Violabitch5/Nathophone_elec/joyned_xmos_xe216-main/README.md

This is a hardware reference design for a fully compliant Milan endpoint. It converts from a AVB/Milan network to I2S or TDM and vice versa.
Please feel free to copy and modify for your individual needs. This hardware reference design is published under the Creative Commons License. For software licensing visit www.joyned.at
