Violabitch5/Nathophone_elec/USBtoI2S_board/T-I4W1069446A-1units-BOM_nathophone_USBtoI2S_compatkicad9.kicad_pcb(2026-07-01).xls

PCBWay Bom Quotation, Product No.:T-I4W1069446A
Item # | *Designator | *Qty | Manufacturer | *Mfg Part # | Description / Value | Vendor Part # | *Package/Footprint | Mounting Type | *Unit Price(1 unit) | *Total | *Delivery Time | *PCBWay Note | Customer Reply | PCBWay Update
1 | C1, C10, C11, C12, C13, C18, C19, C2, C20, C21, C22, C23, C24, C25, C26, C27, C28, C29, C3, C30, C31, C32, C33, C35, C36, C41, C5, C8, C9 | 29 |  | GRMJN65C1H104JE01D | 100n『 』Unpolarized capacitor, small symbol『 』C0G/NP0『 』50V | 490-GRMJN65C1H104JE01DCT-ND | CAPC1810X65N | smt | $0.433 | $12.557 | 7-10 Workdays
2 | C14 | 1 |  | C0603C220J5GACTU | 22p『 』Unpolarized capacitor, small symbol『 』C0G/NP0『 』50V | 399-C0603C220J5GACTUCT-ND | C_0603_1608Metric_Pad1.08x0.95mm_HandSolder | smt | $0.662 | $0.662
3 | C15, C16 | 2 |  | CL32B226MOJNNNE | 22u『 』Unpolarized capacitor, small symbol『 』X7R『 』16V | 1276-3395-1-ND | C_1210_3225Metric_Pad1.33x2.70mm_HandSolder | smt | $2.033 | $4.066
4 | C17, C42, C43 | 3 |  | C3225X7R1N106K250AC | 10u『 』Unpolarized capacitor, small symbol『 』X7R『 』75V『 』SMD_2terminal_chip_molded | 445-C3225X7R1N106K250ACCT-ND | C_1210_3225Metric_Pad1.33x2.70mm_HandSolder | smt | $3.728 | $11.184
5 | C34 | 1 |  | C1608X7R2A105K080AC | 1u『 』Unpolarized capacitor, small symbol『 』X7R『 』100V | 445-C1608X7R2A105K080ACCT-ND | C_0603_1608Metric | smt | $2.426 | $2.426
6 | C37, C38, C39, C4 | 4 |  | GRM2195C1H103JA01D | 10n『 』Unpolarized capacitor, small symbol『 』C0G/NP0『 』50V | 490-1642-1-ND | C_0805_2012Metric_Pad1.18x1.45mm_HandSolder | smt | $0.479 | $1.916
7 | C40 | 1 |  | C2012X7R1C225K125AB | 2.2u『 』Unpolarized capacitor, small symbol『 』X7R『 』16V | 445-1420-1-ND | C_0805_2012Metric_Pad1.18x1.45mm_HandSolder | smt | $1.544 | $1.544
8 | C6, C7 | 2 |  | C0603C180C5GACTU | 18p『 』Unpolarized capacitor, small symbol『 』C0G/NP0『 』50V | 399-C0603C180C5GACTUCT-ND | C_0603_1608Metric | smt | $4.821 | $9.642 | 7-10 Workdays
9 | CR1 | 1 | onsemi(安森美) | NUP4114UCLW1T2G | NUP4114UCLW1T2G | NUP4114UCLW1T2GOSCT-ND | SOT-363_SC-70-6 | smt | $1.871 | $1.871 | 7-10 Workdays
10 | D1 | 1 |  | DF2B6M4BSL,L3F | 5.6V『 』Bidirectional transient-voltage-suppression diode, small symbol | 264-DF2B6M4BSL,L3FCT-ND | SOD-962_SL2_TOS | smt | $1.187 | $1.187 | 7-10 Workdays
11 | D2 | 1 |  | XZMDKVG55W-8 | XZMDKVG55W-8『 』Dual LED, cathodes on pins 2 and 4 | 1497-1183-1-ND | LED_XZMDKVG55W-8 | smt | $1.187 | $1.187
12 | FB1 | 1 |  | HZ0805E601R-10 | 600R @ 100MHz『 』Ferrite bead, small symbol『 』0.5A | 240-2399-1-ND | C_0805_2012Metric_Pad1.18x1.45mm_HandSolder | smt | $1.437 | $1.437
13 | J1 | 1 | Same Sky | UJ20-C-H-G-SMT-5-P16-TR | UJ20-C-H-G-SMT-5-P16-TR『 』3.41mm『 』AMINA | 2223-UJ20-C-H-G-SMT-5-P16-TRCT-ND | SAMESKY_UJ20-C-H-G-SMT-5-P16-TR | smt | $1.780 | $1.780 | 7-10 Workdays
14 | J2 | 1 |  | FTSH-110-01-F-DV-K | FTSH-110-01-F-DV-K『 』Generic connector, double row, 02x10, odd/even pin numbering scheme (row 1 odd numbers, row 2 even numbers), script generated (kicad-library-utils/schlib/autogen/connector/) | SAM8802-ND | CON20_2X10_DUK_FTSH_SAI-M | smt | $3.876 | $3.876 | 7-10 Workdays
15 | J3 | 1 |  | 0525593072 | Conn_01x30『 』Generic connector, single row, 01x30, script generated (kicad-library-utils/schlib/autogen/connector/) | 900-0525593072TR-ND | CON_525593072_MOL | smt | $4.642 | $4.642 | 7-10 Workdays
16 | J4 | 1 |  | FTSH-105-01-F-DV-P-TR | FTSH-105-01-F-DV-P-TR『 』Generic connector, double row, 02x05, odd/even pin numbering scheme (row 1 odd numbers, row 2 even numbers), script generated (kicad-library-utils/schlib/autogen/connector/) | SAM13161CT-ND | PinHeader_2x05_P1.27mm_Vertical_SMD | smt | $1.771 | $1.771
17 | L1 | 1 |  | B82432T1222K000 | 2.2uH『 』Inductor with ferrite core, small symbol『 』1A | 495-1757-1-ND | IND_EPCOS_B82432T_EPC | smt | $1.240 | $1.240
18 | L2 | 1 |  | B82432T1332K000 | 3.3uH『 』Inductor with ferrite core, small symbol『 』0.9A | 495-1760-1-ND | IND_EPCOS_B82432T_EPC | smt | $1.595 | $1.595 | 7-10 Workdays
19 | Q1 | 1 | ANBON SEMICONDUCTOR (INT'L) LIMITED | MMBT3904 | MMBT3904『 』0.2A Ic, 40V Vce, Small Signal NPN Transistor, SOT-23 | 4530-MMBT3904CT-ND | SOT-23 | smt | $0.314 | $0.314 | 7-10 Workdays
20 | R1, R2 | 2 |  | RNCF0805DTE5K10 | 5.1k『 』Resistor, small symbol『 』0.5% | 738-RNCF0805DTE5K10CT-ND | R_0805_2012Metric_Pad1.20x1.40mm_HandSolder | smt | $0.578 | $1.156
21 | R10 | 1 |  | RC0603DR-071ML | 1M『 』Resistor, small symbol『 』0.5% | 13-RC0603DR-071MLCT-ND | R_0603_1608Metric | smt | $0.441 | $0.441
22 | R11, R9 | 2 |  | RNCF0805DTE4K70 | 4k7『 』Resistor, small symbol『 』0.5% | 738-RNCF0805DTE4K70CT-ND | R_0805_2012Metric_Pad1.20x1.40mm_HandSolder | smt | $0.578 | $1.156
23 | R12, R13, R14, R15, R16, R17 | 6 |  | RC0805FR-0733RL | 33R『 』Resistor, small symbol『 』1% | 311-33.0CRCT-ND | R_0805_2012Metric_Pad1.20x1.40mm_HandSolder | smt | $0.064 | $0.384
24 | R18, R20, R22, R23, R4, R5 | 6 |  | RNCF0805DTE100K | 100k『 』Resistor, small symbol『 』0.5% | 738-RNCF0805DTE100KCT-ND | R_0805_2012Metric_Pad1.20x1.40mm_HandSolder | smt | $0.228 | $1.368
25 | R19, R21 | 2 |  | RNCF0805DTE200K | 200k『 』Resistor, small symbol『 』0.5% | 738-RNCF0805DTE200KCT-ND | R_0805_2012Metric_Pad1.20x1.40mm_HandSolder | smt | $0.578 | $1.156
26 | R24, R25, R26, R3, R7 | 5 |  | RNCF0805DTE10K0 | 10k『 』Resistor, small symbol『 』0.5% | RNCF0805DTE10K0CT-ND | R_0805_2012Metric_Pad1.20x1.40mm_HandSolder | smt | $0.263 | $1.315
27 | R27 | 1 |  | CRCW0805750RFKEA | 750R『 』Resistor, small symbol『 』1% | 541-750CCT-ND | R_0805_2012Metric_Pad1.20x1.40mm_HandSolder | smt | $0.970 | $0.970
28 | R28 | 1 |  | CRCW0805680RFKEA | 680R『 』Resistor, small symbol『 』1% | 541-680CCT-ND | R_0805_2012Metric_Pad1.20x1.40mm_HandSolder | smt | $0.970 | $0.970
29 | R6 | 1 |  | RNCF0805DTE47K0 | 47k『 』Resistor, small symbol『 』0.5% | 738-RNCF0805DTE47K0CT-ND | R_0805_2012Metric_Pad1.20x1.40mm_HandSolder | smt | $1.103 | $1.103
30 | R8 | 1 |  | RT0603DRD07680RL | 680R『 』Resistor, small symbol『 』0.5% | 311-680DCT-ND | R_0603_1608Metric | smt | $1.103 | $1.103
31 | SW1 | 1 |  | PEC09-2320F-S0015 | PEC09-2320F-S0015『 』Rotary encoder, dual channel, incremental quadrate outputs, with switch | PEC09-2320F-S0015-ND | RotaryEncoder_Bourns_Horizontal_PEC09-2xxxF-Sxxxx | tht | $6.190 | $6.190 | 7-10 Workdays
32 | TP1, TP13, TP14, TP15, TP16, TP17, TP18, TP19, TP2, TP20, TP3, TP5, TP6, TP8 | 14 |  |  | TestPoint_Small『 』test point |  | TestPoint_Pad_D1.5mm | tht |  |  |  | [DNP
33 | U1 | 1 |  | IS25LP032D-JKLE-TR | IS25LP032D-JKLE『 』32-Mbit, 2.3 to 3.6V, SPI Flash Memory, SOIC-8 | 706-IS25LP032D-JKLE-TRCT-ND | WSON-8-1EP_6x5mm_P1.27mm_EP3.4x4mm | smt | $2.986 | $2.986 | 7-10 Workdays
34 | U2 | 1 | XMOS | XU316-1024-TQ128-C24 | XU316-1024-TQ128-C24『 』1.2mm『 』ASHISH『 』XU316-1024-TQ128-C24 | 880-XU316-1024-TQ128-C24-ND | QFP40P1600X1600X120-129N | smt | $21.240 | $21.240 | 7-10 Workdays
35 | U3 | 1 |  | TPS62410DRCR | TPS62410DRCR | 296-25488-1-ND | TPS62410DRCR | smt | $2.335 | $2.335
36 | U4 | 1 |  | MAX809STRG | MAX809STRG | MAX809STRGOSCT-ND | SOT-23 | smt | $0.647 | $0.647
37 | U5 | 1 |  | 74LVC2G07GW,125 | 74LVC2G07『 』Dual Buffer, Open Drain, Low-Voltage CMOS | 1727-4121-1-ND | SOT-363_SC-70-6 | smt | $1.000 | $1.000
38 | U6 | 1 | Diodes Inc. | AP7361C-FGE-7 | AP7361C-FGE-7『 』0.63 mm | AP7361C-FGE-7DICT-ND | SON65P300X300X63-9N | smt | $2.302 | $2.302
39 | Y1 | 1 |  | FA-238 24.0000MB-C3 | FA-238 24MHz『 』Four pin crystal, GND on pins 2 and 4, small symbol | SER3689CT-ND | Crystal_SMD_3225-4Pin_3.2x2.5mm | smt | $3.281 | $3.281 | 7-10 Workdays
 |  |  |  |  |  |  |  |  | Component Cost | $116.00
 |  |  |  |  |  |  |  |  | Assembly Cost | $29.00
 |  |  |  |  |  |  |  |  | PCB Cost | $55.93
 |  |  |  |  |  |  |  |  | V0 Member 0% off | $0.00
 |  |  |  |  |  |  |  |  | All Total 1 Units | $200.93
