Violabitch5/Nathophone_elec/joyned_xmos_xe216-main/xmos_avb_brd_V4.step

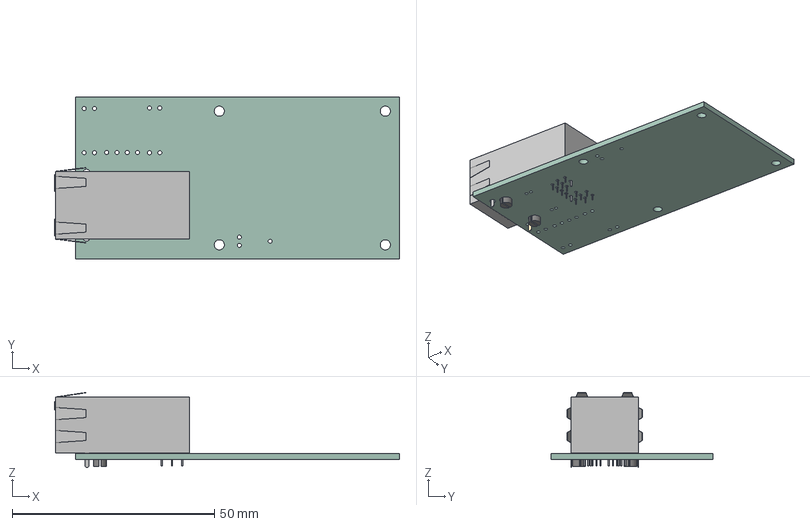
[picture p1: CAD file, 2025-10-16]
joyned_xmos_xe216-main/xmos_avb_brd_V4.step
85.2 x 40.0 x 18.5 mm
RJ45_Pulse_JK0654219NL_Horizontal
xmos_avb_brd_V4_PCB
