Violabitch5/Nathophone_elec/pcb/symbols_footprints/TE_1-1571986-1-a-3d.stp

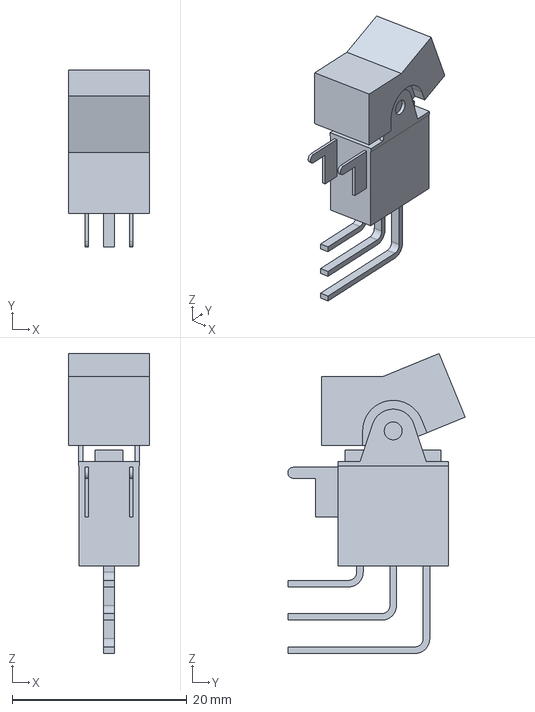
[picture p2: CAD file, 2025-10-16]
pcb/symbols_footprints/TE_1-1571986-1-a-3d.stp
9.27 x 20.3 x 34.4 mm
