Violabitch5/Nathophone_elec/USBtoI2S_board/nathophone_USBtoI2S/USBtoI22_Module_v1.step

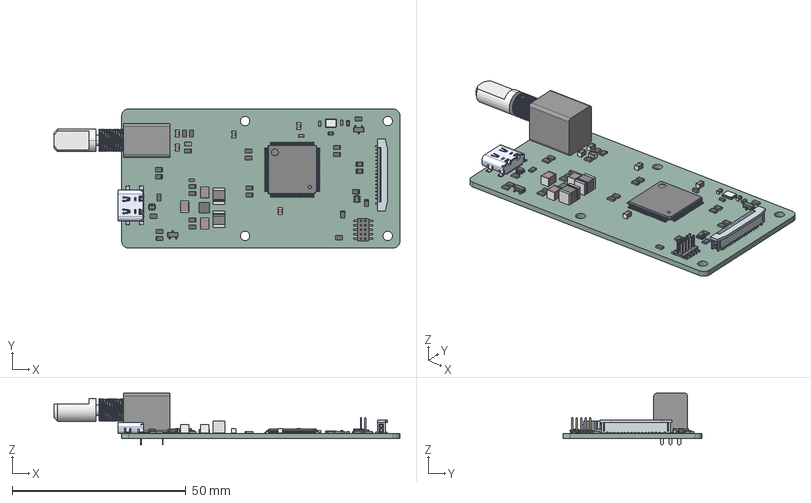
[picture p3: CAD file, 2026-10-13]
USBtoI2S_board/nathophone_USBtoI2S/USBtoI22_Module_v1.step
99.4 x 40.0 x 14.9 mm
C_0805_2012Metric x 6
R_0805_2012Metric x 26
C_0603_1608Metric x 4
UJ20-C-H-G-SMT-5-P16-TR
SOT-23 x 2
PinHeader_2x05_P1.27mm_Vertical_SMD
C_1210_3225Metric x 3
SOT-363_SC-70-6 x 2
IND_EPCOS_B82432T_EPC x 2
Crystal_SMD_3225-4Pin_3.2x2.5mm
PEC09-2320F-S0015
BODY-SON
R_0603_1608Metric x 2
XU316-1024-TQ128-C24
nathophone_USBtoI2S_PCB
