Violabitch5/Nathophone_elec/USBtoI2S_board/parts/SOT89-5_DIO.step

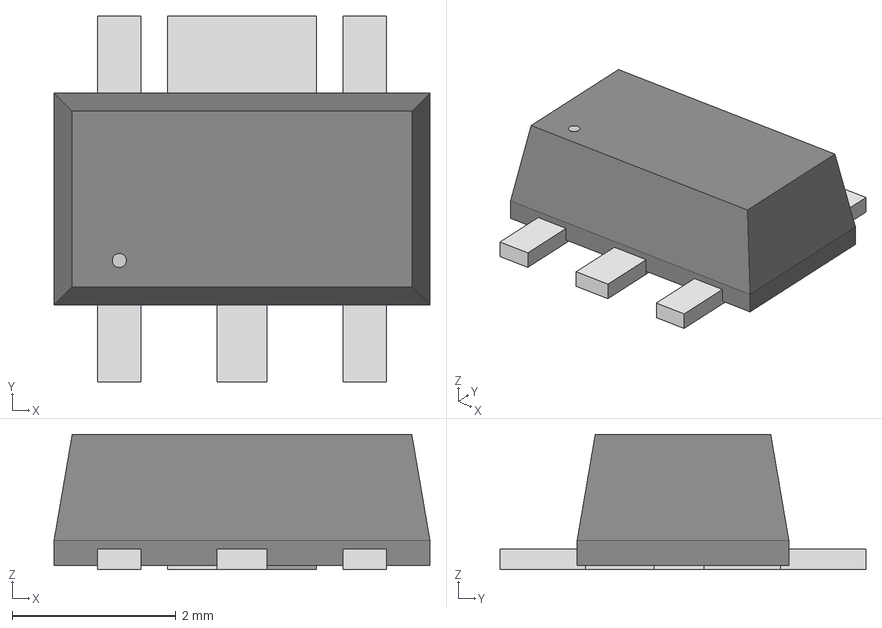
[picture p4: CAD file, 2026-10-13]
USBtoI2S_board/parts/SOT89-5_DIO.step
4.60 x 4.47 x 1.65 mm
