Violabitch5/Nathophone_elec/pcb/symbols_footprints/SRU1048-150Y.STEP

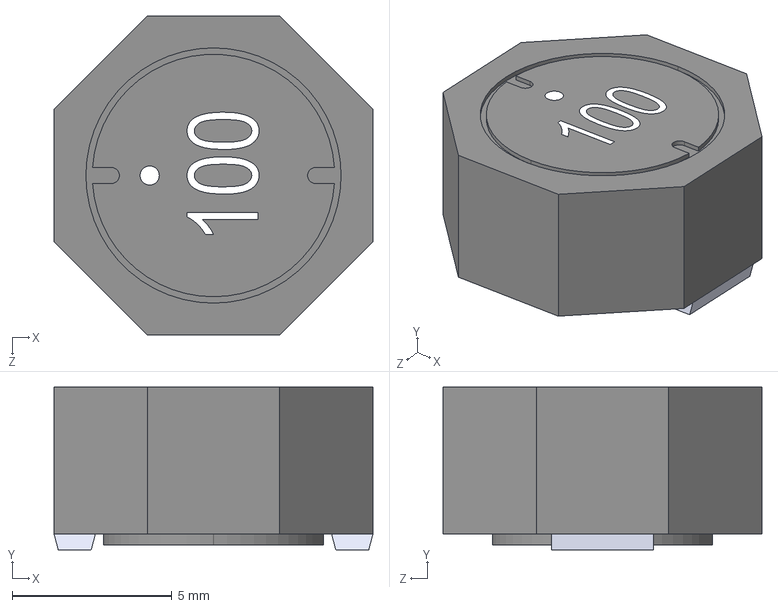
[picture p5: CAD file, 2025-10-16]
pcb/symbols_footprints/SRU1048-150Y.STEP
10.0 x 5.10 x 10.0 mm
