Violabitch5/Nathophone_elec/USBtoI2S_board/parts/ftsh-110-01-f-dv-k.stp

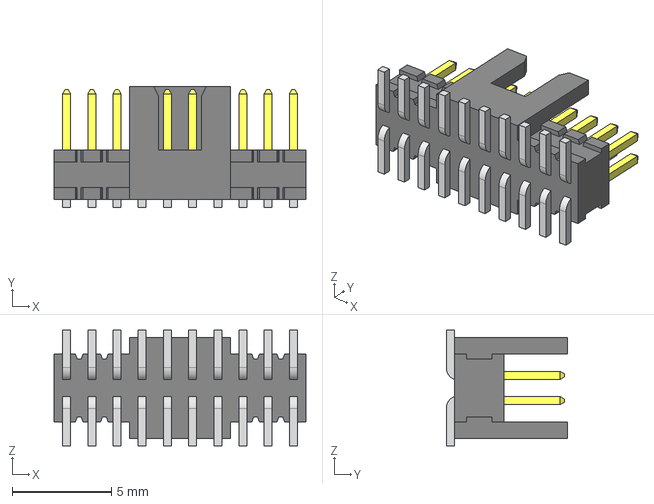
[picture p6: CAD file, 2026-10-13]
USBtoI2S_board/parts/ftsh-110-01-f-dv-k.stp
12.7 x 6.12 x 5.84 mm
