Violabitch5/Nathophone_elec/pcb/symbols_footprints/WE-HCI_1050_744325+%28rev1%29.stp

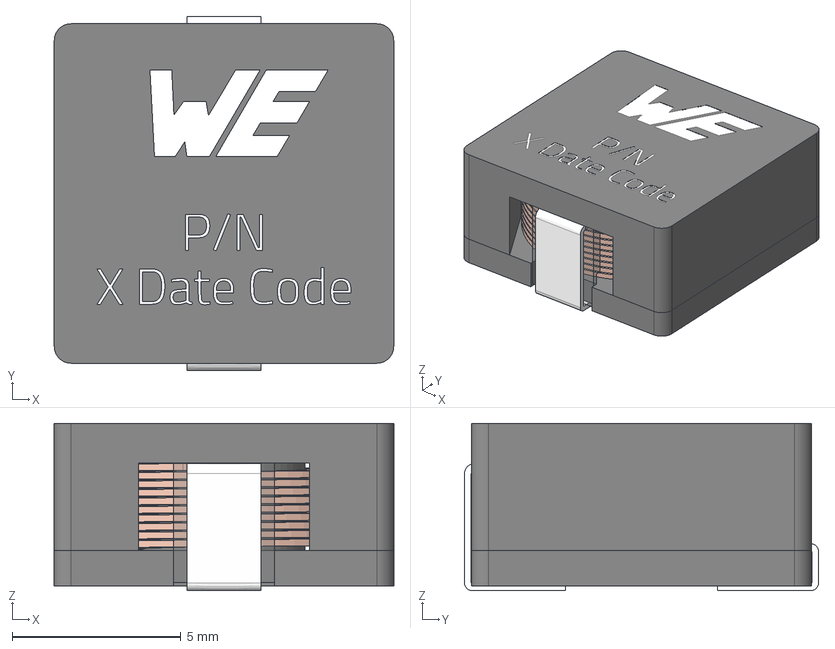
[picture p7: CAD file, 2025-10-16]
pcb/symbols_footprints/WE-HCI_1050_744325+%28rev1%29.stp
10.1 x 10.5 x 4.96 mm
Gehäuse
Spule
Boden
Klebemasse x 2
