Violabitch5/Nathophone_elec/USBtoI2S_board/parts/XZxxxx55W-8.step

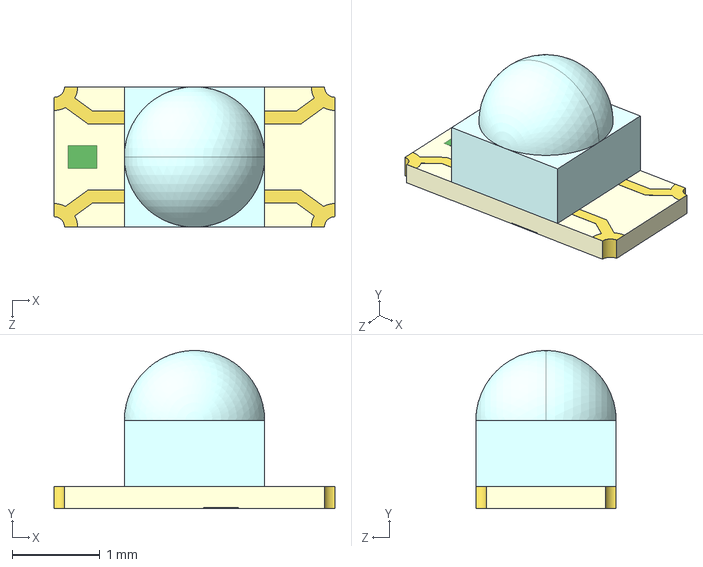
[picture p8: CAD file, 2026-05-14]
USBtoI2S_board/parts/XZxxxx55W-8.step
3.20 x 1.80 x 1.60 mm
