Violabitch5/Nathophone_elec/pcb/symbols_footprints/WE-LQS-4025.stp

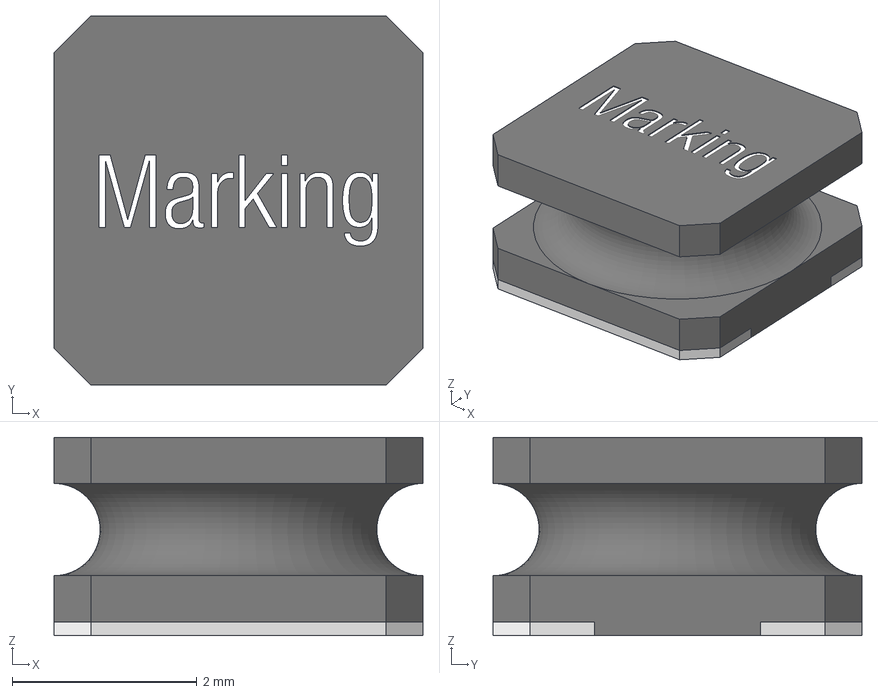
[picture p9: CAD file, 2025-10-16]
pcb/symbols_footprints/WE-LQS-4025.stp
4.00 x 4.00 x 2.15 mm
Core
Contact x 2
Glue
