Violabitch5/Nathophone_elec/pcb/symbols_footprints/DS04-254-2-01BK-SMT.STEP

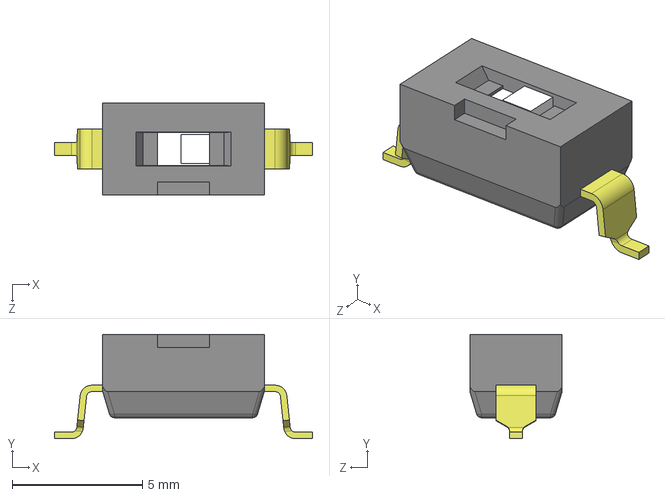
[picture p10: CAD file, 2025-10-16]
pcb/symbols_footprints/DS04-254-2-01BK-SMT.STEP
9.90 x 4.00 x 3.54 mm
