Violabitch5/Nathophone_elec/pcb/symbols_footprints/PTS645SM43SMTR92 LFS.STEP

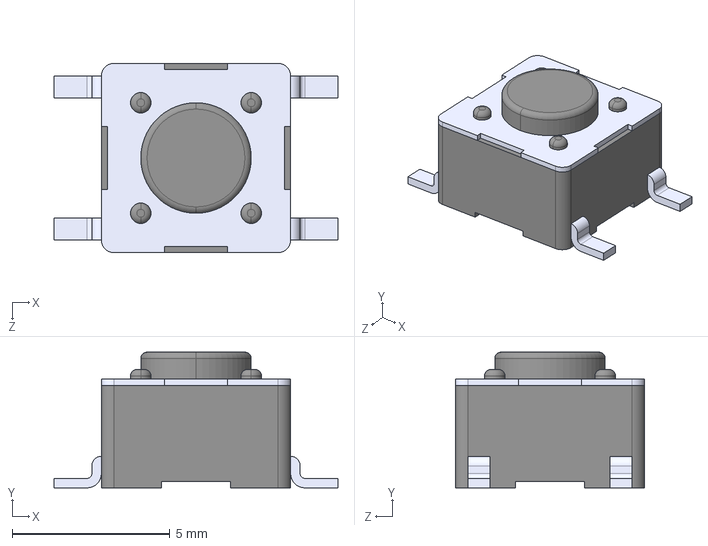
[picture p11: CAD file, 2025-10-16]
pcb/symbols_footprints/PTS645SM43SMTR92 LFS.STEP
9.00 x 4.30 x 6.00 mm
