Violabitch5/Nathophone_elec/USBtoI2S_board/parts/PEC09-2320F-S0015.stp

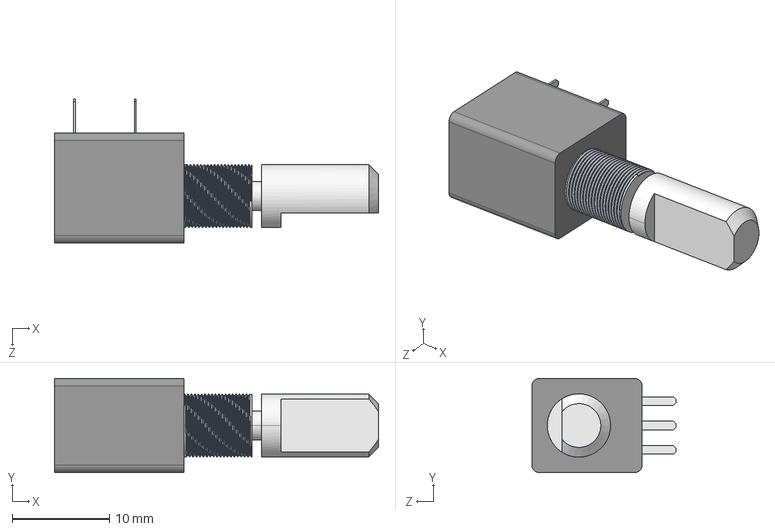
[picture p12: CAD file, 2026-05-14]
USBtoI2S_board/parts/PEC09-2320F-S0015.stp
33.3 x 9.70 x 14.9 mm
