Violabitch5/Nathophone_elec/pcb/symbols_footprints/VQFN32_RSM0032B.stp

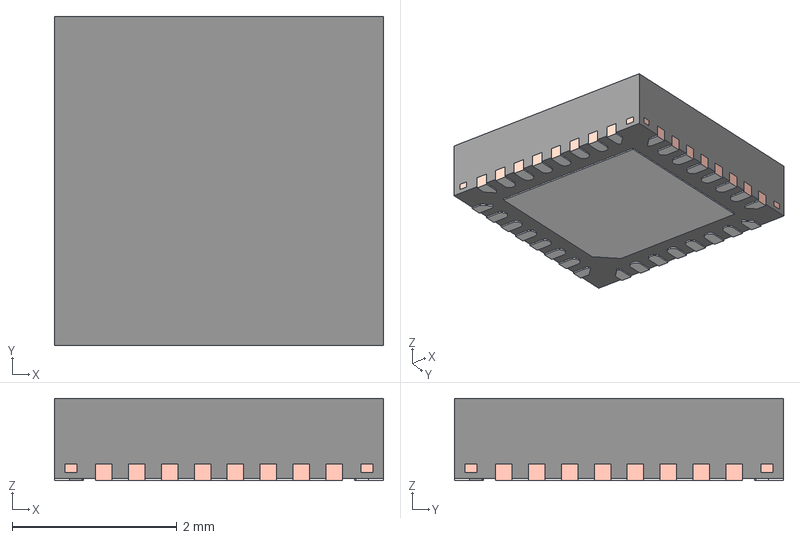
[picture p13: CAD file, 2025-10-12]
pcb/symbols_footprints/VQFN32_RSM0032B.stp
4.00 x 4.00 x 1.00 mm
BODY-QFN
FRAME-RSM0032B
PIN1-ID
