Violabitch5/Nathophone_elec/USBtoI2S_board/parts/IND_EPCOS_B82432T_EPC.step

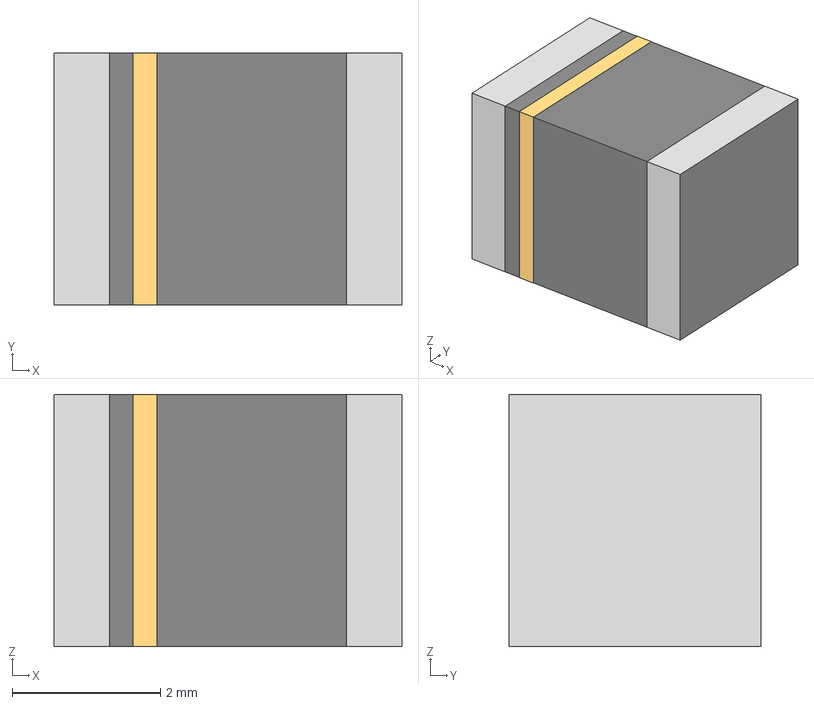
[picture p14: CAD file, 2026-05-14]
USBtoI2S_board/parts/IND_EPCOS_B82432T_EPC.step
4.70 x 3.41 x 3.41 mm
