Violabitch5/Nathophone_elec/USBtoI2S_board/parts/CON20_2X10_DUK_FTSH_SAI.step

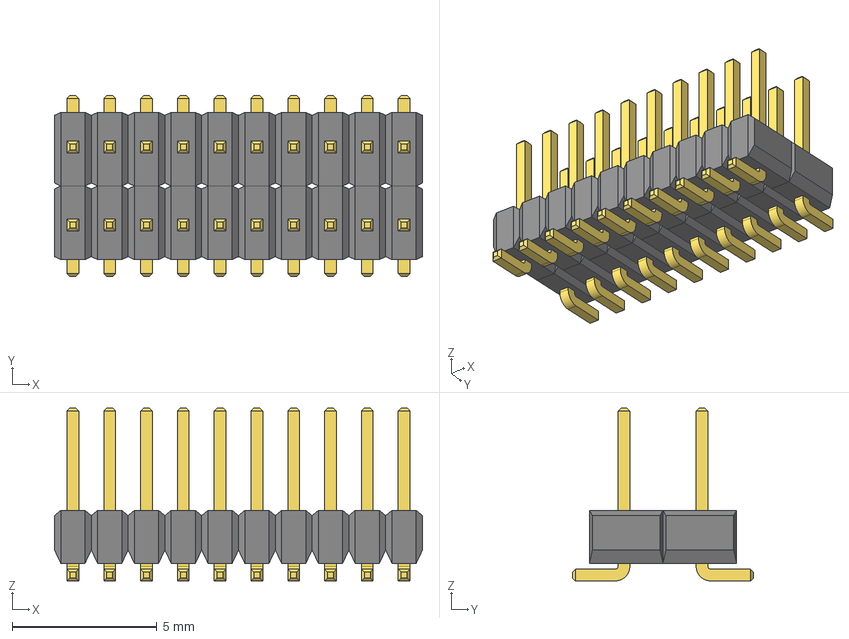
[picture p15: CAD file, 2026-05-07]
USBtoI2S_board/parts/CON20_2X10_DUK_FTSH_SAI.step
12.7 x 6.25 x 5.97 mm
