Violabitch5/Nathophone_elec/pcb/symbols_footprints/TLA2024IRUGR.step

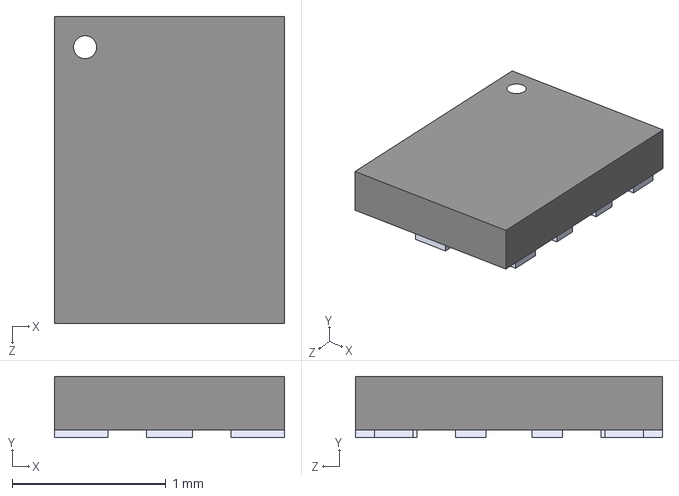
[picture p16: CAD file, 2025-10-12]
pcb/symbols_footprints/TLA2024IRUGR.step
1.50 x 0.4 x 2.00 mm
