Violabitch5/Nathophone_elec/USBtoI2S_board/parts/UJ20-C-H-G-SMT-5-P16-TR.step

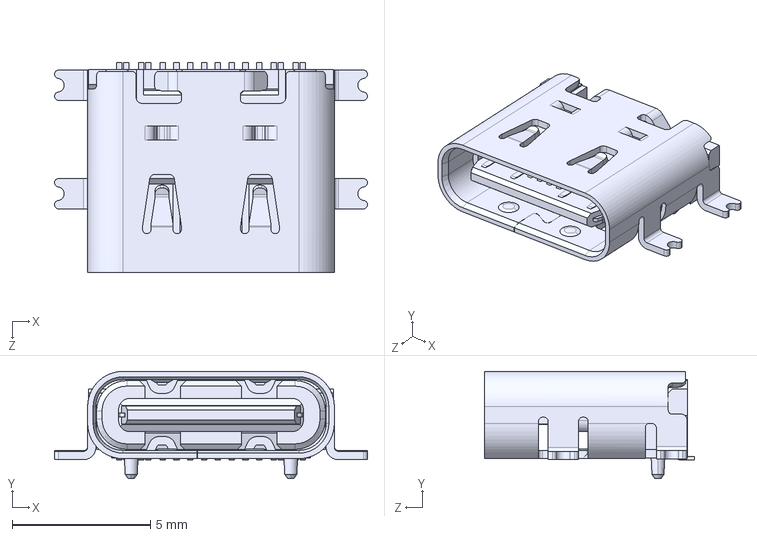
[picture p17: CAD file, 2026-05-07]
USBtoI2S_board/parts/UJ20-C-H-G-SMT-5-P16-TR.step
11.3 x 3.89 x 7.60 mm
