Violabitch5/Nathophone_elec/pcb/symbols_footprints/PJ-063AH.step

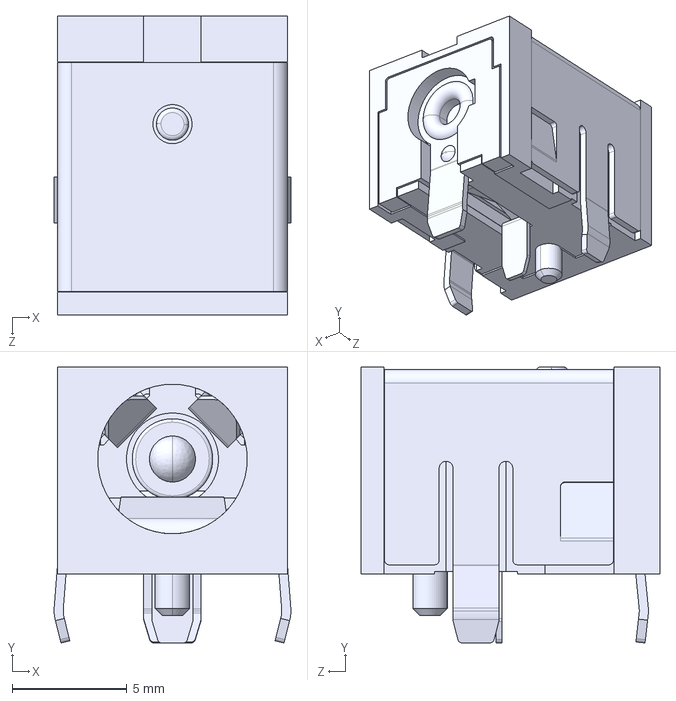
[picture p18: CAD file, 2025-10-12]
pcb/symbols_footprints/PJ-063AH.step
10.3 x 12.0 x 13.0 mm
