Violabitch5/Nathophone_elec/USBtoI2S_board/parts/GRMJN65C1H104JE01D.step

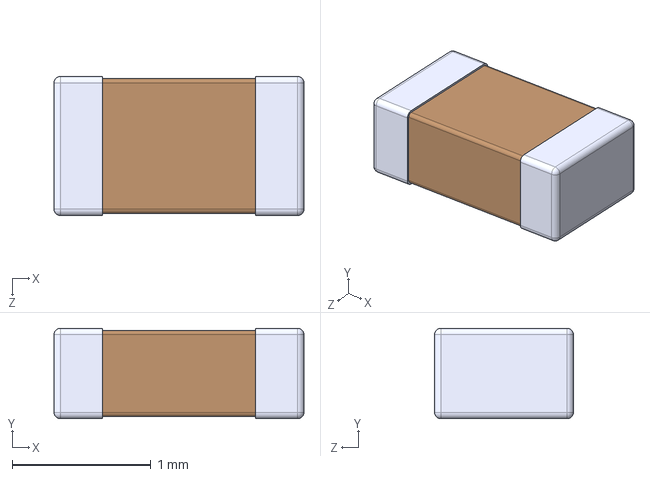
[picture p19: CAD file, 2026-05-07]
USBtoI2S_board/parts/GRMJN65C1H104JE01D.step
1.80 x 0.65 x 1 mm
