Violabitch5/Nathophone_elec/pcb/symbols_footprints/WE-LQS-8065.stp

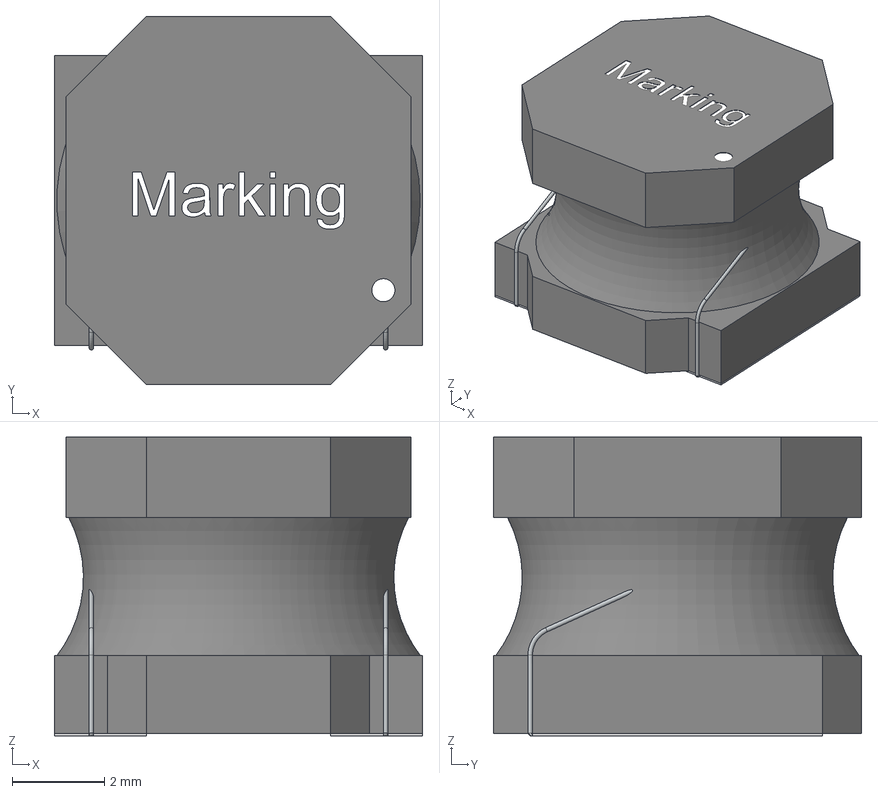
[picture p20: CAD file, 2025-10-12]
pcb/symbols_footprints/WE-LQS-8065.stp
8.00 x 8.00 x 6.50 mm
Housing
Glue
Contact x 2
Wire x 2
