Violabitch5/Nathophone_elec/(list of files, cad)

Other CAD files:
USBtoI2S_board/parts/525593072.stp
USBtoI2S_board/parts/TPS62410DRCR.stp
USBtoI2S_board/parts/TPS65261RHBR.stp
pcb/symbols_footprints/1862042.stp
