Violabitch5/Nathophone_elec/measurements/supplies5p3V_3p3V_startup_PG.png

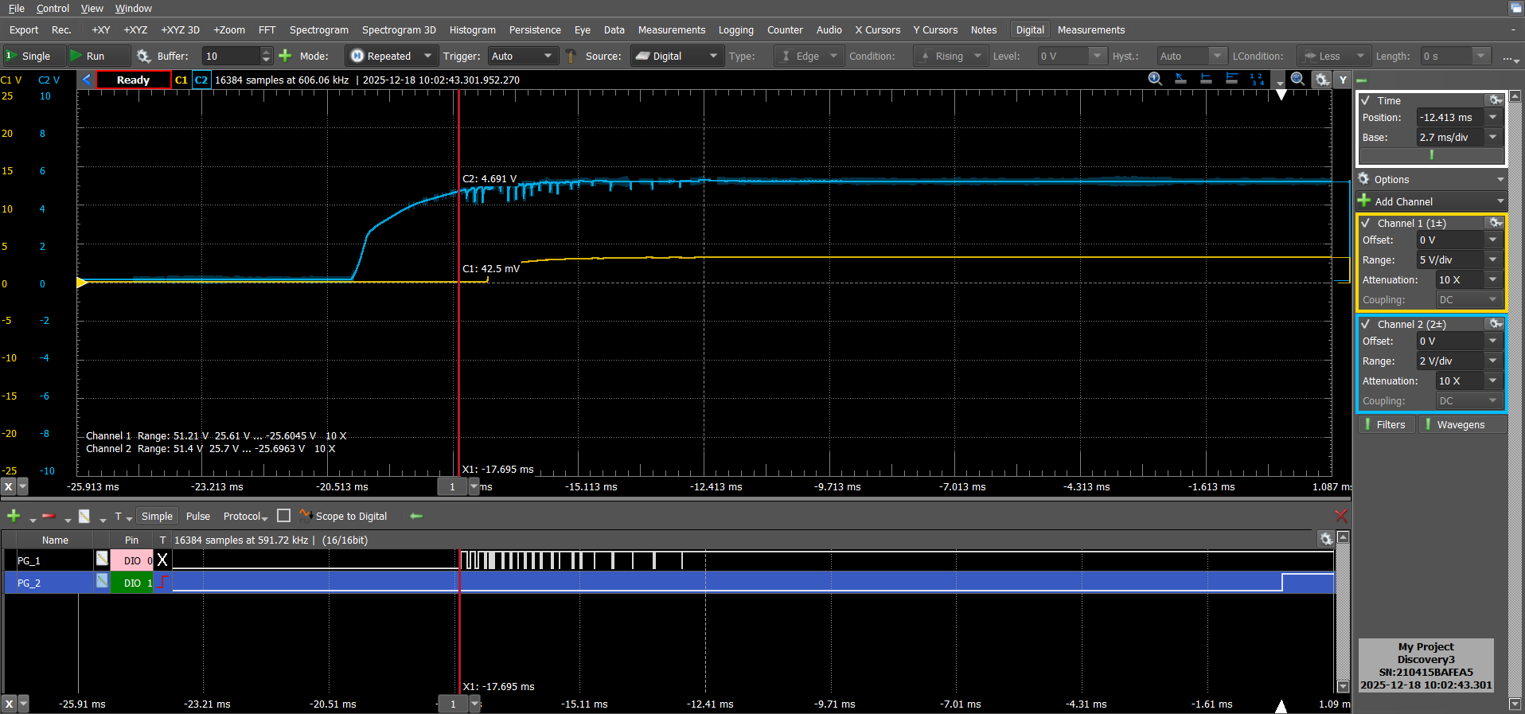
measurements/supplies5p3V_3p3V_startup_PG.png
