Violabitch5/Nathophone_elec/measurements/supplies24V_5p3V_startup_PG_Labornetzteil.png

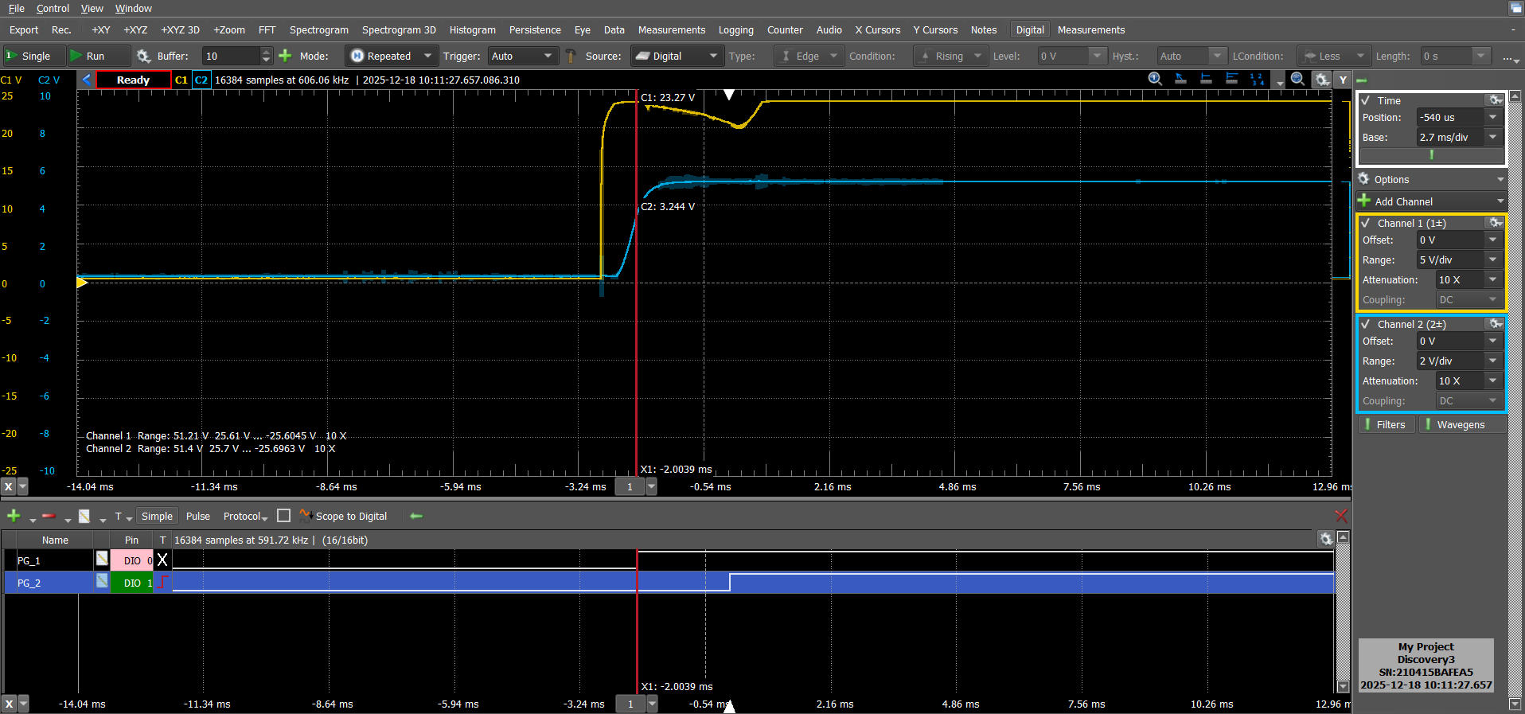
measurements/supplies24V_5p3V_startup_PG_Labornetzteil.png
