Violabitch5/Nathophone_elec/measurements/supplies_startup_PG.png

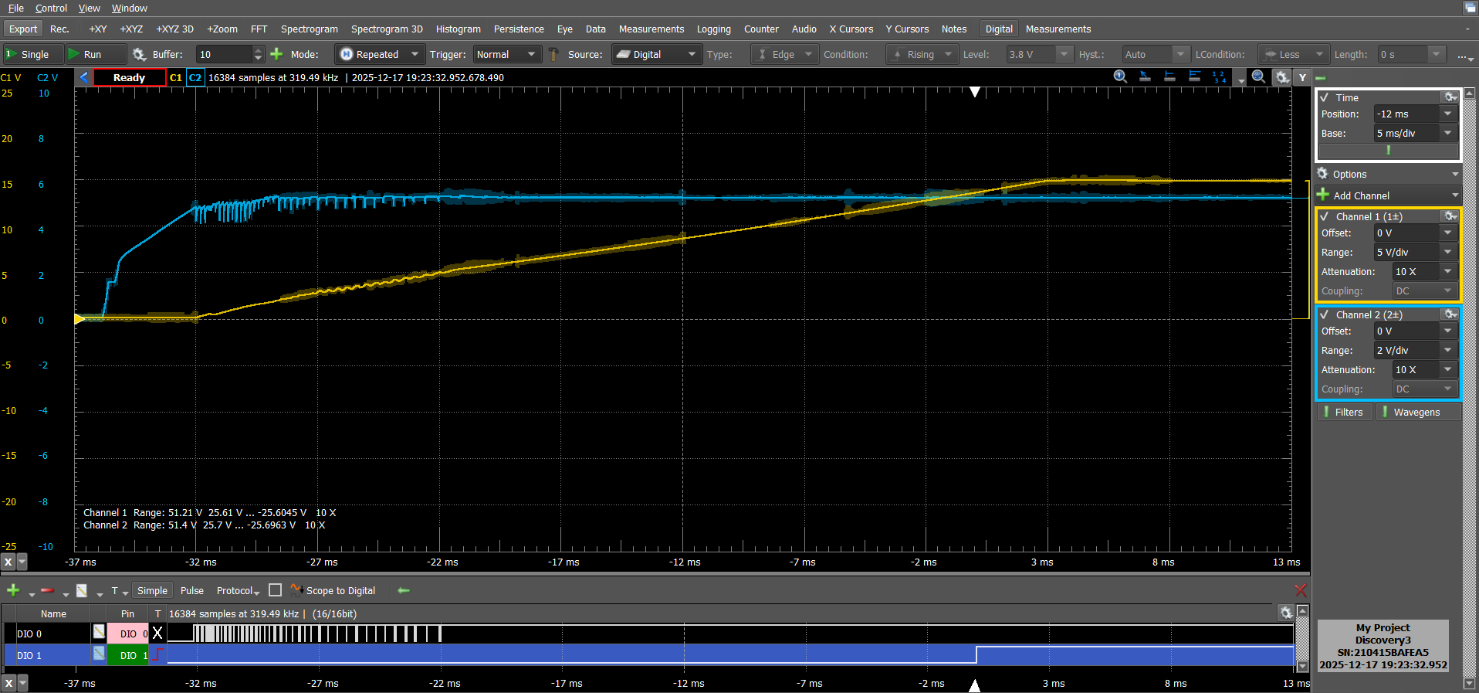
measurements/supplies_startup_PG.png
