Violabitch5/Nathophone_elec/pcb/Nathophone_driver_board_SCHEMATIC.pdf

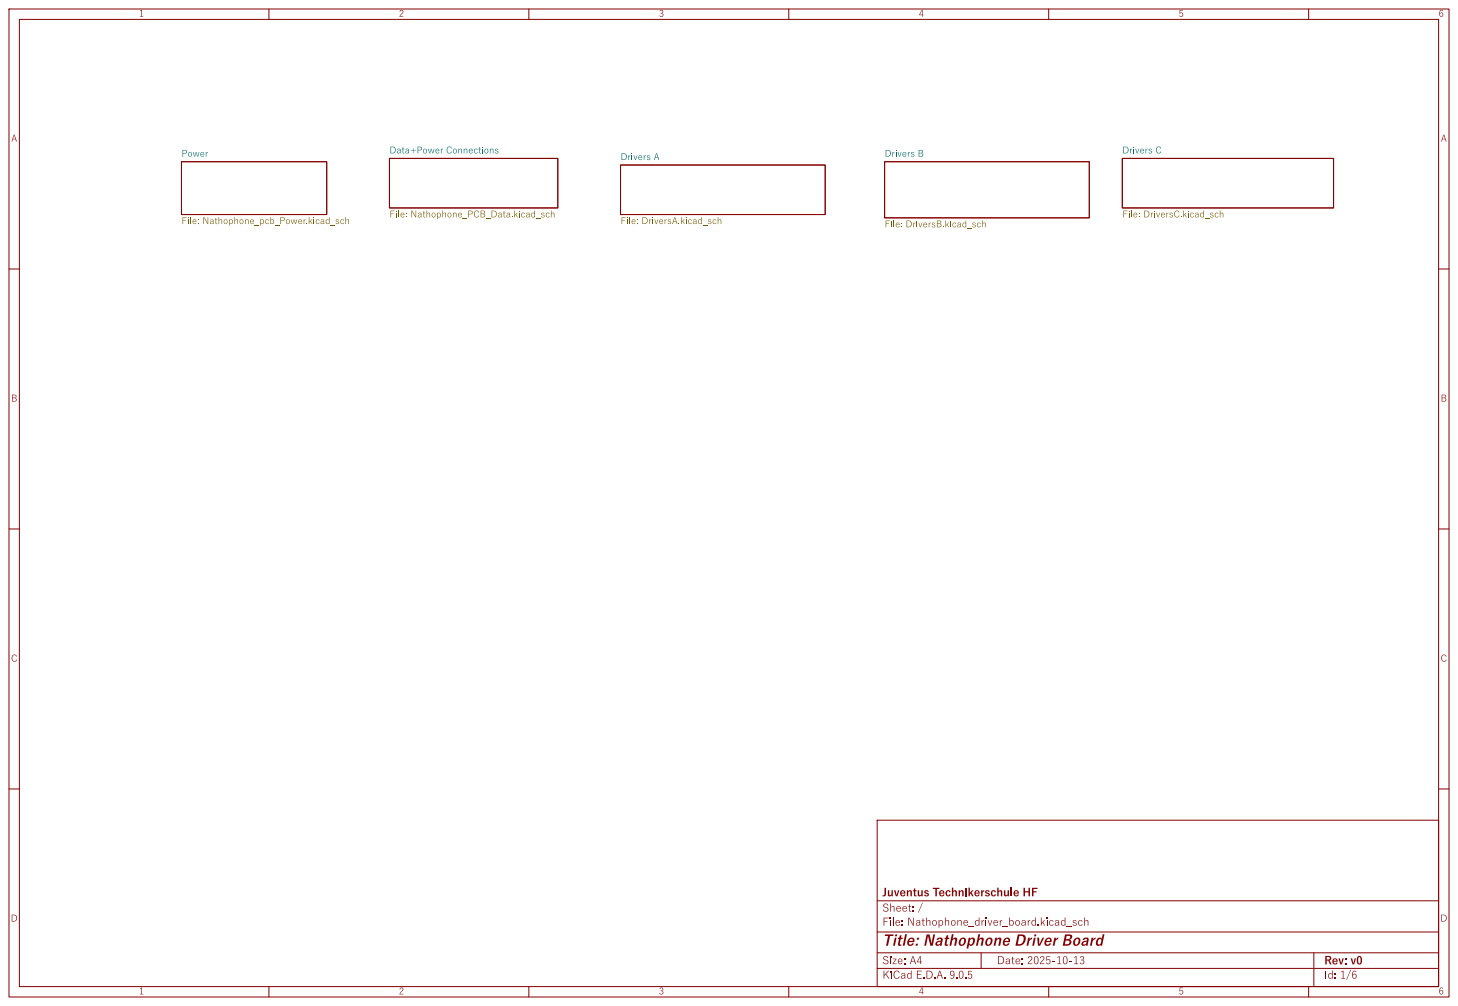
[picture p24: page 1]

File: Nathophone_driver_board.kicad_sch Sheet: / Juventus Technikerschule HF

Id: 1/6 Title: Nathophone Driver Board

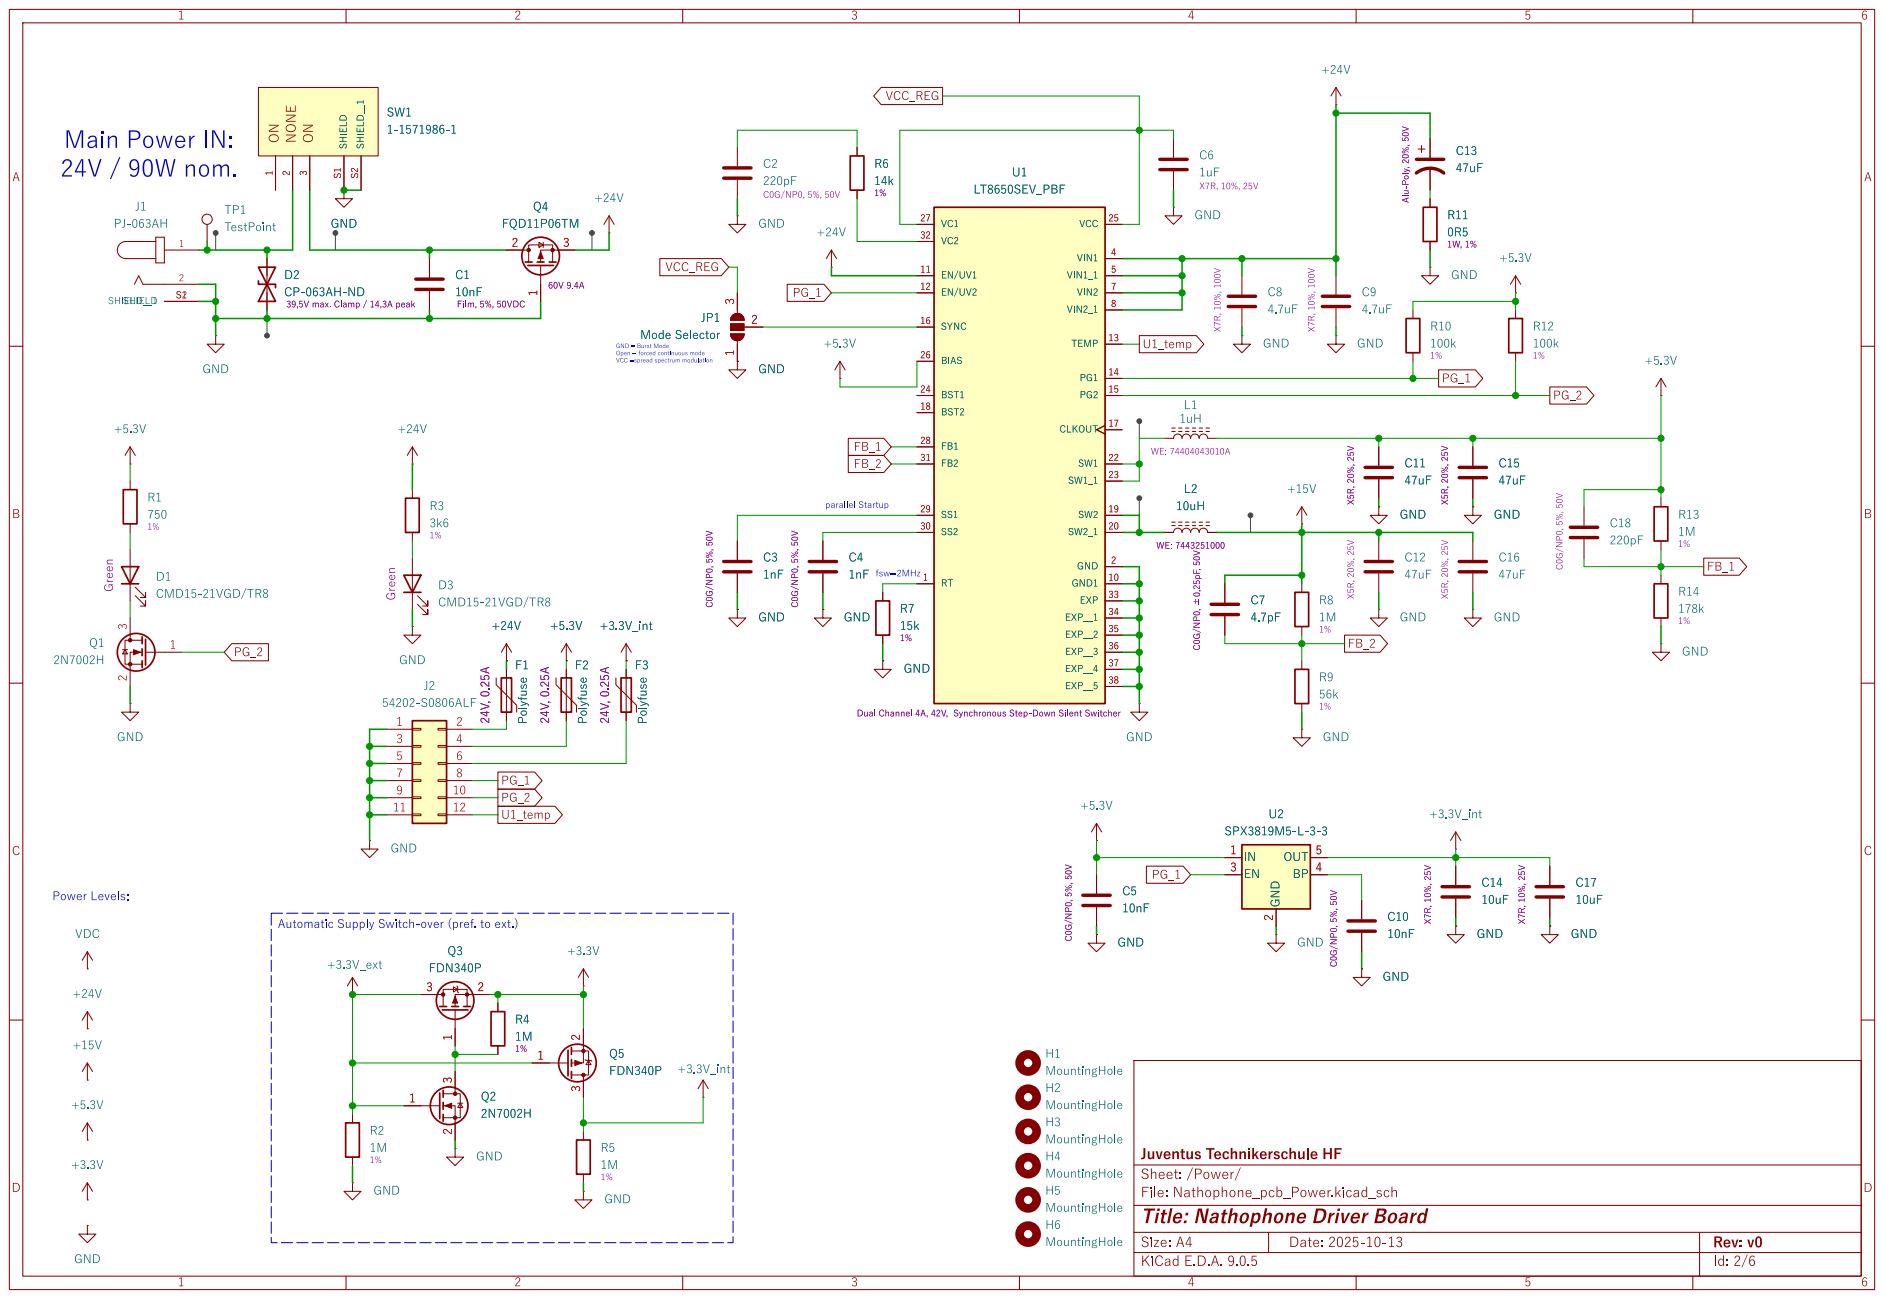
[picture p25: page 2]

fsw=2MHz parallel Startup Main Power IN:
24V / 90W nom.

39,5V max. Clamp / 14,3A peak D1 CMD15-21VGD/TR8 Green

Dual Channel 4A, 42V, Synchronous Step-Down Silent Switcher GND

Dual Channel 4A, 42V, Synchronous Step-Down Silent Switcher

H1 MountingHole H2 MountingHole H3 MountingHole H6 MountingHole H5 MountingHole H4 MountingHole

Id: 2/6 Title: Nathophone Driver Board

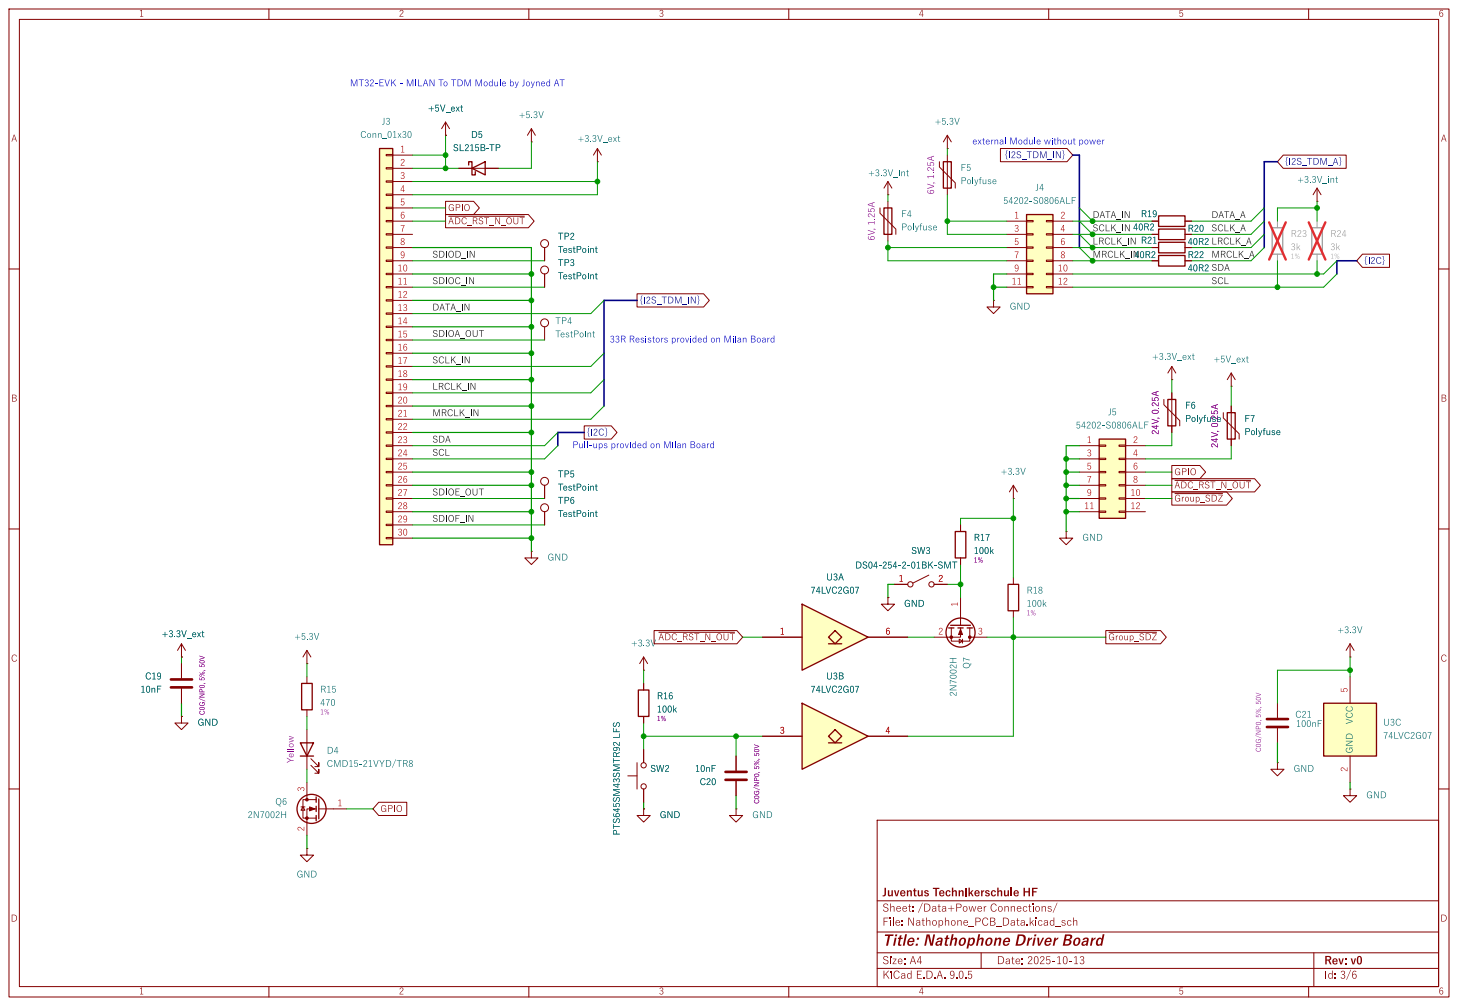
[picture p26: page 3]

external Module without power MT32-EVK - MILAN To TDM Module by Joyned AT

33R Resistors provided on Milan Board +5V_ext D5 SL215B-TP

File: Nathophone_PCB_Data.kicad_sch Sheet: /Data+Power Connections/ Juventus Technikerschule HF

Id: 3/6 Title: Nathophone Driver Board

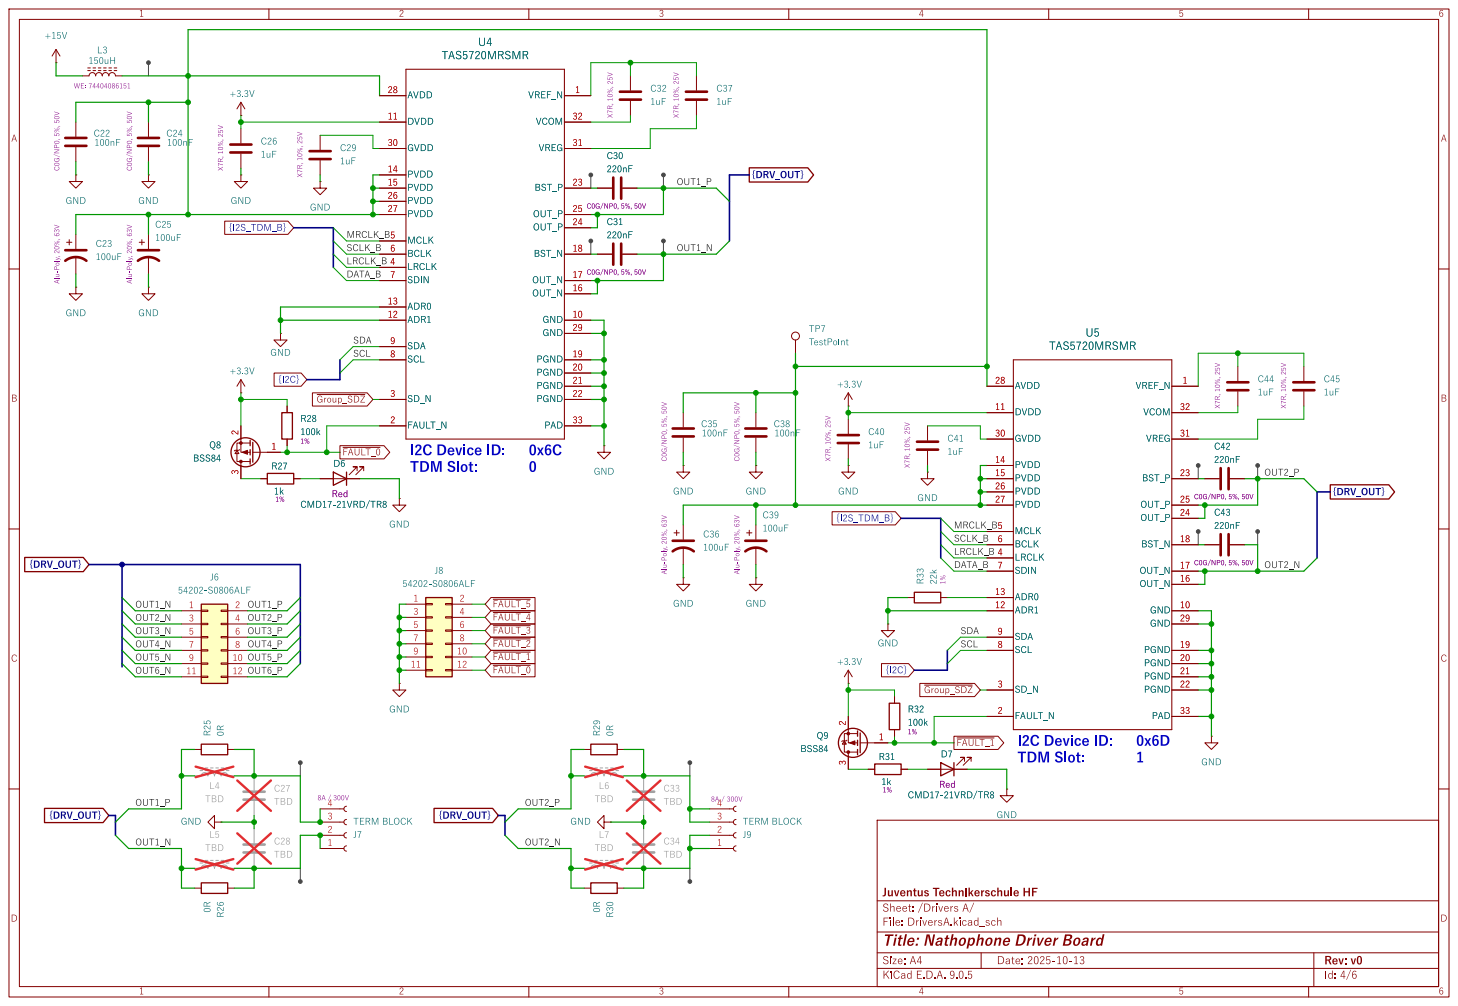
[picture p27: page 4]

AVDD 28 DVDD 11 GVDD 30 PVDD 14 PVDD 15 PVDD 26 PVDD 27 MCLK 5 BCLK 6

File: DriversA.kicad_sch Sheet: /Drivers A/ Juventus Technikerschule HF

Id: 4/6 Title: Nathophone Driver Board

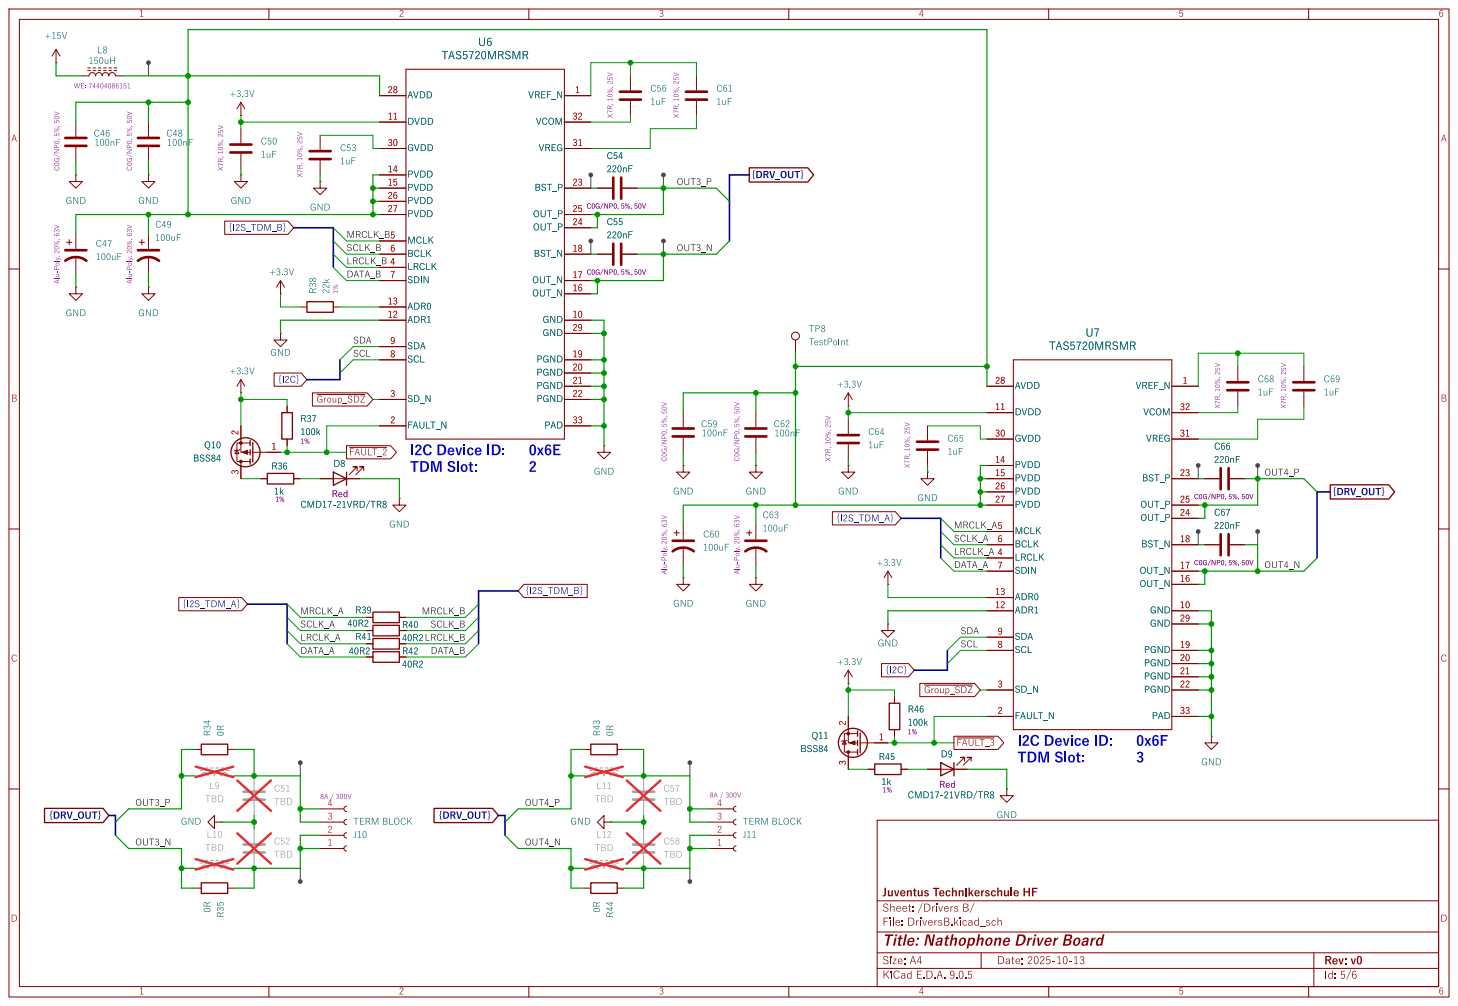
[picture p28: page 5]
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

Id: 5/6 Title: Nathophone Driver Board

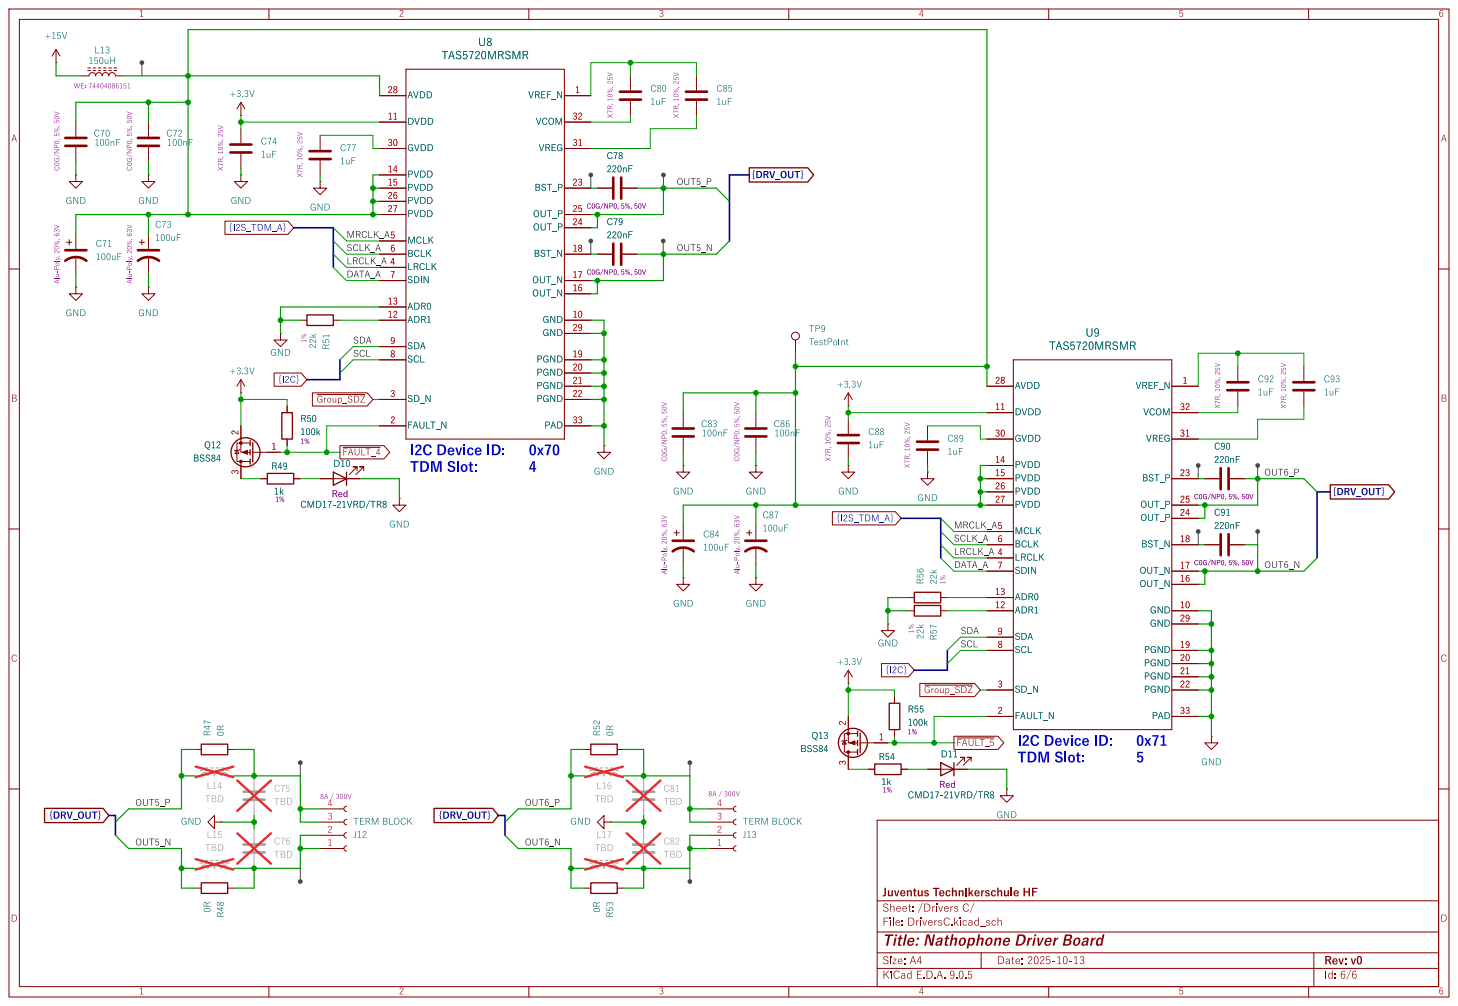
[picture p29: page 6]
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

Id: 6/6 Title: Nathophone Driver Board
