Violabitch5/Nathophone_elec/simulations/test.pdf

## 0uH Induktivität Kapazität-Sweep von 0uF bis 400uF

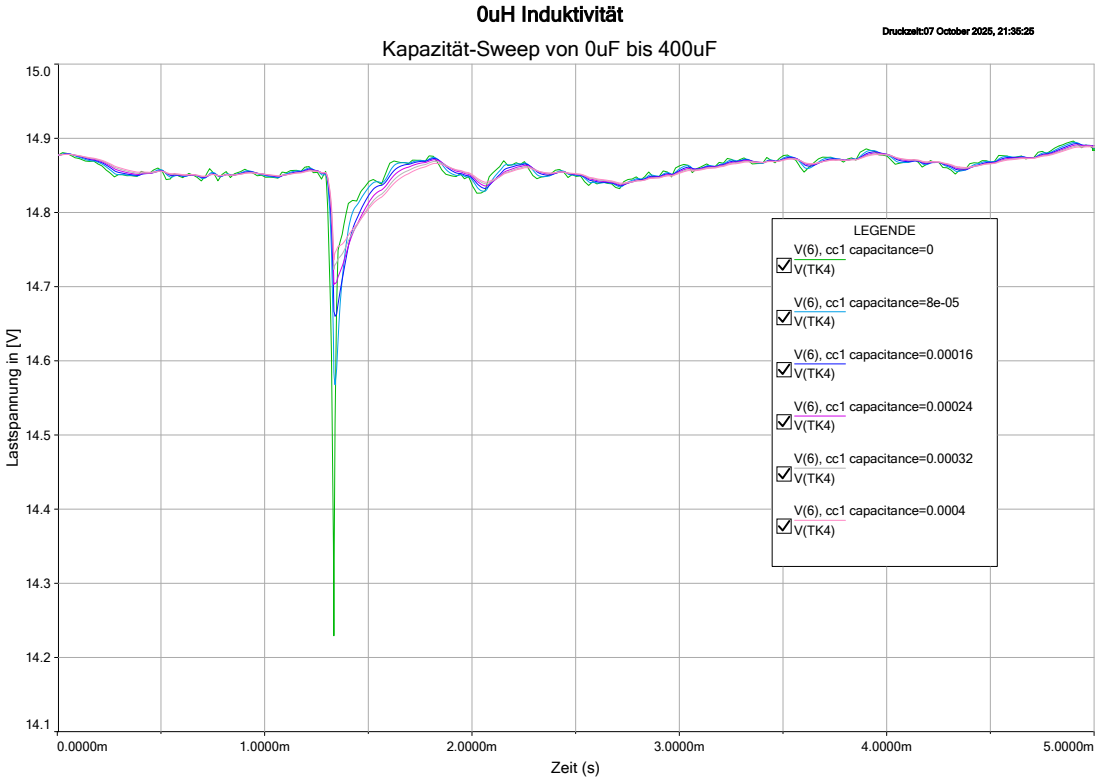
[picture p30: page 1]
Druckzeit:07 October 2025, 21:35:25; Zeit (s)

LEGENDE V(6), cc1 capacitance=0 V(TK4)

V(6), cc1 capacitance=8e-05 V(TK4) V(6), cc1 capacitance=0.00016

0.0000m | 1.0000m | 2.0000m | 3.0000m | 4.0000m V(6), cc1 capacitance=0.00032 V(TK4) V(6), cc1 capacitance=0.0004 | 5.0000m Lastspannung in [V]

V(TK4) V(6), cc1 capacitance=0.00024 V(TK4)
