Violabitch5/Nathophone_elec/USBtoI2S_board/XK-AUDIO-316-MC-AB-Design-Files/XK-AUDIO-316-MC-AB-SCHEMATIC-1V1-A.PDF

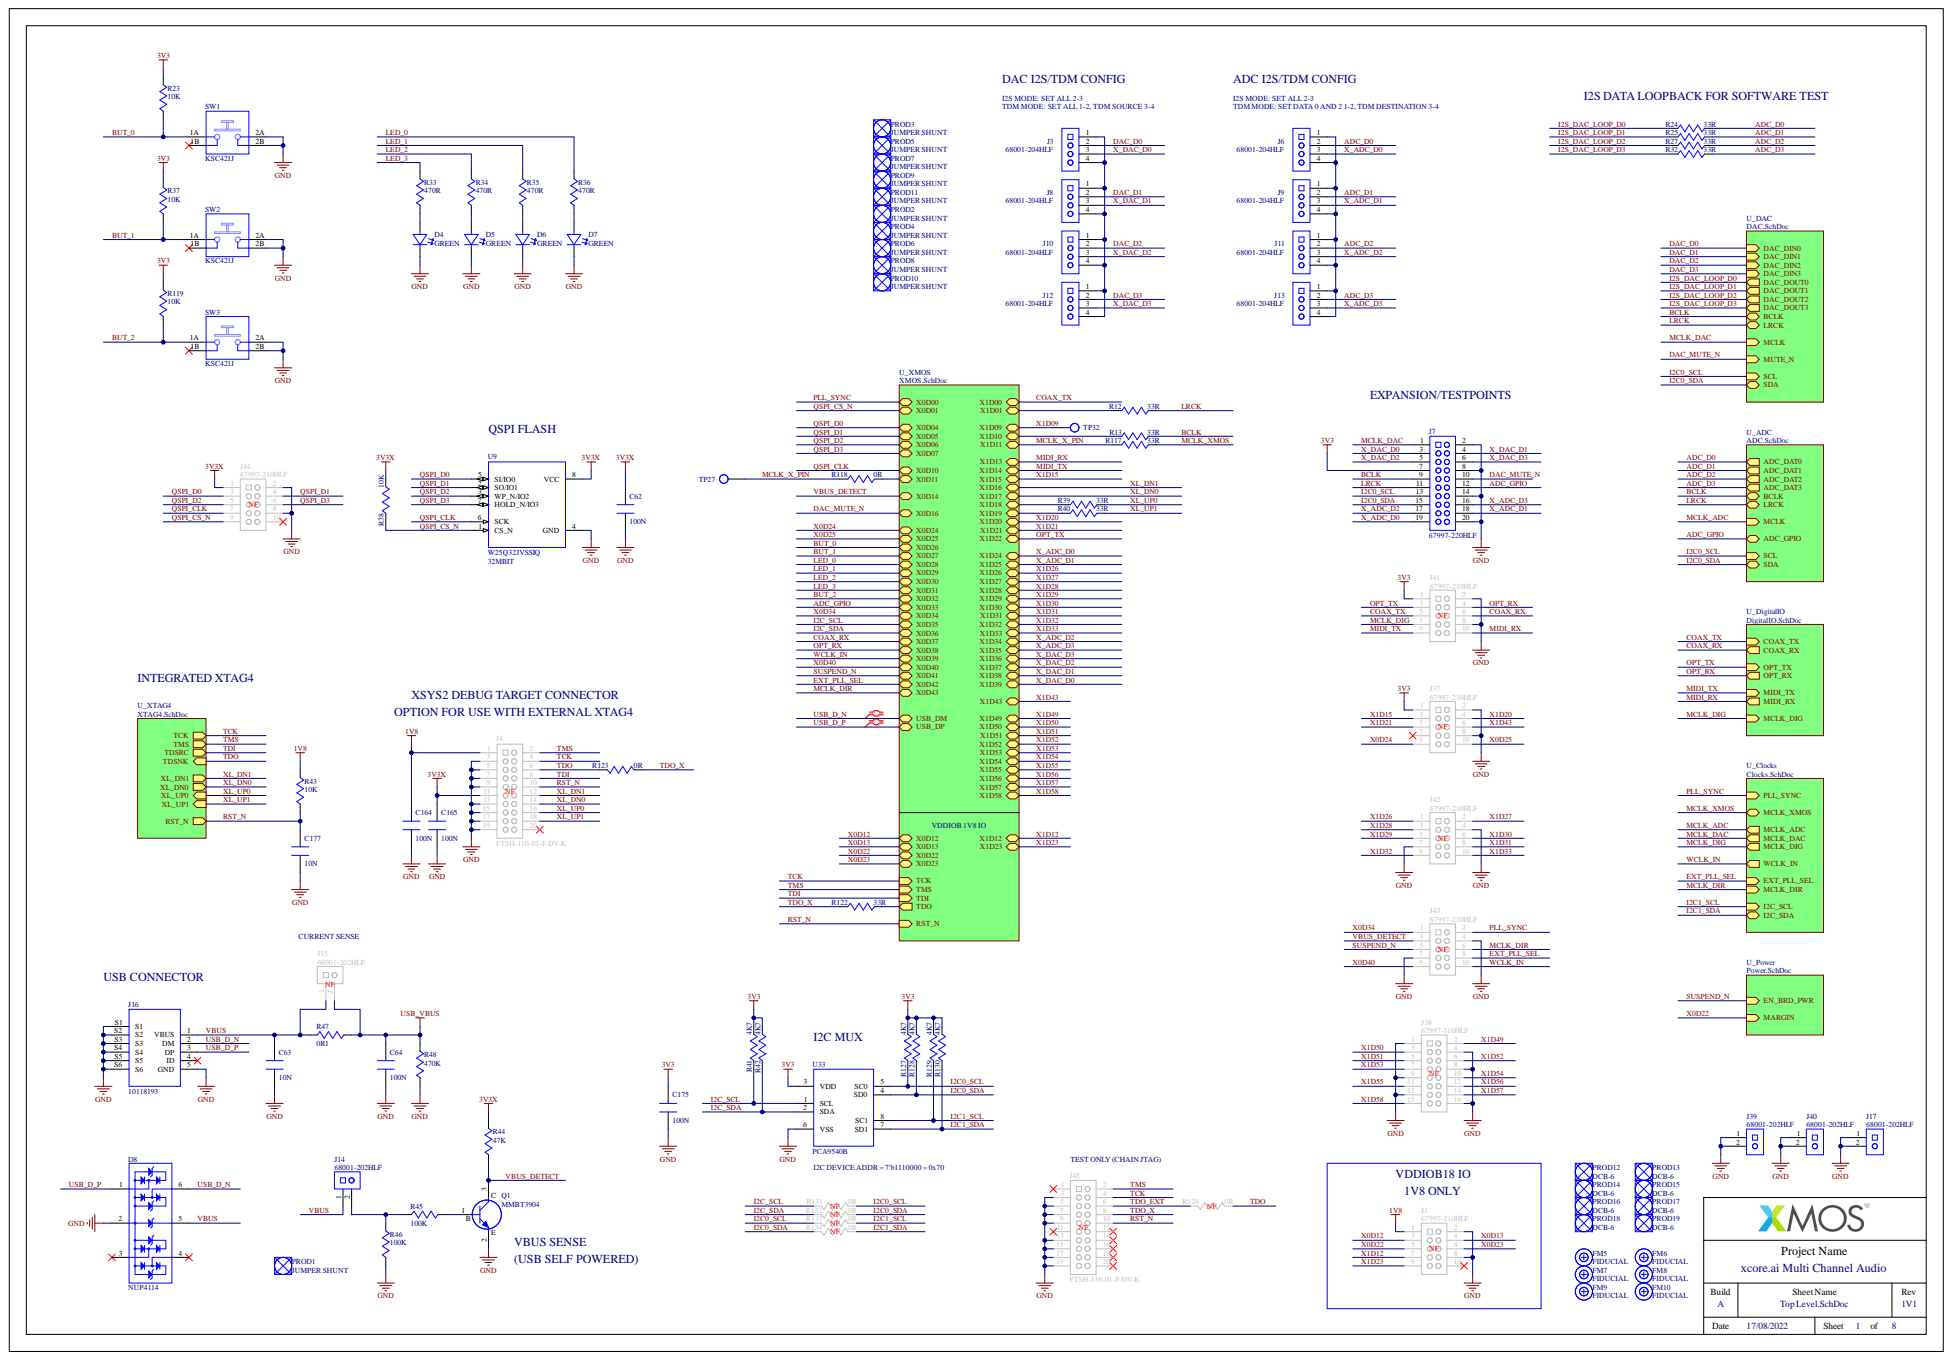
[picture p31: page 1]

I2S MODE: SET ALL 2-3
TDM MODE: SET ALL 1-2, TDM SOURCE 3-4

TDM MODE: SET DATA 0 AND 2 1-2, TDM DESTINATION 3-4

I2S DATA LOOPBACK FOR SOFTWARE TEST

X_DAC_D2 | 5 7 | 6 | X_DAC_D3

XSYS2 DEBUG TARGET CONNECTOR
OPTION FOR USE WITH EXTERNAL XTAG4

TEST ONLY (CHAIN JTAG)

xcore.ai Multi Channel Audio

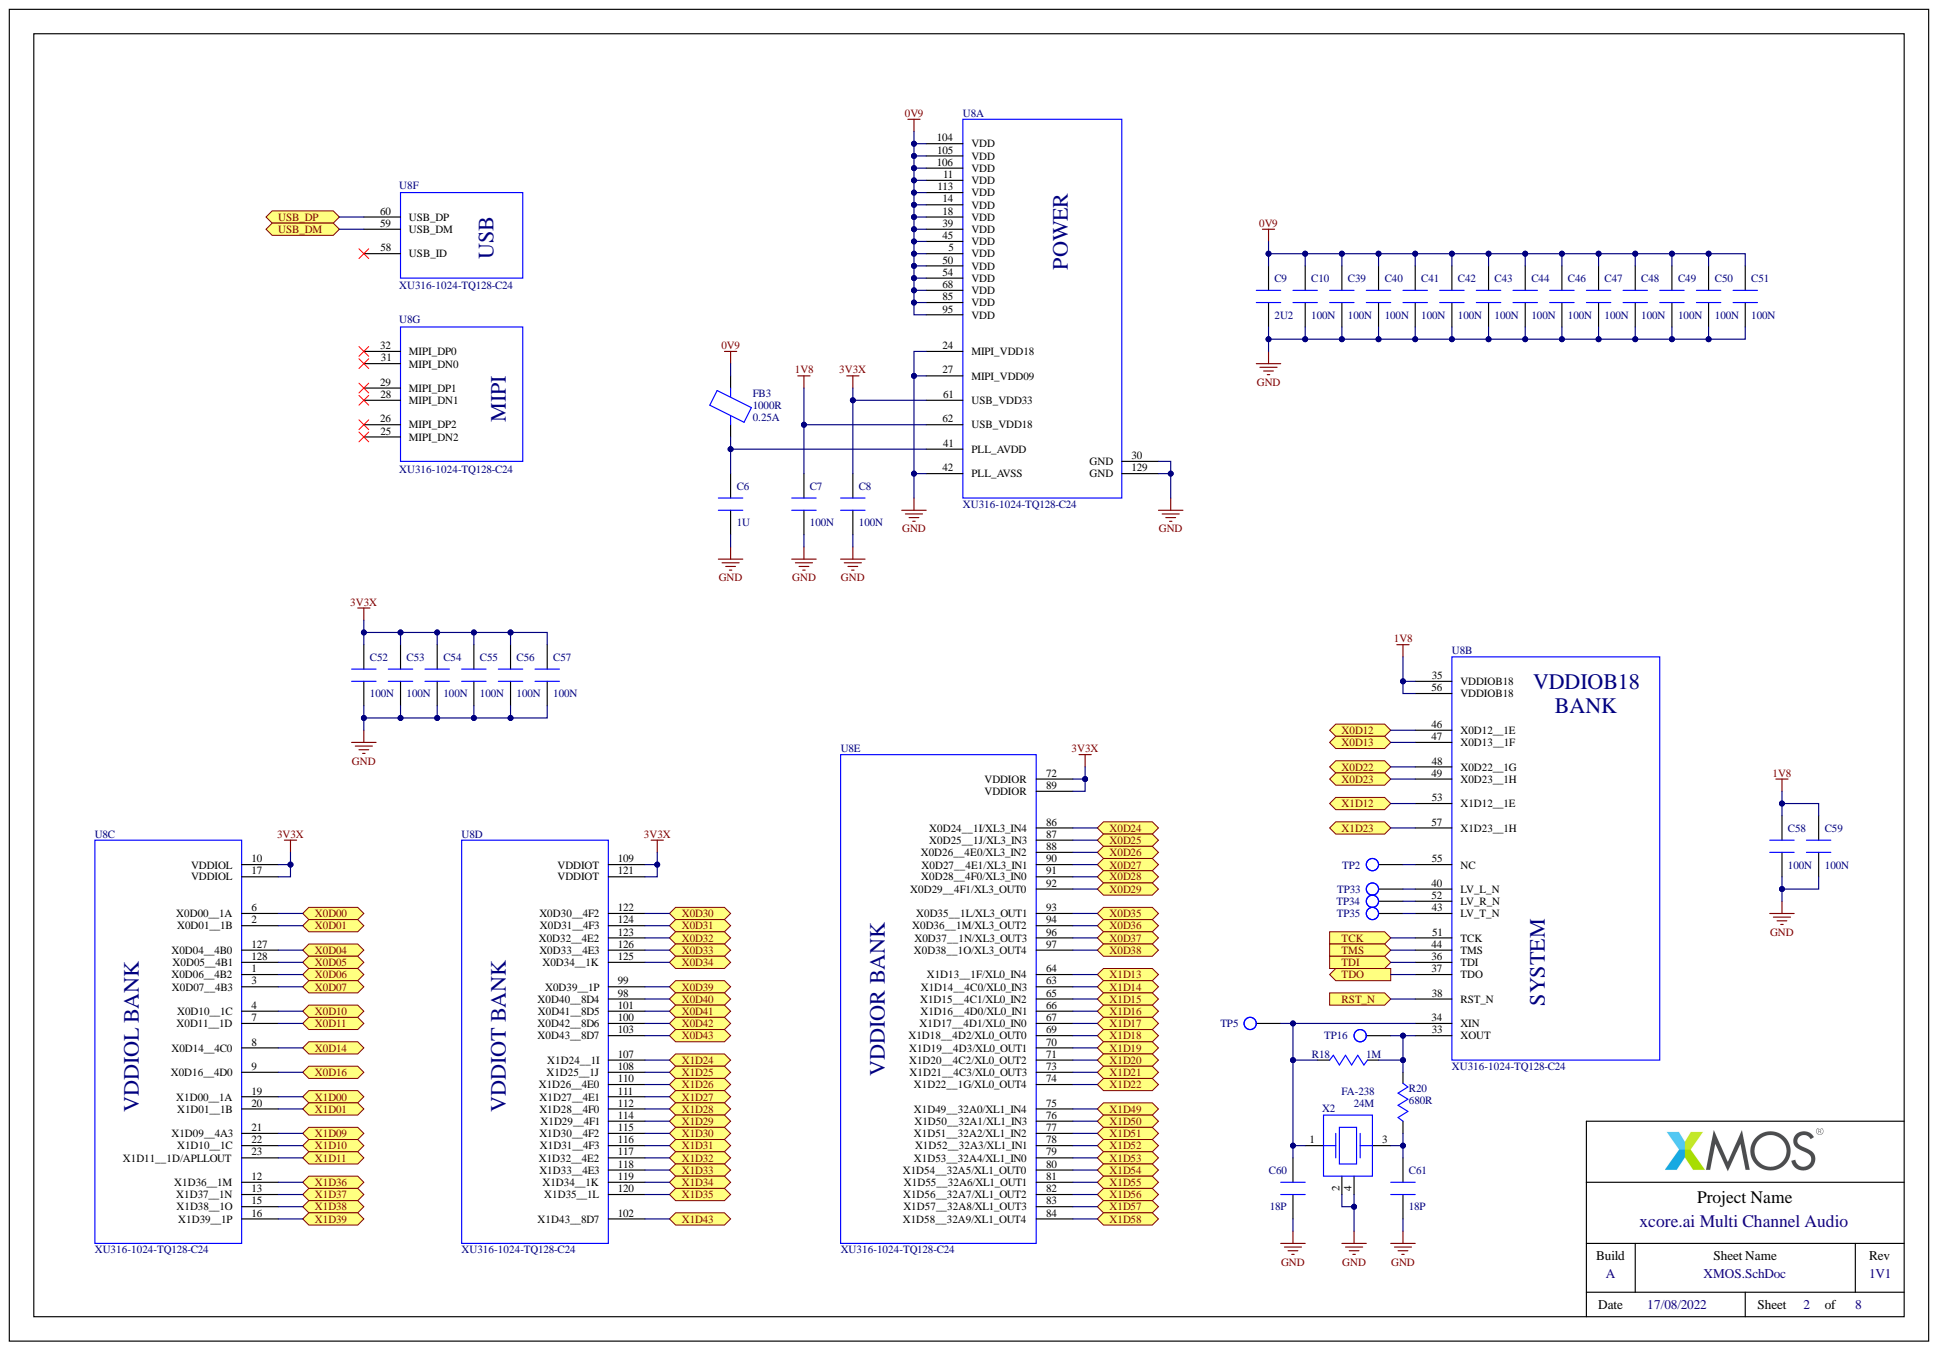
[picture p32: page 2]

xcore.ai Multi Channel Audio

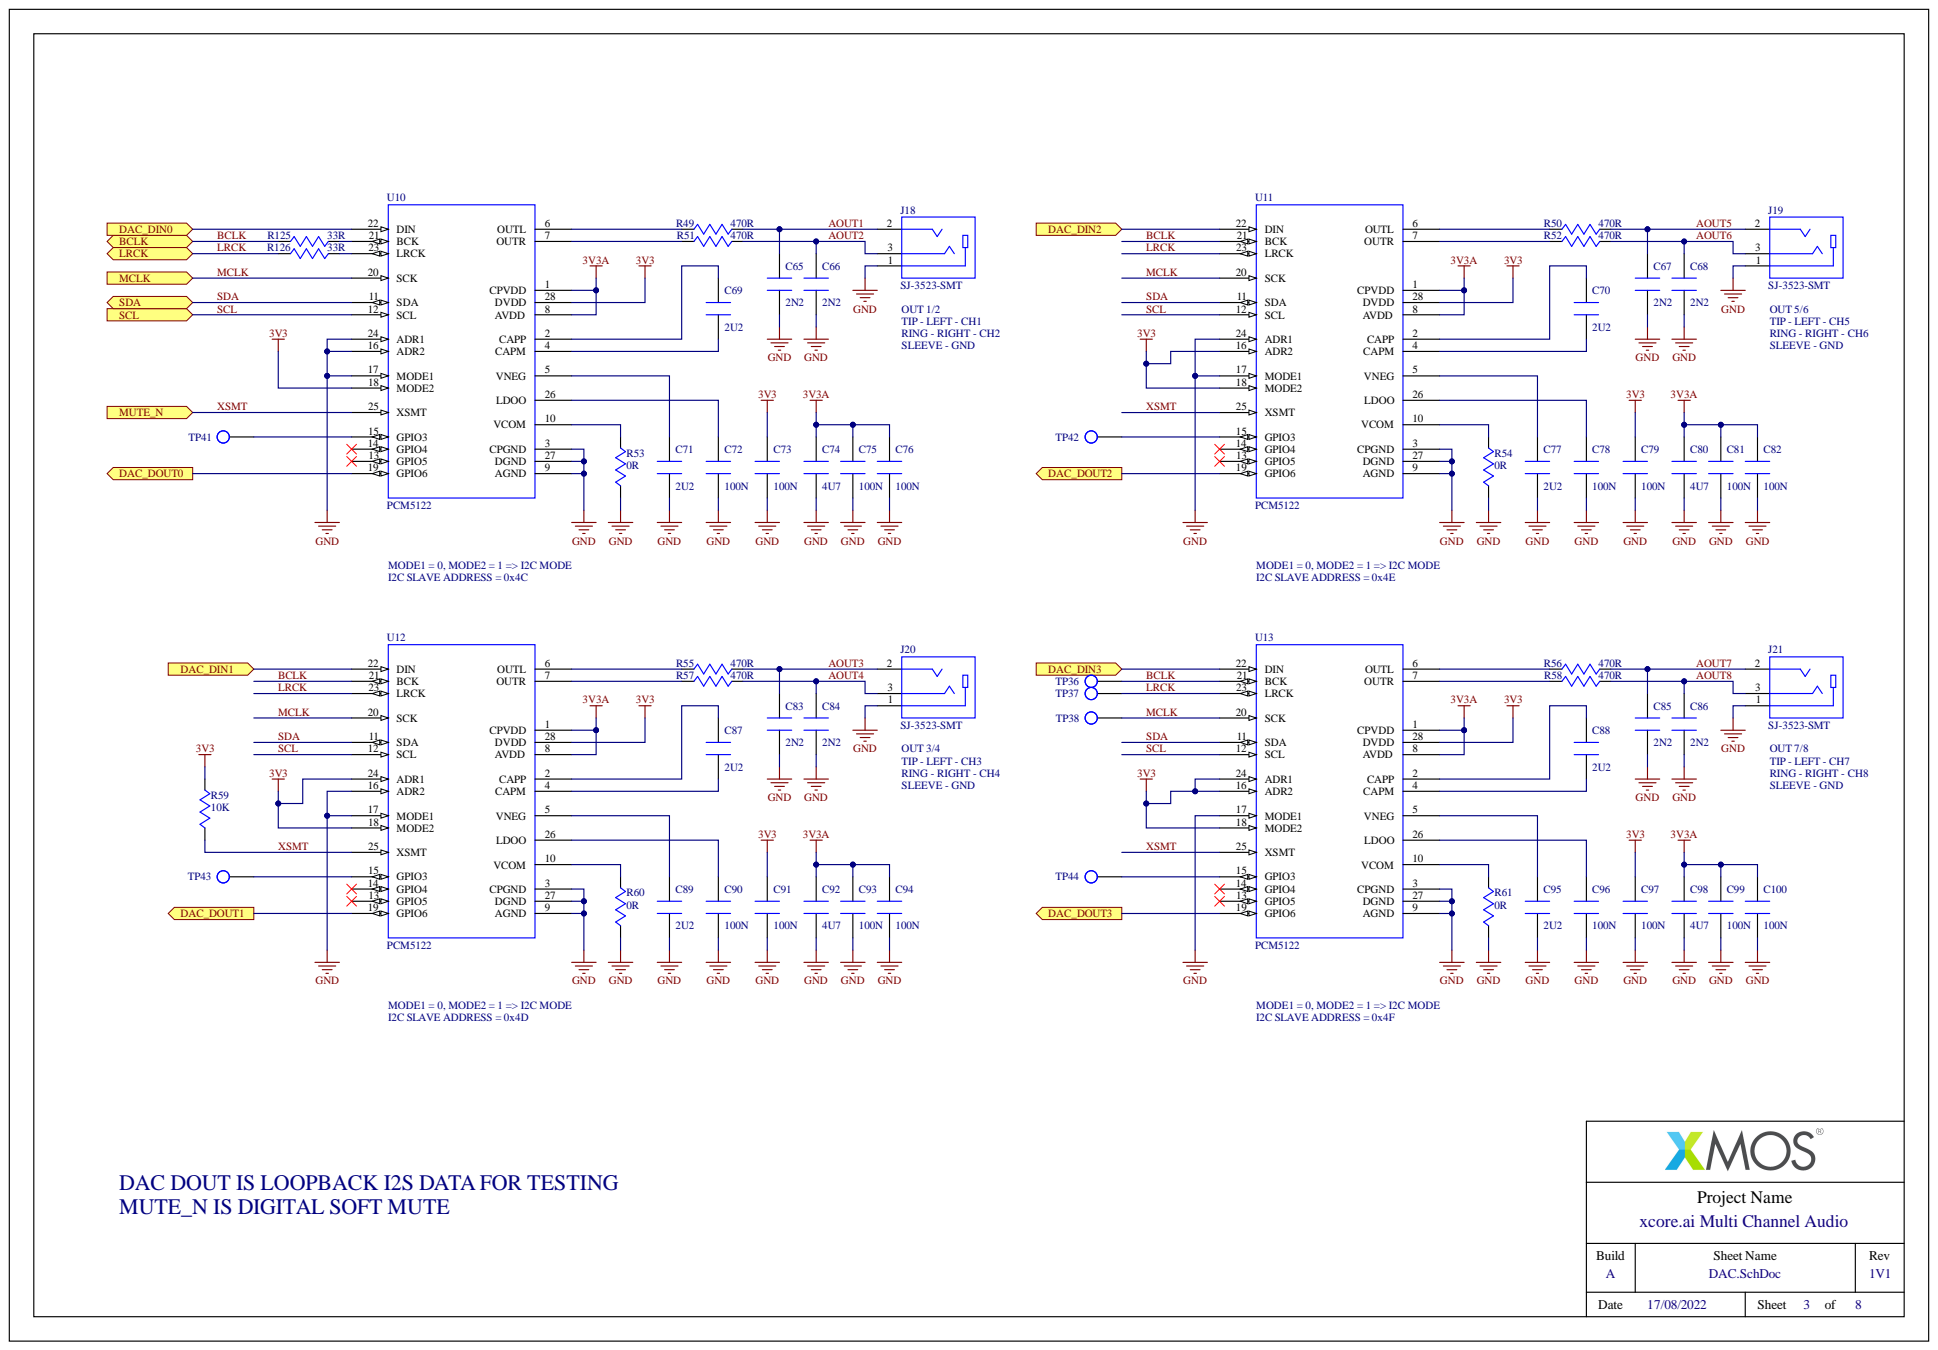
[picture p33: page 3]

MUTE_N IS DIGITAL SOFT MUTE 3V3

DAC DOUT IS LOOPBACK I2S DATA FOR TESTING

xcore.ai Multi Channel Audio

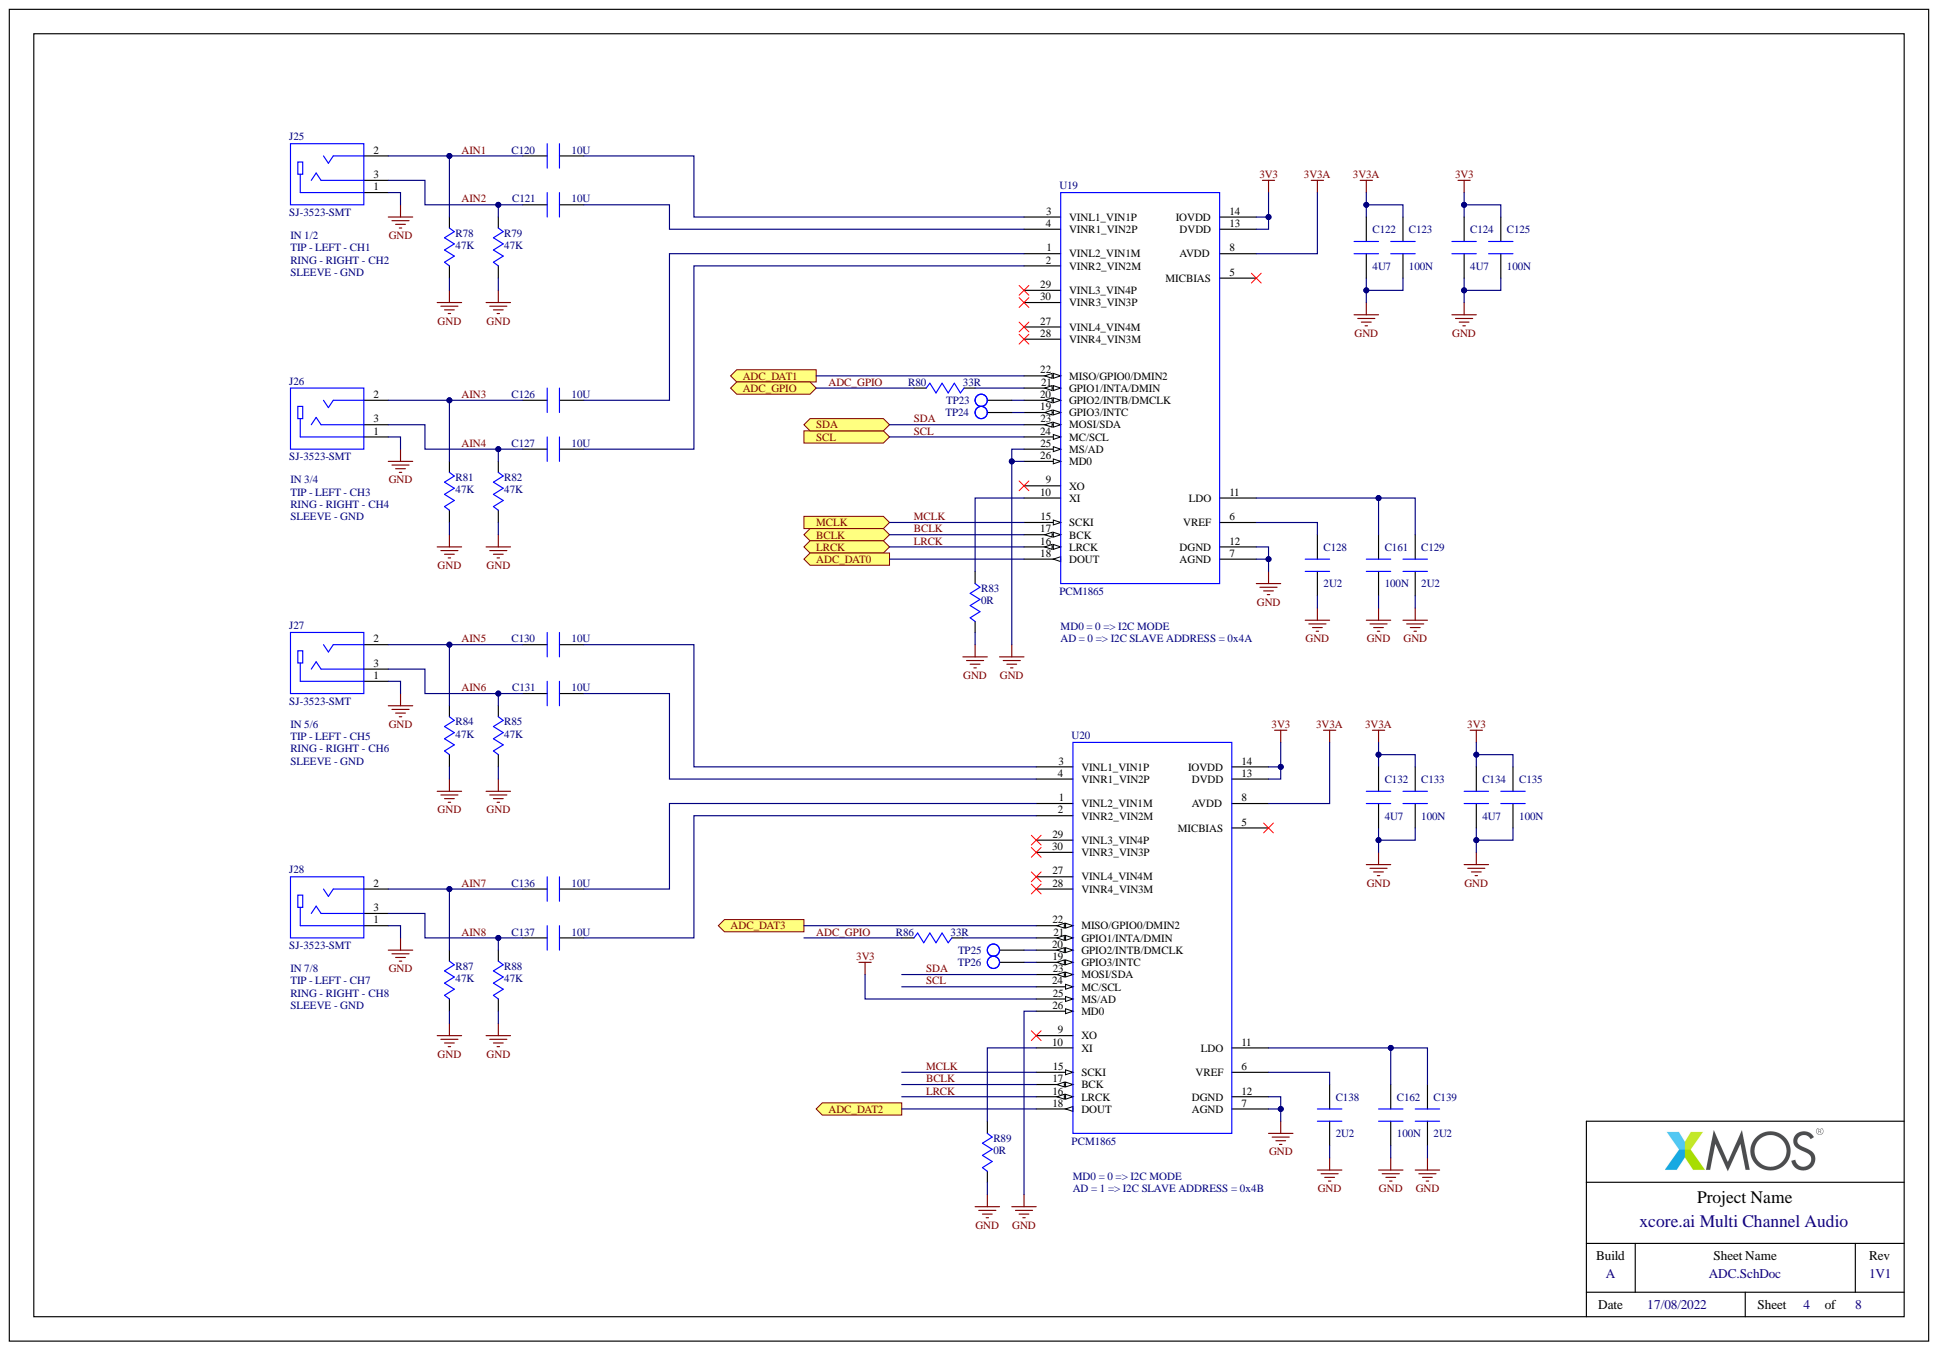
[picture p34: page 4]

TP23 TP24 SDA SDA SCL SCL

SCKI 15 LRCK 16 BCK 17 DOUT 18

VINR2_VIN2M 2

VINL3_VIN4P 29

xcore.ai Multi Channel Audio

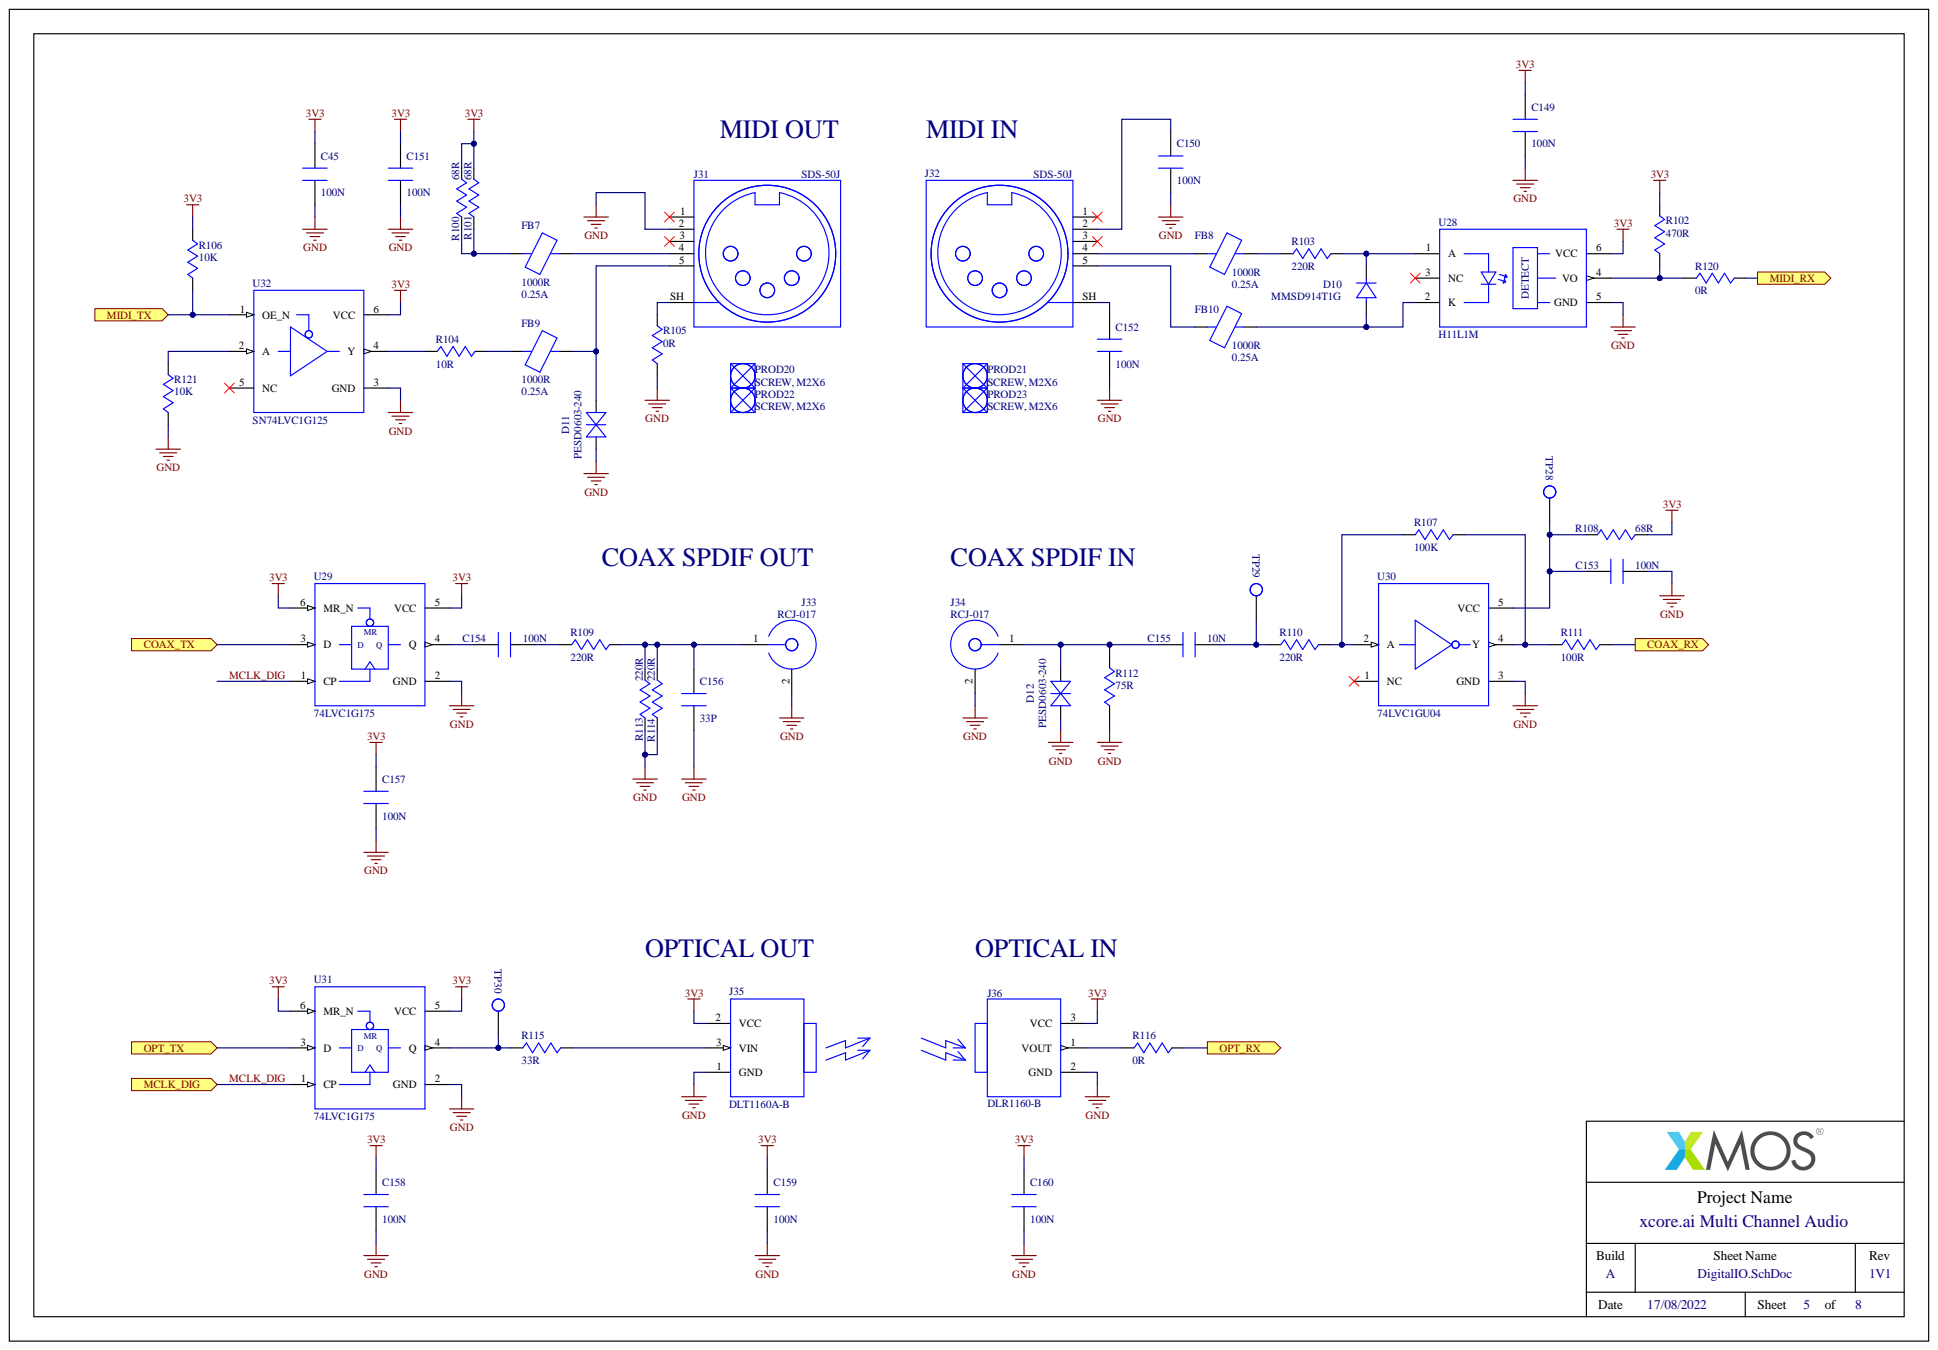
[picture p35: page 5]

xcore.ai Multi Channel Audio

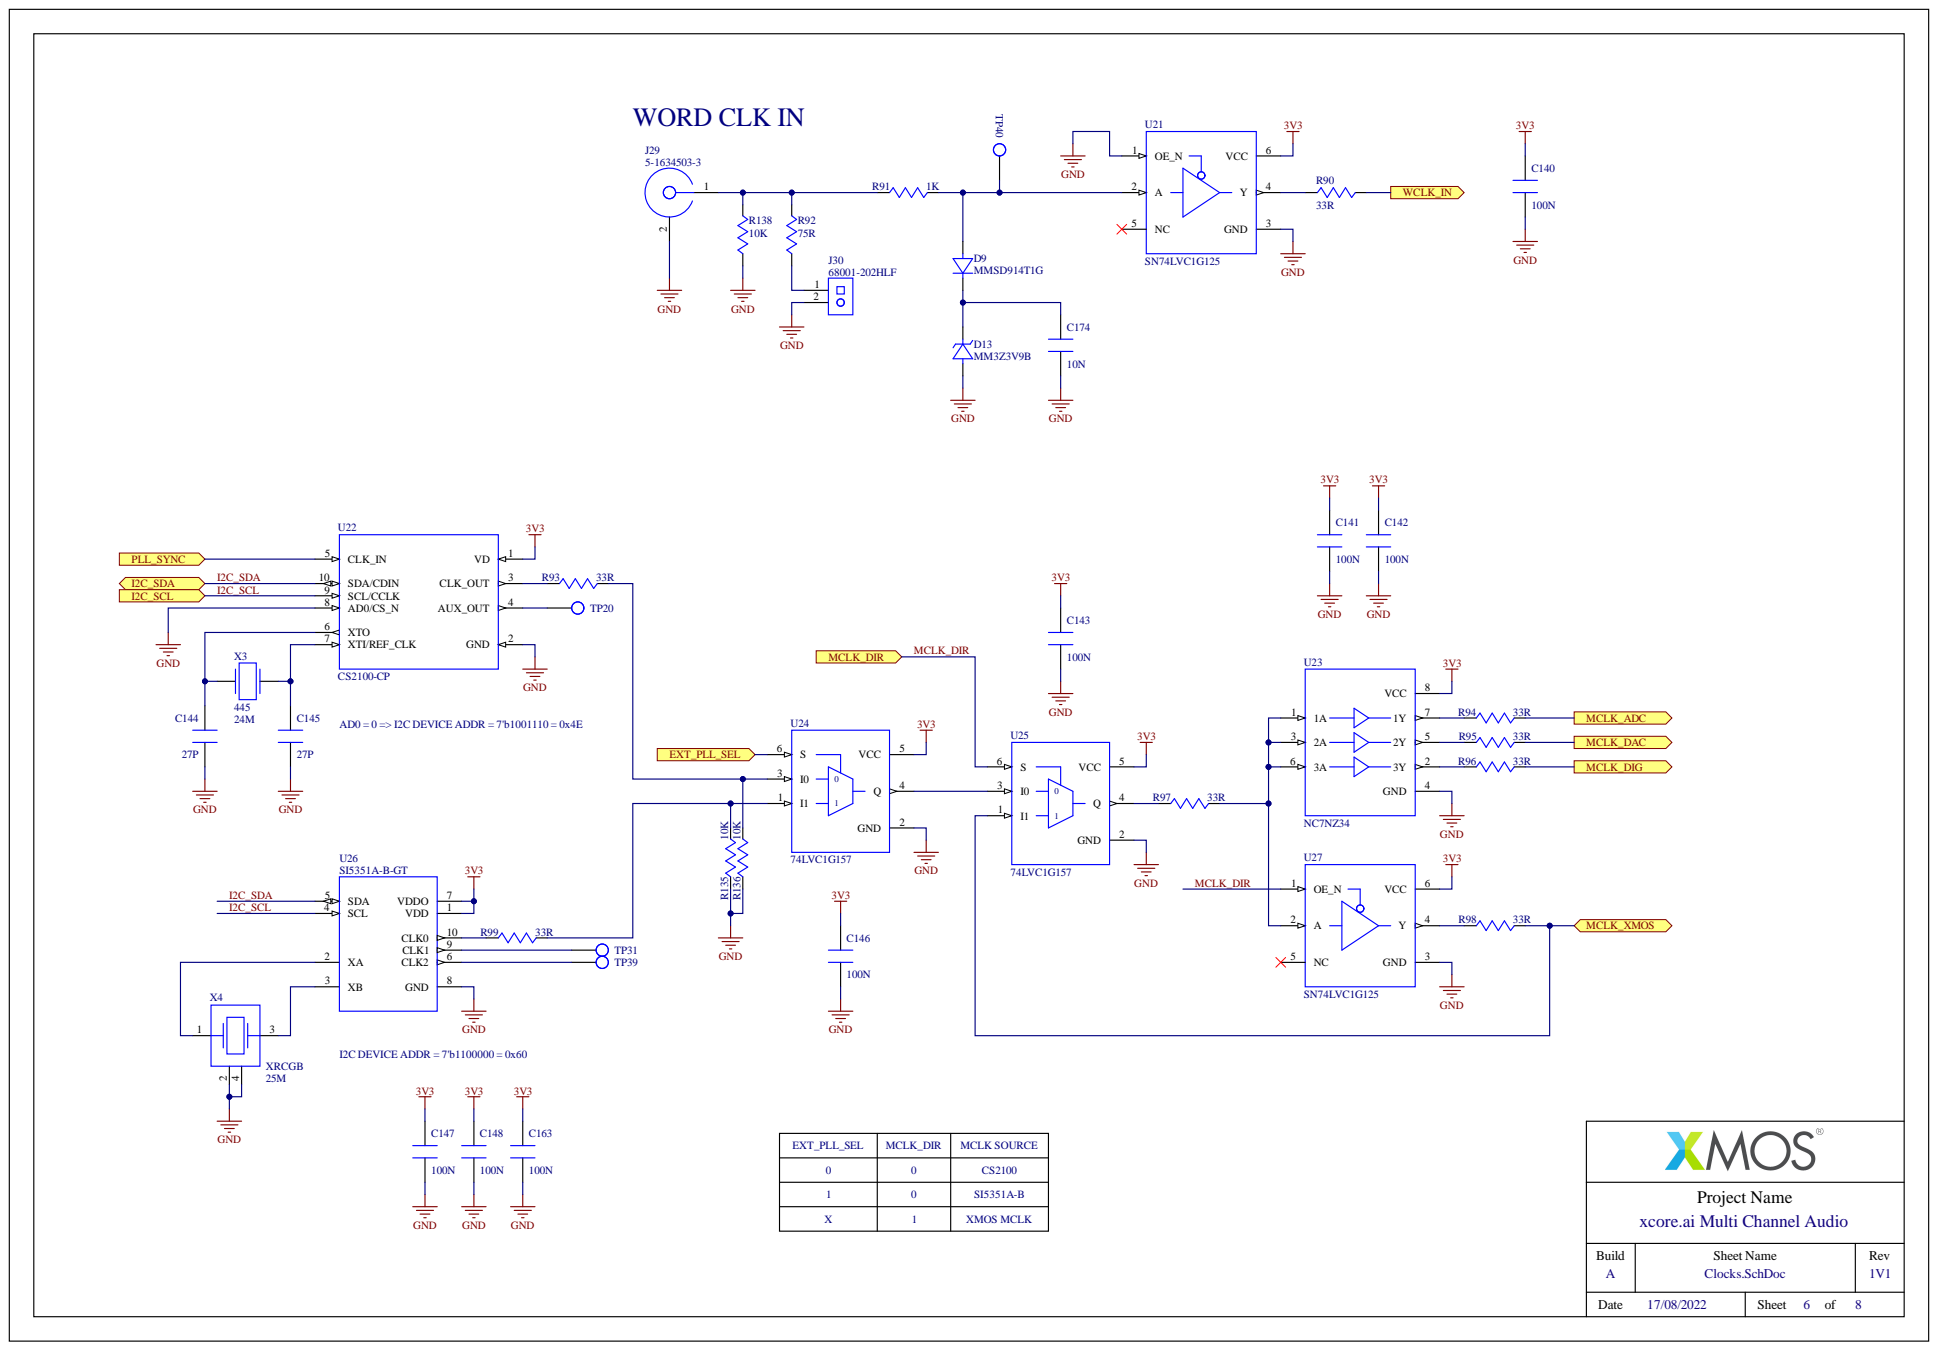
[picture p36: page 6]

MCLK_DIR | NC7NZ34 U27

EXT_PLL_SEL | MCLK_DIR | MCLK SOURCE

X | 1 | XMOS MCLK

xcore.ai Multi Channel Audio

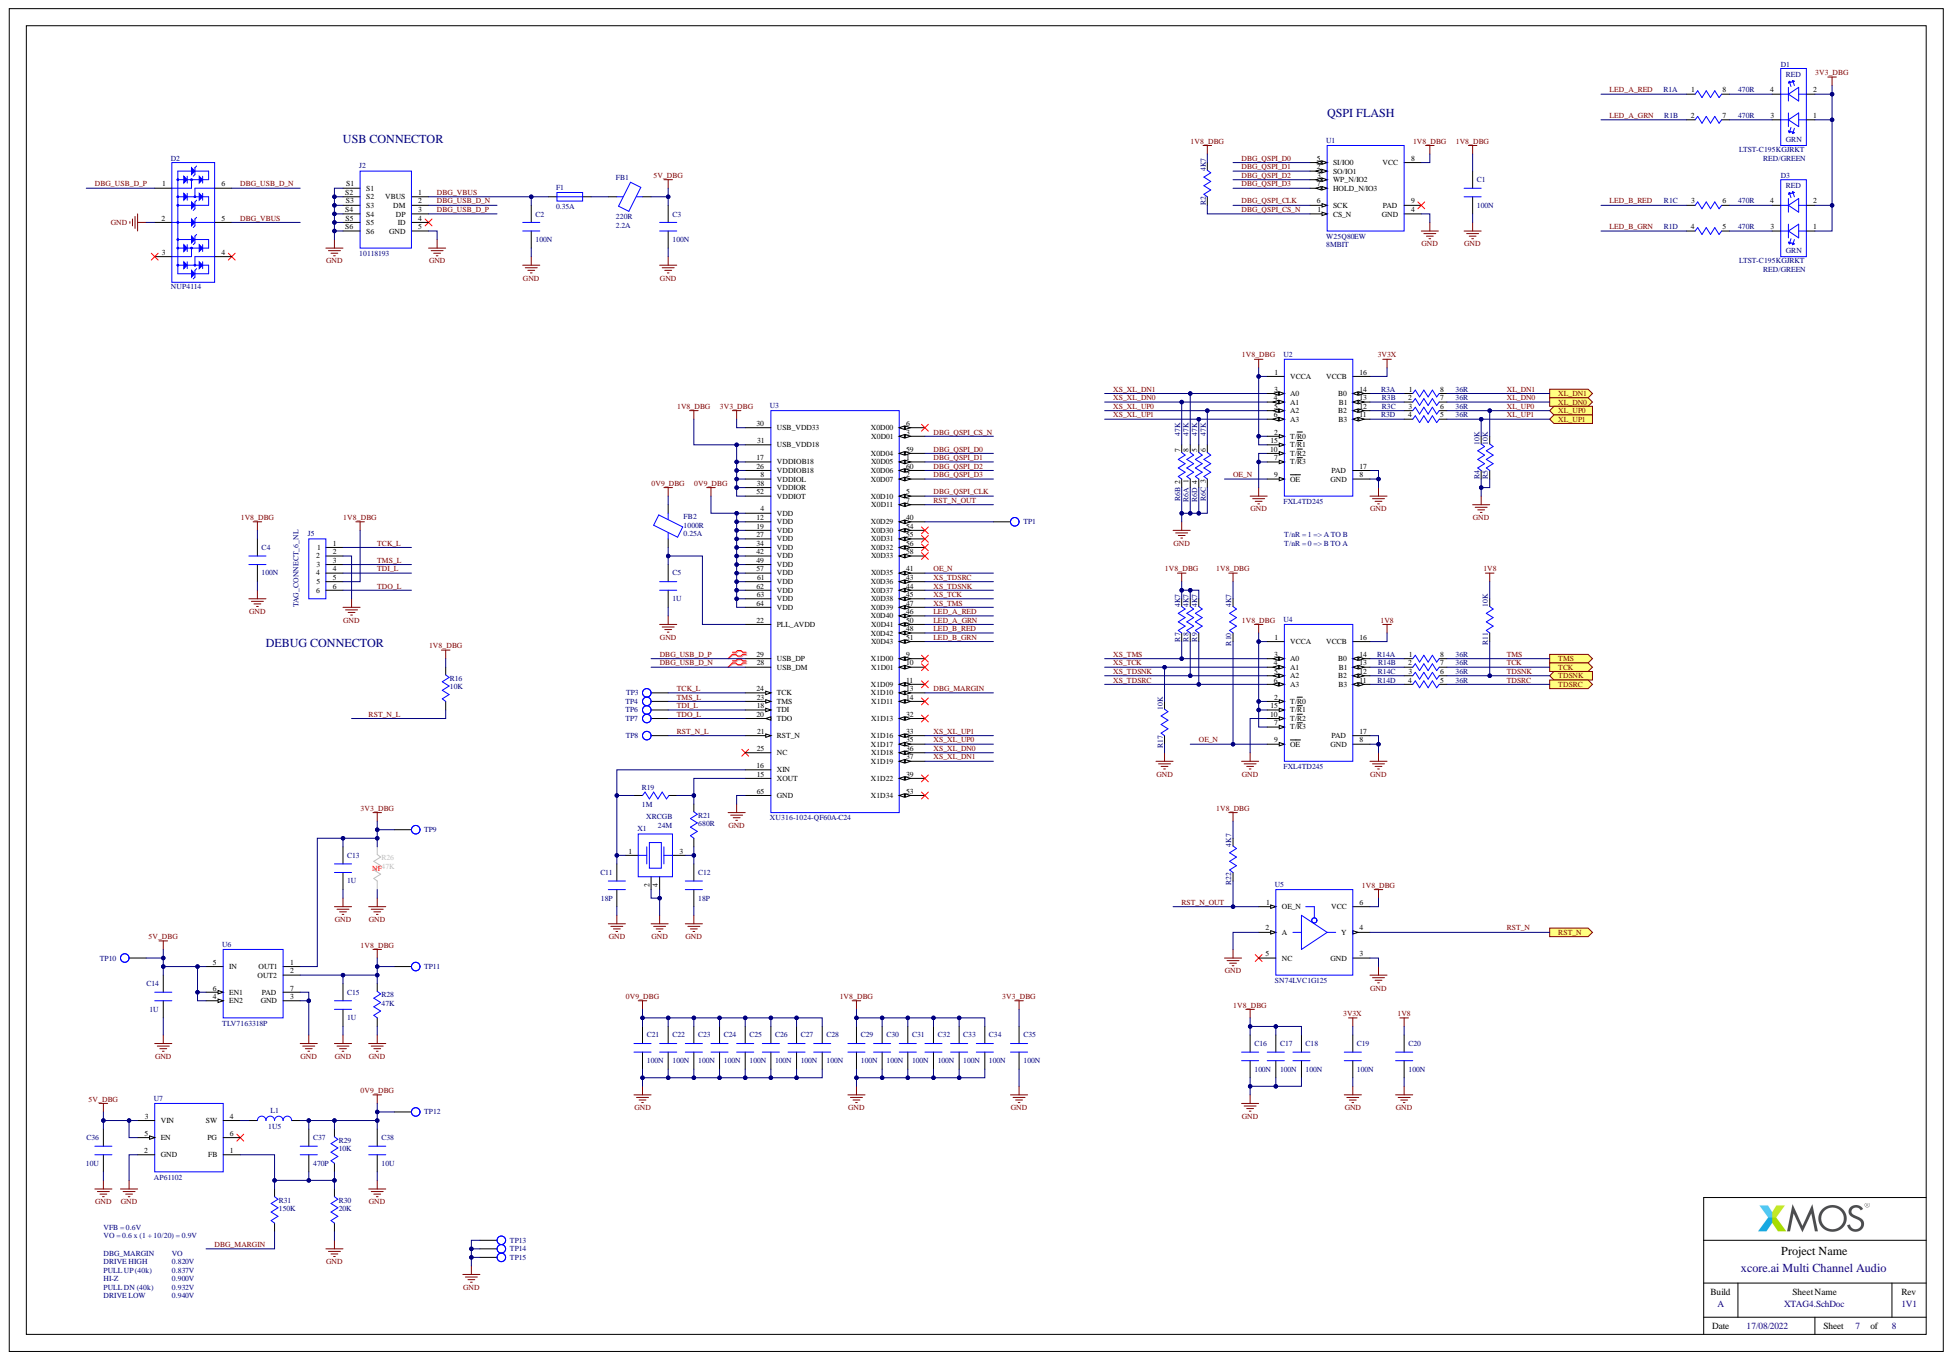
[picture p37: page 7]

XOUT 15

GND 65

xcore.ai Multi Channel Audio

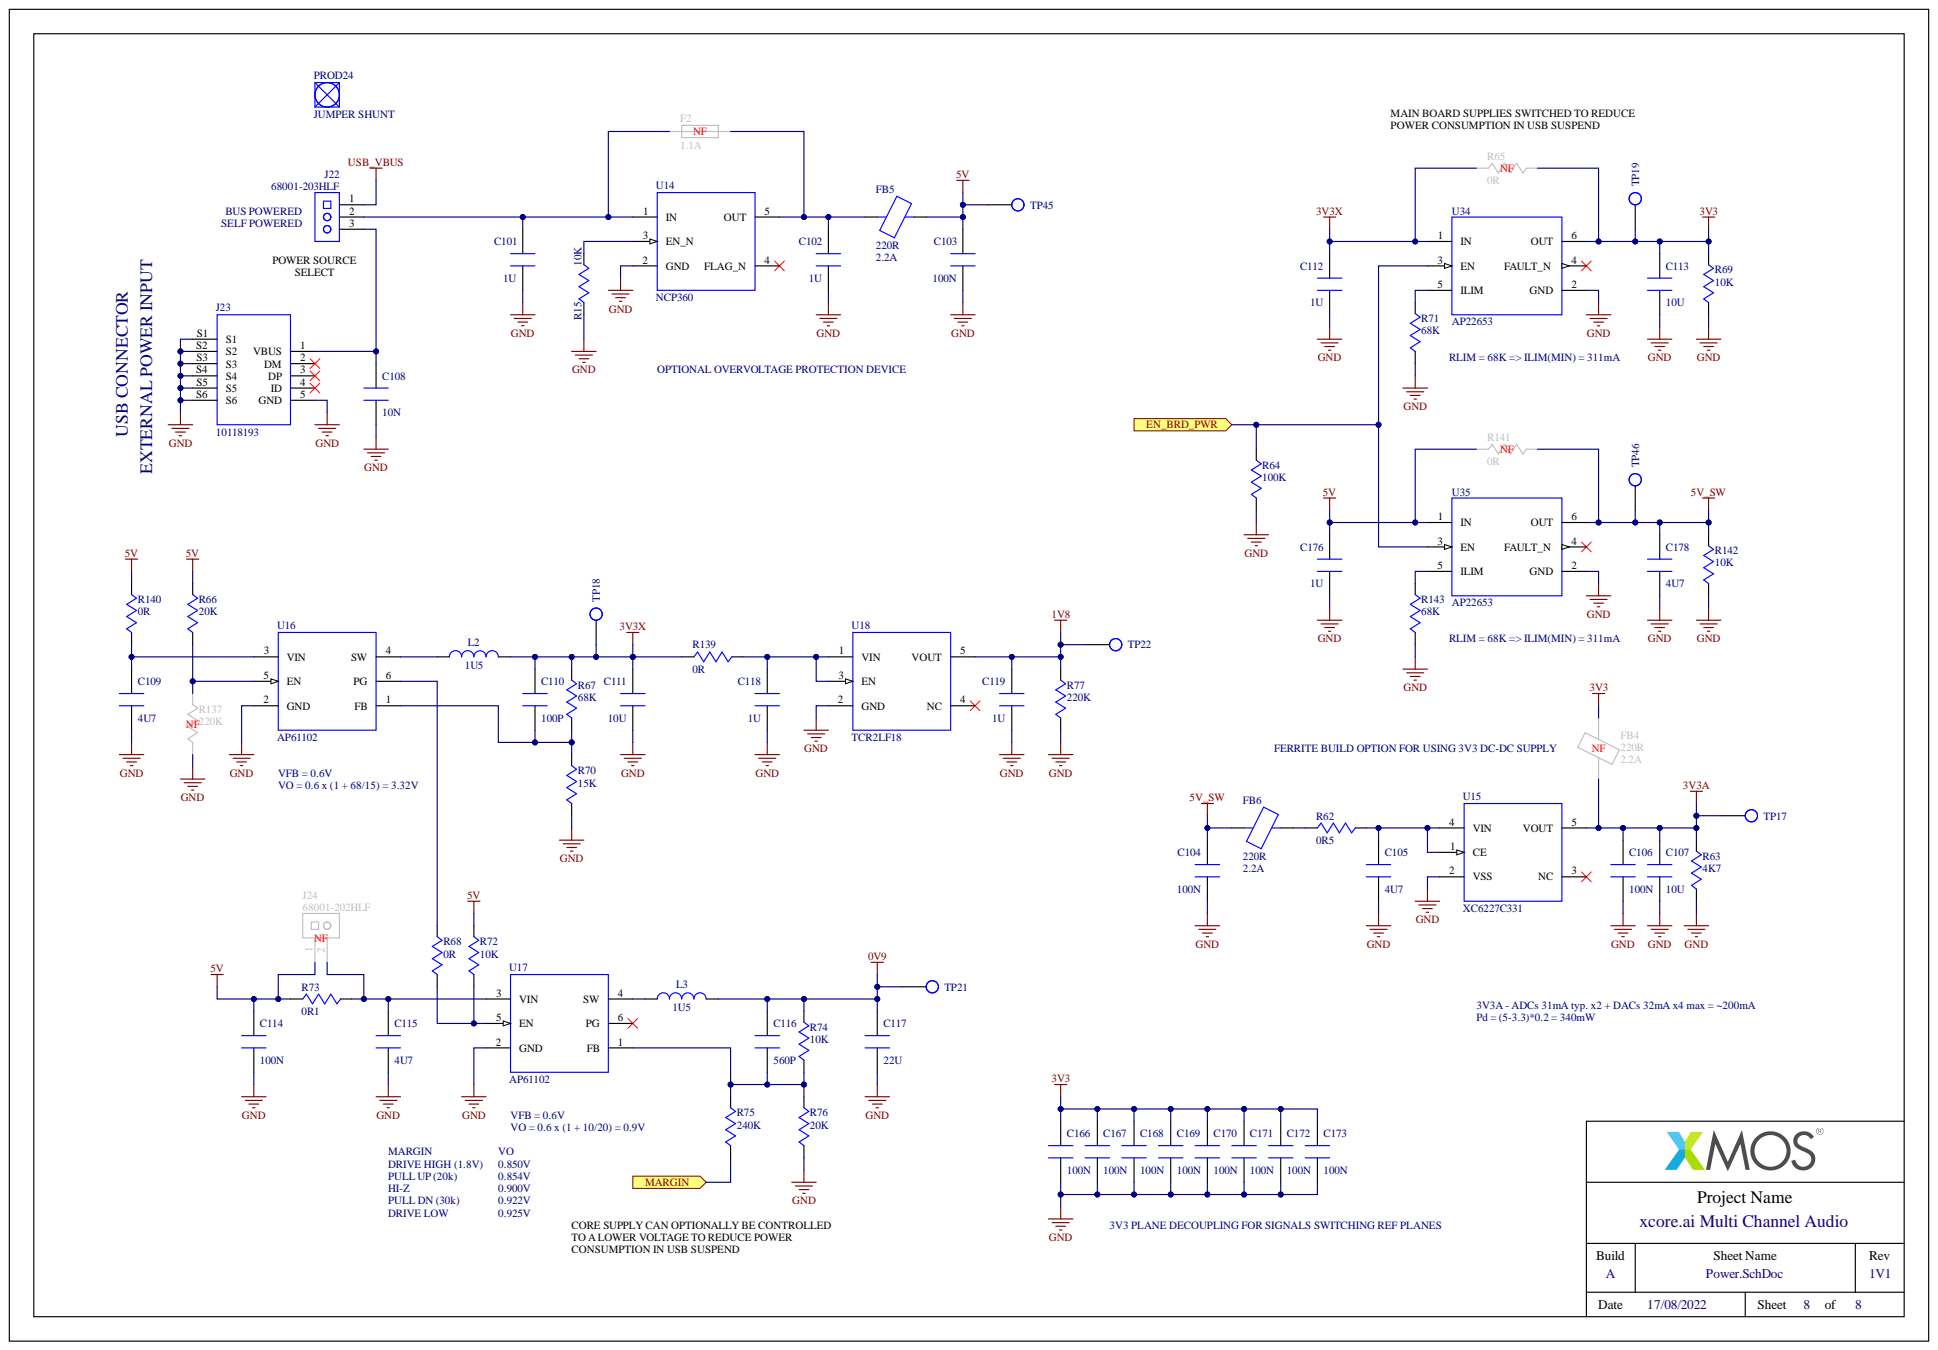
[picture p38: page 8]

MAIN BOARD SUPPLIES SWITCHED TO REDUCE
POWER CONSUMPTION IN USB SUSPEND

R15 10K GND OPTIONAL OVERVOLTAGE PROTECTION DEVICE

FERRITE BUILD OPTION FOR USING 3V3 DC-DC SUPPLY

3V3A - ADCs 31mA typ. x2 + DACs 32mA x4 max = ~200mA

CORE SUPPLY CAN OPTIONALLY BE CONTROLLED
TO A LOWER VOLTAGE TO REDUCE POWER
CONSUMPTION IN USB SUSPEND

3V3 PLANE DECOUPLING FOR SIGNALS SWITCHING REF PLANES

xcore.ai Multi Channel Audio
