Violabitch5/Nathophone_elec/USBtoI2S_board/nathophone_USBtoI2S/plots/nathophone_USBtoI2S__Assembly.pdf

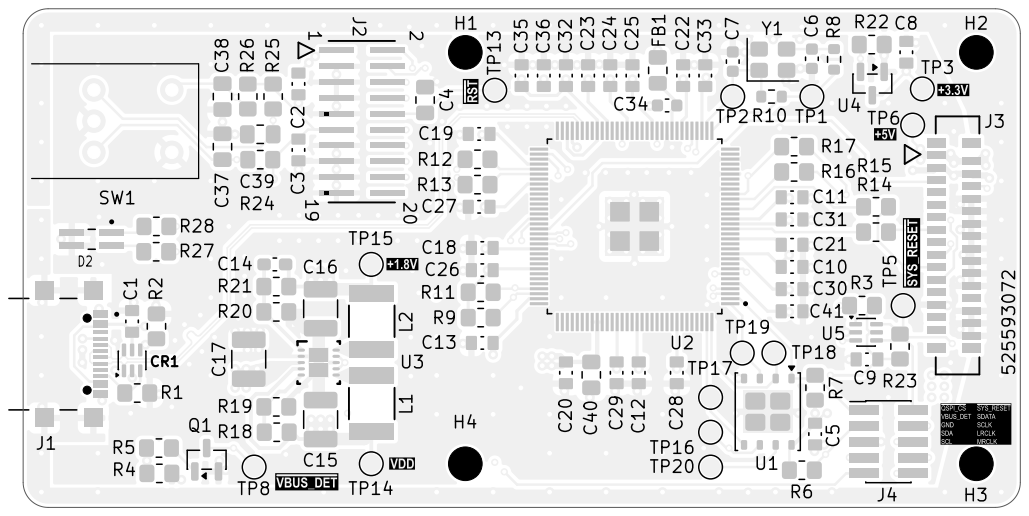
[picture p39: page 1]

Board2Pdf: Black And White TOP - Page 1/4

Sheet: Black And White TOP
File: nathophone_USBtoI2S.kicad_pcb
Title:
KiCad E.D.A. 10.0.1

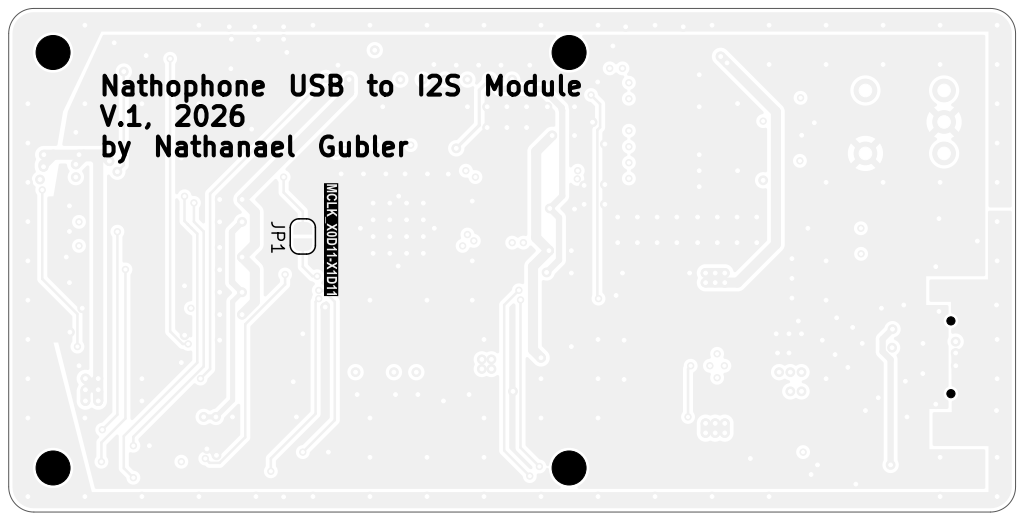
[picture p40: page 2]
by Nathanael Gubler JP1 1; D Date:

Nathophone USB to I2S Module

Board2Pdf: Black And White BOT - Page 2/4

Sheet: Black And White BOT
File: nathophone_USBtoI2S.kicad_pcb
Title:

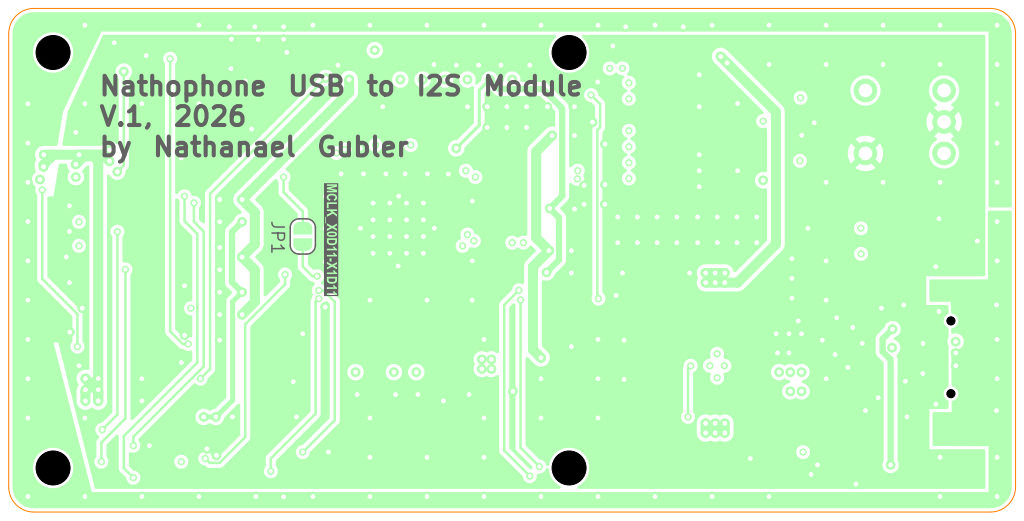
[picture p41: page 3]
by Nathanael Gubler JP1 1; D Date:

Nathophone USB to I2S Module

Board2Pdf: Colored BOT - Page 3/4

Sheet: Colored BOT
File: nathophone_USBtoI2S.kicad_pcb
Title:

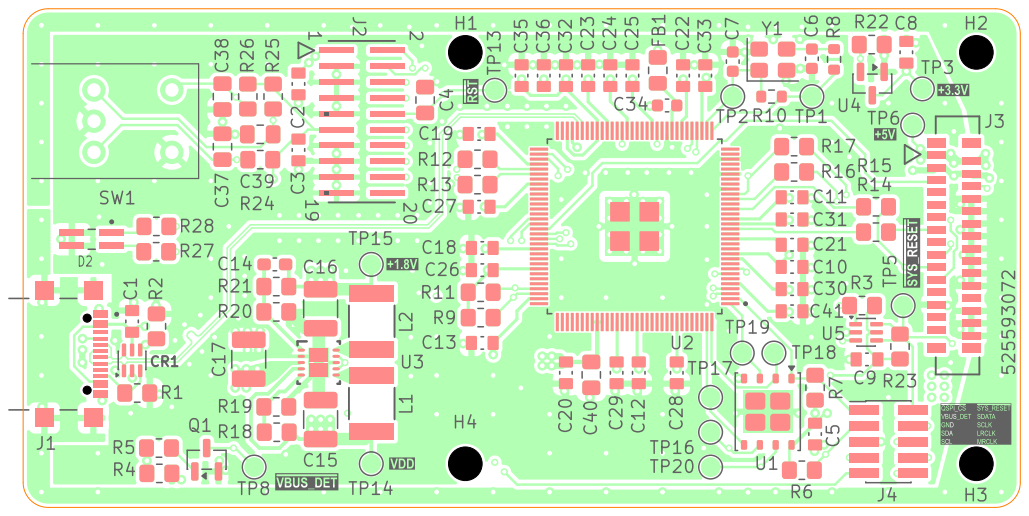
[picture p42: page 4]
