Violabitch5/Nathophone_elec/pcb/Nathophone_driver_board.pdf

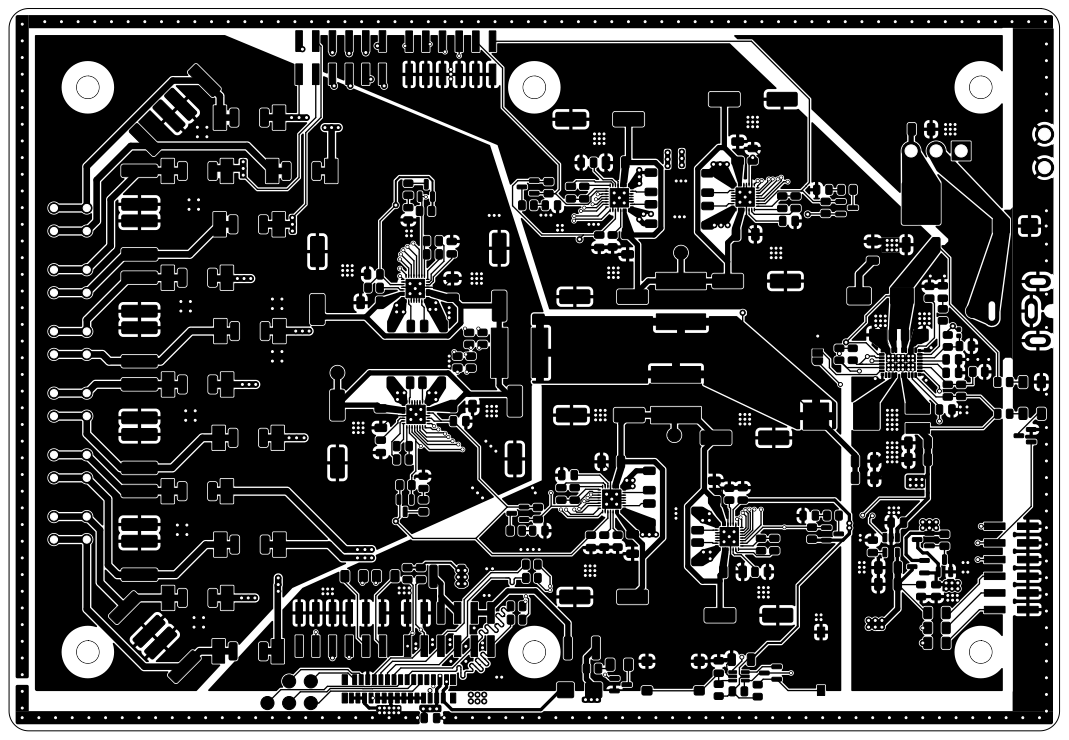
[picture p43: page 1]

Id: 1/7 Title: Nathophone Driver Board

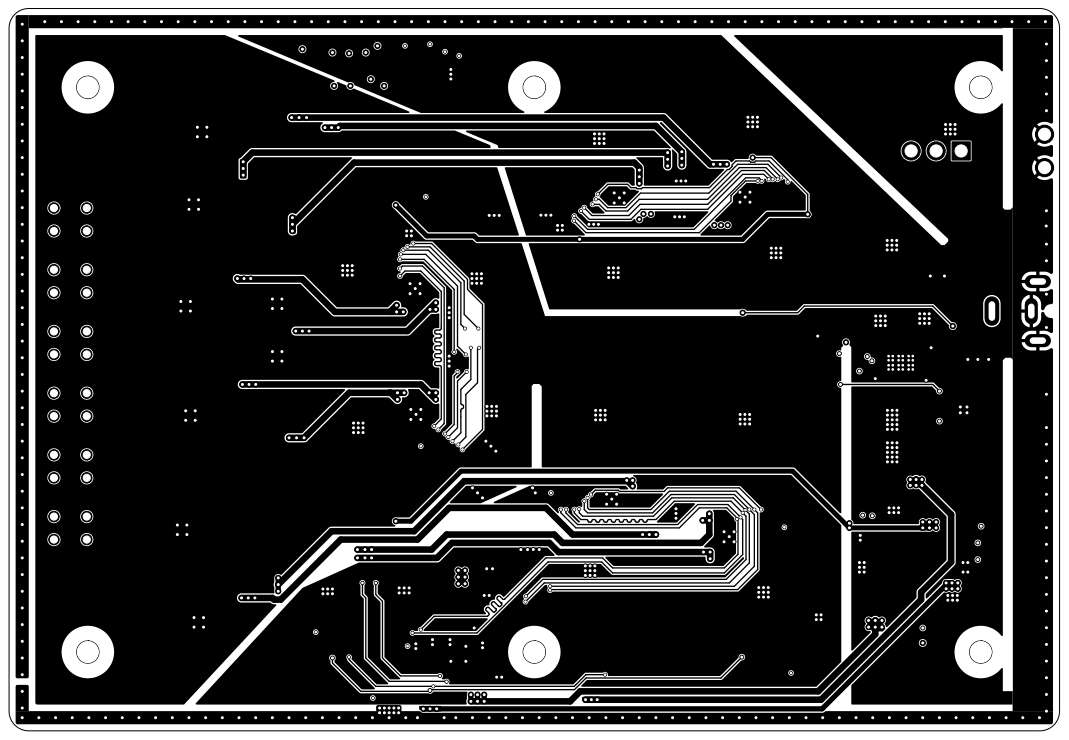
[picture p44: page 2]

Id: 2/7 Title: Nathophone Driver Board

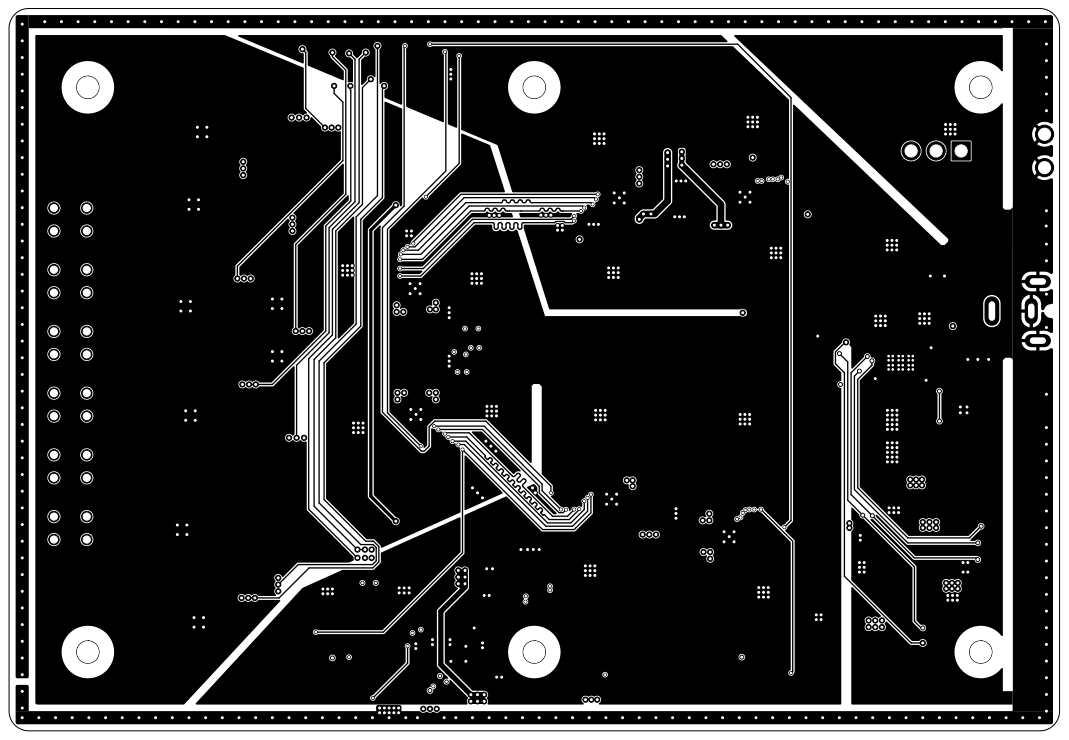
[picture p45: page 3]

Id: 3/7 Title: Nathophone Driver Board

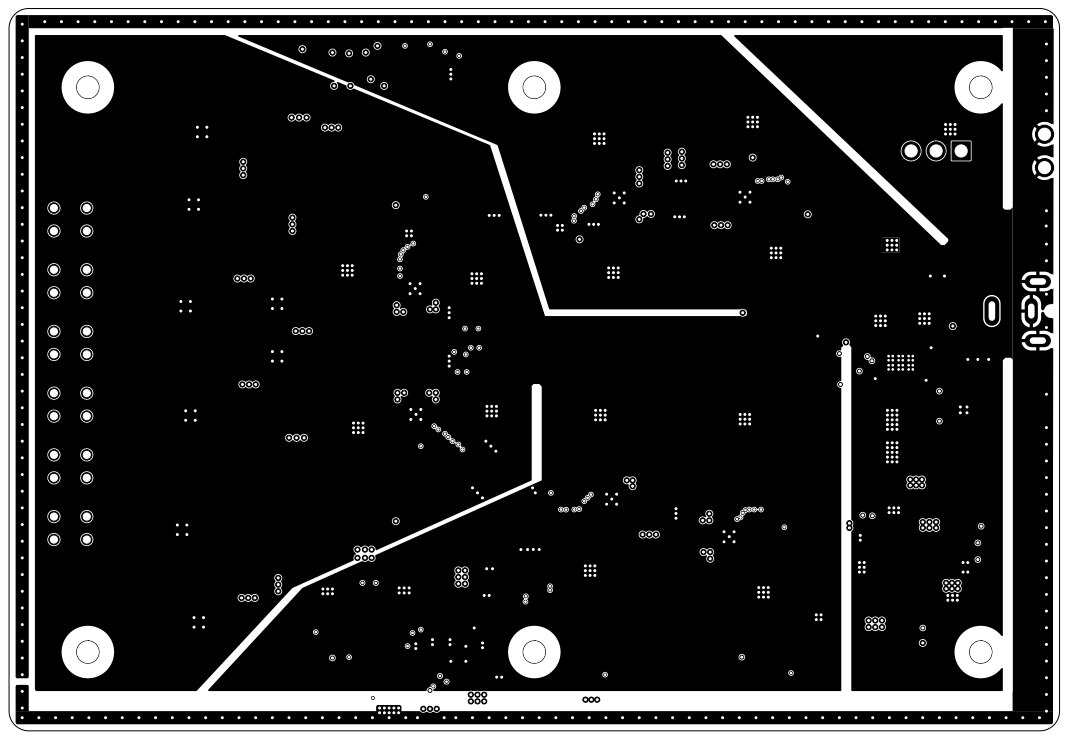
[picture p46: page 4]

Id: 4/7 Title: Nathophone Driver Board

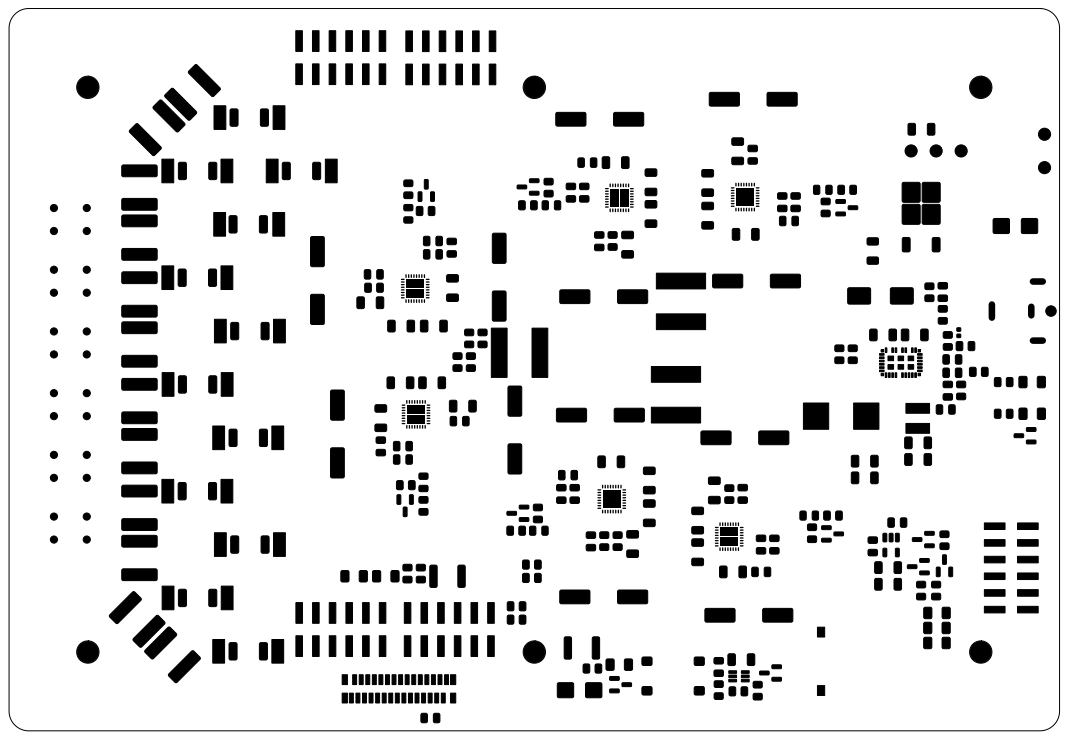
[picture p47: page 5]

Id: 5/7 Title: Nathophone Driver Board

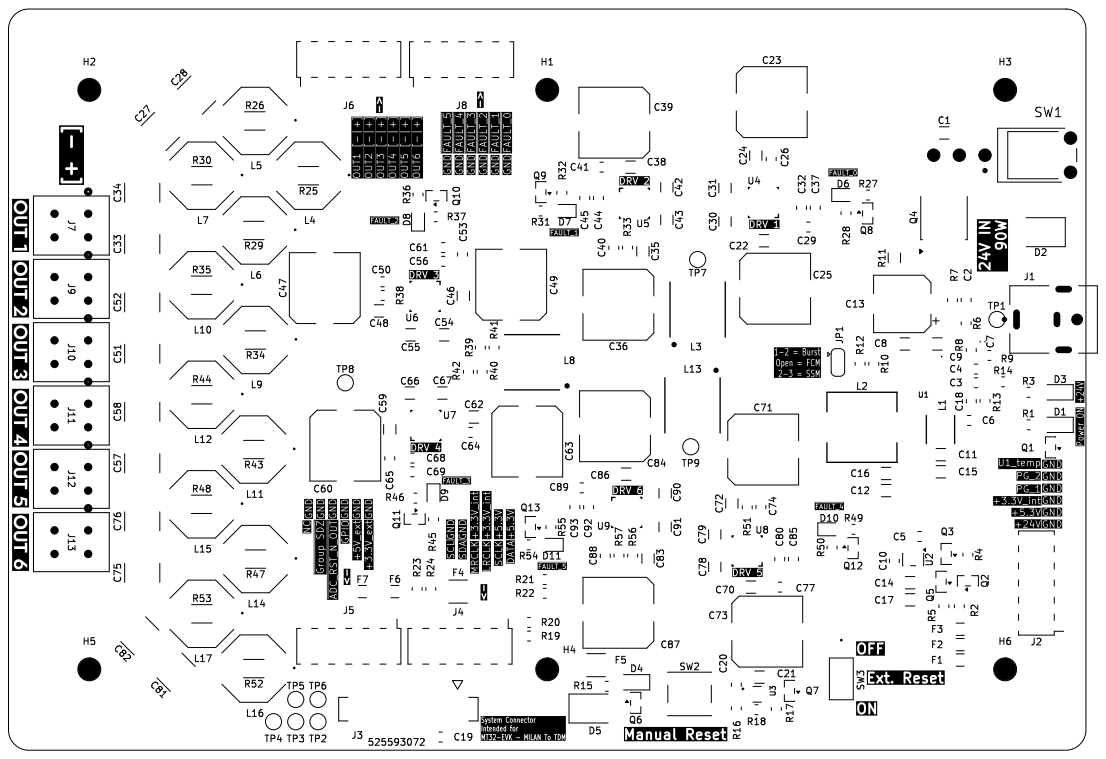
[picture p48: page 6]

Id: 6/7 Title: Nathophone Driver Board

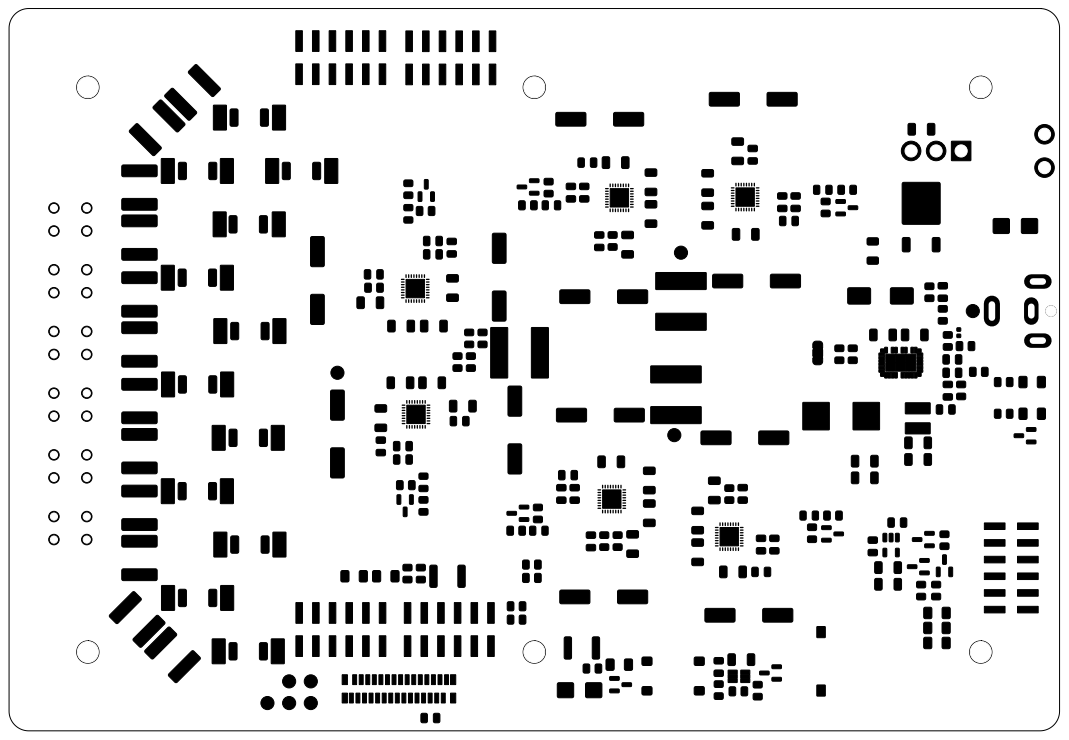
[picture p49: page 7]

Id: 7/7 Title: Nathophone Driver Board
