Violabitch5/Nathophone_elec/simulations/2LoadsParallel_CapSweep0Fto400uF_IndSweep0Hto400uH.pdf

## Lastspannung bei 0F Kapazität

## Sweep 0 - 400uH

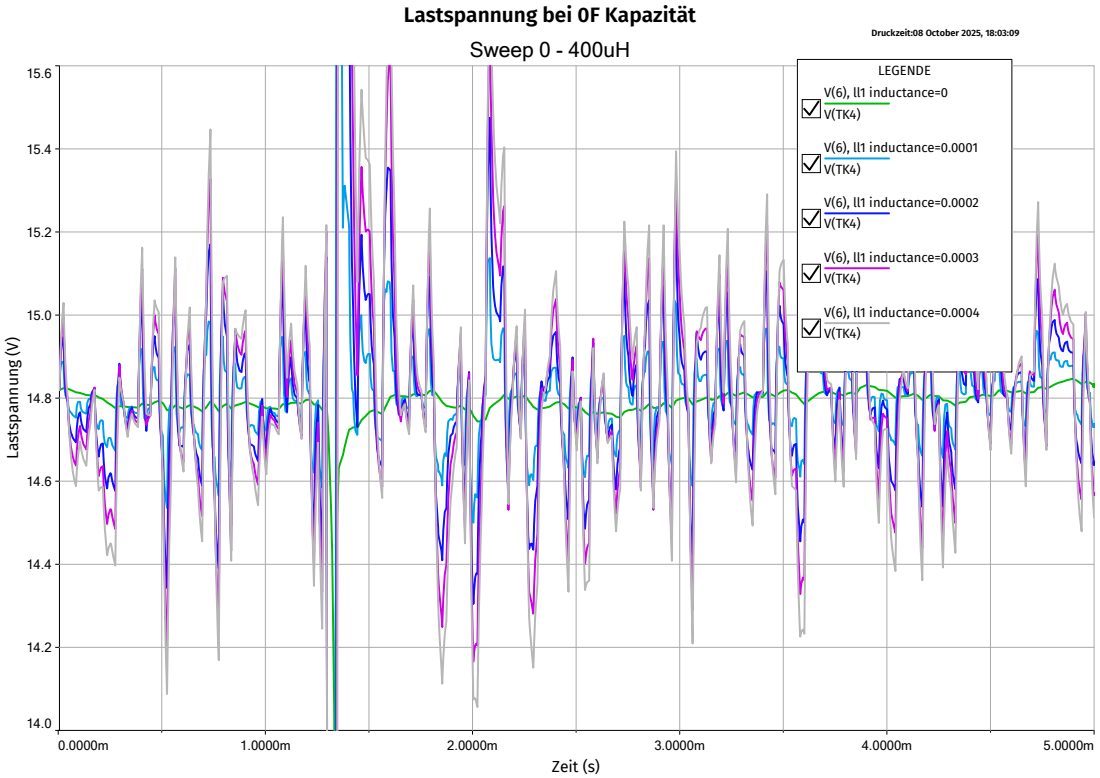
[picture p50: page 1]
Druckzeit:08 October 2025, 18:03:09; Zeit (s); 5.0000m Lastspannung ⁽V⁾

LEGENDE V(6), ll1 inductance=0 V(TK4) V(6), ll1 inductance=0.0001

V(TK4) V(6), ll1 inductance=0.0002 V(TK4)

V(6), ll1 inductance=0.0003 V(TK4) V(6), ll1 inductance=0.0004

## Lastspannung bei 100uF Kapazität

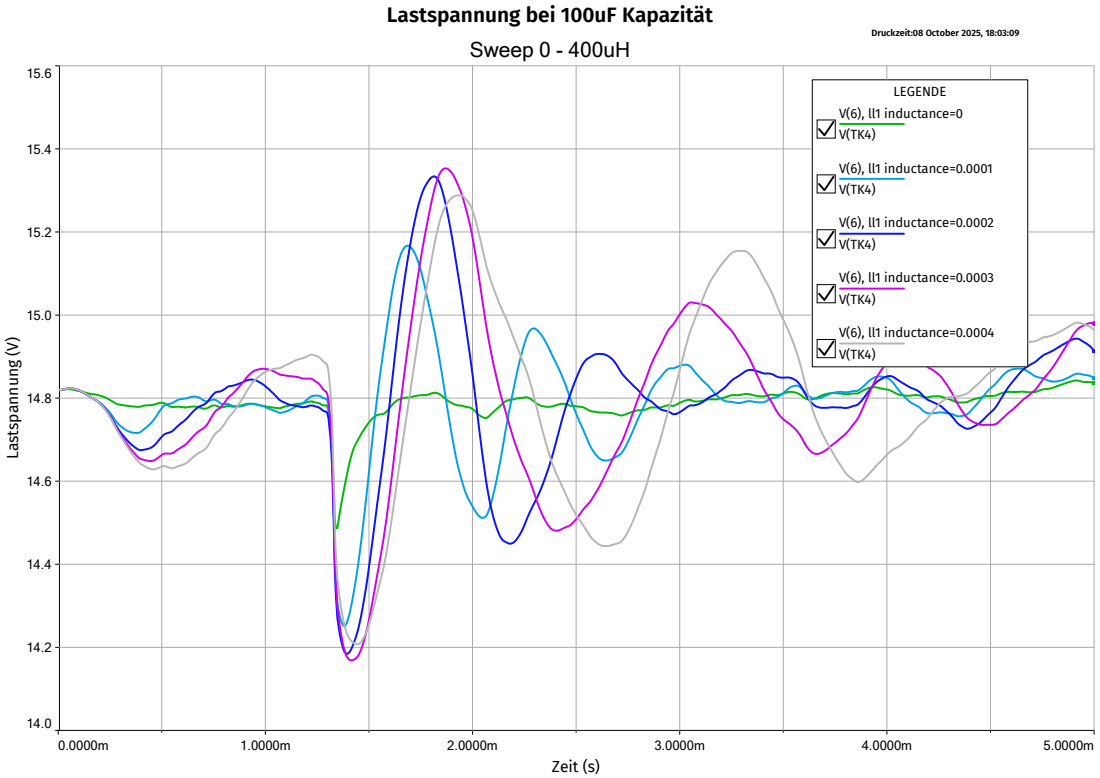
[picture p51: page 2]
5.0000m Lastspannung ⁽V⁾

V(6), ll1 inductance=0 V(TK4) | LEGENDE

V(6), ll1 inductance=0.0001 V(TK4) V(6), ll1 inductance=0.0002

V(TK4) V(6), ll1 inductance=0.0003 V(TK4)

V(6), ll1 inductance=0.0004 V(TK4)

## Lastspannung bei 200uF Kapazität

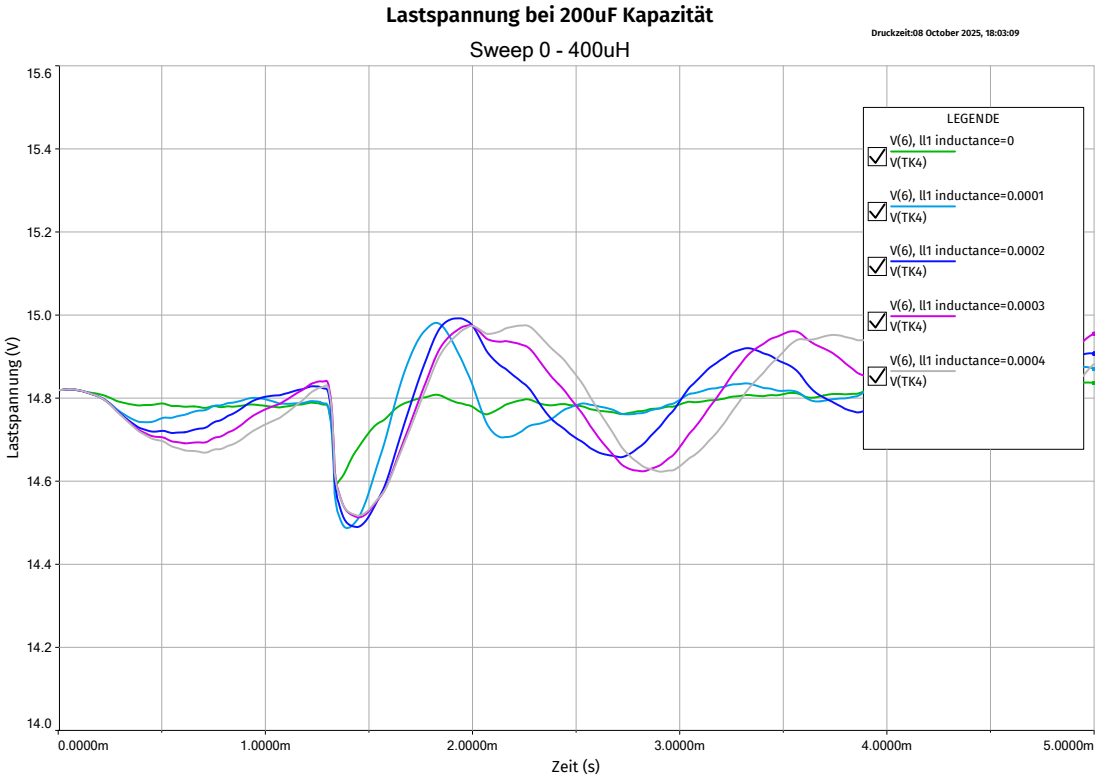
[picture p52: page 3]
5.0000m Lastspannung ⁽V⁾

LEGENDE V(6), ll1 inductance=0

V(TK4) V(6), ll1 inductance=0.0001 V(TK4)

V(6), ll1 inductance=0.0002 V(TK4) V(6), ll1 inductance=0.0003

V(TK4) V(6), ll1 inductance=0.0004 V(TK4)

## Lastspannung bei 300uF Kapazität

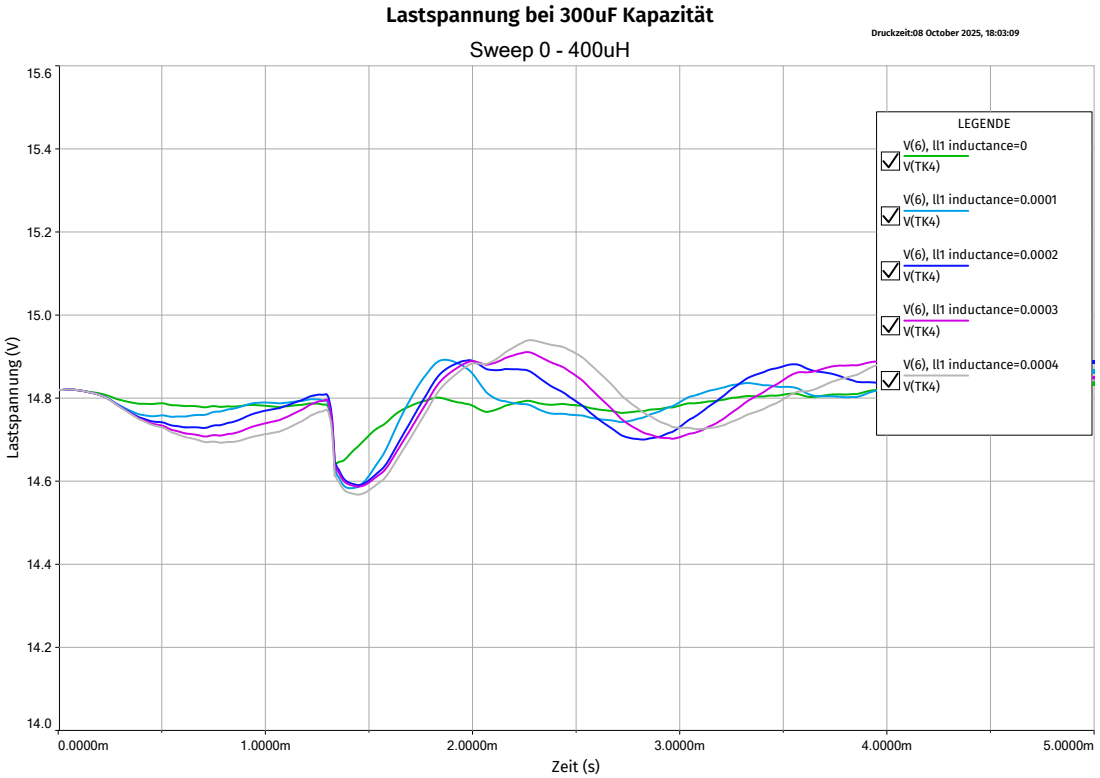
[picture p53: page 4]
5.0000m Lastspannung ⁽V⁾

LEGENDE V(6), ll1 inductance=0

V(TK4) V(6), ll1 inductance=0.0001 V(TK4)

V(6), ll1 inductance=0.0002 V(TK4) V(6), ll1 inductance=0.0003

V(TK4) V(6), ll1 inductance=0.0004 V(TK4)

## Speisestrom bei 0F Kapazität

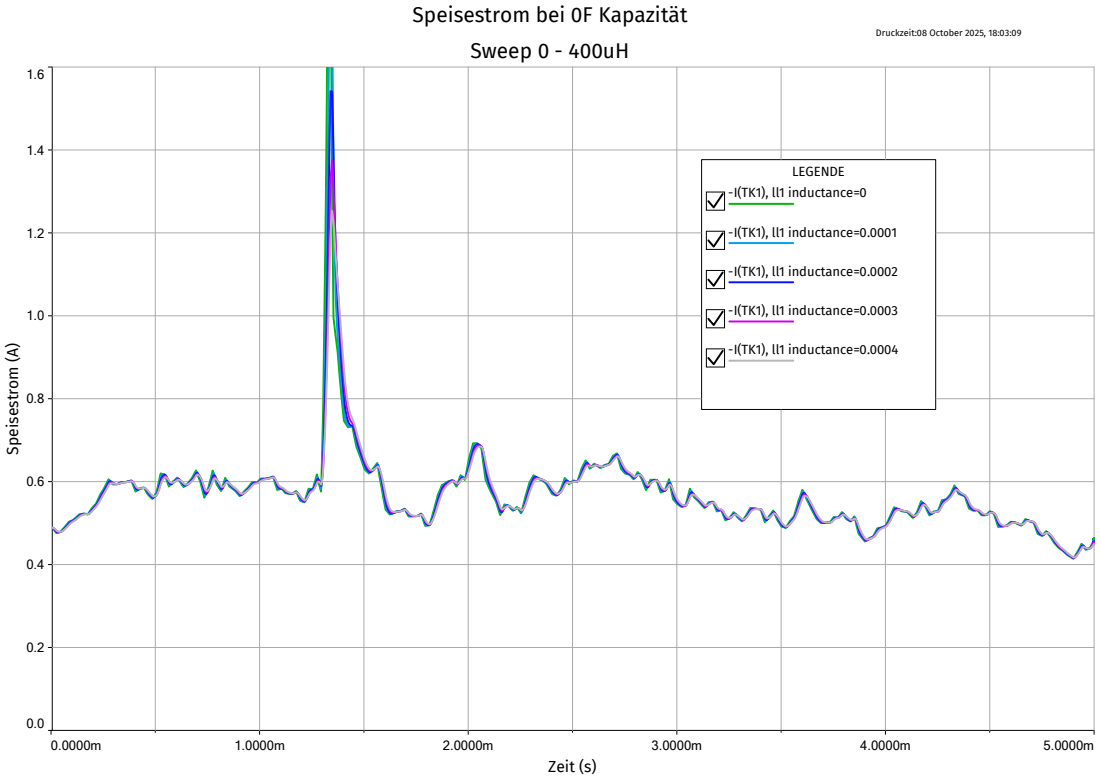
[picture p54: page 5]
5.0000m Speisestrom ⁽A⁾

-I(TK1), ll1 inductance=0 -I(TK1), ll1 inductance=0.0001 | LEGENDE

-I(TK1), ll1 inductance=0.0002 -I(TK1), ll1 inductance=0.0003

-I(TK1), ll1 inductance=0.0004

## Speisestrom bei 100uF Kapazität

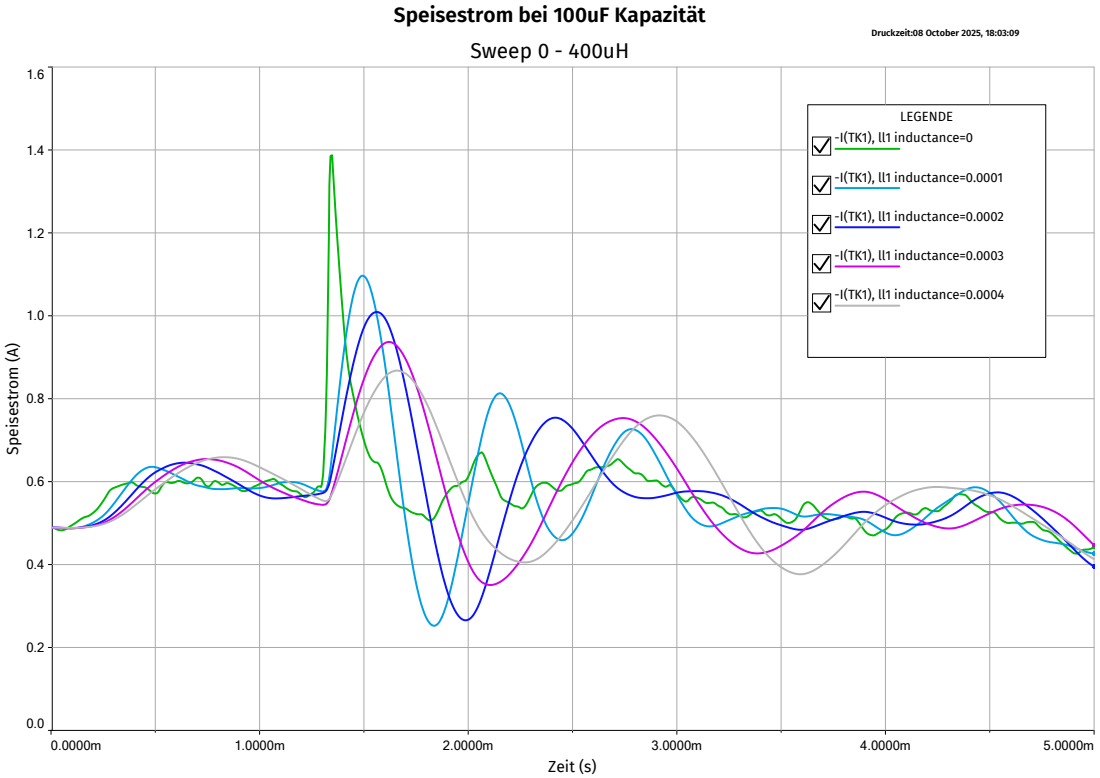
[picture p55: page 6]
5.0000m Speisestrom ⁽A⁾

-I(TK1), ll1 inductance=0 | LEGENDE

-I(TK1), ll1 inductance=0.0001 -I(TK1), ll1 inductance=0.0002

-I(TK1), ll1 inductance=0.0003 -I(TK1), ll1 inductance=0.0004

## Speisestrom bei 200uF Kapazität

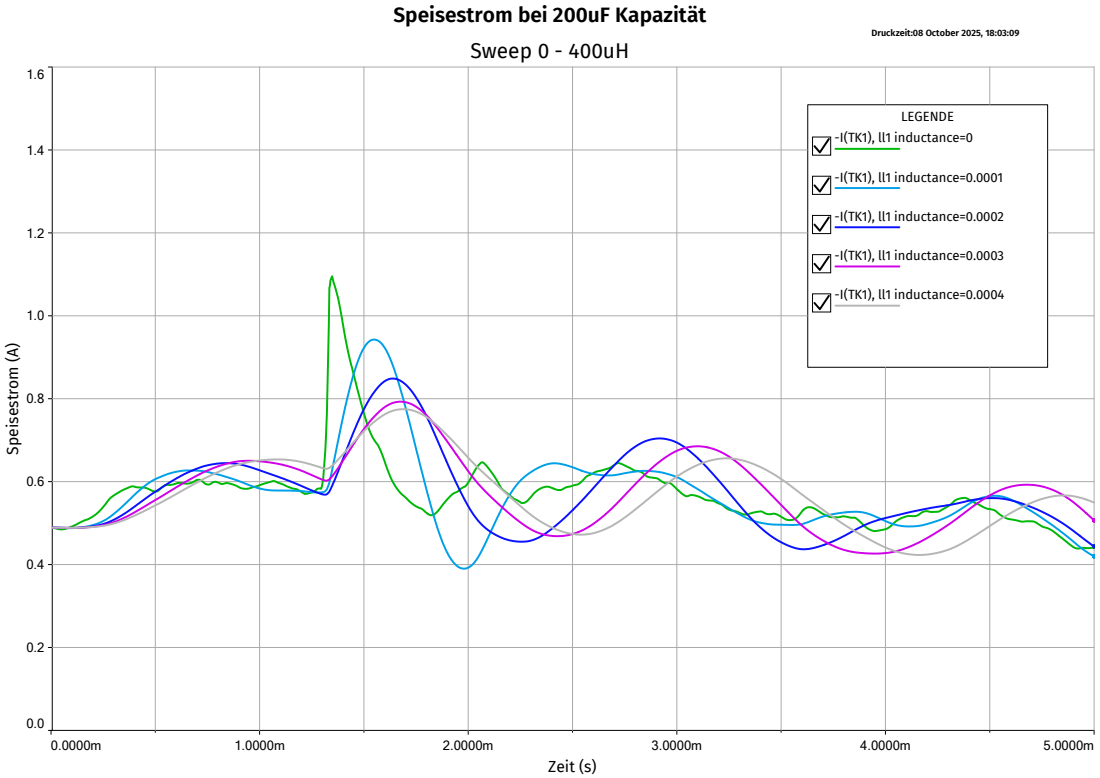
[picture p56: page 7]
5.0000m Speisestrom ⁽A⁾

-I(TK1), ll1 inductance=0 | LEGENDE

-I(TK1), ll1 inductance=0.0001 -I(TK1), ll1 inductance=0.0002

-I(TK1), ll1 inductance=0.0003 -I(TK1), ll1 inductance=0.0004

## Speisestrom bei 300uF Kapazität

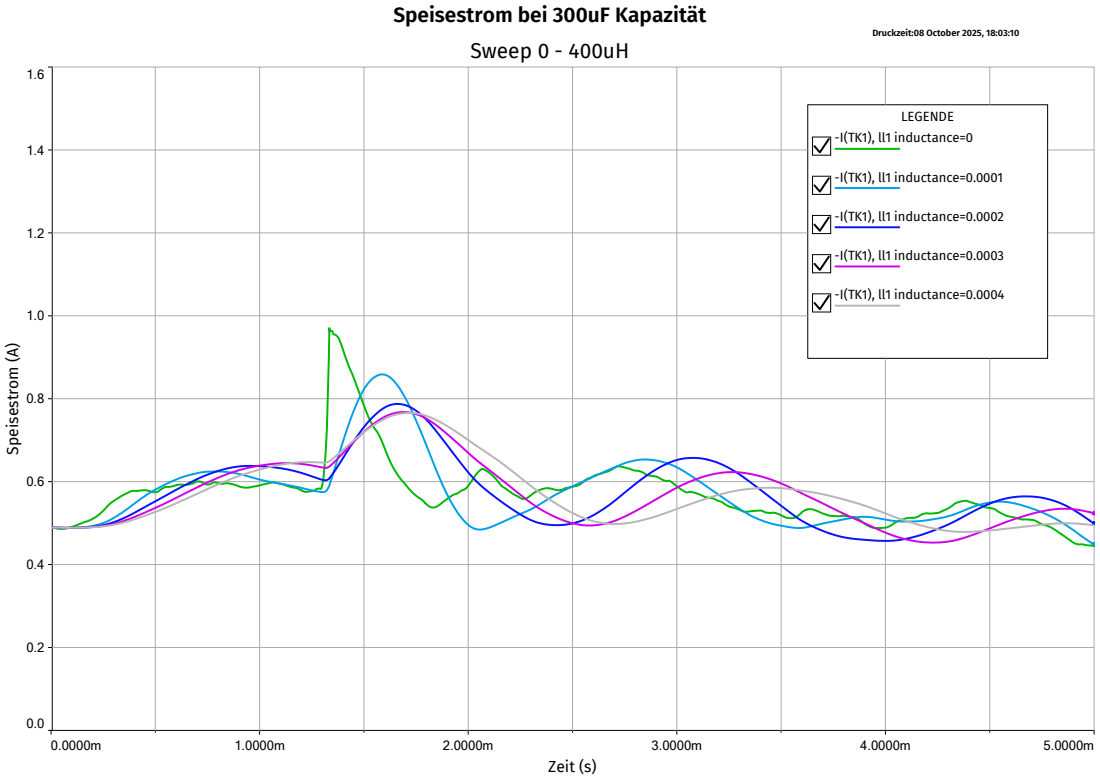
[picture p57: page 8]
Druckzeit:08 October 2025, 18:03:10; 5.0000m Speisestrom ⁽A⁾

-I(TK1), ll1 inductance=0 | LEGENDE

-I(TK1), ll1 inductance=0.0001 -I(TK1), ll1 inductance=0.0002

-I(TK1), ll1 inductance=0.0003 -I(TK1), ll1 inductance=0.0004

## Speisestrom bei 400uF Kapazität

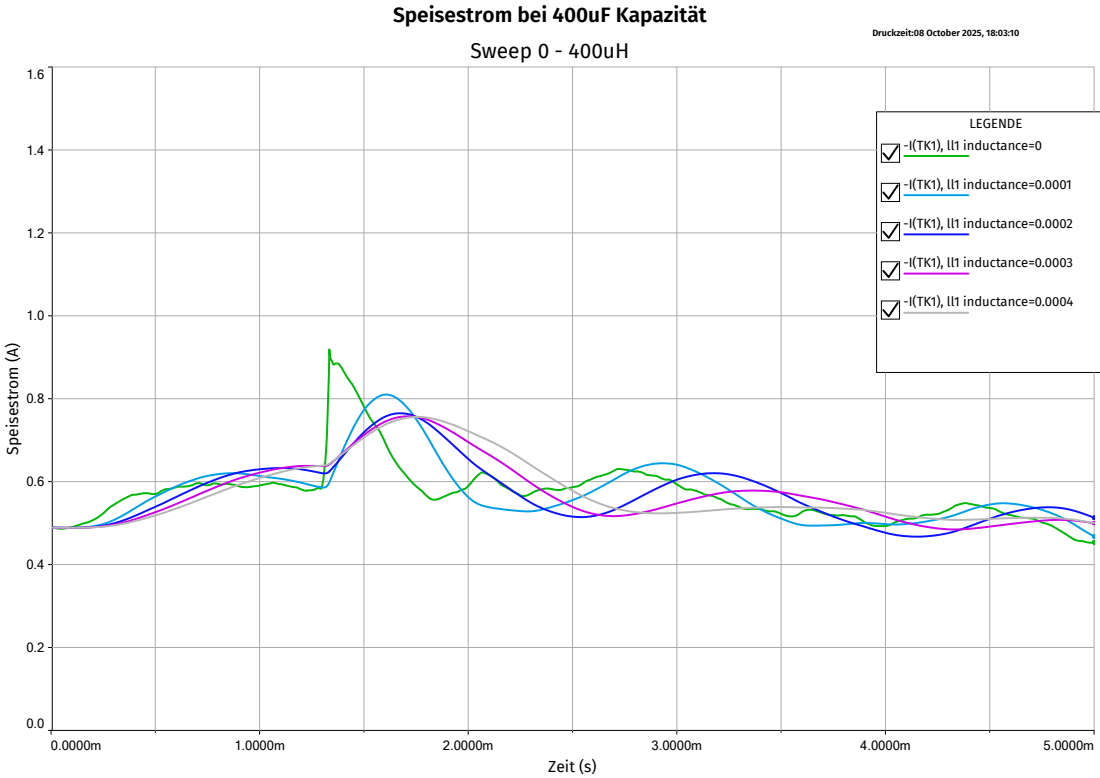
[picture p58: page 9]
Druckzeit:08 October 2025, 18:03:10; 5.0000m Speisestrom ⁽A⁾

LEGENDE -I(TK1), ll1 inductance=0

-I(TK1), ll1 inductance=0.0001 -I(TK1), ll1 inductance=0.0002

-I(TK1), ll1 inductance=0.0003 -I(TK1), ll1 inductance=0.0004

## Lastspannung bei 400uF

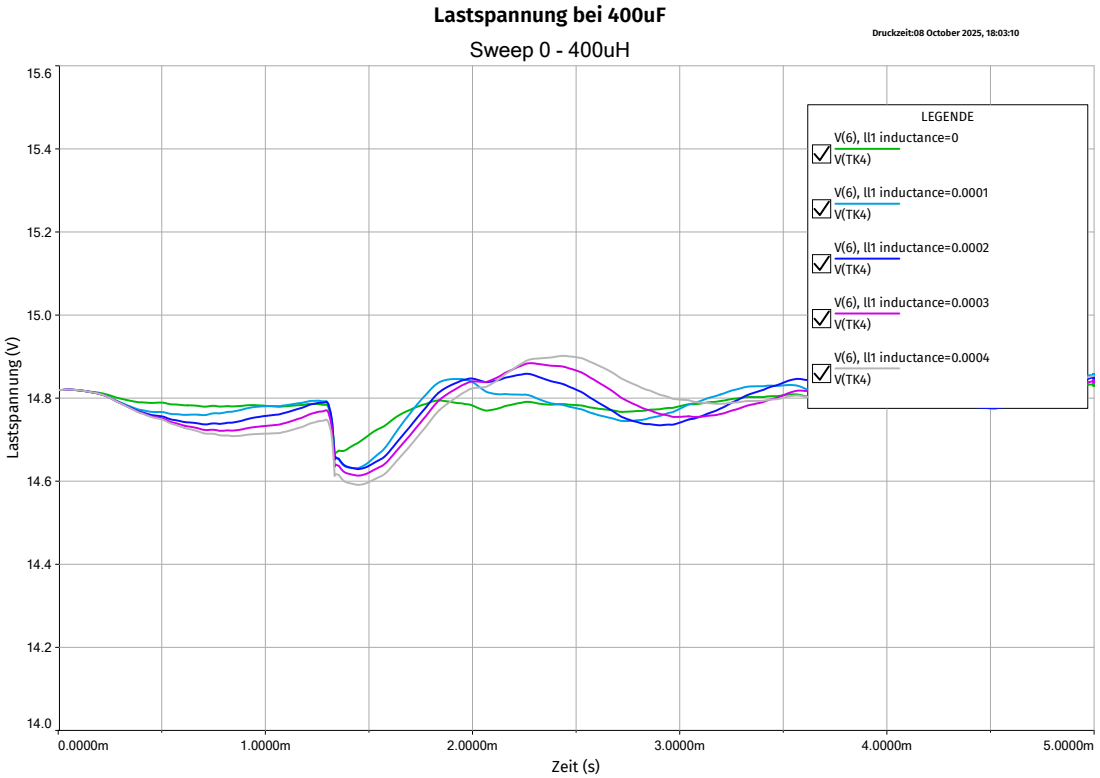
[picture p59: page 10]
Druckzeit:08 October 2025, 18:03:10; 5.0000m Lastspannung ⁽V⁾

V(6), ll1 inductance=0 | LEGENDE

V(TK4) V(6), ll1 inductance=0.0001 V(TK4)

V(6), ll1 inductance=0.0002 V(TK4) V(6), ll1 inductance=0.0003

V(TK4) V(6), ll1 inductance=0.0004 V(TK4)
