Violabitch5/Nathophone_elec/USBtoI2S_board/nathophone_USBtoI2S/nathophone_USBtoI2S.pdf

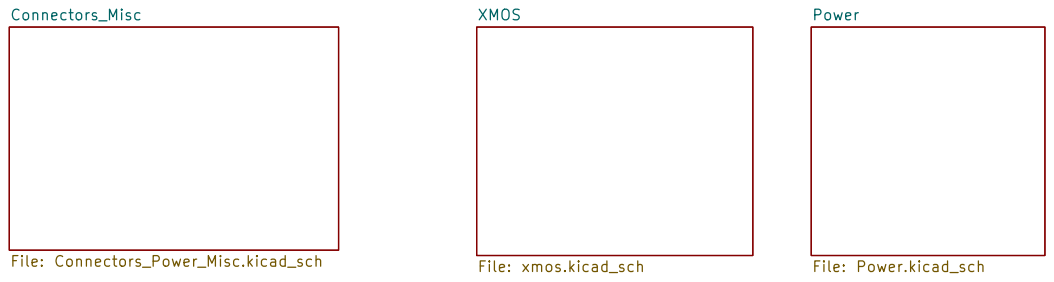
[picture p60: page 1]

Size: A4 | Rev:
KiCad E.D.A. 10.0.3 | Id: 1/4

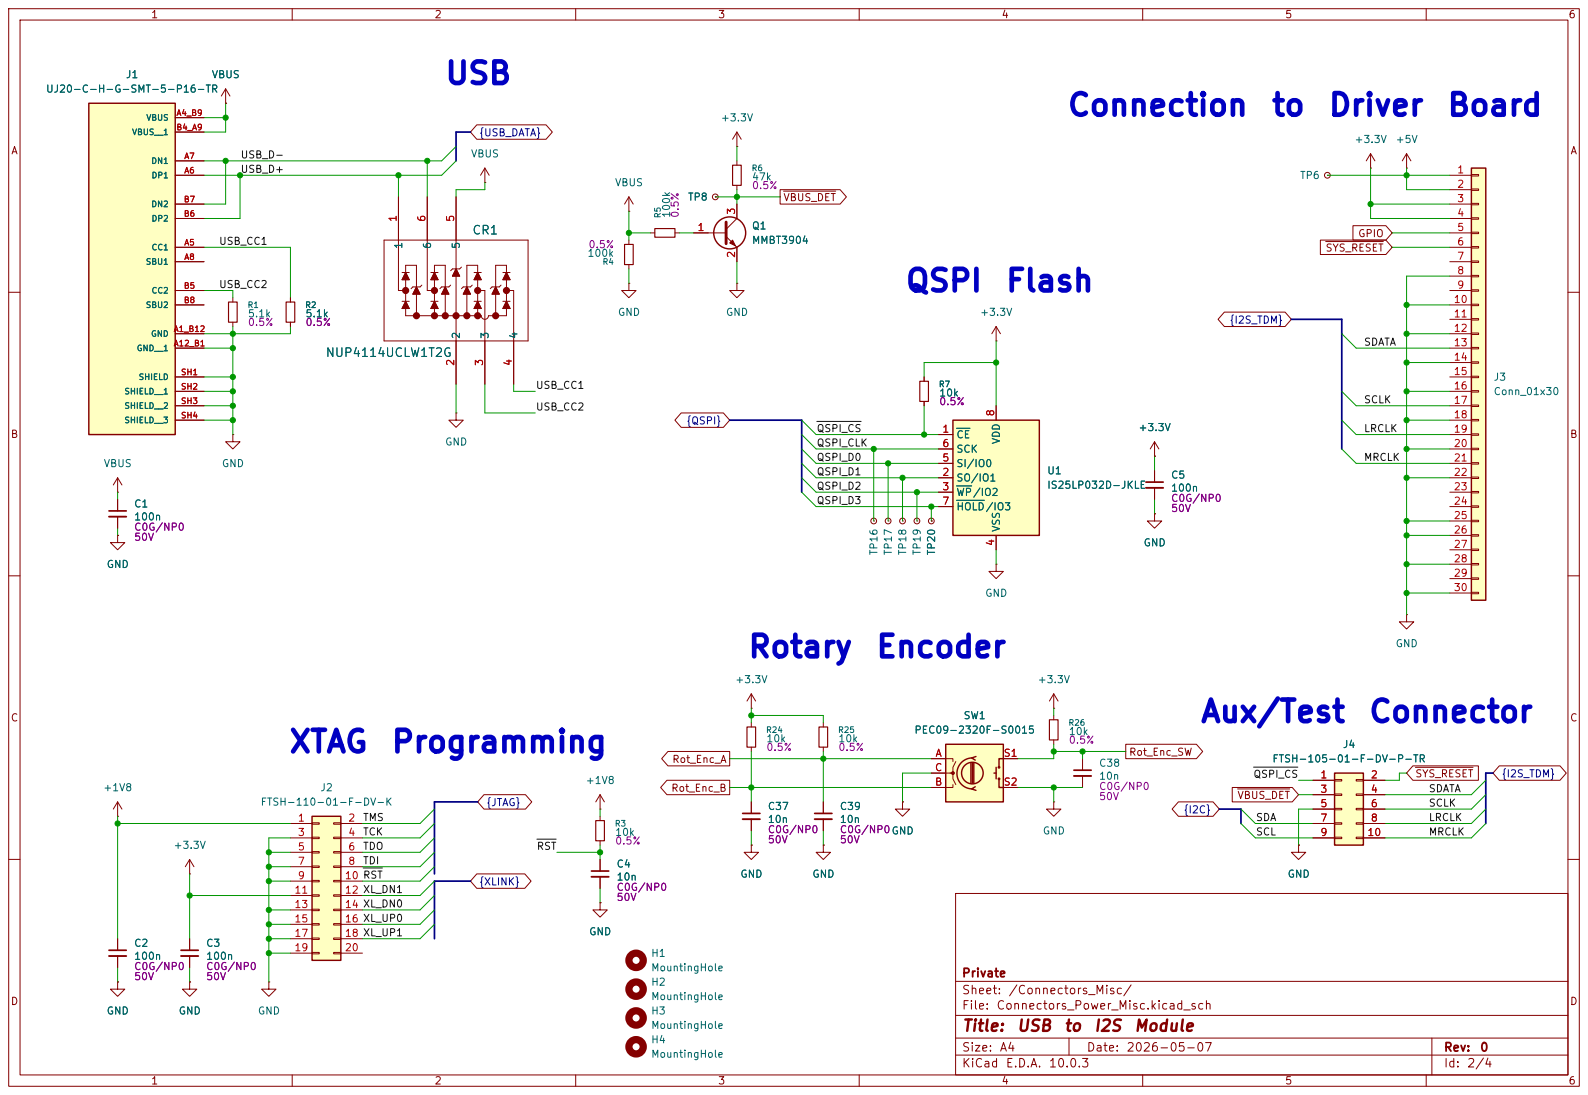
[picture p61: page 2]

Connection to Driver Board

LRCLK MRCLK Rotary Encoder

3 | 4 TCK
5 | 6 TDI TDO

15 | 16 XL_UP0
17 | 18

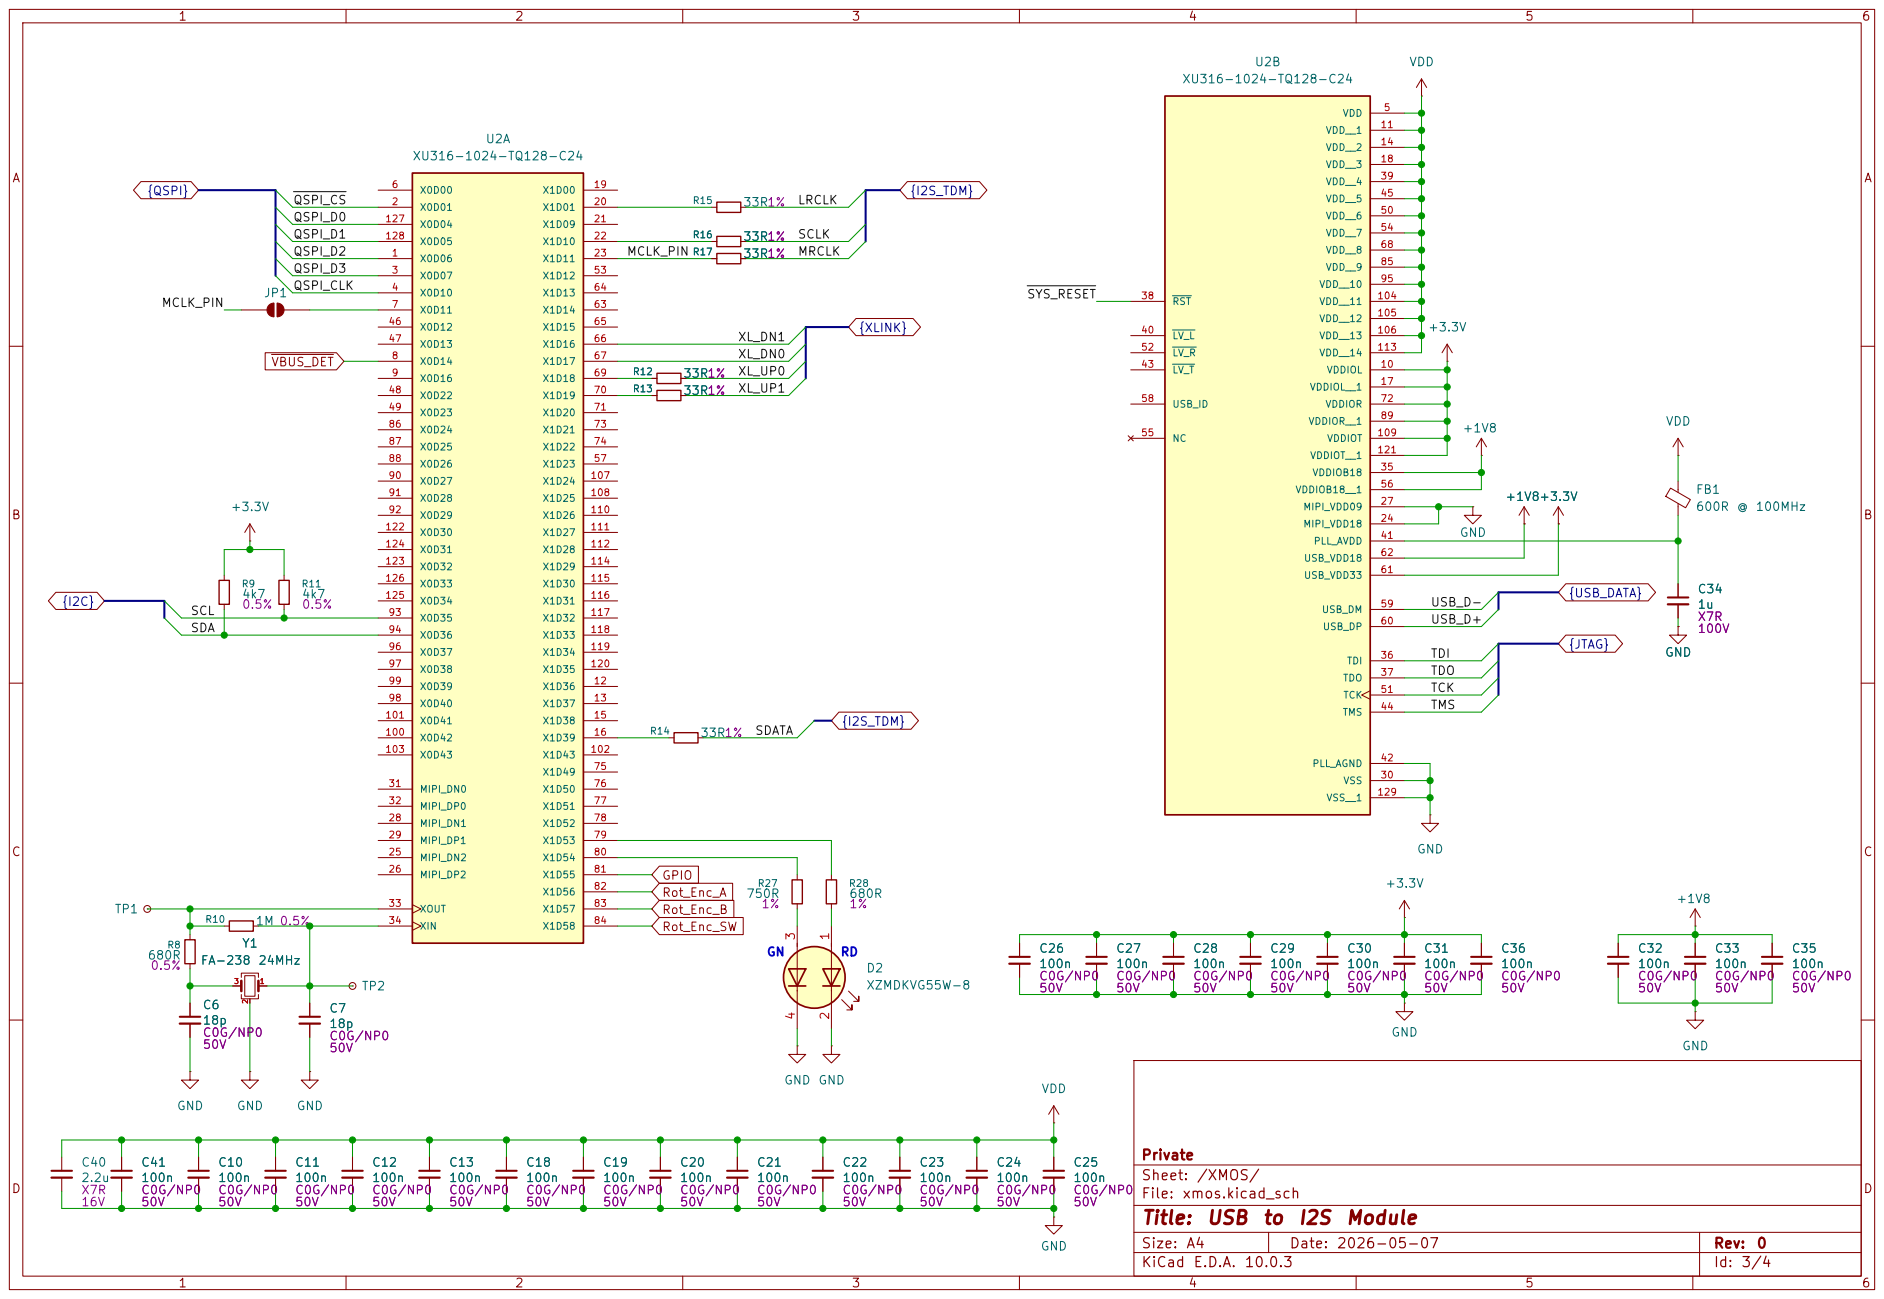
[picture p62: page 3]

File: xmos.kicad_sch
Title: USB to I2S Module

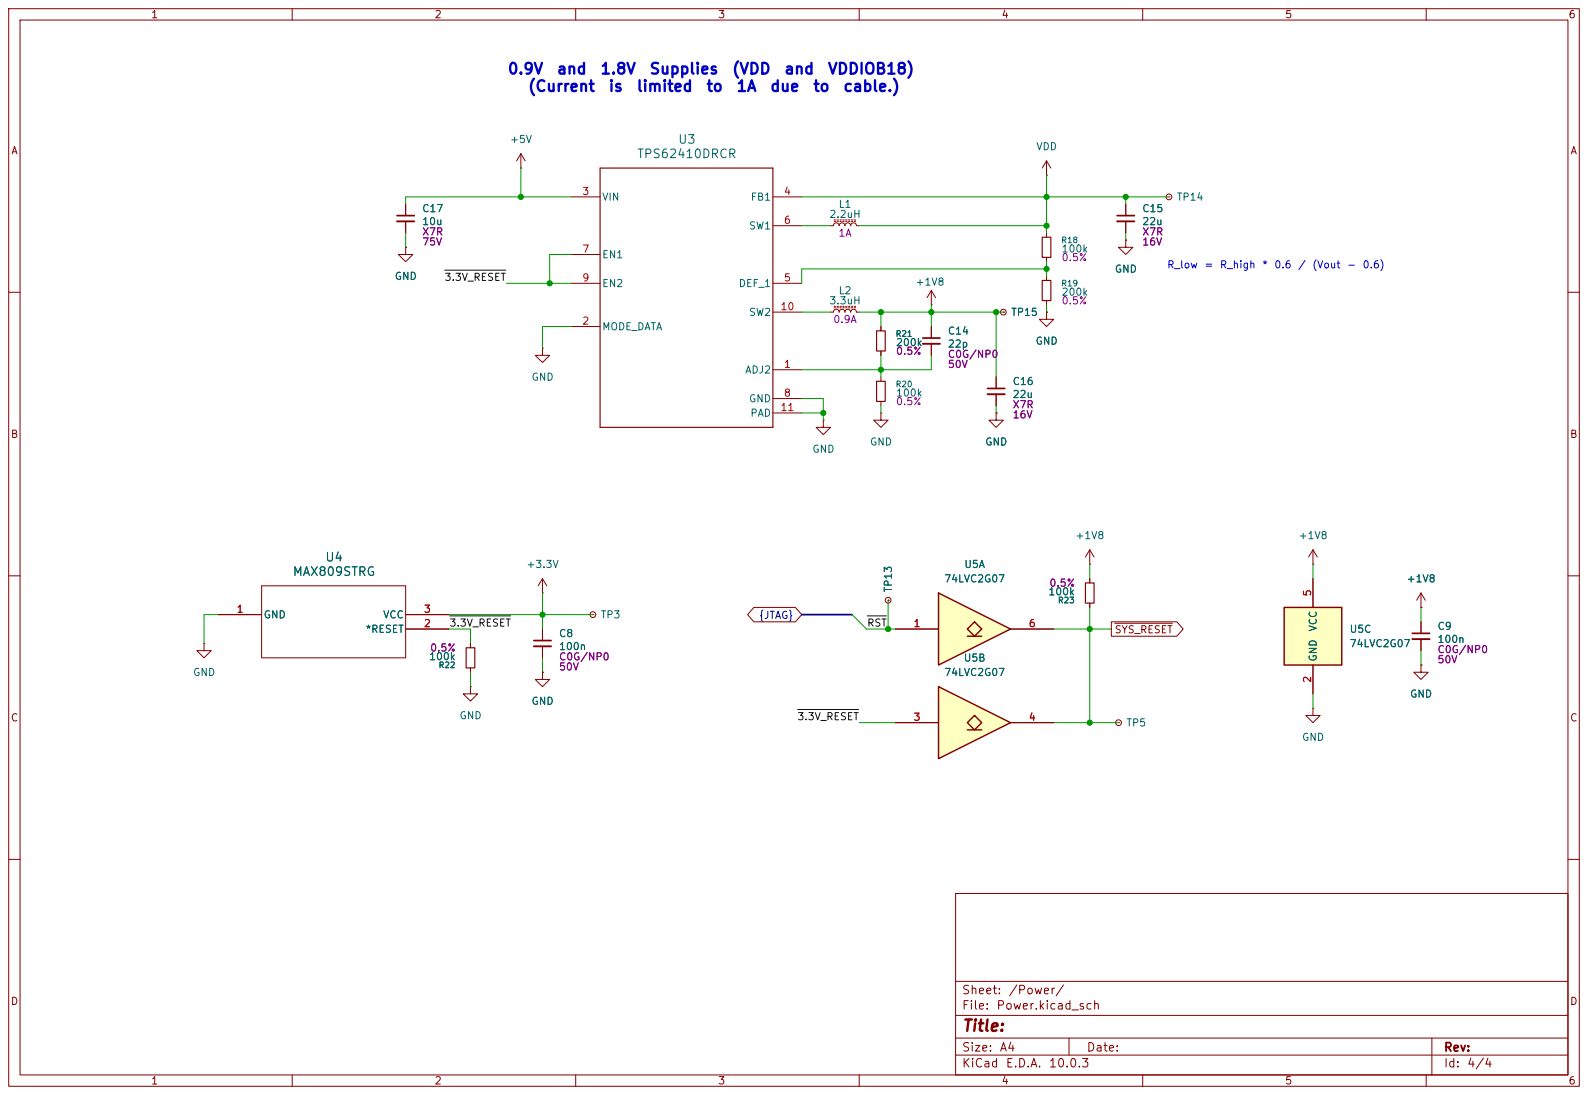
[picture p63: page 4]

(Current is limited to 1A due to cable.)
