Violabitch5/Nathophone_elec/simulations/TDM_simulationwithoutTermination.pdf

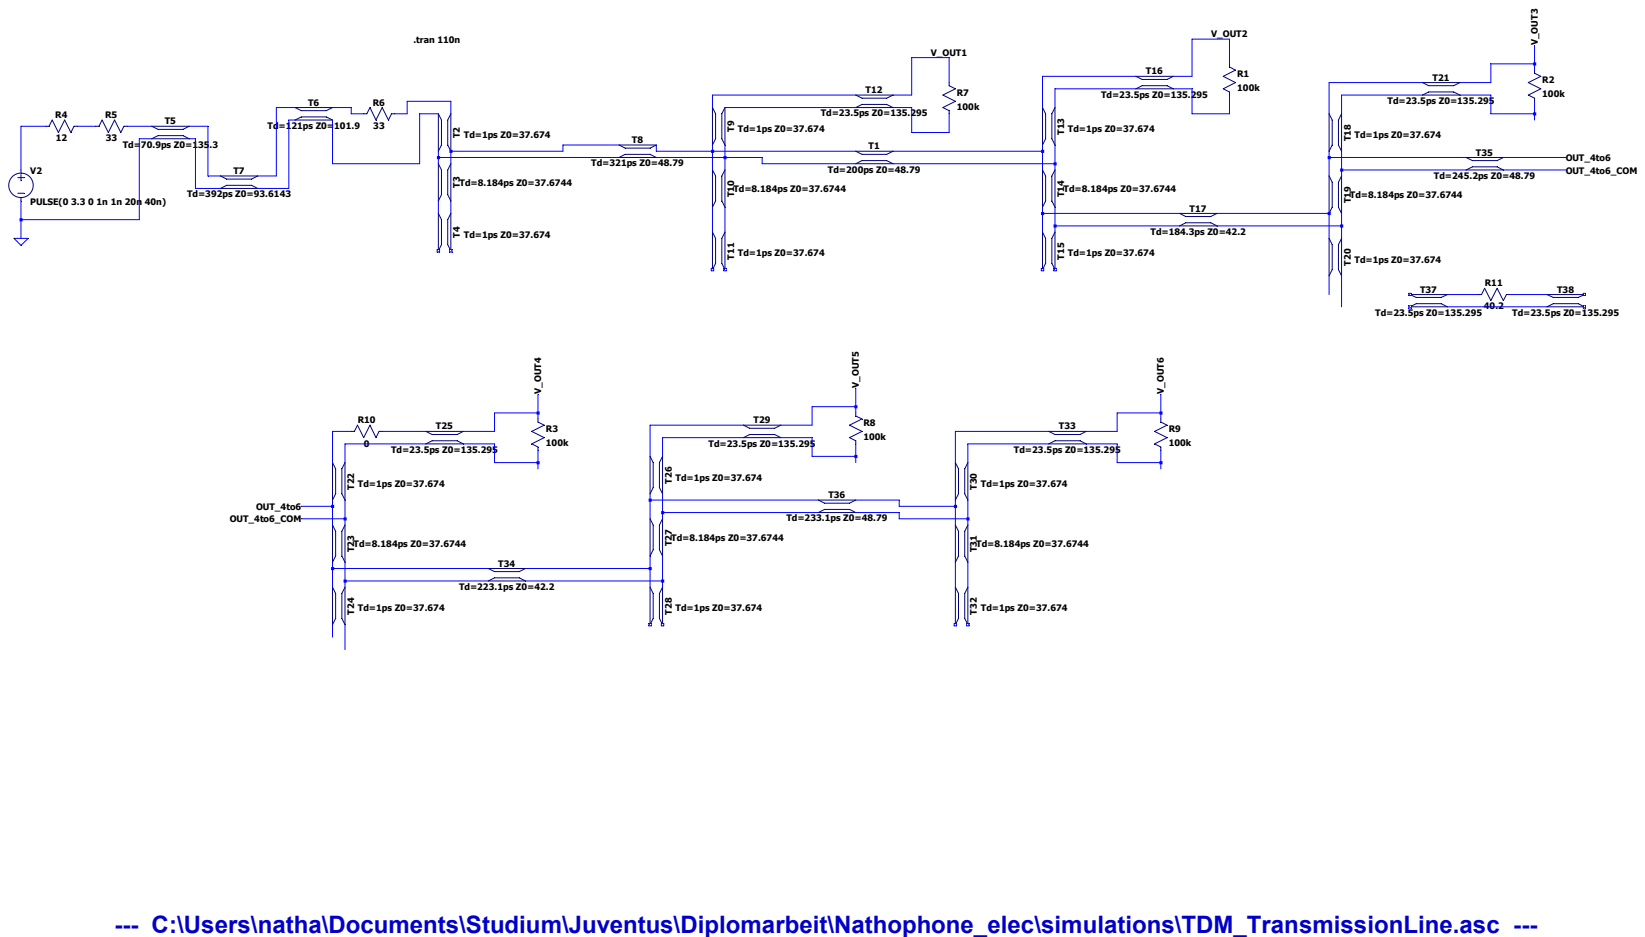
[picture p64: page 1]

--- C:\Users\natha\Documents\Studium\Juventus\Diplomarbeit\Nathophone_elec\simulations\TDM_TransmissionLine.asc ---
