Violabitch5/Nathophone_elec/simulations/TDM_simulationwithTermination.pdf

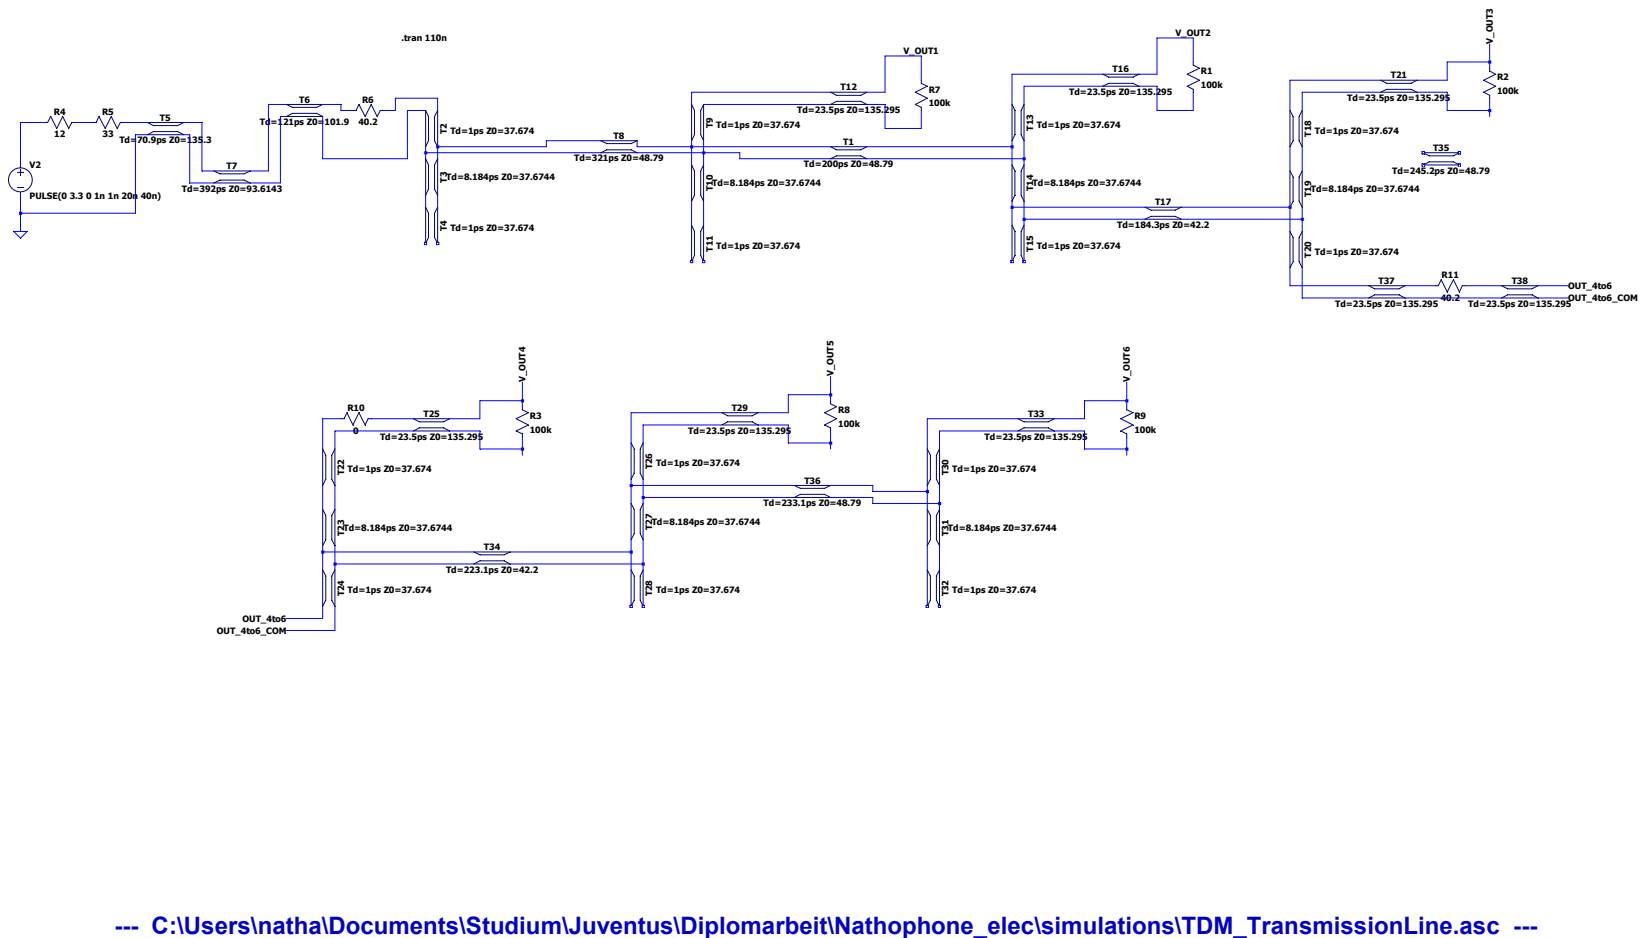
[picture p65: page 1]

--- C:\Users\natha\Documents\Studium\Juventus\Diplomarbeit\Nathophone_elec\simulations\TDM_TransmissionLine.asc ---
