Violabitch5/Nathophone_elec/simulations/TDM_withoutTermination.pdf

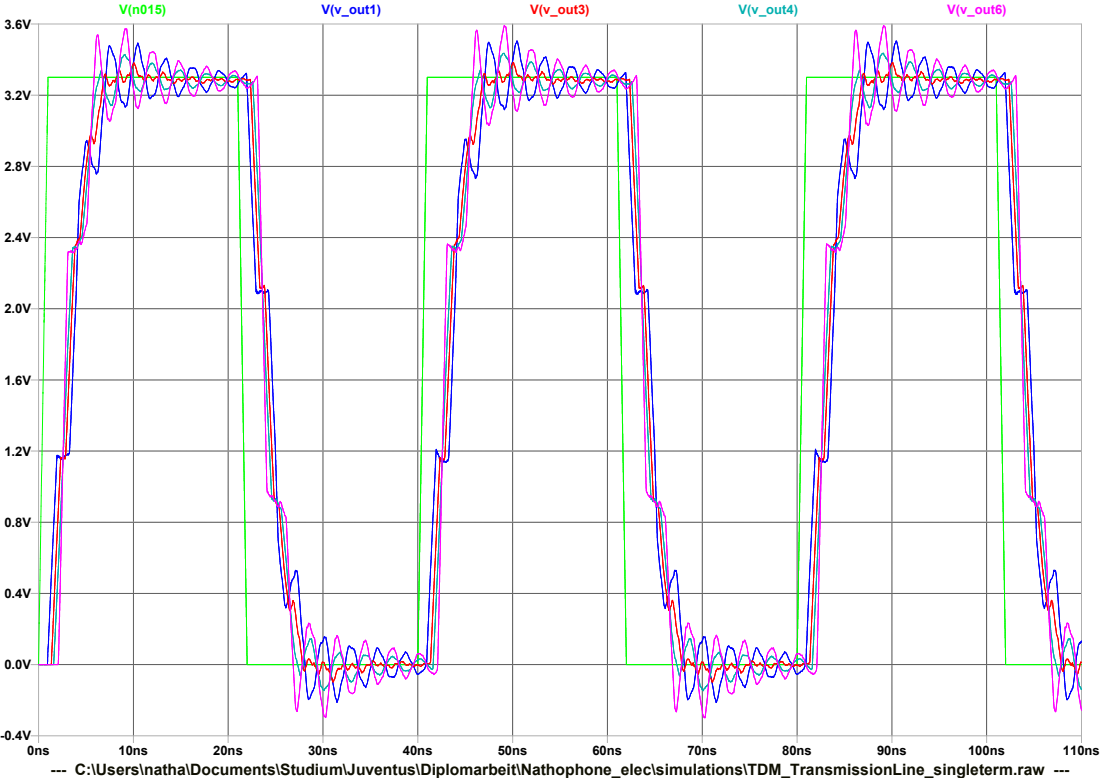
[picture p66: page 1]
V(v_out1); V(v_out3); V(v_out4); V(v_out6)

--- C:\Users\natha\Documents\Studium\Juventus\Diplomarbeit\Nathophone_elec\simulations\TDM_TransmissionLine_singleterm.raw ---
