Violabitch5/Nathophone_elec/simulations/startup_Schaltregler_noSnubber_L2_10uH.pdf

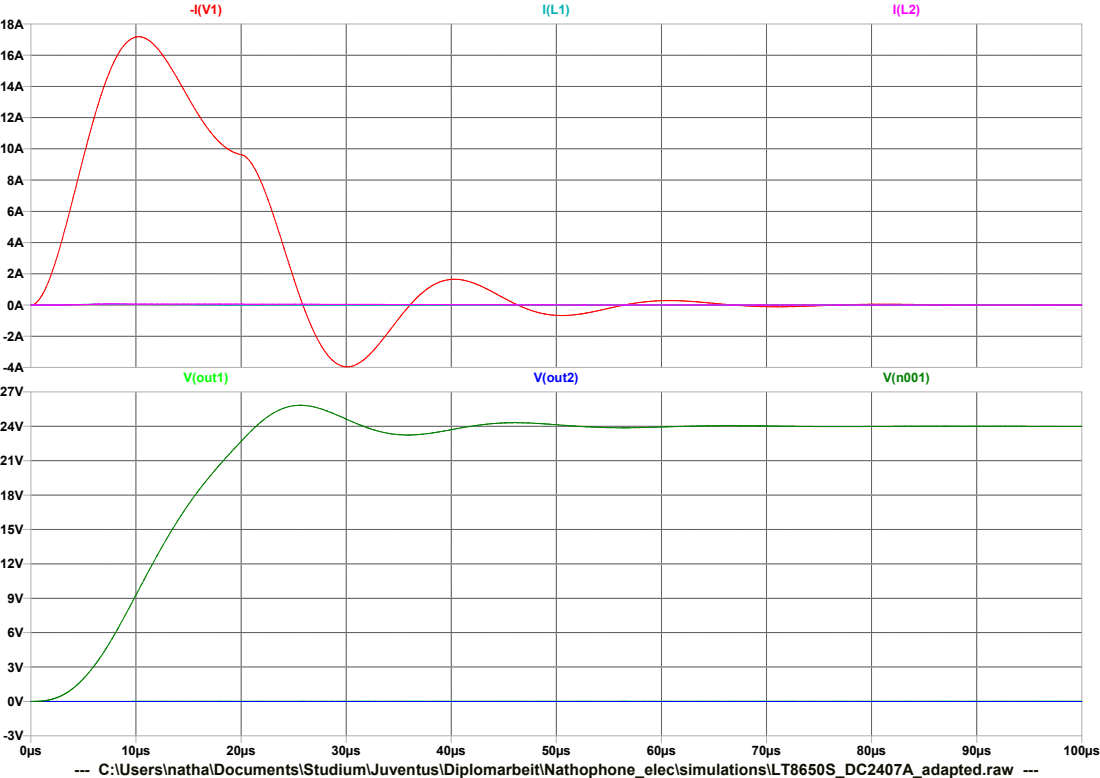
[picture p67: page 1]
V(out1); V(out2)

--- C:\Users\natha\Documents\Studium\Juventus\Diplomarbeit\Nathophone_elec\simulations\LT8650S_DC2407A_adapted.raw ---
