Violabitch5/Nathophone_elec/simulations/TDMClockTransient_withoutTermination.pdf

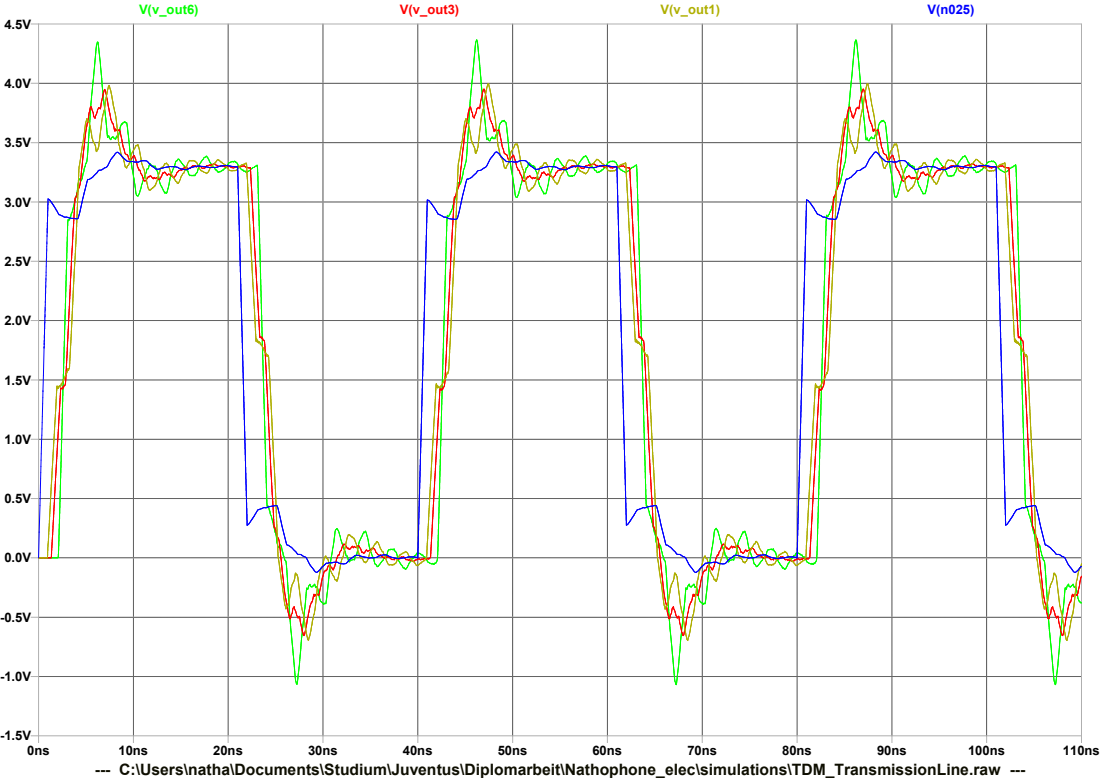
[picture p69: page 1]
V(v_out6); V(v_out3); V(v_out1)

--- C:\Users\natha\Documents\Studium\Juventus\Diplomarbeit\Nathophone_elec\simulations\TDM_TransmissionLine.raw ---
