Violabitch5/Nathophone_elec/simulations/Schaltregler_15V_5V_2.2A_1A_24Vin.pdf

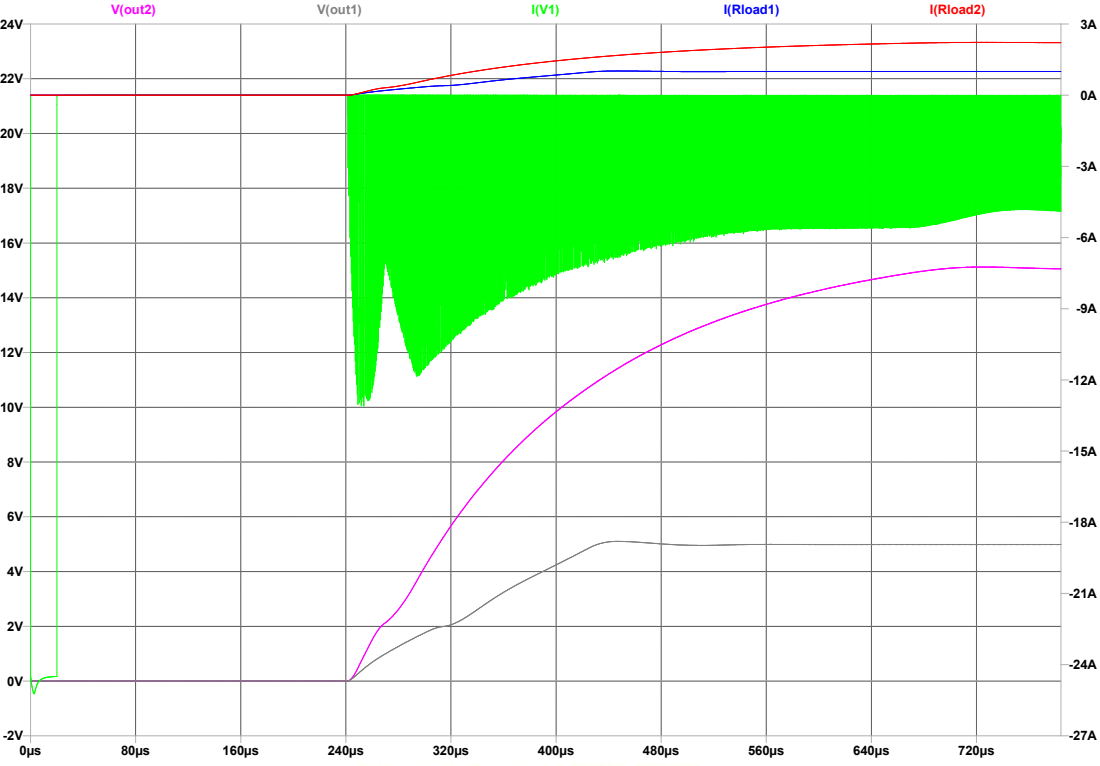
[picture p70: page 1]
V(out2); V(out1); I(Rload1); I(Rload2)

--- C:\Users\natha\Downloads\LT8650S_DC2407A.raw ---
