Violabitch5/Nathophone_elec/simulations/LT8650S_DC2407A_adapted.asc

C1: cap; 4.7µ; V=50 Rser=50m
C2: cap; 4.7µ; V=50 Rser=50m
C3: cap; 220p
C4: cap; 47µ; V=10 Irms=11.7 Rser=0.003 Lser=0
C5: cap; 47µ; V=10 Irms=11.7 Rser=0.003
C6: cap; 4.7p
C7: cap; 220p
C8: cap; 47µ; V=10 Irms=11.7 Rser=10m
C9: cap; 47µ; V=10 Irms=11.7 Rser=10m
C10: cap; 400µ; V=10 Irms=11.7 Rser=20m
C11: cap; 1n
C12: cap; 1n
C13: cap; 1µ
C14: cap; 400µ; V=10 Irms=11.7 Rser=20m
C15: cap; 400µ; V=10 Irms=11.7 Rser=20m
C16: cap; 47µ; V=50 Rser=50m
L1: ind; 1µ; Rser=10m; Ipk=4.9 Rser=0.014 Cpar=0
L2: ind; 10µ; Rser=10m; Ipk=9.5 Rser=0.0162 Cpar=0
L3: ind; 150µ; Rser=10m; Ipk=6.5 Rser=0.355 Cpar=0
L4: ind; 1µ; Rser=10m; Ipk=9.5 Rser=0.05 Cpar=0
L5: ind; 150µ; Rser=10m; Ipk=6.5 Rser=0.355 Cpar=0
L6: ind; 150µ; Rser=10m; Ipk=6.5 Rser=0.355 Cpar=0
R1: res; 1Meg
R2: res; 178K
R3: res; 1Meg
R4: res; 56k
R5: res; 15k
R6: res; 14k
R7: res; 14k
R8: res; 0.5
Rload1: res; 5
Rload2: res; 20.4
Rload3: res; 20.4
Rload4: res; 20.4
U1: LT8650S
V1: voltage; 24; Rser=0.1
Named nets: 0, OUT2, IN, OUT1, PG_1
fsw=2MHz
LT8650S - Dual Channel 42V, 4A Synchronous Step-Down Silent Switcher 2 with 6.2µA Quiescent Current
 2MHz Step-Down Converter
Input: 5.4V to 42V
Note:
  If the simulation model is not found please update with the "Sync Release" command from the "Tools" menu.
  It remains the customer's responsibility to verify proper and reliable operation in the actual application.
  Component substitution and printed circuit board layout may significantly affect circuit performance or reliability.
  Contact your local sales representative for assistance. This circuit is distributed to customers only for use with LTC parts.
  Copyright © 2017 Linear Technology Inc. All rights reserved.
.tran 0 5.4m 0.6m steady startup
5V/1A
15V/2.2A
