Violabitch5/Nathophone_elec/simulations/TDM_TransmissionLine_doubleterm.asc

R1: res; 100k
R2: res; 100k
R3: res; 100k
R4: res; 12
R5: res; 33
R6: res; 40.2
R7: res; 100k
R8: res; 100k
R9: res; 100k
R10: res; 0
R11: res; 40.2
T1: tline; Td=200ps Z0=48.79
T2: tline; Td=1ps Z0=37.674
T3: tline; Td=8.184ps Z0=37.6744
T4: tline; Td=1ps Z0=37.674
T5: tline; Td=70.9ps Z0=135.3
T6: tline; Td=121ps Z0=101.9
T7: tline; Td=392ps Z0=93.6143
T8: tline; Td=321ps Z0=48.79
T9: tline; Td=1ps Z0=37.674
T10: tline; Td=8.184ps Z0=37.6744
T11: tline; Td=1ps Z0=37.674
T12: tline; Td=23.5ps Z0=135.295
T13: tline; Td=1ps Z0=37.674
T14: tline; Td=8.184ps Z0=37.6744
T15: tline; Td=1ps Z0=37.674
T16: tline; Td=23.5ps Z0=135.295
T17: tline; Td=184.3ps Z0=42.2
T18: tline; Td=1ps Z0=37.674
T19: tline; Td=8.184ps Z0=37.6744
T20: tline; Td=1ps Z0=37.674
T21: tline; Td=23.5ps Z0=135.295
T22: tline; Td=1ps Z0=37.674
T23: tline; Td=8.184ps Z0=37.6744
T24: tline; Td=1ps Z0=37.674
T25: tline; Td=23.5ps Z0=135.295
T26: tline; Td=1ps Z0=37.674
T27: tline; Td=8.184ps Z0=37.6744
T28: tline; Td=1ps Z0=37.674
T29: tline; Td=23.5ps Z0=135.295
T30: tline; Td=1ps Z0=37.674
T31: tline; Td=8.184ps Z0=37.6744
T32: tline; Td=1ps Z0=37.674
T33: tline; Td=23.5ps Z0=135.295
T34: tline; Td=223.1ps Z0=42.2
T35: tline; Td=245.2ps Z0=48.79
T36: tline; Td=233.1ps Z0=48.79
T37: tline; Td=23.5ps Z0=135.295
T38: tline; Td=23.5ps Z0=135.295
V2: voltage; PULSE(0 3.3 0 1n 1n 20n 40n)
Named nets: 0, V_OUT1, V_OUT2, V_OUT3, V_OUT4, V_OUT5, V_OUT6, OUT_4to6, OUT_4to6_COM
.tran 110n
