Violabitch5/Nathophone_elec/simulations/LT8650S_DC2407A.asc

C1: cap; 10µ; V=50
C2: cap; 10µ; V=50
C4: cap; 47µ; V=10 Irms=11.7 Rser=0.003 Lser=0
C5: cap; 47µ; V=10 Irms=11.7 Rser=0.003
C6: cap; 4.7p
C7: cap; 4.7p
C8: cap; 47µ; V=10 Irms=11.7 Rser=10m
C9: cap; 47µ; V=10 Irms=11.7 Rser=10m
C11: cap; 1n
C12: cap; 1n
C13: cap; 1µ
L1: ind; 1µ; Rser=10m; Ipk=6.5 Rser=0.0042 Cpar=0
L2: ind; 1µ; Rser=10m; Ipk=6.5 Rser=0.0042 Cpar=0
R1: res; 1Meg
R2: res; 191K
R3: res; 1Meg
R4: res; 316K
R5: res; 15K
Rload1: res; 1.25
Rload2: res; 0.825
U1: LT8650S
V1: voltage; 12
Named nets: 0, OUT2, IN, OUT1
fsw=2MHz
LT8650S - Dual Channel 42V, 4A Synchronous Step-Down Silent Switcher 2 with 6.2µA Quiescent Current
 2MHz Step-Down Converter
Input: 5.4V to 42V     Output: 5V @ 4A & 3.3V @ 4A
Note:
  If the simulation model is not found please update with the "Sync Release" command from the "Tools" menu.
  It remains the customer's responsibility to verify proper and reliable operation in the actual application.
  Component substitution and printed circuit board layout may significantly affect circuit performance or reliability.
  Contact your local sales representative for assistance. This circuit is distributed to customers only for use with LTC parts.
  Copyright © 2017 Linear Technology Inc. All rights reserved.
.tran 0.6m startup
5V/4A
3.3V/4A
