Violabitch5/Nathophone_elec/(list of files, drawings)

Other design files:
simulations/SupplyCap_15V.ms14
USBtoI2S_board/XK-AUDIO-316-MC-AB-Design-Files/Schematic/ADC.SchDoc
USBtoI2S_board/XK-AUDIO-316-MC-AB-Design-Files/Schematic/Clocks.SchDoc
USBtoI2S_board/XK-AUDIO-316-MC-AB-Design-Files/Schematic/DAC.SchDoc
USBtoI2S_board/XK-AUDIO-316-MC-AB-Design-Files/Schematic/DigitalIO.SchDoc
USBtoI2S_board/XK-AUDIO-316-MC-AB-Design-Files/Schematic/Power.SchDoc
USBtoI2S_board/XK-AUDIO-316-MC-AB-Design-Files/Schematic/Top Level.SchDoc
USBtoI2S_board/XK-AUDIO-316-MC-AB-Design-Files/Schematic/XMOS.SchDoc
USBtoI2S_board/XK-AUDIO-316-MC-AB-Design-Files/Schematic/XTAG4.SchDoc
USBtoI2S_board/XK-AUDIO-316-MC-AB-Design-Files/XMS0004.PrjPcb
