Violabitch5/Nathophone_elec/USBtoI2S_board/nathophone_USBtoI2S/nathophone_USBtoI2S_compatkicad9.kicad_pcb

## KiCad design USBtoI2S_board/nathophone_USBtoI2S/nathophone_USBtoI2S_compatkicad9.kicad_pcb (2026-10-13)

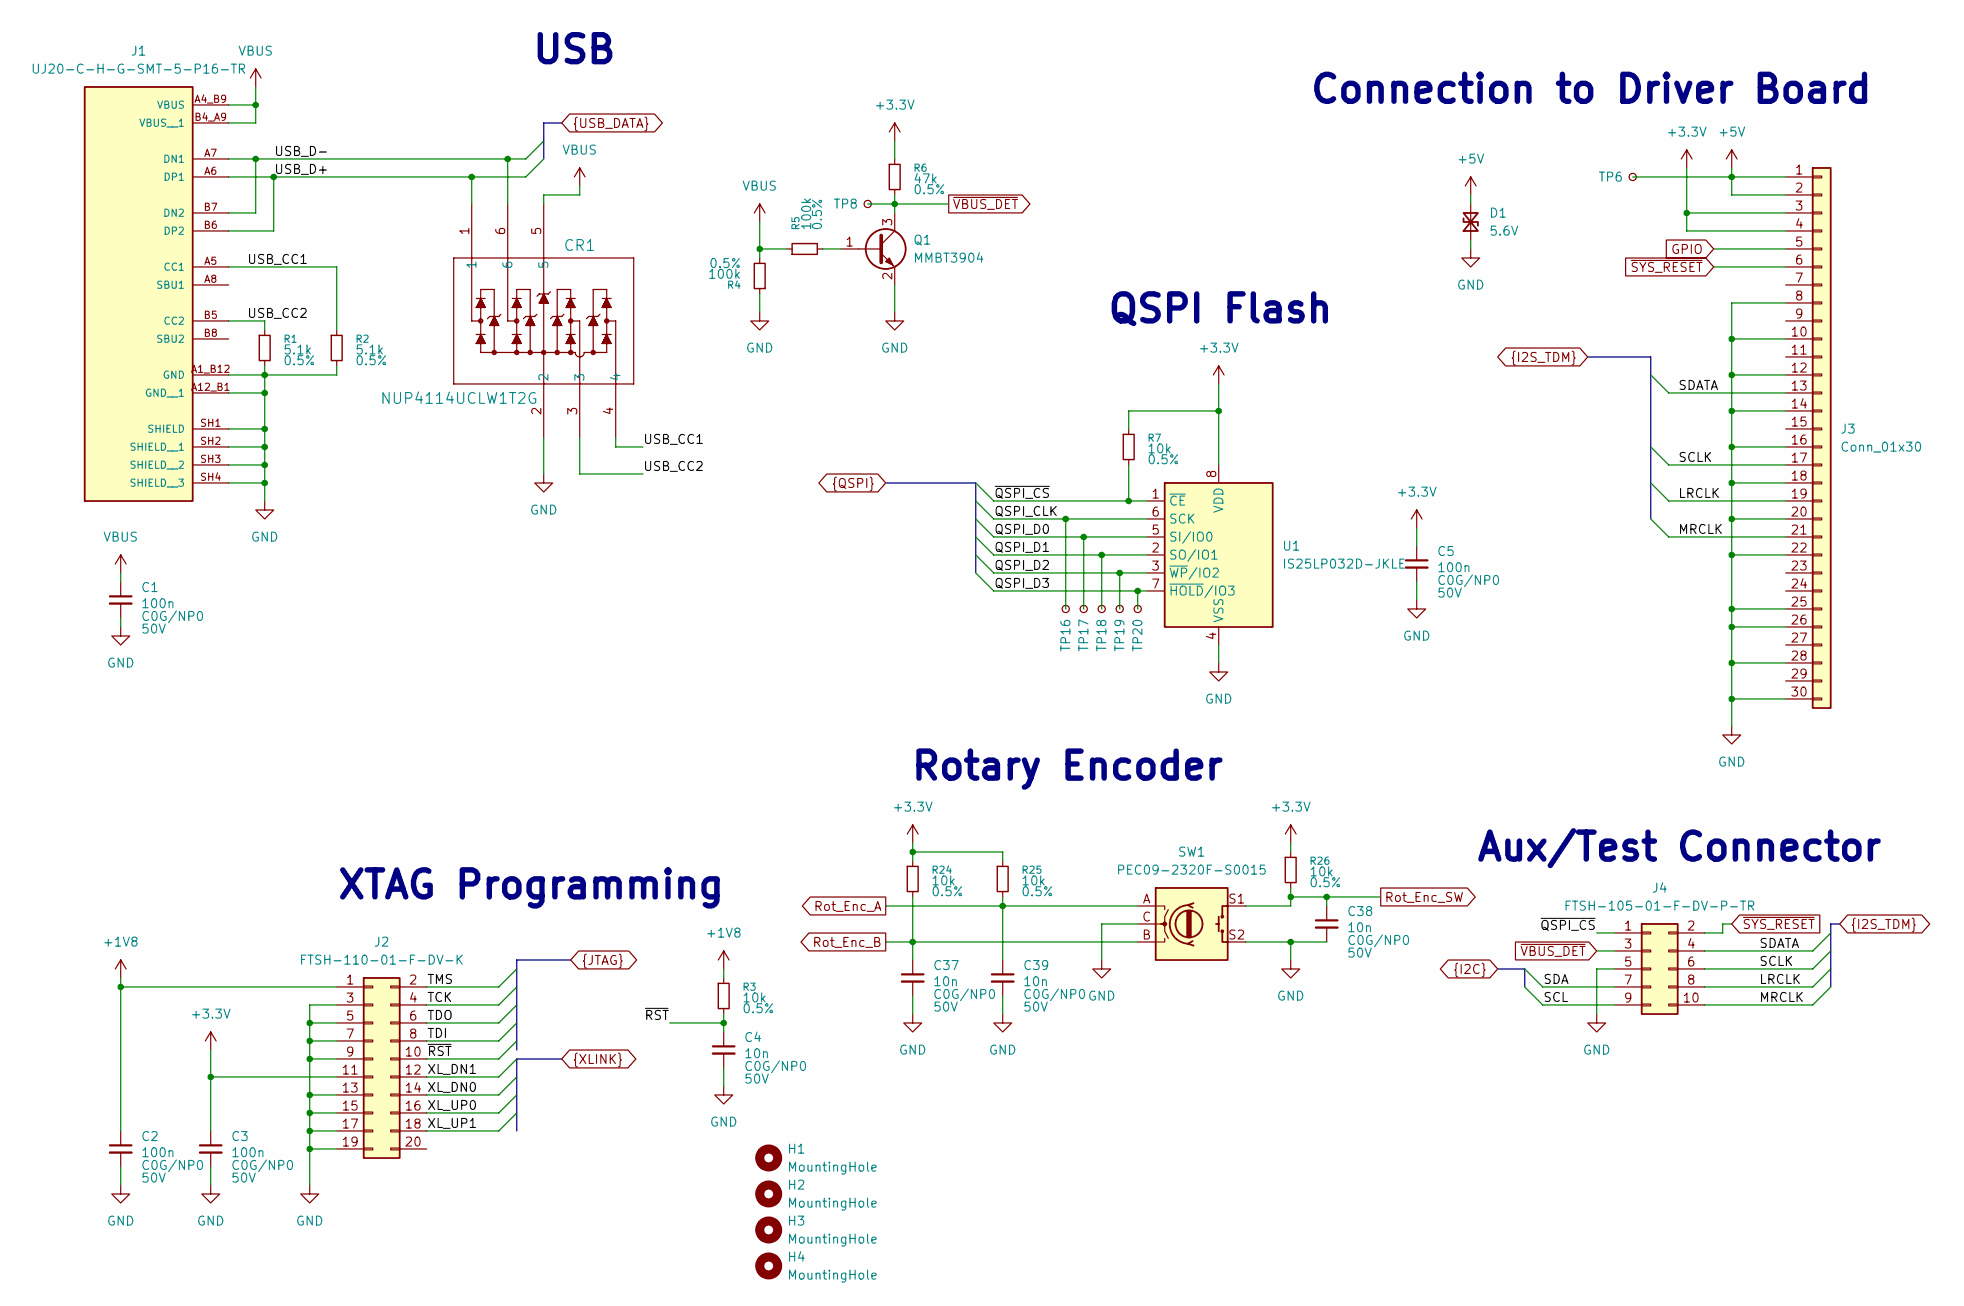
[picture p71: schematic Connectors_Power_Misc_compatkicad9.kicad_sch, USB to I2S Module]

Parts:
C1, C2, C3, C5: 100n; CAPC1810X65N; Voltage Rating 50V; MPN GRMJN65C1H104JE01D; DigiKey Part Number 490-GRMJN65C1H104JE01DCT-ND
C4, C37, C38, C39: 10n; C_0805_2012Metric_Pad1.18x1.45mm_HandSolder; Voltage Rating 50V; MPN GRM2195C1H103JA01D; DigiKey Part Number 490-1642-1-ND
CR1: NUP4114UCLW1T2G; SOT-363_SC-70-6; MPN NUP4114UCLW1T2G; DigiKey Part Number NUP4114UCLW1T2GOSCT-ND
D1: 5.6V; SOD-962_SL2_TOS; MPN DF2B6M4BSL,L3F; DigiKey Part Number 264-DF2B6M4BSL,L3FCT-ND
H1, H2, H3, H4: MountingHole; MountingHole_2.7mm_M2.5_DIN965
J1: UJ20-C-H-G-SMT-5-P16-TR; SAMESKY_UJ20-C-H-G-SMT-5-P16-TR; PARTREV 1.01; DigiKey Part Number 2223-UJ20-C-H-G-SMT-5-P16-TRCT-ND
J2: FTSH-110-01-F-DV-K; CON20_2X10_DUK_FTSH_SAI-M; MPN FTSH-110-01-F-DV-K; DigiKey Part Number SAM8802-ND
J3: Conn_01x30; CON_525593072_MOL; MPN 0525593072; DigiKey Part Number 900-0525593072TR-ND
J4: FTSH-105-01-F-DV-P-TR; PinHeader_2x05_P1.27mm_Vertical_SMD; MPN FTSH-105-01-F-DV-P-TR; DigiKey Part Number SAM13161CT-ND
Q1: MMBT3904; SOT-23; MPN MMBT3904; DigiKey Part Number 4530-MMBT3904CT-ND
R1, R2: 5.1k; R_0805_2012Metric_Pad1.20x1.40mm_HandSolder; MPN RNCF0805DTE5K10; DigiKey Part Number 738-RNCF0805DTE5K10CT-ND
R3, R7, R24, R25, R26: 10k; R_0805_2012Metric_Pad1.20x1.40mm_HandSolder; MPN RNCF0805DTE10K0; DigiKey Part Number RNCF0805DTE10K0CT-ND
R4, R5: 100k; R_0805_2012Metric_Pad1.20x1.40mm_HandSolder; MPN RNCF0805DTE100K; DigiKey Part Number 738-RNCF0805DTE100KCT-ND
R6: 47k; R_0805_2012Metric_Pad1.20x1.40mm_HandSolder; MPN RNCF0805DTE47K0; DigiKey Part Number 738-RNCF0805DTE47K0CT-ND
SW1: PEC09-2320F-S0015; RotaryEncoder_Bourns_Horizontal_PEC09-2xxxF-Sxxxx; MPN PEC09-2320F-S0015; DigiKey Part Number PEC09-2320F-S0015-ND
TP6, TP8, TP16, TP17, TP18, TP19, TP20: TestPoint_Small; TestPoint_Pad_D1.5mm
U1: IS25LP032D-JKLE; WSON-8-1EP_6x5mm_P1.27mm_EP3.4x4mm; MPN IS25LP032D-JKLE-TR; DigiKey Part Number 706-IS25LP032D-JKLE-TRCT-ND

Connections:
+1V8: C2.1, J2.1, R3.1; also elsewhere on the board
+3.3V: C3.1, C5.1, J2.11, J3.3, J3.4, R6.1, R7.1, R24.1, R25.1, R26.1, U1.8 (VDD); also elsewhere on the board
+5V: D1.2 (A2), J3.1, J3.2, TP6.1 (1_1); also elsewhere on the board
/Connectors_Misc/USB_CC1: CR1.4, J1.A5 (CC1), R2.1
/Connectors_Misc/USB_CC2: CR1.3, J1.B5 (CC2), R1.1
GND: C1.2, C2.2, C3.2, C4.2, C5.2, C37.2, C38.2, C39.2, CR1.2, D1.1 (A1), J1.A1_B12 (GND), J1.A12_B1 (GND__1), J1.SH1 (SHIELD), J1.SH2 (SHIELD__1), J1.SH3 (SHIELD__2), J1.SH4 (SHIELD__3), J2.3, J2.5, J2.7, J2.9, J2.13, J2.15, J2.17, J2.19, J3.8, J3.10, J3.12, J3.14, J3.16, J3.18, J3.20, J3.22, J3.25, J3.26, J3.28, J3.30, J4.5, Q1.2 (E), R1.2, R2.2, R4.1, SW1.C, SW1.S2, U1.4 (VSS); also elsewhere on the board
GPIO: J3.5; also elsewhere on the board
LRCLK: J3.19, J4.8; also elsewhere on the board
MRCLK: J3.21, J4.10; also elsewhere on the board
unnamed: Q1.1 (B), R5.2
QSPI_CLK: TP16.1 (1_1), U1.6 (SCK); also elsewhere on the board
QSPI_D0: TP17.1 (1_1), U1.5 (SI/IO0); also elsewhere on the board
QSPI_D1: TP18.1 (1_1), U1.2 (SO/IO1); also elsewhere on the board
QSPI_D2: TP19.1 (1_1), U1.3 (~WP/IO2); also elsewhere on the board
QSPI_D3: TP20.1 (1_1), U1.7 (~HOLD/IO3); also elsewhere on the board
Rot_Enc_A: C39.1, R25.2, SW1.A; also elsewhere on the board
Rot_Enc_B: C37.1, R24.2, SW1.B; also elsewhere on the board
Rot_Enc_SW: C38.1, R26.2, SW1.S1; also elsewhere on the board
SCL: J4.9; also elsewhere on the board
SCLK: J3.17, J4.6; also elsewhere on the board
SDA: J4.7; also elsewhere on the board
SDATA: J3.13, J4.4; also elsewhere on the board
TCK: J2.4; also elsewhere on the board
TDI: J2.8; also elsewhere on the board
TDO: J2.6; also elsewhere on the board
TMS: J2.2; also elsewhere on the board
USB_D+: CR1.1, J1.A6 (DP1), J1.B6 (DP2); also elsewhere on the board
USB_D-: CR1.6, J1.A7 (DN1), J1.B7 (DN2); also elsewhere on the board
VBUS: C1.1, CR1.5, J1.A4_B9 (VBUS), J1.B4_A9 (VBUS__1), R4.2, R5.1
XL_DN0: J2.14; also elsewhere on the board
XL_DN1: J2.12; also elsewhere on the board
XL_UP0: J2.16; also elsewhere on the board
XL_UP1: J2.18; also elsewhere on the board
~QSPI_CS: J4.1, R7.2, U1.1 (~CE); also elsewhere on the board
~RST: C4.1, J2.10, R3.2; also elsewhere on the board
~SYS_RESET: J3.6, J4.2; also elsewhere on the board
~VBUS_DET: J4.3, Q1.3 (C), R6.2, TP8.1 (1_1); also elsewhere on the board

Notes on the sheet:
Connection to Driver Board
Rotary Encoder
USB
QSPI Flash
XTAG Programming
Aux/Test Connector

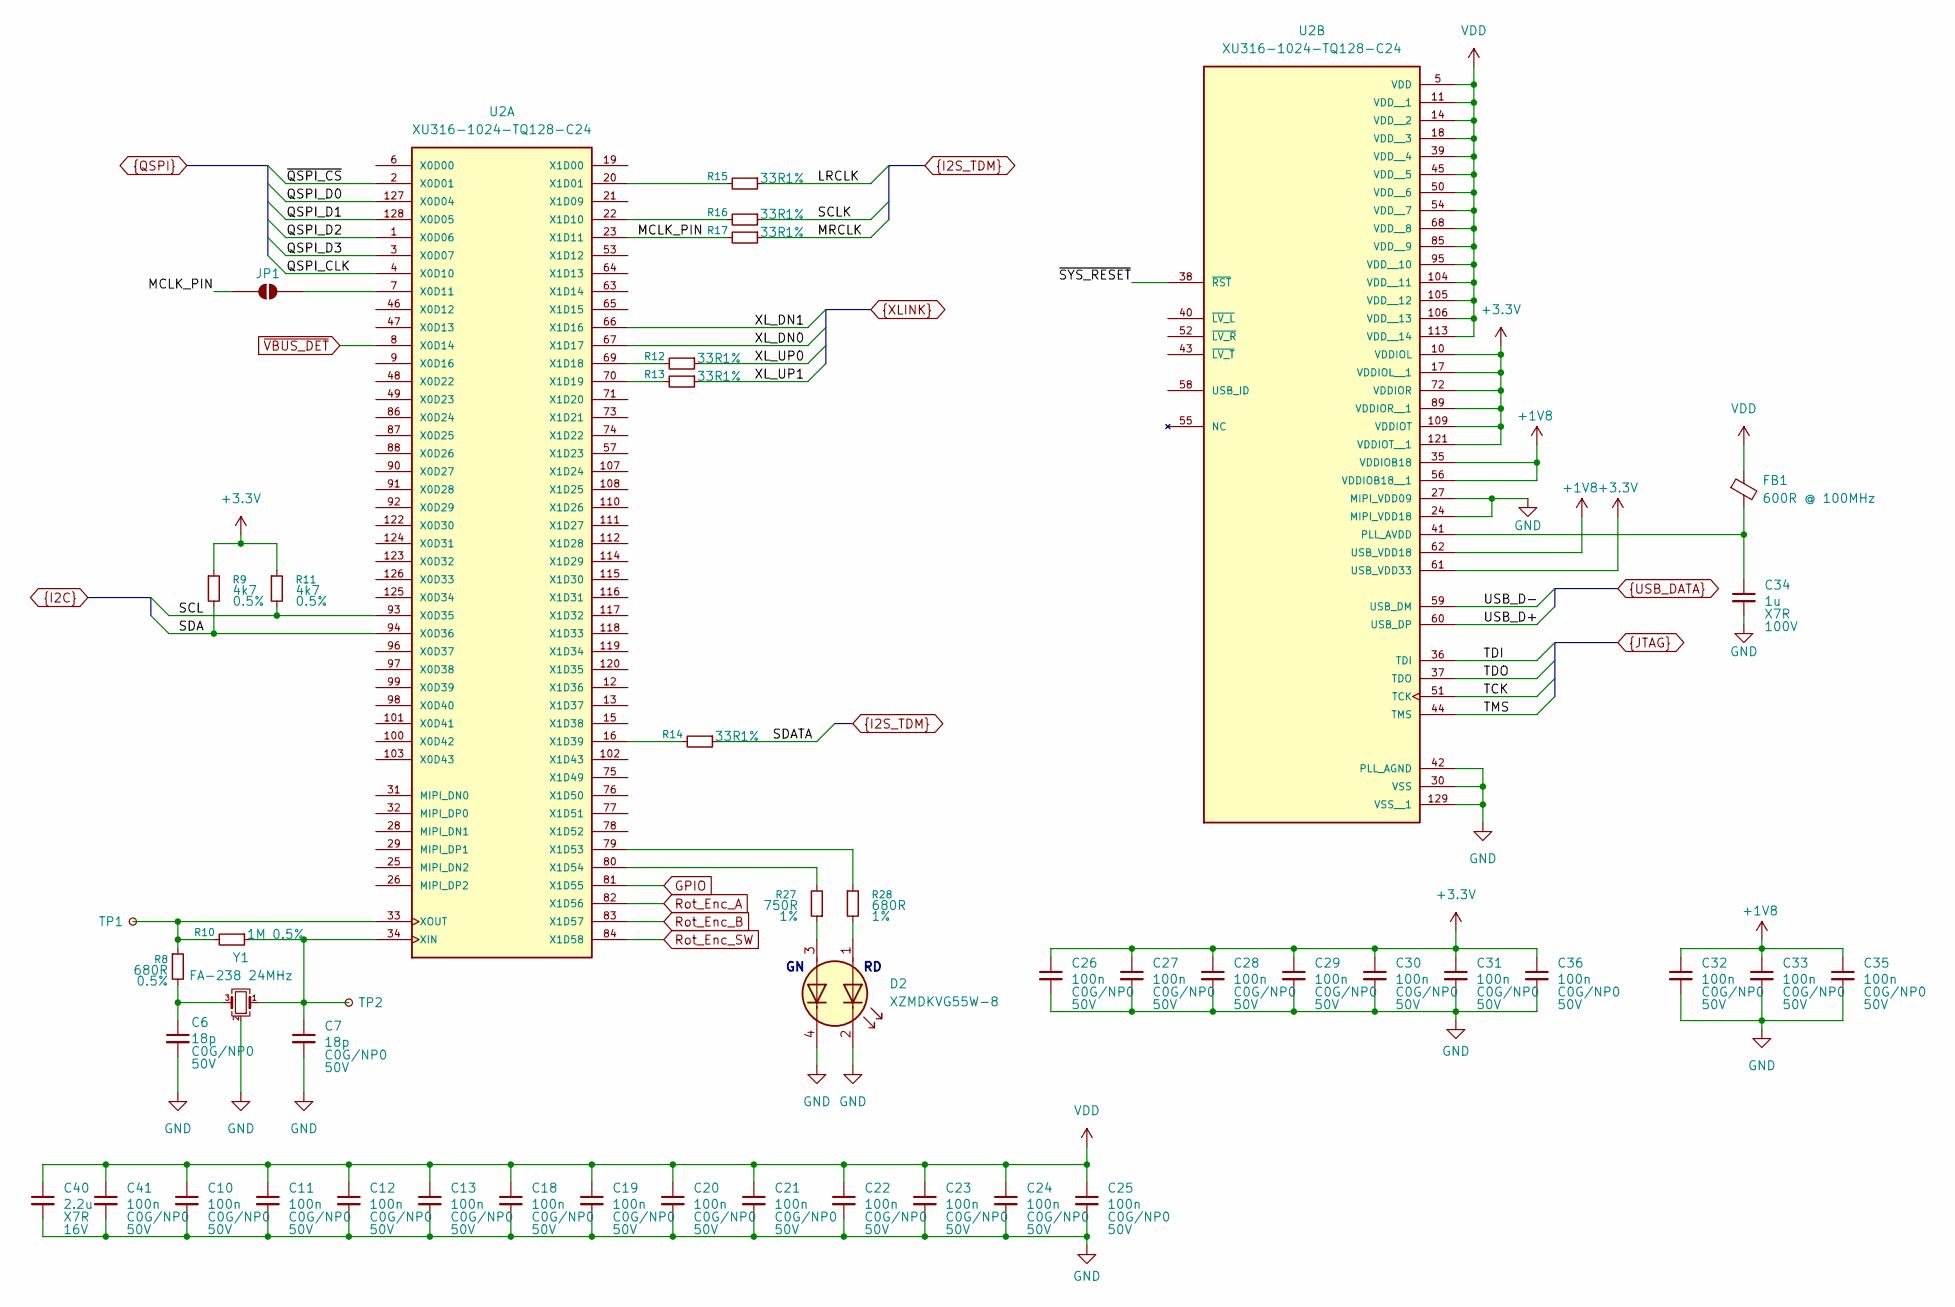
[picture p72: schematic xmos_compatkicad9.kicad_sch, USB to I2S Module]

Parts:
C6, C7: 18p; C_0603_1608Metric; Voltage Rating 50V; MPN C0603C180C5GACTU; DigiKey Part Number 399-C0603C180C5GACTUCT-ND
C10, C11, C12, C13, C18, C19, C20, C21, C22, C23, C24, C25, C26, C27, C28, C29, C30, C31, C32, C33, C35, C36, C41: 100n; CAPC1810X65N; Voltage Rating 50V; MPN GRMJN65C1H104JE01D; DigiKey Part Number 490-GRMJN65C1H104JE01DCT-ND
C34: 1u; C_0603_1608Metric; Voltage Rating 100V; MPN C1608X7R2A105K080AC; DigiKey Part Number 445-C1608X7R2A105K080ACCT-ND
C40: 2.2u; C_0805_2012Metric_Pad1.18x1.45mm_HandSolder; Voltage Rating 16V; MPN C2012X7R1C225K125AB; DigiKey Part Number 445-1420-1-ND
D2: XZMDKVG55W-8; LED_XZMDKVG55W-8; MPN XZMDKVG55W-8; DigiKey Part Number 1497-1183-1-ND
FB1: 600R @ 100MHz; C_0805_2012Metric_Pad1.18x1.45mm_HandSolder; MPN HZ0805E601R-10; DigiKey Part Number 240-2399-1-ND
JP1: SolderJumper_2_Open; SolderJumper-2_P1.3mm_Open_RoundedPad1.0x1.5mm
R8: 680R; R_0603_1608Metric; MPN RT0603DRD07680RL; DigiKey Part Number 311-680DCT-ND
R9, R11: 4k7; R_0805_2012Metric_Pad1.20x1.40mm_HandSolder; MPN RNCF0805DTE4K70; DigiKey Part Number 738-RNCF0805DTE4K70CT-ND
R10: 1M; R_0603_1608Metric; MPN RC0603DR-071ML; DigiKey Part Number 13-RC0603DR-071MLCT-ND
R12, R13, R14, R15, R16, R17: 33R; R_0805_2012Metric_Pad1.20x1.40mm_HandSolder; MPN RC0805FR-0733RL; DigiKey Part Number 311-33.0CRCT-ND
R27: 750R; R_0805_2012Metric_Pad1.20x1.40mm_HandSolder; MPN CRCW0805750RFKEA; DigiKey Part Number 541-750CCT-ND
R28: 680R; R_0805_2012Metric_Pad1.20x1.40mm_HandSolder; MPN CRCW0805680RFKEA; DigiKey Part Number 541-680CCT-ND
TP1, TP2: TestPoint_Small; TestPoint_Pad_D1.5mm
U2: XU316-1024-TQ128-C24; QFP40P1600X1600X120-129N; PARTREV 2025/1/13; DigiKey Part Number 880-XU316-1024-TQ128-C24-ND
Y1: FA-238 24MHz; Crystal_SMD_3225-4Pin_3.2x2.5mm; MPN FA-238 24.0000MB-C3; DigiKey Part Number SER3689CT-ND

Connections:
+1V8: C32.1, C33.1, C35.1, U2.35 (VDDIOB18), U2.56 (VDDIOB18__1), U2.62 (USB_VDD18); also elsewhere on the board
+3.3V: C26.1, C27.1, C28.1, C29.1, C30.1, C31.1, C36.1, R9.1, R11.1, U2.10 (VDDIOL), U2.17 (VDDIOL__1), U2.61 (USB_VDD33), U2.72 (VDDIOR), U2.89 (VDDIOR__1), U2.109 (VDDIOT), U2.121 (VDDIOT__1); also elsewhere on the board
/XMOS/MCLK_PIN: JP1.2 (B), R17.2, U2.23 (X1D11)
/XMOS/~SYS_RESET: U2.38 (~RST)
GND: C6.2, C7.2, C10.2, C11.2, C12.2, C13.2, C18.2, C19.2, C20.2, C21.2, C22.2, C23.2, C24.2, C25.2, C26.2, C27.2, C28.2, C29.2, C30.2, C31.2, C32.2, C33.2, C34.2, C35.2, C36.2, C40.2, C41.2, D2.2 (K1), D2.4 (K2), U2.24 (MIPI_VDD18), U2.27 (MIPI_VDD09), U2.30 (VSS), U2.42 (PLL_AGND), U2.129 (VSS__1), Y1.2 (G), Y1.4 (G); also elsewhere on the board
GPIO: U2.81 (X1D55); also elsewhere on the board
LRCLK: R15.1; also elsewhere on the board
MRCLK: R17.1; also elsewhere on the board
unnamed: C6.1, R8.2, Y1.3
unnamed: D2.1 (A1), R28.2
unnamed: D2.3 (A2), R27.1
unnamed: JP1.1 (A), U2.7 (X0D11)
unnamed: R15.2, U2.20 (X1D01)
unnamed: R16.2, U2.22 (X1D10)
unnamed: R12.2, U2.69 (X1D18)
unnamed: R13.2, U2.70 (X1D19)
unnamed: R14.2, U2.16 (X1D39)
unnamed: R28.1, U2.79 (X1D53)
unnamed: R27.2, U2.80 (X1D54)
unnamed: C7.1, R10.1, TP2.1 (1_1), U2.34 (XIN), Y1.1
unnamed: R8.1, R10.2, TP1.1 (1_1), U2.33 (XOUT)
unnamed: C34.1, FB1.2, U2.41 (PLL_AVDD)
QSPI_CLK: U2.4 (X0D10); also elsewhere on the board
QSPI_D0: U2.127 (X0D04); also elsewhere on the board
QSPI_D1: U2.128 (X0D05); also elsewhere on the board
QSPI_D2: U2.1 (X0D06); also elsewhere on the board
QSPI_D3: U2.3 (X0D07); also elsewhere on the board
Rot_Enc_A: U2.82 (X1D56); also elsewhere on the board
Rot_Enc_B: U2.83 (X1D57); also elsewhere on the board
Rot_Enc_SW: U2.84 (X1D58); also elsewhere on the board
SCL: R11.2, U2.93 (X0D35); also elsewhere on the board
SCLK: R16.1; also elsewhere on the board
SDA: R9.2, U2.94 (X0D36); also elsewhere on the board
SDATA: R14.1; also elsewhere on the board
TCK: U2.51 (TCK); also elsewhere on the board
TDI: U2.36 (TDI); also elsewhere on the board
TDO: U2.37 (TDO); also elsewhere on the board
TMS: U2.44 (TMS); also elsewhere on the board
USB_D+: U2.60 (USB_DP); also elsewhere on the board
USB_D-: U2.59 (USB_DM); also elsewhere on the board
VDD: C10.1, C11.1, C12.1, C13.1, C18.1, C19.1, C20.1, C21.1, C22.1, C23.1, C24.1, C25.1, C40.1, C41.1, FB1.1, U2.5 (VDD), U2.11 (VDD__1), U2.14 (VDD__2), U2.18 (VDD__3), U2.39 (VDD__4), U2.45 (VDD__5), U2.50 (VDD__6), U2.54 (VDD__7), U2.68 (VDD__8), U2.85 (VDD__9), U2.95 (VDD__10), U2.104 (VDD__11), U2.105 (VDD__12), U2.106 (VDD__13), U2.113 (VDD__14); also elsewhere on the board
XL_DN0: U2.67 (X1D17); also elsewhere on the board
XL_DN1: U2.66 (X1D16); also elsewhere on the board
XL_UP0: R12.1; also elsewhere on the board
XL_UP1: R13.1; also elsewhere on the board
~QSPI_CS: U2.2 (X0D01); also elsewhere on the board
~VBUS_DET: U2.8 (X0D14); also elsewhere on the board

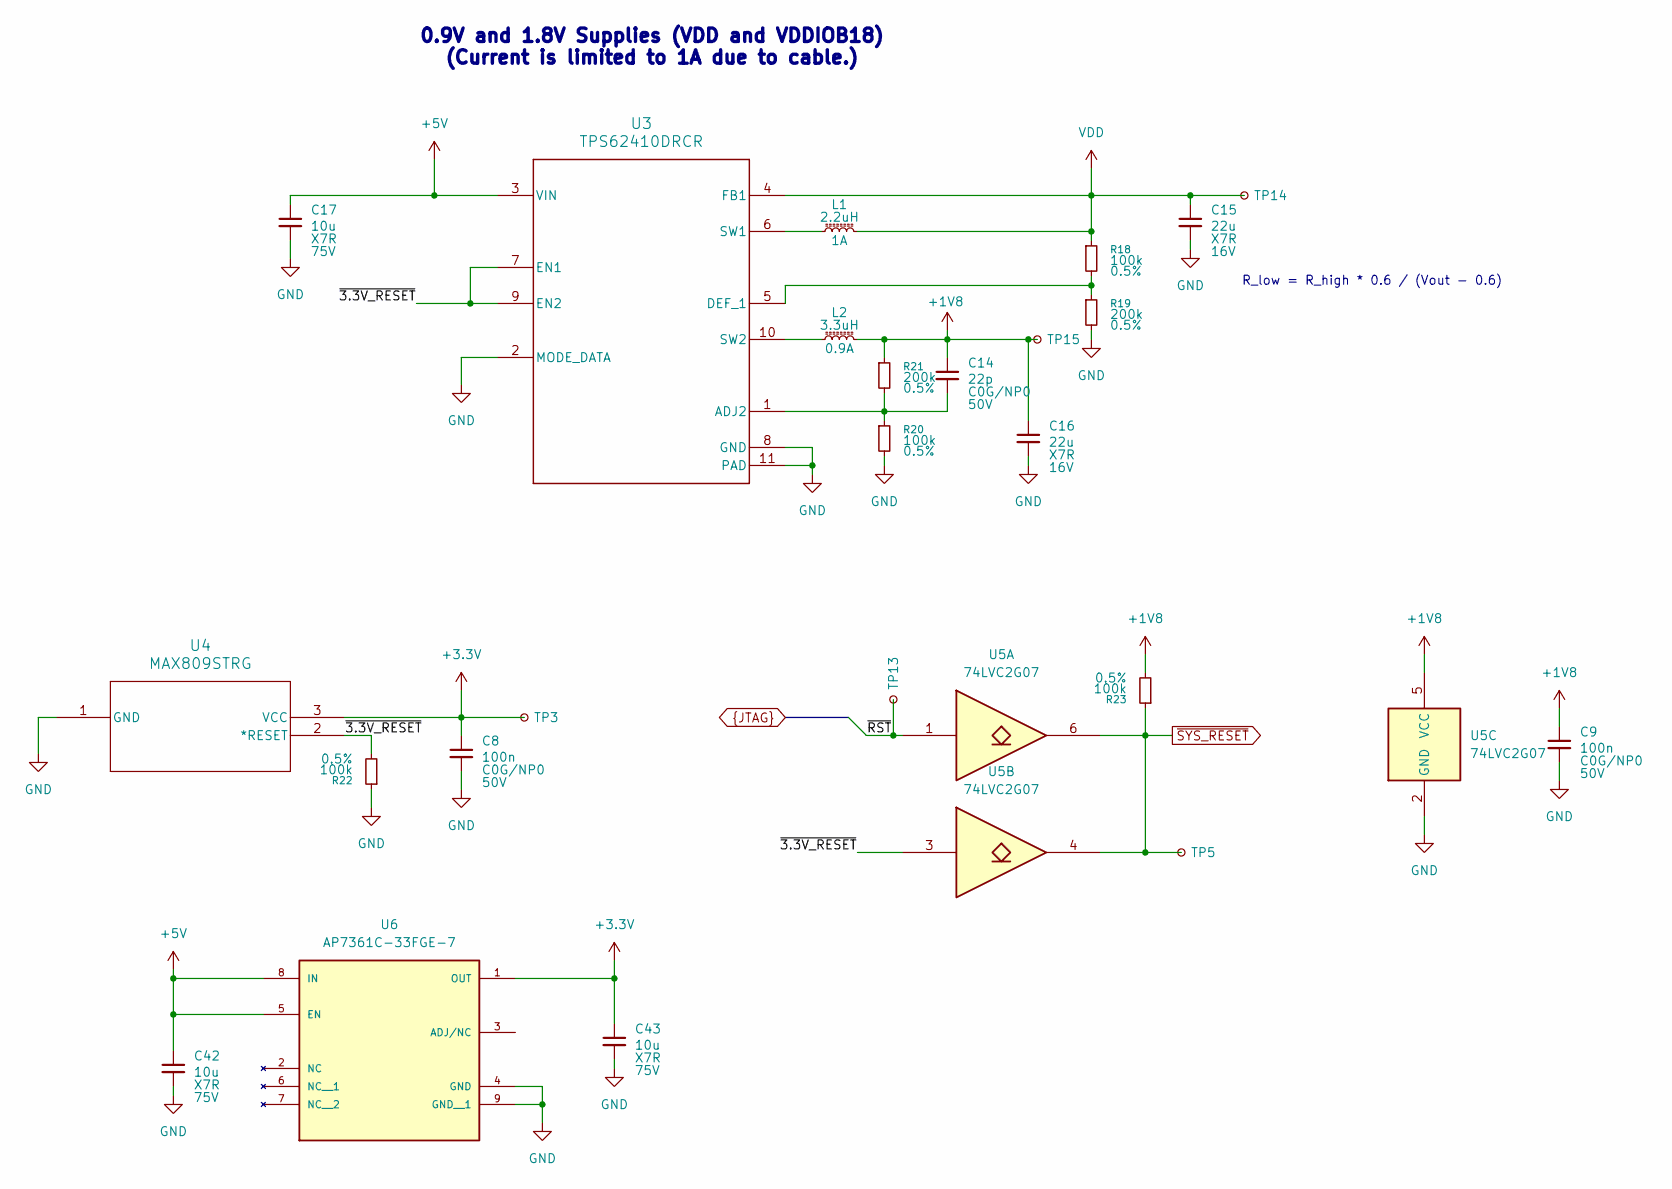
[picture p73: schematic Power_compatkicad9.kicad_sch]

Parts:
C8, C9: 100n; CAPC1810X65N; Voltage Rating 50V; MPN GRMJN65C1H104JE01D; DigiKey Part Number 490-GRMJN65C1H104JE01DCT-ND
C14: 22p; C_0603_1608Metric_Pad1.08x0.95mm_HandSolder; Voltage Rating 50V; MPN C0603C220J5GACTU; DigiKey Part Number 399-C0603C220J5GACTUCT-ND
C15, C16: 22u; C_1210_3225Metric_Pad1.33x2.70mm_HandSolder; Voltage Rating 16V; MPN CL32B226MOJNNNE; DigiKey Part Number 1276-3395-1-ND
C17, C42, C43: 10u; C_1210_3225Metric_Pad1.33x2.70mm_HandSolder; Voltage Rating 75V; MPN C3225X7R1N106K250AC; DigiKey Part Number 445-C3225X7R1N106K250ACCT-ND
L1: 2.2uH; IND_EPCOS_B82432T_EPC; MPN B82432T1222K000; DigiKey Part Number 495-1757-1-ND
L2: 3.3uH; IND_EPCOS_B82432T_EPC; MPN B82432T1332K000; DigiKey Part Number 495-1760-1-ND
R18, R20, R22, R23: 100k; R_0805_2012Metric_Pad1.20x1.40mm_HandSolder; MPN RNCF0805DTE100K; DigiKey Part Number 738-RNCF0805DTE100KCT-ND
R19, R21: 200k; R_0805_2012Metric_Pad1.20x1.40mm_HandSolder; MPN RNCF0805DTE200K; DigiKey Part Number 738-RNCF0805DTE200KCT-ND
TP3, TP5, TP13, TP14, TP15: TestPoint_Small; TestPoint_Pad_D1.5mm
U3: TPS62410DRCR; MPN TPS62410DRCR; DigiKey Part Number 296-25488-1-ND
U4: MAX809STRG; SOT-23; MPN MAX809STRG; DigiKey Part Number MAX809STRGOSCT-ND
U5: 74LVC2G07; SOT-363_SC-70-6; MPN 74LVC2G07GW,125; DigiKey Part Number 1727-4121-1-ND
U6: AP7361C-33FGE-7; SON65P300X300X63-9N; PARTREV 5 - 2; DigiKey Part Number AP7361C-33FGE-7DICT-ND

Connections:
+1V8: C9.1, C14.1, C16.1, L2.2, R21.1, R23.2, TP15.1 (1_1), U5.5 (VCC); also elsewhere on the board
+3.3V: C8.1, C43.1, TP3.1 (1_1), U4.3 (VCC), U6.1 (OUT); also elsewhere on the board
+5V: C17.1, C42.1, U3.3 (VIN), U6.5 (EN), U6.8 (IN); also elsewhere on the board
/Power/~3.3V_RESET: R22.2, U3.7 (EN1), U3.9 (EN2), U4.2 (*RESET), U5.3
GND: C8.2, C9.2, C15.2, C16.2, C17.2, C42.2, C43.2, R19.2, R20.2, R22.1, U3.2 (MODE_DATA), U3.8 (GND), U3.11 (PAD), U4.1 (GND), U5.2 (GND), U6.4 (GND), U6.9 (GND__1); also elsewhere on the board
unnamed: C14.2, R20.1, R21.2, U3.1 (ADJ2)
unnamed: R18.2, R19.1, U3.5 (DEF_1)
unnamed: L1.1, U3.6 (SW1)
unnamed: L2.1, U3.10 (SW2)
VDD: C15.1, L1.2, R18.1, TP14.1 (1_1), U3.4 (FB1); also elsewhere on the board
~RST: TP13.1 (1_1), U5.1; also elsewhere on the board
~SYS_RESET: R23.1, TP5.1 (1_1), U5.4, U5.6; also elsewhere on the board

Notes on the sheet:
R_low = R_high * 0.6 / (Vout - 0.6)
0.9V and 1.8V Supplies (VDD and VDDIOB18) (Current is limited to 1A due to cable.)

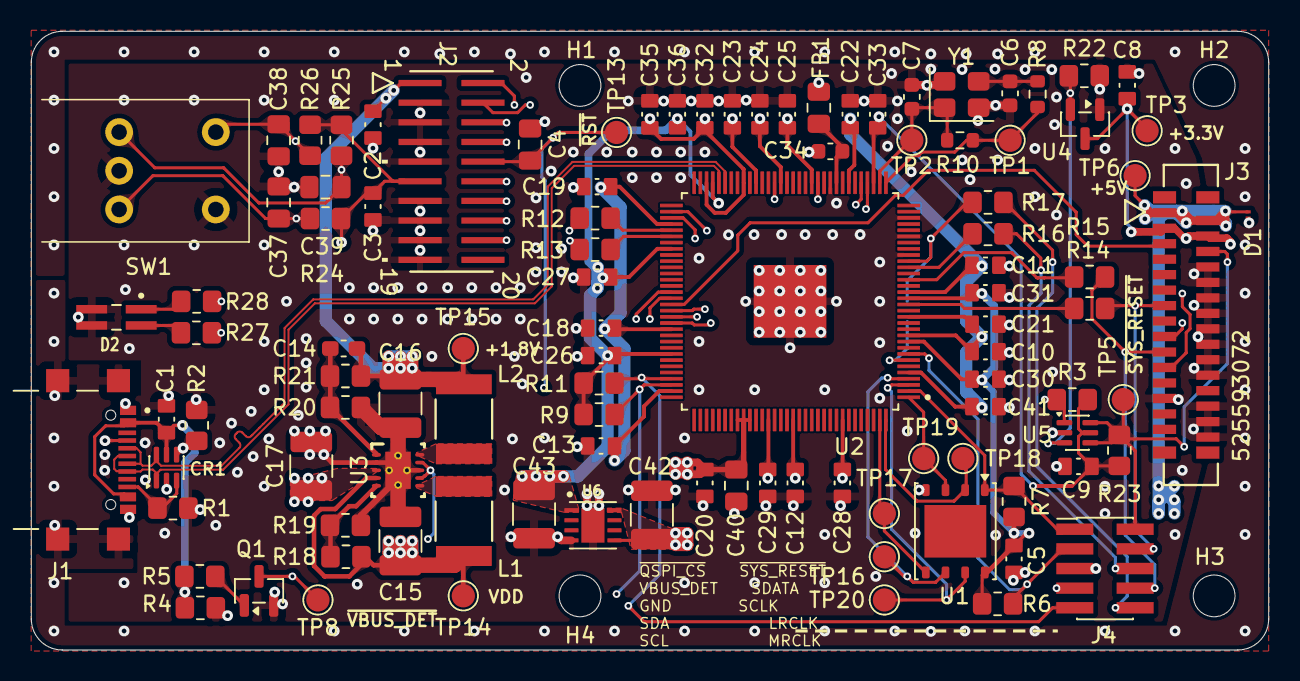
[picture p74: board nathophone_USBtoI2S_compatkicad9.kicad_pcb from above]

Board: 4 copper layers, 80.0 x 40.0 mm, 109 parts (1 on the bottom side), 58 nets.
