Violabitch5/Nathophone_elec/pcb/Nathophone_driver_board.kicad_pcb

## KiCad design pcb/Nathophone_driver_board.kicad_pcb (2025-12-14)

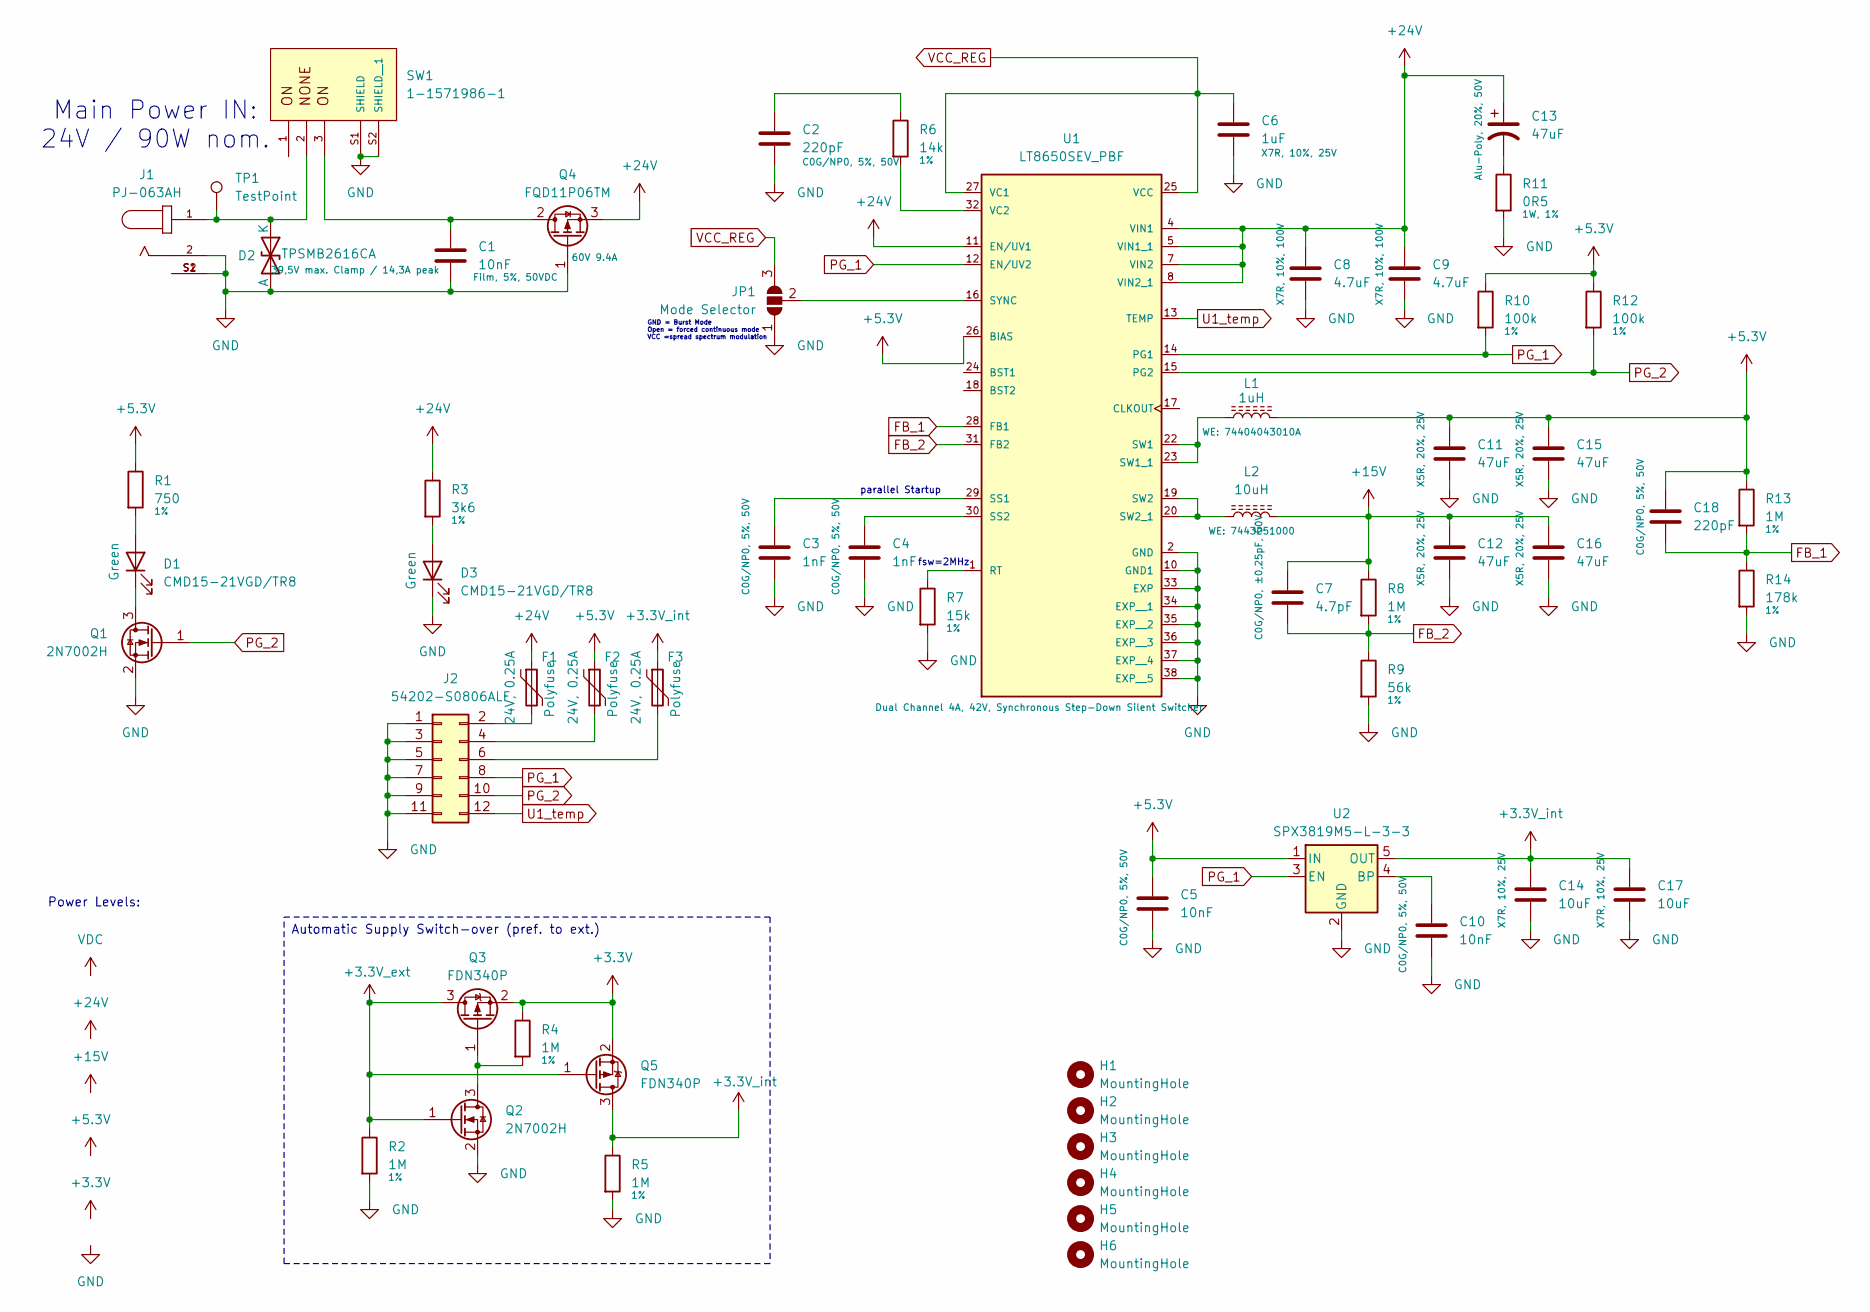
[picture p75: schematic Nathophone_pcb_Power.kicad_sch, Nathophone Driver Board]

Parts:
C1: 10nF; C_1206_3216Metric; MPN ECH-U1H103JX5; DigiKey_PartNo PCF1340TR-ND
C2, C18: 220pF; C_0805_2012Metric; MPN CL21C221JBANNNC; DigiKey_PartNo 1276-1164-2-ND
C3, C4: 1nF; C_0805_2012Metric; MPN CL21C102JBCNFNC; DigiKey_PartNo 1276-2576-2-ND
C5, C10: 10nF; C_0805_2012Metric; MPN CL21C103JBF1PNE; DigiKey_PartNo 1276-6790-2-ND
C6: 1uF; C_0805_2012Metric; MPN CL21B105KAFNNNE; DigiKey_PartNo 1276-1066-2-ND
C7: 4.7pF; C_0402_1005Metric; MPN CL05C4R7CB51PNC; DigiKey_PartNo 1276-6694-2-ND
C8, C9: 4.7uF; C_1206_3216Metric; MPN C3216X7R2A475K160AC; DigiKey_PartNo 445-C3216X7R2A475K160ACTR-ND
C11, C12, C15, C16: 47uF; C_1206_3216Metric; MPN C3216X5R1E476M160AC; DigiKey_PartNo 445-8047-2-ND
C13: 47uF; CP_Elec_8x10; MPN GXC1H470MCQ1GS; DigiKey_PartNo GXC1H470MCQ1GTR-ND
C14, C17: 10uF; C_1206_3216Metric; MPN CL31B106KAHNNNE; DigiKey_PartNo 1276-1804-2-ND
D1, D3: CMD15-21VGD/TR8; LED_1206_3216Metric; MPN CMD15-21VGD/TR8; DigiKey_PartNo L62305TR-ND
D2: TPSMB2616CA; D_SMB; MPN TPSMB2616CA; DigiKey_PartNo 18-TPSMB2616CATR-ND
F1, F2, F3: Polyfuse; Fuse_1206_3216Metric; MPN 0ZCJ0025AF2E; DigiKey_PartNo 5923-0ZCJ0025AF2ETR-ND
H1, H2, H3, H4, H5, H6: MountingHole; MountingHole_3.2mm_M3
J1: PJ-063AH; CUI_PJ-063AH; PARTREV 1.02; DigiKey_PartNo CP-063AH-ND
J2: 54202-S0806ALF; PinHeader_2x06_P2.54mm_Vertical_SMD; MPN 54202-S0806ALF; DigiKey_PartNo 609-54202-S0806ALFTR-ND
JP1: Mode Selector; SolderJumper-3_P1.3mm_Open_RoundedPad1.0x1.5mm
L1: 1uH; WE-LQS_4025; MPN 74404043010A; DigiKey_PartNo 732-10753-2-ND
L2: 10uH; WE-HCI_1050; MPN 7443251000; DigiKey_PartNo 732-4179-2-ND
Q1, Q2: 2N7002H; SOT-23; MPN 2N7002H-7; DigiKey_PartNo 2N7002H-7DITR-ND
Q3, Q5: FDN340P; SOT-23; MPN FDN340P; DigiKey_PartNo FDN340PTR-ND
Q4: FQD11P06TM; TO-252-2; MPN FQD11P06TM; DigiKey_PartNo FQD11P06TMTR-ND
R1: 750; R_0805_2012Metric; MPN CRCW0805750RFKEA; DigiKey_PartNo 541-750CTR-ND
R2, R4, R5, R8, R13: 1M; R_0805_2012Metric; MPN CRCW08051M00FKEA; DigiKey_PartNo 541-1.00MCTR-ND
R3: 3k6; R_0805_2012Metric; MPN CRCW08053K60FKEA; DigiKey_PartNo 541-3.60KCTR-ND
R6: 14k; R_0805_2012Metric; MPN CRCW080514K0FKEA; DigiKey_PartNo 541-14.0KCTR-ND
R7: 15k; R_0805_2012Metric; MPN CRCW080515K0FKEA; DigiKey_PartNo 541-15.0KCTR-ND
R9: 56k; R_0805_2012Metric; MPN CRCW080556K0FKEA; DigiKey_PartNo 541-56.0KCTR-ND
R10, R12: 100k; R_0805_2012Metric; MPN CRCW0805100KFKEA; DigiKey_PartNo 541-100KCTR-ND
R11: 0R5; R_1206_3216Metric; MPN MFHA1206R5000FC; DigiKey_PartNo 283-MFHA1206R5000FCTR-ND
R14: 178k; R_0805_2012Metric; MPN CRCW0805178KFKEA; DigiKey_PartNo 541-178KCTR-ND
SW1: 1-1571986-1; TE_1-1571986-1; PARTREV A12; DigiKey_PartNo 450-1518-ND
TP1: TestPoint; TestPoint_Pad_D2.0mm
U1: LT8650SEV_PBF; QFN50P600X400X103-32N240X440; MPN LT8650SEV#PBF; DigiKey_PartNo 505-LT8650SEV#PBF-ND
U2: SPX3819M5-L-3-3; SOT-23-5; MPN SPX3819M5-L-3-3/TR; DigiKey_PartNo 1016-1873-2-ND

Connections:
+3.3V: Q3.2 (S), Q5.2 (S), R4.1; also elsewhere on the board
+3.3V_ext: Q2.1 (G), Q3.3 (D), Q5.1 (G), R2.1; also elsewhere on the board
+3.3V_int: C14.1, C17.1, F3.1, Q5.3 (D), R5.1, U2.5 (OUT); also elsewhere on the board
+5.3V: C5.1, C11.1, C15.1, C18.1, F2.1, L1.2, R1.1, R10.1, R12.1, R13.1, U1.26 (BIAS), U2.1 (IN); also elsewhere on the board
+15V: C7.1, C12.1, C16.1, L2.2, R8.1; also elsewhere on the board
+24V: C8.1, C9.1, C13.1, F1.1, Q4.3 (S), R3.1, U1.4 (VIN1), U1.5 (VIN1_1), U1.7 (VIN2), U1.8 (VIN2_1), U1.11 (EN/UV1)
FB_1: C18.2, R13.2, R14.1, U1.28 (FB1)
FB_2: C7.2, R8.2, R9.1, U1.31 (FB2)
GND: C1.2, C2.2, C3.2, C4.2, C5.2, C6.2, C8.2, C9.2, C10.2, C11.2, C12.2, C14.2, C15.2, C16.2, C17.2, D2.2 (A), D3.1 (K), J1.2, J1.S1 (SHIELD), J1.S2 (SHIELD__1), J2.1, J2.3, J2.5, J2.7, J2.9, J2.11, JP1.1 (A), Q1.2 (S), Q2.2 (S), Q4.1 (G), R2.2, R5.2, R7.2, R9.2, R11.2, R14.2, SW1.S1 (SHIELD), SW1.S2 (SHIELD__1), U1.2 (GND), U1.10 (GND1), U1.33 (EXP), U1.34 (EXP__1), U1.35 (EXP__2), U1.36 (EXP__3), U1.37 (EXP__4), U1.38 (EXP__5), U2.2 (GND); also elsewhere on the board
unnamed: C2.1, R6.1
unnamed: C13.2, R11.1
unnamed: D1.2 (A), R1.2
unnamed: D1.1 (K), Q1.3 (D)
unnamed: D2.1 (K), J1.1, SW1.2, TP1.1
unnamed: D3.2 (A), R3.2
unnamed: F1.2, J2.2
unnamed: F2.2, J2.4
unnamed: F3.2, J2.6
unnamed: JP1.2 (C), U1.16 (SYNC)
unnamed: Q2.3 (D), Q3.1 (G), R4.2
unnamed: C1.1, Q4.2 (D), SW1.3
unnamed: R7.1, U1.1 (RT)
unnamed: C3.1, U1.29 (SS1)
unnamed: C4.1, U1.30 (SS2)
unnamed: L1.1, U1.22 (SW1), U1.23 (SW1_1)
unnamed: L2.1, U1.19 (SW2), U1.20 (SW2_1)
unnamed: R6.2, U1.32 (VC2)
unnamed: C10.1, U2.4 (BP)
PG_1: J2.8, R10.2, U1.12 (EN/UV2), U1.14 (PG1), U2.3 (EN)
PG_2: J2.10, Q1.1 (G), R12.2, U1.15 (PG2)
U1_temp: J2.12, U1.13 (TEMP)
VCC_REG: C6.1, JP1.3 (B), U1.25 (VCC), U1.27 (VC1)

Notes on the sheet:
Main Power IN: 24V / 90W nom.
GND = Burst Mode Open = forced continuous mode VCC =spread spectrum modulation
fsw=2MHz
Power Levels:
parallel Startup
Automatic Supply Switch-over (pref. to ext.)
