Violabitch5/Nathophone_elec/pcb/Nathophone_driver_board.kicad_pcb

## KiCad design pcb/Nathophone_driver_board.kicad_pcb (continued)

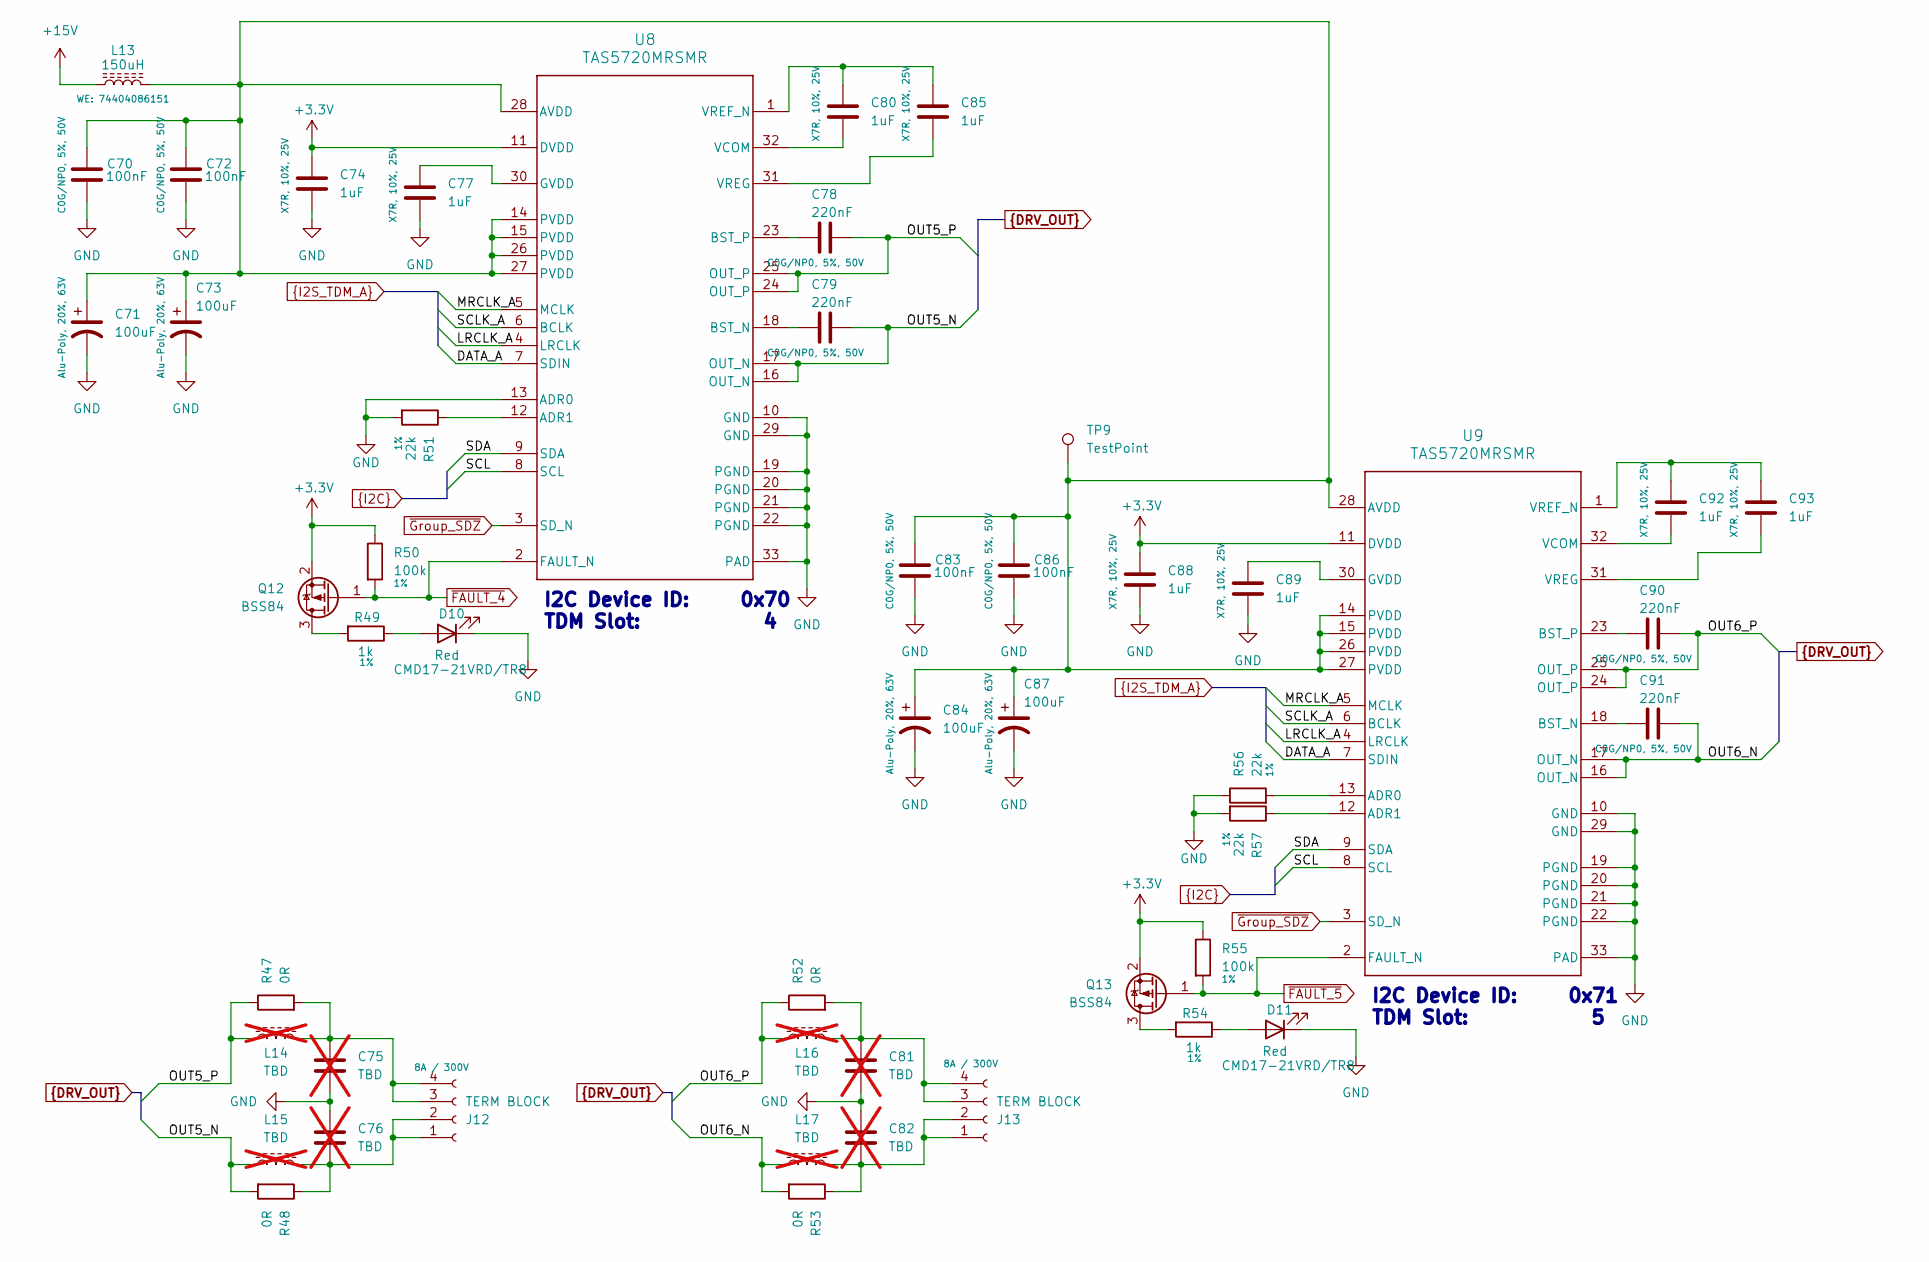
[picture p76: schematic DriversC.kicad_sch, Nathophone Driver Board]

Parts:
C70, C72, C83, C86: 100nF; C_1206_3216Metric; MPN GRM3195C1H104JA05D; DigiKey_PartNo 490-GRM3195C1H104JA05DTR-ND
C71, C73, C84, C87: 100uF; C_Elec_10x10.2; MPN A782MS107M1JLAS030; DigiKey_PartNo 399-A782MS107M1JLAS030TR-ND
C74, C77, C80, C85, C88, C89, C92, C93: 1uF; C_0805_2012Metric; MPN CL21B105KAFNNNE; DigiKey_PartNo 1276-1066-2-ND
C75, C76, C81, C82: TBD; C_2220_5750Metric; MPN SMDTC03680QB00MP00; DigiKey_PartNo 1928-1932-2-ND; not fitted
C78, C79, C90, C91: 220nF; C_1206_3216Metric; MPN GRM31C5C1H224JE02L; DigiKey_PartNo 490-GRM31C5C1H224JE02LTR-ND
D10, D11: CMD17-21VRD/TR8; LED_0805_2012Metric; MPN CMD17-21VRD/TR8; DigiKey_PartNo L62501TR-ND
J12, J13: TERM BLOCK; CONN_1862042; MPN 1862042; DigiKey_PartNo 277-12154-ND
L13: 150uH; WE-LQS_8065; MPN 74404086151; DigiKey_PartNo 732-11733-2-ND
L14, L15, L16, L17: TBD; IND_SRU1048-150Y; MPN SRU1048-150Y; DigiKey_PartNo SRU1048-150YTR-ND; not fitted
Q12, Q13: BSS84; SOT-23; MPN BSS84; DigiKey_PartNo 5399-BSS84TR-ND
R47, R48, R52, R53: 0R; R_2010_5025Metric; MPN CRCW20100000Z0EF; DigiKey_PartNo 541-0.0WTR-ND
R49, R54: 1k; R_0805_2012Metric; MPN CRCW08051K00FKEA; DigiKey_PartNo 541-1.00KCTR-ND
R50, R55: 100k; R_0805_2012Metric; MPN CRCW0805100KFKEA; DigiKey_PartNo 541-100KCTR-ND
R51, R56, R57: 22k; R_0805_2012Metric; MPN CRCW080522K0FKEB; DigiKey_PartNo 541-CRCW080522K0FKEBTR-ND
TP9: TestPoint; TestPoint_Pad_D2.0mm
U8, U9: TAS5720MRSMR; VQFN32_RSM0032B_NV; MPN TAS5720MRSMR; DigiKey_PartNo 296-TAS5720MRSMRTR-ND

Connections:
+3.3V: C74.1, C88.1, Q12.2 (S), Q13.2 (S), R50.1, R55.1, U8.11 (DVDD), U9.11 (DVDD); also elsewhere on the board
+15V: L13.1; also elsewhere on the board
DATA_A: U8.7 (SDIN), U9.7 (SDIN); also elsewhere on the board
GND: C70.2, C71.2, C72.2, C73.2, C74.2, C75.2, C76.1, C77.2, C81.2, C82.1, C83.2, C84.2, C86.2, C87.2, C88.2, C89.2, D10.1 (K), D11.1 (K), R51.2, R56.1, R57.2, U8.10 (GND), U8.13 (ADR0), U8.19 (PGND), U8.20 (PGND), U8.21 (PGND), U8.22 (PGND), U8.29 (GND), U8.33 (PAD), U9.10 (GND), U9.19 (PGND), U9.20 (PGND), U9.21 (PGND), U9.22 (PGND), U9.29 (GND), U9.33 (PAD); also elsewhere on the board
LRCLK_A: U8.4 (LRCLK), U9.4 (LRCLK); also elsewhere on the board
MRCLK_A: U8.5 (MCLK), U9.5 (MCLK); also elsewhere on the board
unnamed: D10.2 (A), R49.1
unnamed: D11.2 (A), R54.1
unnamed: C76.2, J12.1, J12.2, L15.2, R48.1
unnamed: C75.1, J12.3, J12.4, L14.2, R47.2
unnamed: C82.2, J13.1, J13.2, L17.2, R53.1
unnamed: C81.1, J13.3, J13.4, L16.2, R52.2
unnamed: Q12.3 (D), R49.2
unnamed: Q13.3 (D), R54.2
unnamed: R51.1, U8.12 (ADR1)
unnamed: C70.1, C71.1, C72.1, C73.1, C83.1, C84.1, C86.1, C87.1, L13.2, TP9.1, U8.14 (PVDD), U8.15 (PVDD), U8.26 (PVDD), U8.27 (PVDD), U8.28 (AVDD), U9.14 (PVDD), U9.15 (PVDD), U9.26 (PVDD), U9.27 (PVDD), U9.28 (AVDD)
unnamed: C79.1, U8.18 (BST_N)
unnamed: C78.1, U8.23 (BST_P)
unnamed: C77.1, U8.30 (GVDD)
unnamed: C80.2, U8.32 (VCOM)
unnamed: C80.1, C85.1, U8.1 (VREF_N)
unnamed: C85.2, U8.31 (VREG)
unnamed: R56.2, U9.13 (ADR0)
unnamed: R57.1, U9.12 (ADR1)
unnamed: C91.1, U9.18 (BST_N)
unnamed: C90.1, U9.23 (BST_P)
unnamed: C89.1, U9.30 (GVDD)
unnamed: C92.2, U9.32 (VCOM)
unnamed: C92.1, C93.1, U9.1 (VREF_N)
unnamed: C93.2, U9.31 (VREG)
OUT5_N: C79.2, L15.1, R48.2, U8.16 (OUT_N), U8.17 (OUT_N); also elsewhere on the board
OUT5_P: C78.2, L14.1, R47.1, U8.24 (OUT_P), U8.25 (OUT_P); also elsewhere on the board
OUT6_N: C91.2, L17.1, R53.2, U9.16 (OUT_N), U9.17 (OUT_N); also elsewhere on the board
OUT6_P: C90.2, L16.1, R52.1, U9.24 (OUT_P), U9.25 (OUT_P); also elsewhere on the board
SCL: U8.8 (SCL), U9.8 (SCL); also elsewhere on the board
SCLK_A: U8.6 (BCLK), U9.6 (BCLK); also elsewhere on the board
SDA: U8.9 (SDA), U9.9 (SDA); also elsewhere on the board
~FAULT_4: Q12.1 (G), R50.2, U8.2 (FAULT_N); also elsewhere on the board
~FAULT_5: Q13.1 (G), R55.2, U9.2 (FAULT_N); also elsewhere on the board
~Group_SDZ: U8.3 (SD_N), U9.3 (SD_N); also elsewhere on the board

Notes on the sheet:
I2C Device ID: 0x70 TDM Slot: 4
I2C Device ID: 0x71 TDM Slot: 5

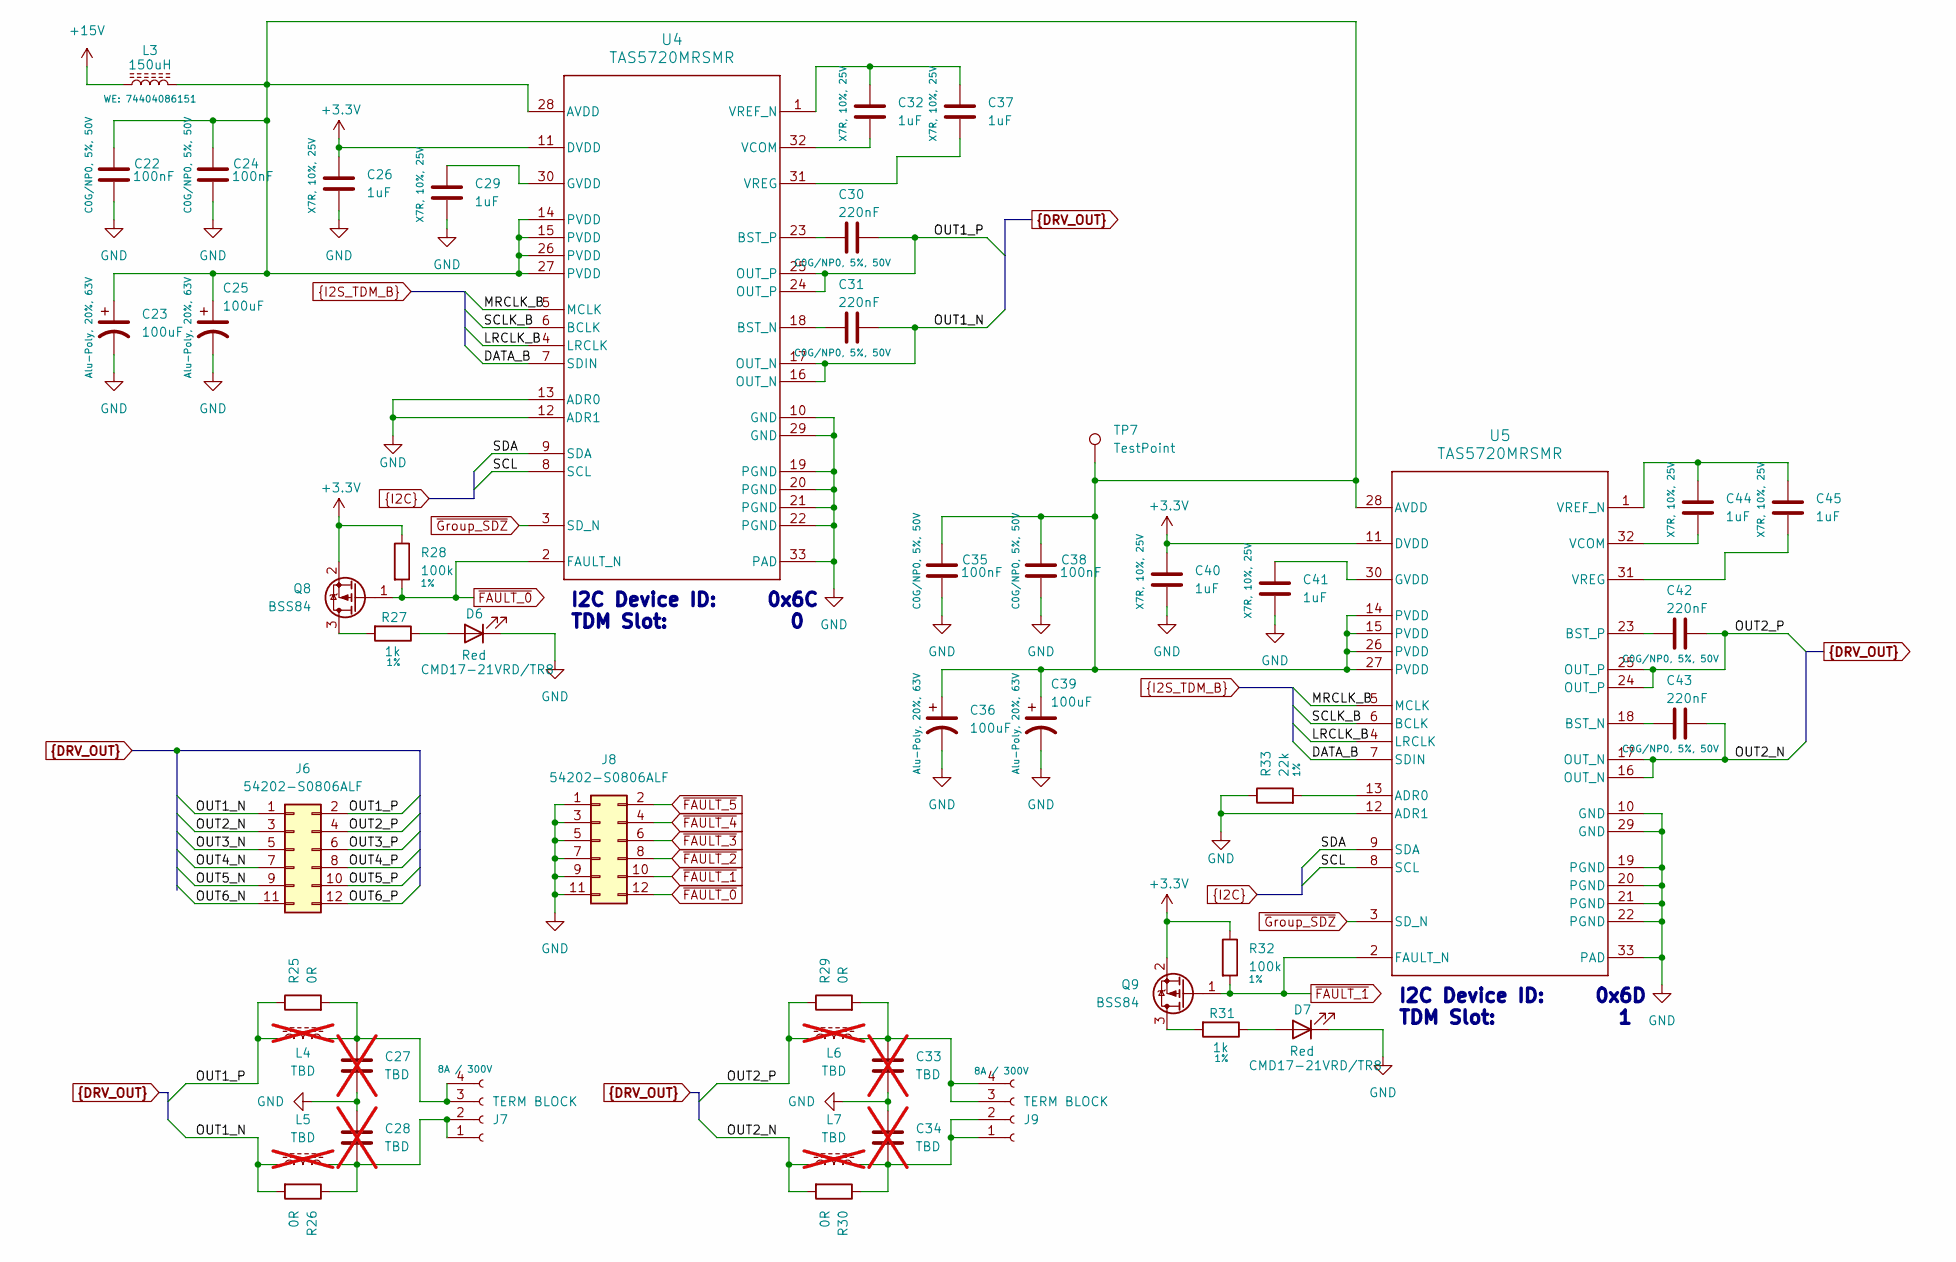
[picture p77: schematic DriversA.kicad_sch, Nathophone Driver Board]

Parts:
C22, C24, C35, C38: 100nF; C_1206_3216Metric; MPN GRM3195C1H104JA05D; DigiKey_PartNo 490-GRM3195C1H104JA05DTR-ND
C23, C25, C36, C39: 100uF; C_Elec_10x10.2; MPN A782MS107M1JLAS030; DigiKey_PartNo 399-A782MS107M1JLAS030TR-ND
C26, C29, C32, C37, C40, C41, C44, C45: 1uF; C_0805_2012Metric; MPN CL21B105KAFNNNE; DigiKey_PartNo 1276-1066-2-ND
C27, C28, C33, C34: TBD; C_2220_5750Metric; MPN SMDTC03680QB00MP00; DigiKey_PartNo 1928-1932-2-ND; not fitted
C30, C31, C42, C43: 220nF; C_1206_3216Metric; MPN GRM31C5C1H224JE02L; DigiKey_PartNo 490-GRM31C5C1H224JE02LTR-ND
D6, D7: CMD17-21VRD/TR8; LED_0805_2012Metric; MPN CMD17-21VRD/TR8; DigiKey_PartNo L62501TR-ND
J6, J8: 54202-S0806ALF; PinHeader_2x06_P2.54mm_Vertical_SMD; MPN 54202-S0806ALF; DigiKey_PartNo 609-54202-S0806ALFTR-ND
J7, J9: TERM BLOCK; CONN_1862042; MPN 1862042; DigiKey_PartNo 277-12154-ND
L3: 150uH; WE-LQS_8065; MPN 74404086151; DigiKey_PartNo 732-11733-2-ND
L4, L5, L6, L7: TBD; IND_SRU1048-150Y; MPN SRU1048-150Y; DigiKey_PartNo SRU1048-150YTR-ND; not fitted
Q8, Q9: BSS84; SOT-23; MPN BSS84; DigiKey_PartNo 5399-BSS84TR-ND
R25, R26, R29, R30: 0R; R_2010_5025Metric; MPN CRCW20100000Z0EF; DigiKey_PartNo 541-0.0WTR-ND
R27, R31: 1k; R_0805_2012Metric; MPN CRCW08051K00FKEA; DigiKey_PartNo 541-1.00KCTR-ND
R28, R32: 100k; R_0805_2012Metric; MPN CRCW0805100KFKEA; DigiKey_PartNo 541-100KCTR-ND
R33: 22k; R_0805_2012Metric; MPN CRCW080522K0FKEB; DigiKey_PartNo 541-CRCW080522K0FKEBTR-ND
TP7: TestPoint; TestPoint_Pad_D2.0mm
U4, U5: TAS5720MRSMR; VQFN32_RSM0032B_NV; MPN TAS5720MRSMR; DigiKey_PartNo 296-TAS5720MRSMRTR-ND

Connections:
+3.3V: C26.1, C40.1, Q8.2 (S), Q9.2 (S), R28.1, R32.1, U4.11 (DVDD), U5.11 (DVDD); also elsewhere on the board
+15V: L3.1; also elsewhere on the board
DATA_B: U4.7 (SDIN), U5.7 (SDIN); also elsewhere on the board
GND: C22.2, C23.2, C24.2, C25.2, C26.2, C27.2, C28.1, C29.2, C33.2, C34.1, C35.2, C36.2, C38.2, C39.2, C40.2, C41.2, D6.1 (K), D7.1 (K), J8.1, J8.3, J8.5, J8.7, J8.9, J8.11, R33.1, U4.10 (GND), U4.12 (ADR1), U4.13 (ADR0), U4.19 (PGND), U4.20 (PGND), U4.21 (PGND), U4.22 (PGND), U4.29 (GND), U4.33 (PAD), U5.10 (GND), U5.12 (ADR1), U5.19 (PGND), U5.20 (PGND), U5.21 (PGND), U5.22 (PGND), U5.29 (GND), U5.33 (PAD); also elsewhere on the board
LRCLK_B: U4.4 (LRCLK), U5.4 (LRCLK); also elsewhere on the board
MRCLK_B: U4.5 (MCLK), U5.5 (MCLK); also elsewhere on the board
unnamed: D6.2 (A), R27.1
unnamed: D7.2 (A), R31.1
unnamed: C28.2, J7.1, J7.2, L5.2, R26.1
unnamed: C27.1, J7.3, J7.4, L4.2, R25.2
unnamed: C34.2, J9.1, J9.2, L7.2, R30.1
unnamed: C33.1, J9.3, J9.4, L6.2, R29.2
unnamed: Q8.3 (D), R27.2
unnamed: Q9.3 (D), R31.2
unnamed: C22.1, C23.1, C24.1, C25.1, C35.1, C36.1, C38.1, C39.1, L3.2, TP7.1, U4.14 (PVDD), U4.15 (PVDD), U4.26 (PVDD), U4.27 (PVDD), U4.28 (AVDD), U5.14 (PVDD), U5.15 (PVDD), U5.26 (PVDD), U5.27 (PVDD), U5.28 (AVDD)
unnamed: C31.1, U4.18 (BST_N)
unnamed: C30.1, U4.23 (BST_P)
unnamed: C29.1, U4.30 (GVDD)
unnamed: C32.2, U4.32 (VCOM)
unnamed: C32.1, C37.1, U4.1 (VREF_N)
unnamed: C37.2, U4.31 (VREG)
unnamed: R33.2, U5.13 (ADR0)
unnamed: C43.1, U5.18 (BST_N)
unnamed: C42.1, U5.23 (BST_P)
unnamed: C41.1, U5.30 (GVDD)
unnamed: C44.2, U5.32 (VCOM)
unnamed: C44.1, C45.1, U5.1 (VREF_N)
unnamed: C45.2, U5.31 (VREG)
OUT1_N: C31.2, J6.1, L5.1, R26.2, U4.16 (OUT_N), U4.17 (OUT_N)
OUT1_P: C30.2, J6.2, L4.1, R25.1, U4.24 (OUT_P), U4.25 (OUT_P)
OUT2_N: C43.2, J6.3, L7.1, R30.2, U5.16 (OUT_N), U5.17 (OUT_N)
OUT2_P: C42.2, J6.4, L6.1, R29.1, U5.24 (OUT_P), U5.25 (OUT_P)
OUT3_N: J6.5; also elsewhere on the board
OUT3_P: J6.6; also elsewhere on the board
OUT4_N: J6.7; also elsewhere on the board
OUT4_P: J6.8; also elsewhere on the board
OUT5_N: J6.9; also elsewhere on the board
OUT5_P: J6.10; also elsewhere on the board
OUT6_N: J6.11; also elsewhere on the board
OUT6_P: J6.12; also elsewhere on the board
SCL: U4.8 (SCL), U5.8 (SCL); also elsewhere on the board
SCLK_B: U4.6 (BCLK), U5.6 (BCLK); also elsewhere on the board
SDA: U4.9 (SDA), U5.9 (SDA); also elsewhere on the board
~FAULT_0: J8.12, Q8.1 (G), R28.2, U4.2 (FAULT_N)
~FAULT_1: J8.10, Q9.1 (G), R32.2, U5.2 (FAULT_N)
~FAULT_2: J8.8; also elsewhere on the board
~FAULT_3: J8.6; also elsewhere on the board
~FAULT_4: J8.4; also elsewhere on the board
~FAULT_5: J8.2; also elsewhere on the board
~Group_SDZ: U4.3 (SD_N), U5.3 (SD_N); also elsewhere on the board

Notes on the sheet:
I2C Device ID: 0x6C TDM Slot: 0
I2C Device ID: 0x6D TDM Slot: 1

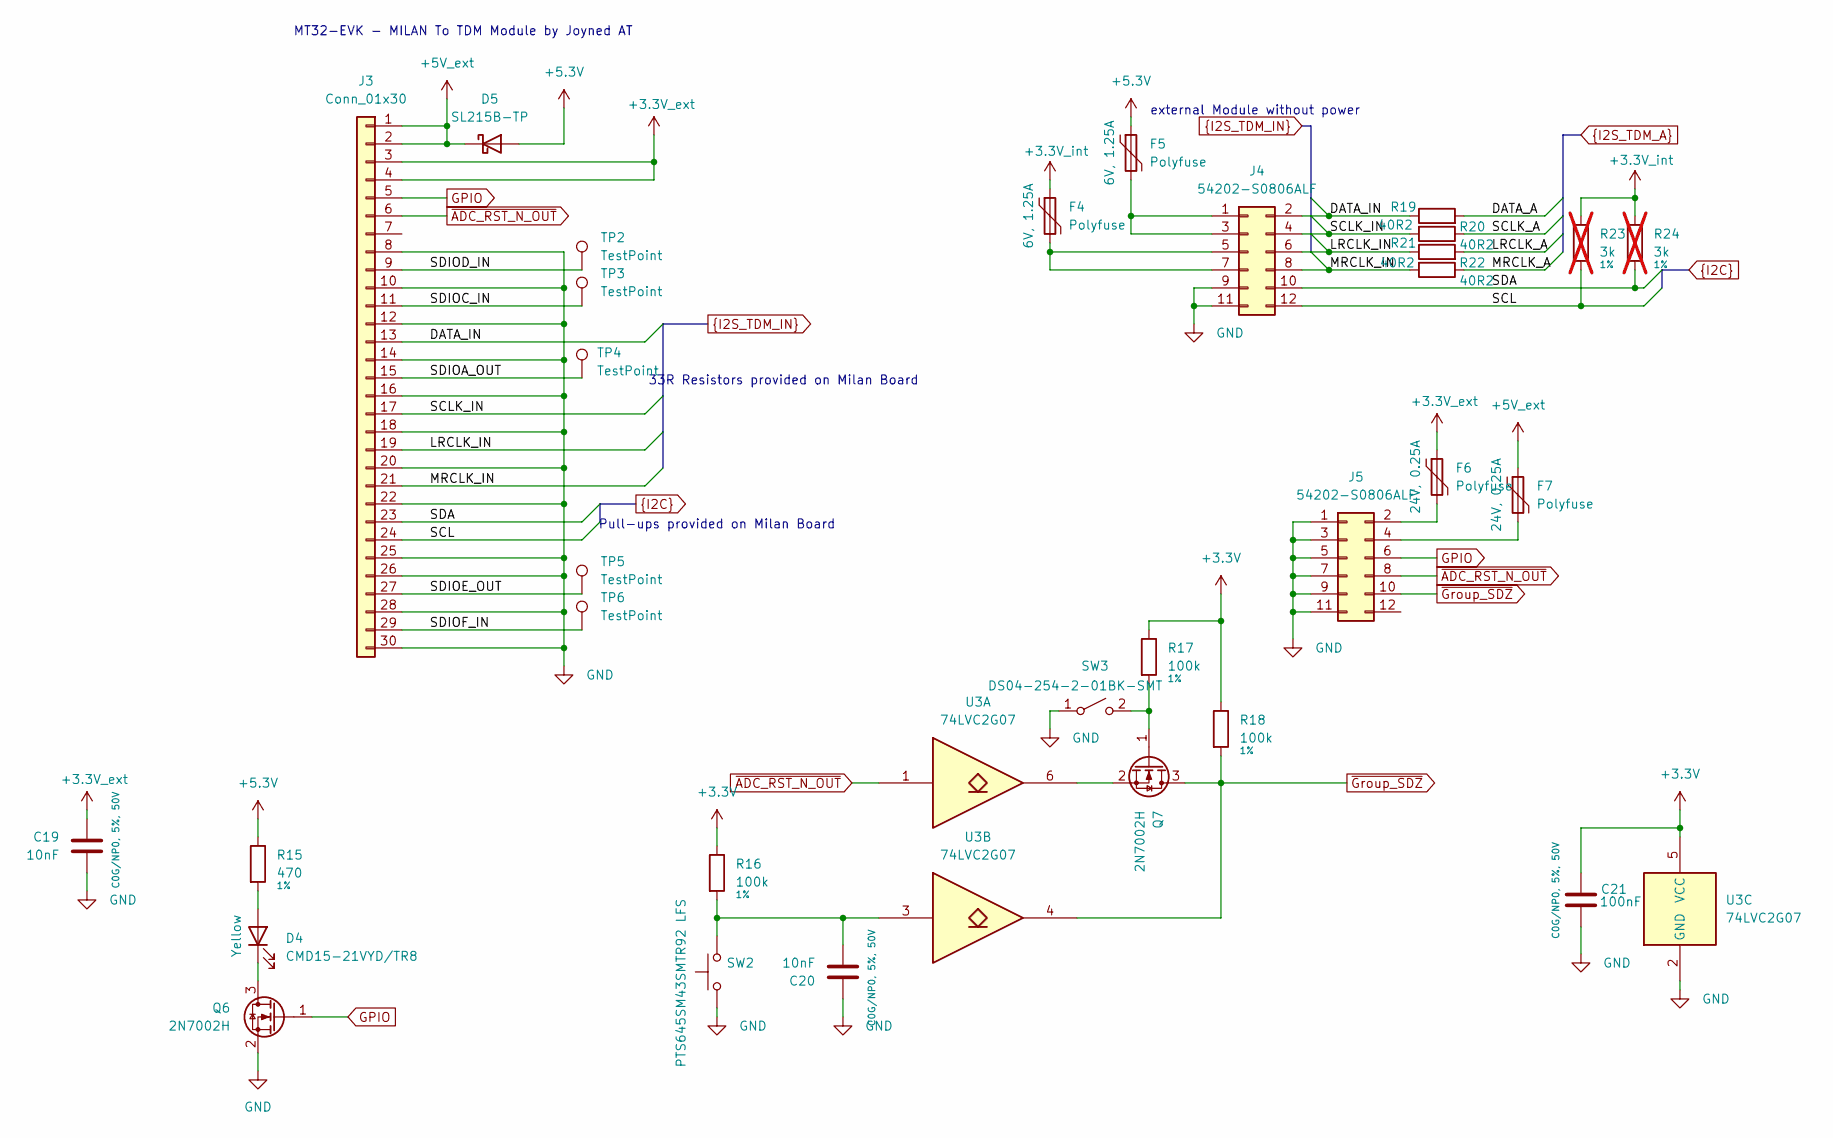
[picture p78: schematic Nathophone_PCB_Data.kicad_sch, Nathophone Driver Board]

Parts:
C19, C20: 10nF; C_0805_2012Metric; MPN CL21C103JBF1PNE; DigiKey_PartNo 1276-6790-2-ND
C21: 100nF; C_1206_3216Metric; MPN GRM3195C1H104JA05D; DigiKey_PartNo 490-GRM3195C1H104JA05DTR-ND
D4: CMD15-21VYD/TR8; LED_1206_3216Metric; MPN CMD15-21VYD/TR8; DigiKey_PartNo L62307TR-ND
D5: SL215B-TP; D_SMB; MPN SL215B-TP; DigiKey_PartNo 353-SL215B-TPTR-ND
F4, F5: Polyfuse; Fuse_1812_4532Metric; MPN MINISMDC125F-2; DigiKey_PartNo MINISMDC125F-2TR-ND
F6, F7: Polyfuse; Fuse_1206_3216Metric; MPN 0ZCJ0025AF2E; DigiKey_PartNo 5923-0ZCJ0025AF2ETR-ND
J3: Conn_01x30; CON_525593072_MOL; MPN 0525593072; DigiKey_PartNo 900-0525593072TR-ND
J4, J5: 54202-S0806ALF; PinHeader_2x06_P2.54mm_Vertical_SMD; MPN 54202-S0806ALF; DigiKey_PartNo 609-54202-S0806ALFTR-ND
Q6, Q7: 2N7002H; SOT-23; MPN 2N7002H-7; DigiKey_PartNo 2N7002H-7DITR-ND
R15: 470; R_0805_2012Metric; MPN CRCW0805470RJNEA; DigiKey_PartNo 541-470ATR-ND
R16, R17, R18: 100k; R_0805_2012Metric; MPN CRCW0805100KFKEA; DigiKey_PartNo 541-100KCTR-ND
R19, R20, R21, R22: 40R2; R_0805_2012Metric; MPN CRCW080540R2FKEA; DigiKey_PartNo 541-40.2CTR-ND
R23, R24: 3k; R_0805_2012Metric; MPN CRCW08053K00FKEA; DigiKey_PartNo 541-3.00KCTR-ND; not fitted
SW2: PTS645SM43SMTR92 LFS; SW_SPST_PTS645Sx43SMTR92; MPN PTS645SM43SMTR92 LFS; DigiKey_PartNo CKN9112TR-ND
SW3: DS04-254-2-01BK-SMT; SW_DS04-254-2-01BK-SMT; MPN DS04-254-2-01BK-SMT; DigiKey_PartNo 2223-DS04-254-2-01BK-SMT-ND
TP2, TP3, TP4, TP5, TP6: TestPoint; TestPoint_Pad_D2.0mm
U3: 74LVC2G07; SOT65P210X110-6N; MPN SN74LVC2G07DCKR; DigiKey_PartNo 296-13495-2-ND

Connections:
+3.3V: C21.1, R16.1, R17.1, R18.1, U3.5 (VCC); also elsewhere on the board
+3.3V_ext: C19.1, F6.1, J3.3, J3.4; also elsewhere on the board
+3.3V_int: F4.1, R23.1, R24.1; also elsewhere on the board
+5.3V: D5.2 (A), F5.1, R15.1; also elsewhere on the board
+5V_ext: D5.1 (K), F7.1, J3.1, J3.2
/Data+Power Connections/SDIOA_OUT: J3.15, TP4.1
/Data+Power Connections/SDIOC_IN: J3.11, TP3.1
/Data+Power Connections/SDIOD_IN: J3.9, TP2.1
/Data+Power Connections/SDIOE_OUT: J3.27, TP5.1
/Data+Power Connections/SDIOF_IN: J3.29, TP6.1
DATA_A: R19.2; also elsewhere on the board
DATA_IN: J3.13, J4.2, R19.1
GND: C19.2, C20.1, C21.2, J3.8, J3.10, J3.12, J3.14, J3.16, J3.18, J3.20, J3.22, J3.25, J3.26, J3.28, J3.30, J4.9, J4.11, J5.1, J5.3, J5.5, J5.7, J5.9, J5.11, Q6.2 (S), SW2.1, SW3.1 (A), U3.2 (GND); also elsewhere on the board
GPIO: J3.5, J5.6, Q6.1 (G)
LRCLK_A: R21.2; also elsewhere on the board
LRCLK_IN: J3.19, J4.6, R21.1
MRCLK_A: R22.1; also elsewhere on the board
MRCLK_IN: J3.21, J4.8, R22.2
unnamed: C20.2, R16.2, SW2.2, U3.3
unnamed: D4.2 (A), R15.2
unnamed: D4.1 (K), Q6.3 (D)
unnamed: F5.2, J4.1, J4.3
unnamed: F4.2, J4.5, J4.7
unnamed: F6.2, J5.2
unnamed: F7.2, J5.4
unnamed: Q7.1 (G), R17.2, SW3.2 (B)
unnamed: Q7.2 (S), U3.6
SCL: J3.24, J4.12, R23.2; also elsewhere on the board
SCLK_A: R20.1; also elsewhere on the board
SCLK_IN: J3.17, J4.4, R20.2
SDA: J3.23, J4.10, R24.2; also elsewhere on the board
~ADC_RST_N_OUT: J3.6, J5.8, U3.1
~Group_SDZ: J5.10, Q7.3 (D), R18.2, U3.4; also elsewhere on the board

Notes on the sheet:
MT32-EVK - MILAN To TDM Module by Joyned AT
external Module without power
33R Resistors provided on Milan Board
Pull-ups provided on Milan Board

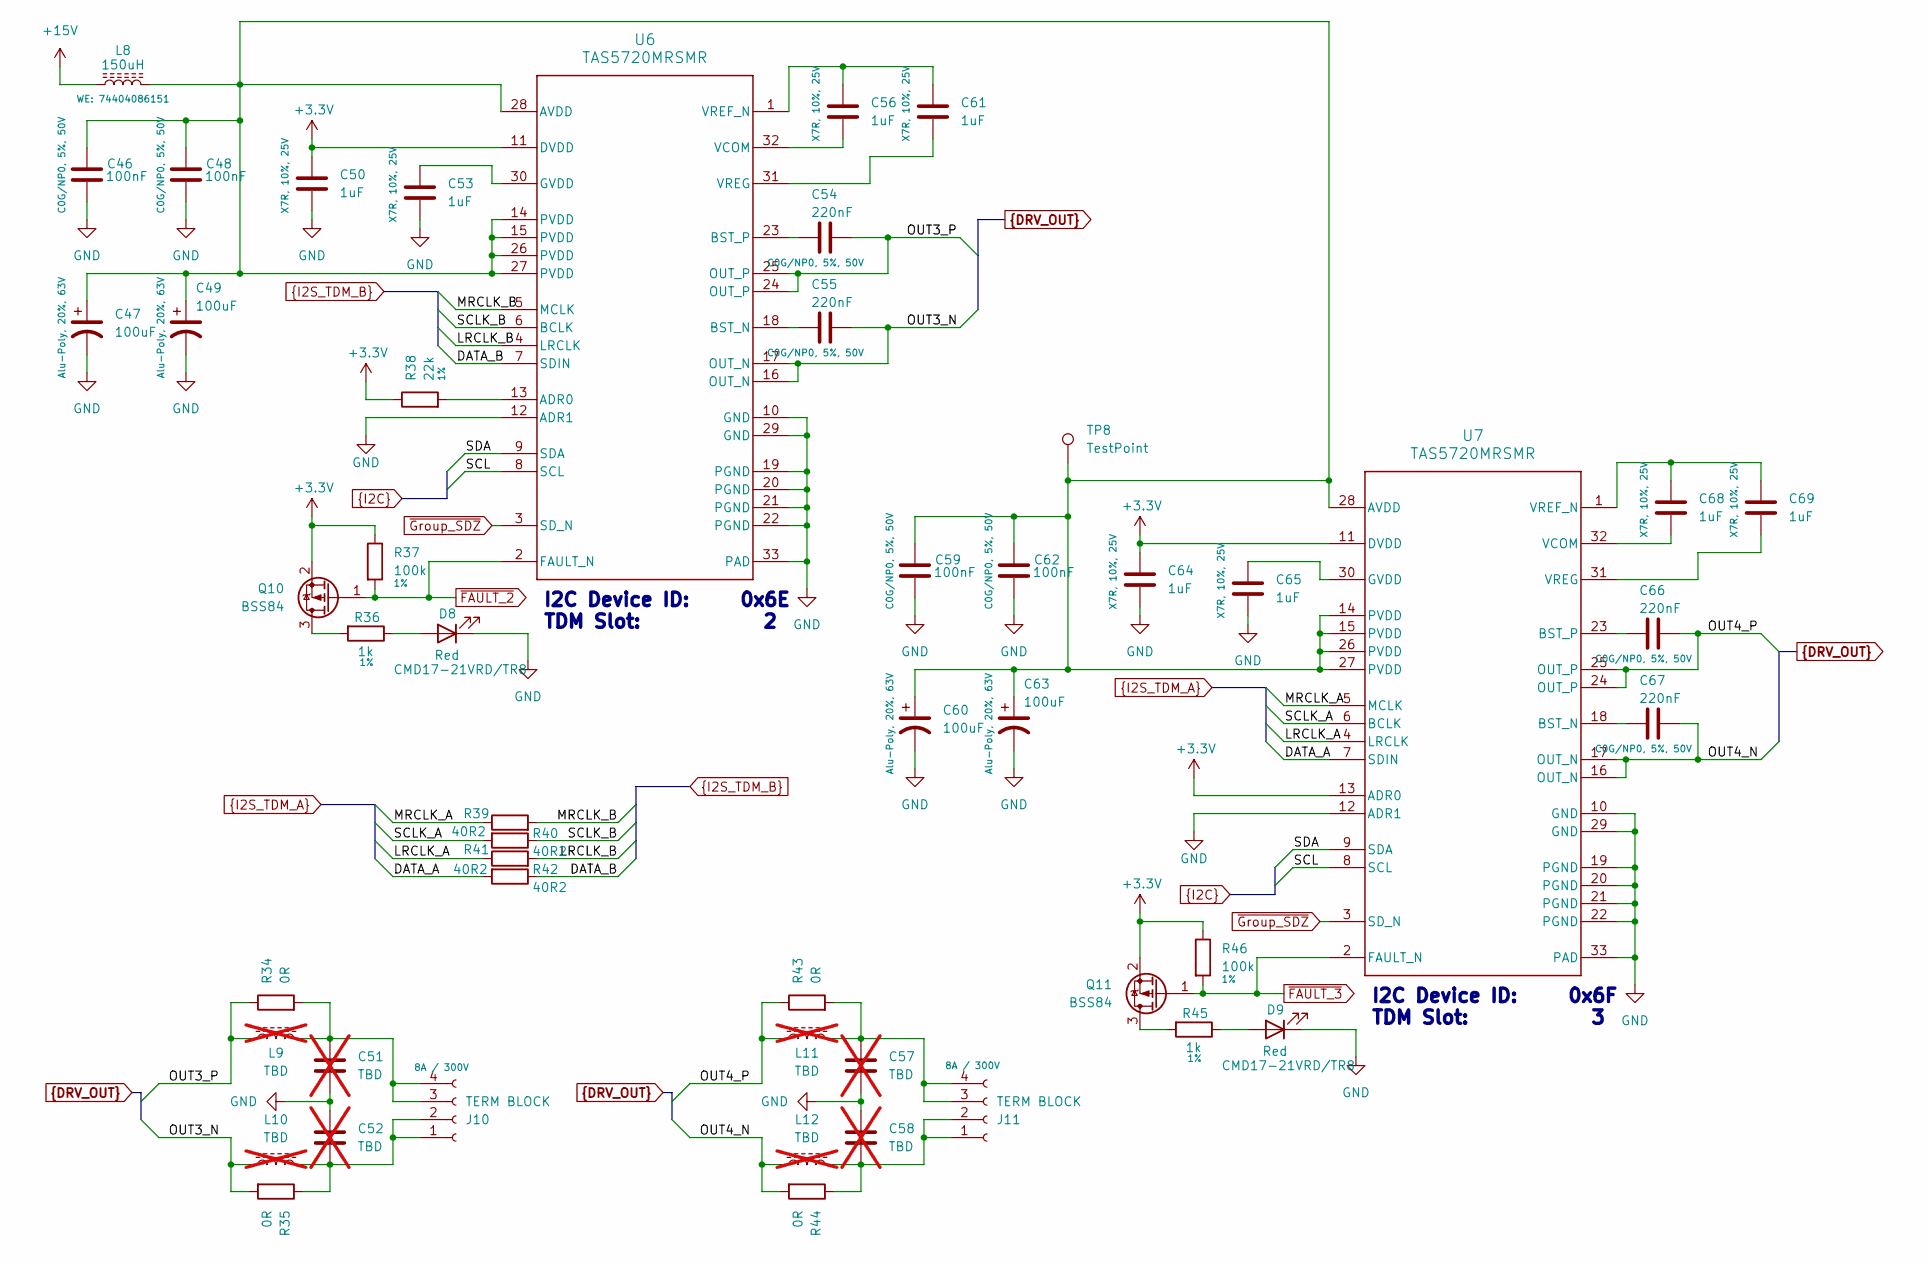
[picture p79: schematic DriversB.kicad_sch, Nathophone Driver Board]

Parts:
C46, C48, C59, C62: 100nF; C_1206_3216Metric; MPN GRM3195C1H104JA05D; DigiKey_PartNo 490-GRM3195C1H104JA05DTR-ND
C47, C49, C60, C63: 100uF; C_Elec_10x10.2; MPN A782MS107M1JLAS030; DigiKey_PartNo 399-A782MS107M1JLAS030TR-ND
C50, C53, C56, C61, C64, C65, C68, C69: 1uF; C_0805_2012Metric; MPN CL21B105KAFNNNE; DigiKey_PartNo 1276-1066-2-ND
C51, C52, C57, C58: TBD; C_2220_5750Metric; MPN SMDTC03680QB00MP00; DigiKey_PartNo 1928-1932-2-ND; not fitted
C54, C55, C66, C67: 220nF; C_1206_3216Metric; MPN GRM31C5C1H224JE02L; DigiKey_PartNo 490-GRM31C5C1H224JE02LTR-ND
D8, D9: CMD17-21VRD/TR8; LED_0805_2012Metric; MPN CMD17-21VRD/TR8; DigiKey_PartNo L62501TR-ND
J10, J11: TERM BLOCK; CONN_1862042; MPN 1862042; DigiKey_PartNo 277-12154-ND
L8: 150uH; WE-LQS_8065; MPN 74404086151; DigiKey_PartNo 732-11733-2-ND
L9, L10, L11, L12: TBD; IND_SRU1048-150Y; MPN SRU1048-150Y; DigiKey_PartNo SRU1048-150YTR-ND; not fitted
Q10, Q11: BSS84; SOT-23; MPN BSS84; DigiKey_PartNo 5399-BSS84TR-ND
R34, R35, R43, R44: 0R; R_2010_5025Metric; MPN CRCW20100000Z0EF; DigiKey_PartNo 541-0.0WTR-ND
R36, R45: 1k; R_0805_2012Metric; MPN CRCW08051K00FKEA; DigiKey_PartNo 541-1.00KCTR-ND
R37, R46: 100k; R_0805_2012Metric; MPN CRCW0805100KFKEA; DigiKey_PartNo 541-100KCTR-ND
R38: 22k; R_0805_2012Metric; MPN CRCW080522K0FKEB; DigiKey_PartNo 541-CRCW080522K0FKEBTR-ND
R39, R40, R41, R42: 40R2; R_0805_2012Metric; MPN CRCW080540R2FKEA; DigiKey_PartNo 541-40.2CTR-ND
TP8: TestPoint; TestPoint_Pad_D2.0mm
U6, U7: TAS5720MRSMR; VQFN32_RSM0032B_NV; MPN TAS5720MRSMR; DigiKey_PartNo 296-TAS5720MRSMRTR-ND

Connections:
+3.3V: C50.1, C64.1, Q10.2 (S), Q11.2 (S), R37.1, R38.1, R46.1, U6.11 (DVDD), U7.11 (DVDD), U7.13 (ADR0); also elsewhere on the board
+15V: L8.1; also elsewhere on the board
DATA_A: R42.2, U7.7 (SDIN); also elsewhere on the board
DATA_B: R42.1, U6.7 (SDIN); also elsewhere on the board
GND: C46.2, C47.2, C48.2, C49.2, C50.2, C51.2, C52.1, C53.2, C57.2, C58.1, C59.2, C60.2, C62.2, C63.2, C64.2, C65.2, D8.1 (K), D9.1 (K), U6.10 (GND), U6.12 (ADR1), U6.19 (PGND), U6.20 (PGND), U6.21 (PGND), U6.22 (PGND), U6.29 (GND), U6.33 (PAD), U7.10 (GND), U7.12 (ADR1), U7.19 (PGND), U7.20 (PGND), U7.21 (PGND), U7.22 (PGND), U7.29 (GND), U7.33 (PAD); also elsewhere on the board
LRCLK_A: R41.1, U7.4 (LRCLK); also elsewhere on the board
LRCLK_B: R41.2, U6.4 (LRCLK); also elsewhere on the board
MRCLK_A: R39.1, U7.5 (MCLK); also elsewhere on the board
MRCLK_B: R39.2, U6.5 (MCLK); also elsewhere on the board
unnamed: D8.2 (A), R36.1
unnamed: D9.2 (A), R45.1
unnamed: C52.2, J10.1, J10.2, L10.2, R35.1
unnamed: C51.1, J10.3, J10.4, L9.2, R34.2
unnamed: C58.2, J11.1, J11.2, L12.2, R44.1
unnamed: C57.1, J11.3, J11.4, L11.2, R43.2
unnamed: Q10.3 (D), R36.2
unnamed: Q11.3 (D), R45.2
unnamed: R38.2, U6.13 (ADR0)
unnamed: C46.1, C47.1, C48.1, C49.1, C59.1, C60.1, C62.1, C63.1, L8.2, TP8.1, U6.14 (PVDD), U6.15 (PVDD), U6.26 (PVDD), U6.27 (PVDD), U6.28 (AVDD), U7.14 (PVDD), U7.15 (PVDD), U7.26 (PVDD), U7.27 (PVDD), U7.28 (AVDD)
unnamed: C55.1, U6.18 (BST_N)
unnamed: C54.1, U6.23 (BST_P)
unnamed: C53.1, U6.30 (GVDD)
unnamed: C56.2, U6.32 (VCOM)
unnamed: C56.1, C61.1, U6.1 (VREF_N)
unnamed: C61.2, U6.31 (VREG)
unnamed: C67.1, U7.18 (BST_N)
unnamed: C66.1, U7.23 (BST_P)
unnamed: C65.1, U7.30 (GVDD)
unnamed: C68.2, U7.32 (VCOM)
unnamed: C68.1, C69.1, U7.1 (VREF_N)
unnamed: C69.2, U7.31 (VREG)
OUT3_N: C55.2, L10.1, R35.2, U6.16 (OUT_N), U6.17 (OUT_N); also elsewhere on the board
OUT3_P: C54.2, L9.1, R34.1, U6.24 (OUT_P), U6.25 (OUT_P); also elsewhere on the board
OUT4_N: C67.2, L12.1, R44.2, U7.16 (OUT_N), U7.17 (OUT_N); also elsewhere on the board
OUT4_P: C66.2, L11.1, R43.1, U7.24 (OUT_P), U7.25 (OUT_P); also elsewhere on the board
SCL: U6.8 (SCL), U7.8 (SCL); also elsewhere on the board
SCLK_A: R40.2, U7.6 (BCLK); also elsewhere on the board
SCLK_B: R40.1, U6.6 (BCLK); also elsewhere on the board
SDA: U6.9 (SDA), U7.9 (SDA); also elsewhere on the board
~FAULT_2: Q10.1 (G), R37.2, U6.2 (FAULT_N); also elsewhere on the board
~FAULT_3: Q11.1 (G), R46.2, U7.2 (FAULT_N); also elsewhere on the board
~Group_SDZ: U6.3 (SD_N), U7.3 (SD_N); also elsewhere on the board

Notes on the sheet:
I2C Device ID: 0x6F TDM Slot: 3
I2C Device ID: 0x6E TDM Slot: 2

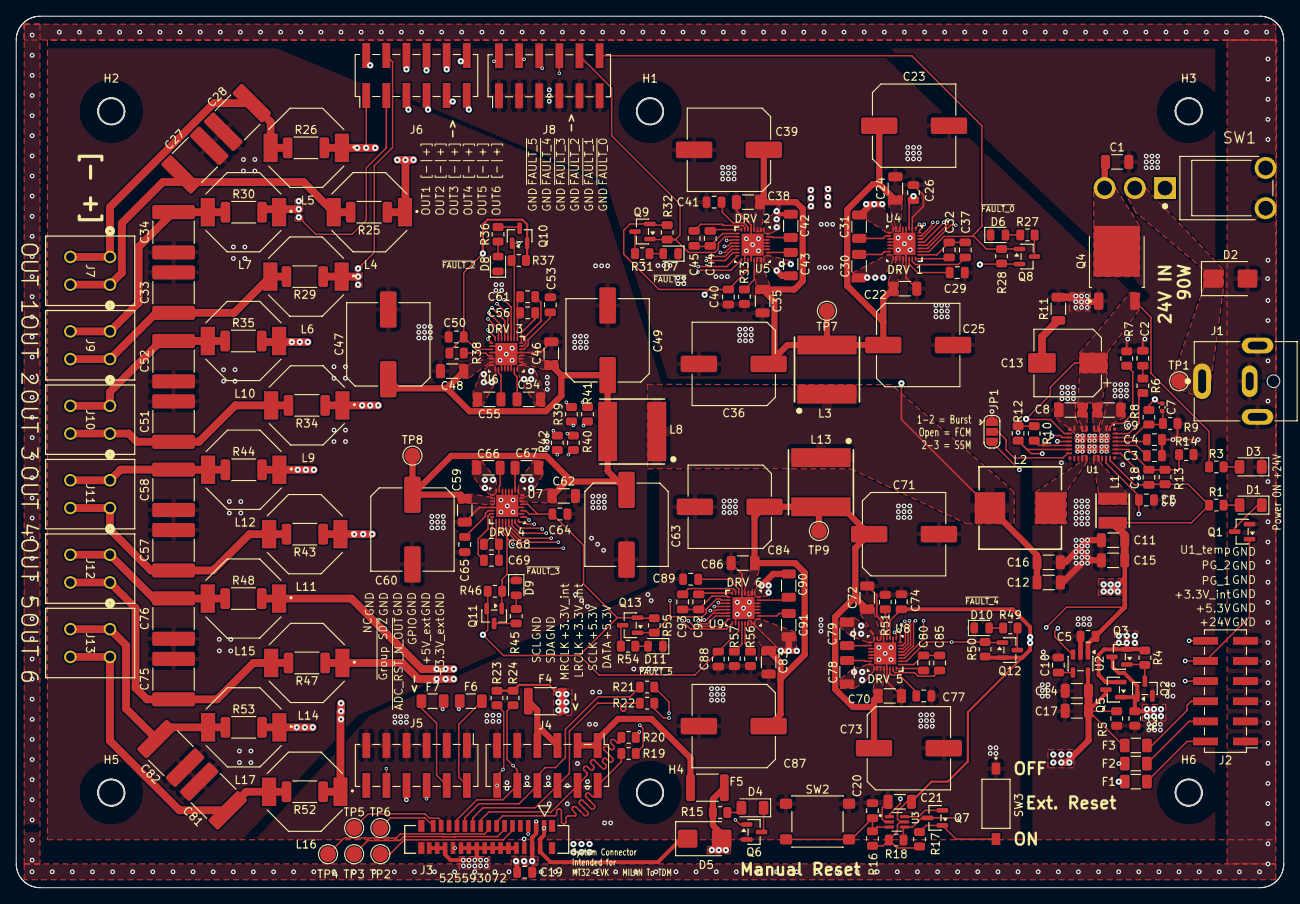
[picture p80: board Nathophone_driver_board.kicad_pcb from above]

Board: 4 copper layers, 160.0 x 110.0 mm, 239 parts (0 on the bottom side), 150 nets.
