Violabitch5/Nathophone_elec/joyned_xmos_xe216-main/xmos_avb_brd_V4.brd

## EAGLE design joyned_xmos_xe216-main/xmos_avb_brd_V4.brd (2025-07-29)

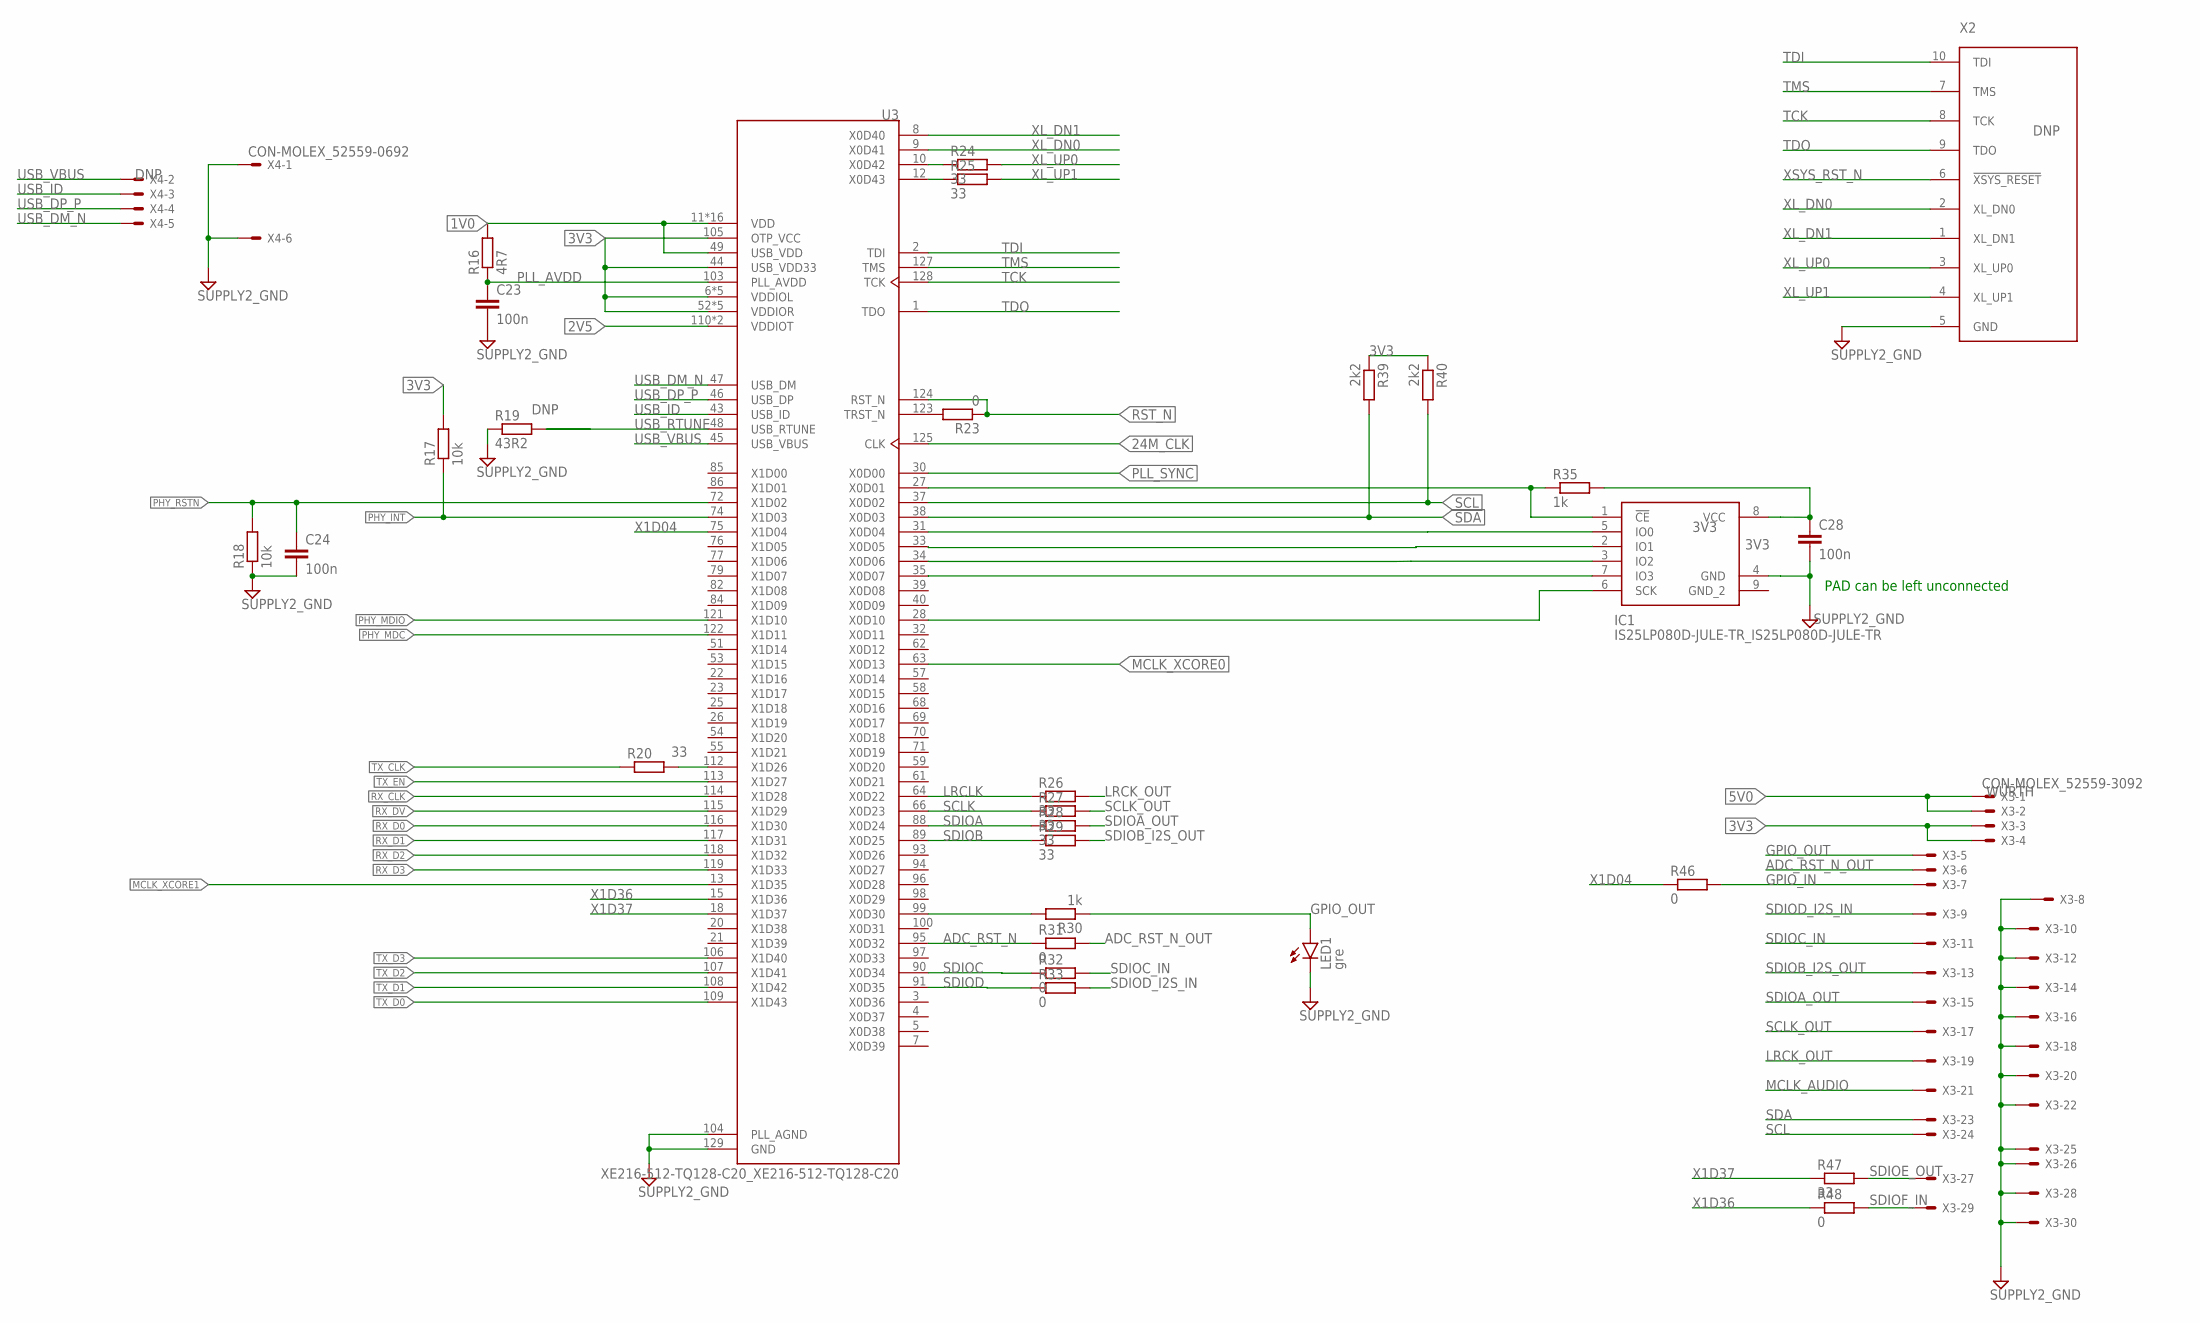
[picture p81: schematic xmos_avb_brd_V4.sch, sheet 1, XMOS]

Parts:
C23, C24, C28: 100n; RCL_C0402
IC1: IS25LP080D-JULE-TR_IS25LP080D-JULE-TR; IS25LP080D-JULE-TR_SON50P300X200X55-9N
LED1: gre; LED_CHIP-LED0603
R16: 4R7; RCL_R0402
R17, R18: 10k; RCL_R0402
R19: 43R2; RCL_R0402
R20, R24, R25, R26, R27, R28, R29, R47: 33; RCL_R0402
R23, R31, R32, R33, R46, R48: 0; RCL_R0402
R30, R35: 1k; RCL_R0402
R39, R40: 2k2; RCL_R0402
U3: XE216-512-TQ128-C20_XE216-512-TQ128-C20; XE216-512-TQ128-C20_QFP40P1600X1600X120-129N
X2: TC2050-XTAG_TC2050-NL-MCP-NL; TC2050-XTAG_TC2030-MCP-NL
X3: CON-MOLEX_52559-3092; MPN 687330124422
X4: CON-MOLEX_52559-0692

Connections:
1V0: R16.2, U3.11 (VDD), U3.16 (VDD), U3.17 (VDD), U3.24 (VDD), U3.36 (VDD), U3.41 (VDD), U3.49 (USB_VDD), U3.56 (VDD), U3.60 (VDD), U3.73 (VDD), U3.80 (VDD), U3.81 (VDD), U3.87 (VDD), U3.101 (VDD), U3.102 (VDD), U3.120 (VDD), U3.126 (VDD); also elsewhere on the board
2V5: U3.110 (VDDIOT), U3.111 (VDDIOT); also elsewhere on the board
3V3: C28.1, IC1.8 (VCC), R17.2, R35.2, R39.1, R40.1, U3.6 (VDDIOL), U3.14 (VDDIOL), U3.19 (VDDIOL), U3.29 (VDDIOL), U3.42 (VDDIOL), U3.44 (USB_VDD33), U3.52 (VDDIOR), U3.67 (VDDIOR), U3.78 (VDDIOR), U3.83 (VDDIOR), U3.92 (VDDIOR), U3.105 (OTP_VCC), X3.3, X3.4; also elsewhere on the board
5V0: X3.1, X3.2; also elsewhere on the board
24M_CLK: U3.125 (CLK); also elsewhere on the board
ADC_RST_N: R31.1, U3.95 (X0D32)
ADC_RST_N_OUT: R31.2, X3.6
GND: C23.2, C24.2, C28.2, IC1.4 (GND), LED1.C, R18.1, R19.1, U3.104 (PLL_AGND), U3.129 (GND), X2.5 (GND), X3.8, X3.10, X3.12, X3.14, X3.16, X3.18, X3.20, X3.22, X3.25, X3.26, X3.28, X3.30, X4.1, X4.6; also elsewhere on the board
GPIO_IN: R46.2, X3.7
GPIO_OUT: LED1.A, R30.1, X3.5
LRCK_OUT: R26.2, X3.19
LRCLK: R26.1, U3.64 (X0D22)
MCLK_AUDIO: X3.21; also elsewhere on the board
MCLK_XCORE0: U3.63 (X0D13); also elsewhere on the board
MCLK_XCORE1: U3.13 (X1D35); also elsewhere on the board
unnamed: R30.2, U3.99 (X0D30)
unnamed: IC1.6 (SCK), U3.28 (X0D10)
unnamed: IC1.5 (IO0), U3.31 (X0D04)
unnamed: IC1.2 (IO1), U3.33 (X0D05)
unnamed: IC1.3 (IO2), U3.34 (X0D06)
unnamed: R20.2, U3.112 (X1D26)
unnamed: IC1.7 (IO3), U3.35 (X0D07)
unnamed: R24.1, U3.10 (X0D42)
unnamed: R25.1, U3.12 (X0D43)
unnamed: R23.2, U3.123 (TRST_N)
PHY_INT: R17.1, U3.74 (X1D03); also elsewhere on the board
PHY_MDC: U3.122 (X1D11); also elsewhere on the board
PHY_MDIO: U3.121 (X1D10); also elsewhere on the board
PHY_RSTN: C24.1, R18.2, U3.72 (X1D02); also elsewhere on the board
PLL_AVDD: C23.1, R16.1, U3.103 (PLL_AVDD)
PLL_SYNC: U3.30 (X0D00); also elsewhere on the board
RST_N: R23.1, U3.124 (RST_N); also elsewhere on the board
RX_CLK: U3.114 (X1D28); also elsewhere on the board
RX_D0: U3.116 (X1D30); also elsewhere on the board
RX_D1: U3.117 (X1D31); also elsewhere on the board
RX_D2: U3.118 (X1D32); also elsewhere on the board
RX_D3: U3.119 (X1D33); also elsewhere on the board
RX_DV: U3.115 (X1D29); also elsewhere on the board
SCL: R40.2, U3.37 (X0D02), X3.24; also elsewhere on the board
SCLK: R27.1, U3.66 (X0D23)
SCLK_OUT: R27.2, X3.17
SDA: R39.2, U3.38 (X0D03), X3.23; also elsewhere on the board
SDIOA: R28.1, U3.88 (X0D24)
SDIOA_OUT: R28.2, X3.15
SDIOB: R29.1, U3.89 (X0D25)
SDIOB_I2S_OUT: R29.2, X3.13
SDIOC: R32.1, U3.90 (X0D34)
SDIOC_IN: R32.2, X3.11
SDIOD: R33.1, U3.91 (X0D35)
SDIOD_I2S_IN: R33.2, X3.9
SDIOE_OUT: R47.2, X3.27
SDIOF_IN: R48.2, X3.29
SPI_CS: IC1.1 (!CE), R35.1, U3.27 (X0D01)
TCK: U3.128 (TCK), X2.8 (TCK)
TDI: U3.2 (TDI), X2.10 (TDI)
TDO: U3.1 (TDO), X2.9 (TDO)
TMS: U3.127 (TMS), X2.7 (TMS)
TX_CLK: R20.1; also elsewhere on the board
TX_D0: U3.109 (X1D43); also elsewhere on the board
TX_D1: U3.108 (X1D42); also elsewhere on the board
TX_D2: U3.107 (X1D41); also elsewhere on the board
TX_D3: U3.106 (X1D40); also elsewhere on the board
TX_EN: U3.113 (X1D27); also elsewhere on the board
USB_DM_N: U3.47 (USB_DM), X4.5
USB_DP_P: U3.46 (USB_DP), X4.4
USB_ID: U3.43 (USB_ID), X4.3
USB_RTUNE: R19.2, U3.48 (USB_RTUNE)
USB_VBUS: U3.45 (USB_VBUS), X4.2
X1D04: R46.1, U3.75 (X1D04)
X1D36: R48.1, U3.15 (X1D36)
X1D37: R47.1, U3.18 (X1D37)
XL_DN0: U3.9 (X0D41), X2.2 (XL_DN0)
XL_DN1: U3.8 (X0D40), X2.1 (XL_DN1)
XL_UP0: R24.2, X2.3 (XL_UP0)
XL_UP1: R25.2, X2.4 (XL_UP1)
XSYS_RST_N: X2.6 (!XSYS_RESET); also elsewhere on the board

Notes on the sheet:
PAD can be left unconnected

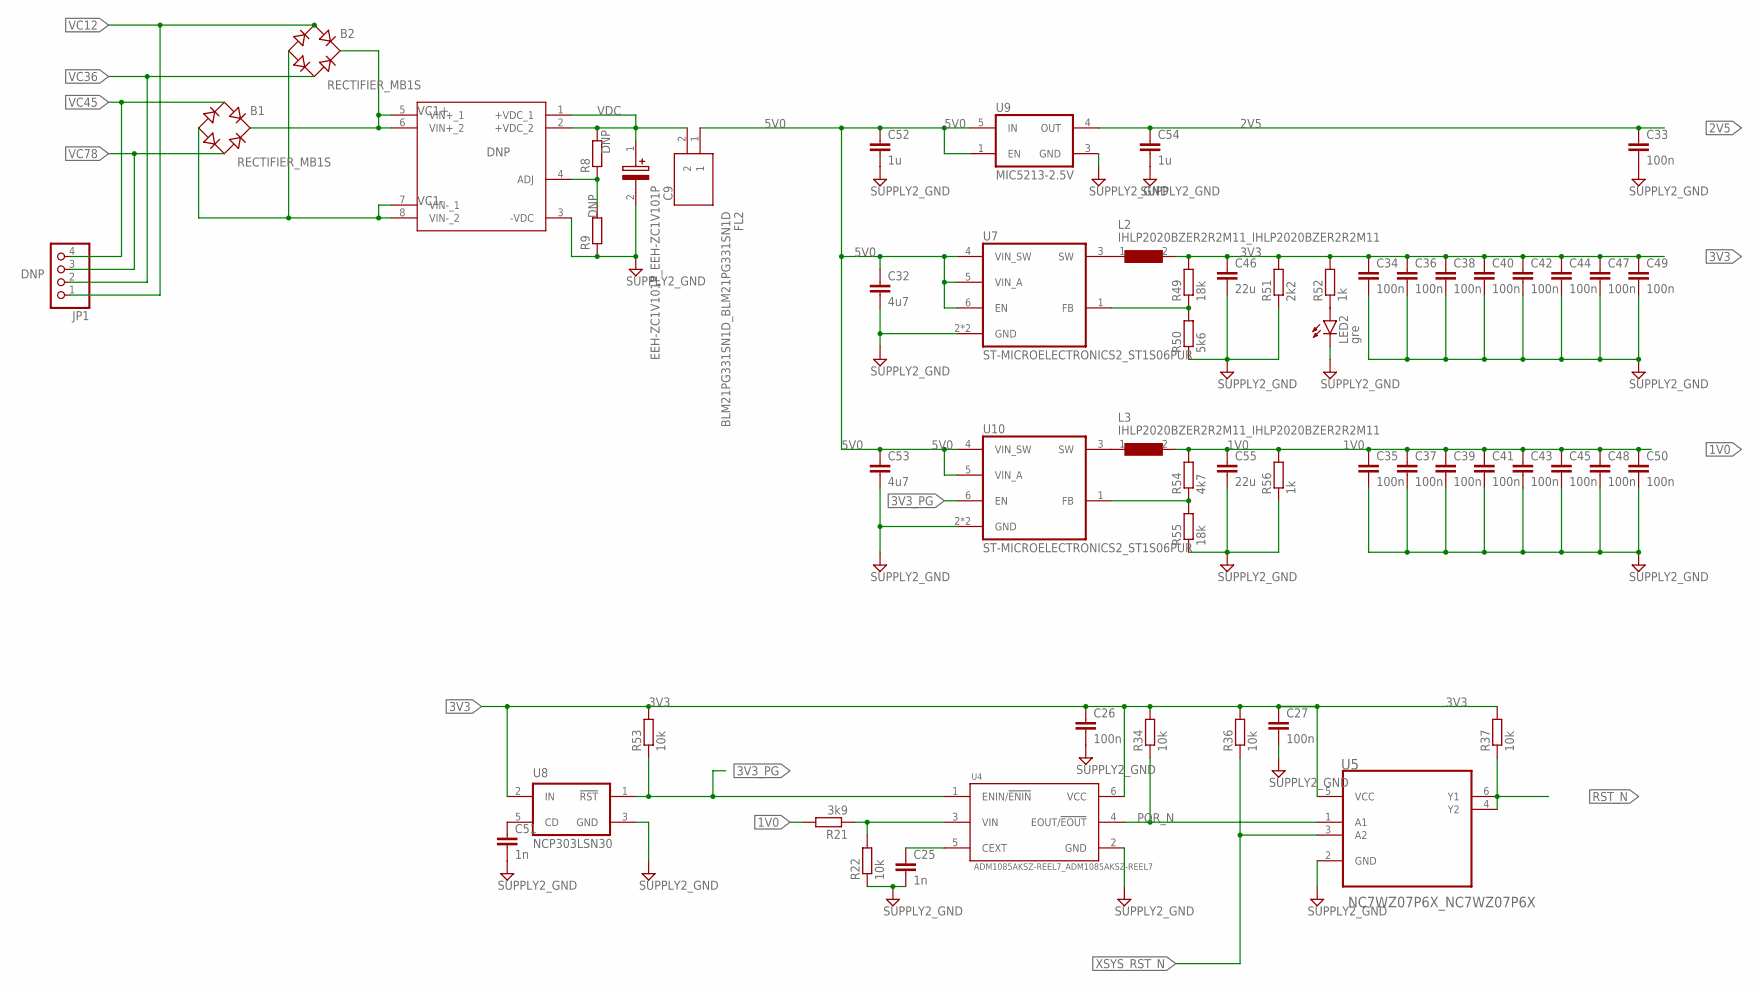
[picture p82: schematic xmos_avb_brd_V4.sch, sheet 2, Power supplies & Reset]

Parts:
B1, B2: RECTIFIER_MB1S; RECTIFIER_SOIC-4
C9: EEH-ZC1V101P_EEH-ZC1V101P; EEH-ZC1V101P_CAPAE830X1050N
C25, C51: 1n; RCL_C0402
C26, C27, C33, C34, C35, C36, C37, C38, C39, C40, C41, C42, C43, C44, C45, C47, C48, C49, C50: 100n; RCL_C0402
C32, C53: 4u7; RCL_C1206
C46, C55: 22u; RCL_C1206
C52, C54: 1u; RCL_C1206
FL2: BLM21PG331SN1D_BLM21PG331SN1D; BLM21PG331SN1D_BEADC2012X105N
JP1: PINHEAD_PINHD-1X4; PINHEAD_1X04
L2, L3: IHLP2020BZER2R2M11_IHLP2020BZER2R2M11; IHLP2020BZER2R2M11_INDPM5552X200N
LED2: gre; LED_CHIP-LED0603
R8, R9: RCL_R-EU_R0402; RCL_R0402
R21: 3k9; RCL_R0402
R22, R34, R36, R37, R53: 10k; RCL_R0402
R49, R55: 18k; RCL_R0402
R50: 5k6; RCL_R0402
R51: 2k2; RCL_R0402
R52, R56: 1k; RCL_R0402
R54: 4k7; RCL_R0402
U1: AG9900_AG9905LP; AG9900_AG9900LP
U4: ADM1085AKSZ-REEL7_ADM1085AKSZ-REEL7; ADM1085AKSZ-REEL7_SOP65P210X95-6N
U5: NC7WZ07P6X_NC7WZ07P6X; NC7WZ07P6X_SOT65P210X110-6N
U7, U10: ST-MICROELECTRONICS2_ST1S06PUR; ST-MICROELECTRONICS2_DFN6
U8: NCP303LSN30; ON-SEMI_SOT23-5
U9: MIC5213-2.5V; MICREL2_SC70-5

Connections:
1V0: C35.1, C37.1, C39.1, C41.1, C43.1, C45.1, C48.1, C50.1, C55.1, L3.2, R21.2, R54.2, R56.2; also elsewhere on the board
2V5: C33.1, C54.1, U9.4 (OUT); also elsewhere on the board
3V3: C26.1, C27.1, C34.1, C36.1, C38.1, C40.1, C42.1, C44.1, C46.1, C47.1, C49.1, L2.2, R34.2, R36.2, R37.2, R49.2, R51.2, R52.2, R53.2, U4.6 (VCC), U5.5 (VCC), U8.2 (IN); also elsewhere on the board
3V3_PG: R53.1, U4.1 (ENIN/!ENIN), U8.1 (!RST!), U10.6 (EN)
5V0: C32.1, C52.1, C53.1, FL2.1, U7.4 (VIN_SW), U7.5 (VIN_A), U7.6 (EN), U9.1 (EN), U9.5 (IN), U10.4 (VIN_SW), U10.5 (VIN_A); also elsewhere on the board
GND: C9.2 (-), C25.2, C26.2, C27.2, C32.2, C33.2, C34.2, C35.2, C36.2, C37.2, C38.2, C39.2, C40.2, C41.2, C42.2, C43.2, C44.2, C45.2, C46.2, C47.2, C48.2, C49.2, C50.2, C51.2, C52.2, C53.2, C54.2, C55.2, LED2.C, R9.1, R22.1, R50.1, R51.1, R55.1, R56.1, U1.3 (-VDC), U4.2 (GND), U5.2 (GND), U7.2 (GND), U7.7 (GND), U8.3 (GND), U9.3 (GND), U10.2 (GND), U10.7 (GND); also elsewhere on the board
unnamed: R21.1, R22.2, U4.3 (VIN)
unnamed: R8.1, R9.2, U1.4 (ADJ)
unnamed: L2.1, U7.3 (SW)
unnamed: L3.1, U10.3 (SW)
unnamed: C25.1, U4.5 (CEXT)
unnamed: R54.1, R55.2, U10.1 (FB)
unnamed: C51.1, U8.5 (CD)
unnamed: R49.1, R50.2, U7.1 (FB)
unnamed: LED2.A, R52.1
POR_N: R34.1, U4.4 (EOUT/!EOUT), U5.1 (A1)
RST_N: R37.1, U5.4 (Y2), U5.6 (Y1); also elsewhere on the board
VC1+: B1.+, B2.+, U1.5 (VIN+_1), U1.6 (VIN+_2)
VC1-: B1.-, B2.-, U1.7 (VIN-_1), U1.8 (VIN-_2)
VC12: B2.~1 (AC1), JP1.1; also elsewhere on the board
VC36: B2.~2 (AC2), JP1.2; also elsewhere on the board
VC45: B1.~1 (AC1), JP1.4; also elsewhere on the board
VC78: B1.~2 (AC2), JP1.3; also elsewhere on the board
VDC: C9.1 (+), FL2.2, R8.2, U1.1 (+VDC_1), U1.2 (+VDC_2)
XSYS_RST_N: R36.1, U5.3 (A2); also elsewhere on the board

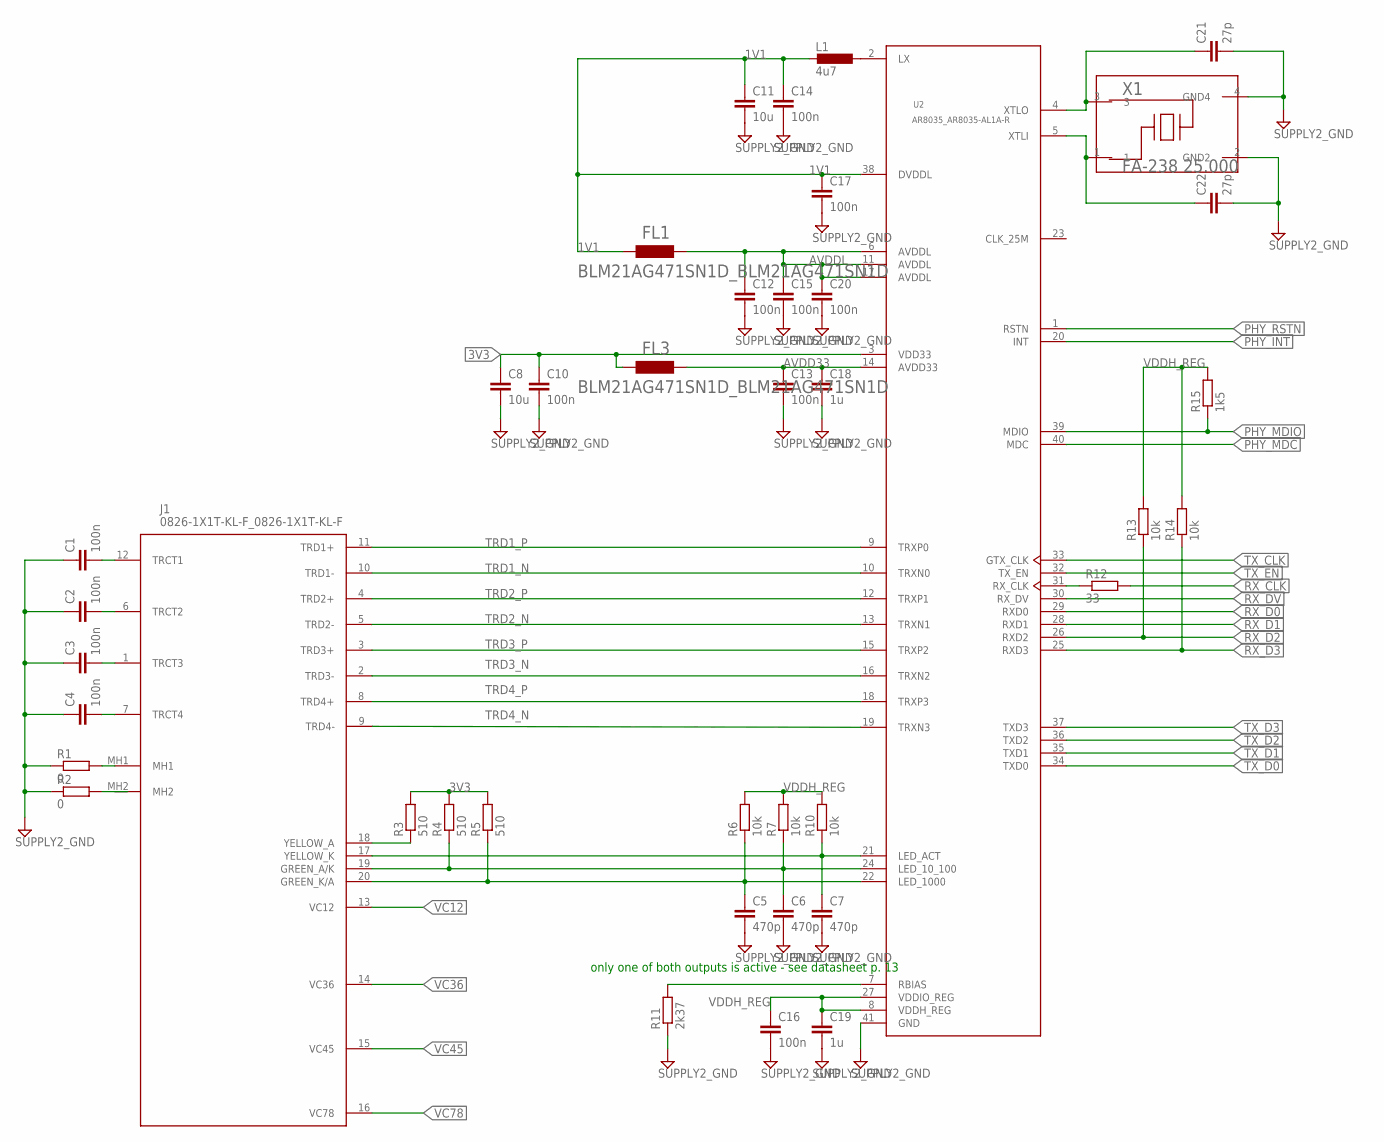
[picture p83: schematic xmos_avb_brd_V4.sch, sheet 3, Ethernet]

Parts:
C1, C2, C3, C4, C10, C12, C13, C14, C15, C16, C17, C20: 100n; RCL_C0402
C5, C6, C7: 470p; RCL_C0402
C8, C11: 10u; RCL_C1206
C18, C19: 1u; RCL_C1206
C21, C22: 27p; RCL_C0402
FL1, FL3: BLM21AG471SN1D_BLM21AG471SN1D; BLM21AG471SN1D_BEADC2012X105N
J1: 0826-1X1T-KL-F_0826-1X1T-KL-F; 0826-1X1T-KL-F_08261X1TKLF
L1: 4u7; RCL_L2012C
R1, R2: 0; RCL_R0402
R3, R4, R5: 510; RCL_R0402
R6, R7, R10, R13, R14: 10k; RCL_R0402
R11: 2k37; RCL_R0402
R12: 33; RCL_R0402
R15: 1k5; RCL_R0402
U2: AR8035_AR8035-AL1A-R; AR8035_QFN40P500X500X75-41N
X1: FA-238 25.000; FA-238_OSCCC320X250X70-4N

Connections:
1V1: C11.1, C14.1, C17.1, FL1.1, L1.2, U2.38 (DVDDL)
3V3: C8.1, C10.1, FL3.1, R3.2, R4.2, R5.2, U2.3 (VDD33); also elsewhere on the board
AVDD33: C13.1, C18.1, FL3.2, U2.14 (AVDD33)
AVDDL: C12.1, C15.1, C20.1, FL1.2, U2.6 (AVDDL), U2.11 (AVDDL), U2.17 (AVDDL)
GND: C1.1, C2.1, C3.1, C4.1, C5.2, C6.2, C7.2, C8.2, C10.2, C11.2, C12.2, C13.2, C14.2, C15.2, C16.2, C17.2, C18.2, C19.2, C20.2, C21.2, C22.2, R1.1, R2.1, R11.1, U2.41 (GND), X1.2 (GND2), X1.4 (GND4); also elsewhere on the board
unnamed: L1.1, U2.2 (LX)
unnamed: J1.MH1, R1.2
unnamed: C6.1, J1.19 (GREEN_A/K), R4.1, R7.1, U2.24 (LED_10_100)
unnamed: J1.18 (YELLOW_A), R3.1
unnamed: C21.1, U2.4 (XTLO), X1.3
unnamed: C22.1, U2.5 (XTLI), X1.1
unnamed: R12.1, U2.31 (RX_CLK)
unnamed: C7.1, J1.17 (YELLOW_K), R10.1, U2.21 (LED_ACT)
unnamed: C1.2, J1.12 (TRCT1)
unnamed: C2.2, J1.6 (TRCT2)
unnamed: R11.2, U2.7 (RBIAS)
unnamed: C5.1, J1.20 (GREEN_K/A), R5.1, R6.1, U2.22 (LED_1000)
unnamed: C3.2, J1.1 (TRCT3)
unnamed: C4.2, J1.7 (TRCT4)
unnamed: J1.MH2, R2.2
PHY_INT: U2.20 (INT); also elsewhere on the board
PHY_MDC: U2.40 (MDC); also elsewhere on the board
PHY_MDIO: R15.1, U2.39 (MDIO); also elsewhere on the board
PHY_RSTN: U2.1 (RSTN); also elsewhere on the board
RX_CLK: R12.2; also elsewhere on the board
RX_D0: U2.29 (RXD0); also elsewhere on the board
RX_D1: U2.28 (RXD1); also elsewhere on the board
RX_D2: R13.1, U2.26 (RXD2); also elsewhere on the board
RX_D3: R14.1, U2.25 (RXD3); also elsewhere on the board
RX_DV: U2.30 (RX_DV); also elsewhere on the board
TRD1_N: J1.10 (TRD1-), U2.10 (TRXN0)
TRD1_P: J1.11 (TRD1+), U2.9 (TRXP0)
TRD2_N: J1.5 (TRD2-), U2.13 (TRXN1)
TRD2_P: J1.4 (TRD2+), U2.12 (TRXP1)
TRD3_N: J1.2 (TRD3-), U2.16 (TRXN2)
TRD3_P: J1.3 (TRD3+), U2.15 (TRXP2)
TRD4_N: J1.9 (TRD4-), U2.19 (TRXN3)
TRD4_P: J1.8 (TRD4+), U2.18 (TRXP3)
TX_CLK: U2.33 (GTX_CLK); also elsewhere on the board
TX_D0: U2.34 (TXD0); also elsewhere on the board
TX_D1: U2.35 (TXD1); also elsewhere on the board
TX_D2: U2.36 (TXD2); also elsewhere on the board
TX_D3: U2.37 (TXD3); also elsewhere on the board
TX_EN: U2.32 (TX_EN); also elsewhere on the board
VC12: J1.13 (VC12); also elsewhere on the board
VC36: J1.14 (VC36); also elsewhere on the board
VC45: J1.15 (VC45); also elsewhere on the board
VC78: J1.16 (VC78); also elsewhere on the board
VDDH_REG: C16.1, C19.1, R6.2, R7.2, R10.2, R13.2, R14.2, R15.2, U2.8 (VDDH_REG), U2.27 (VDDIO_REG)

Notes on the sheet:
only one of both outputs is active - see datasheet p. 13

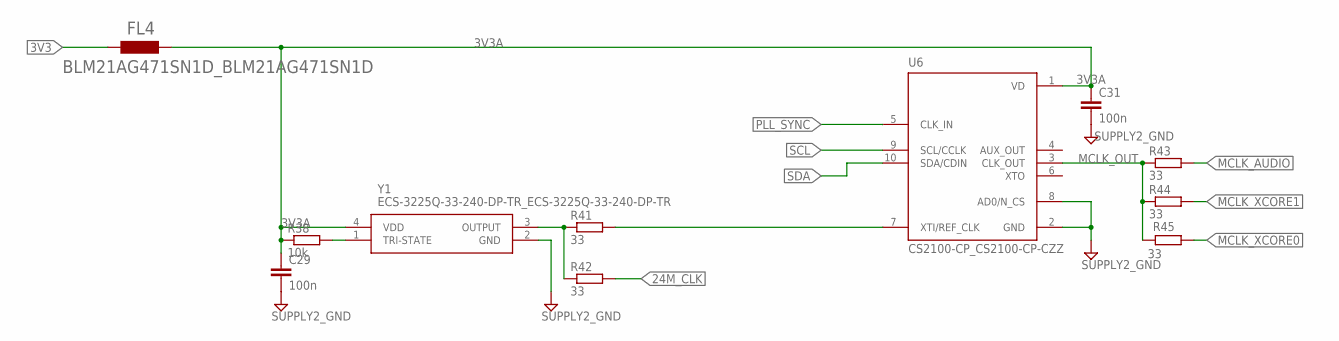
[picture p84: schematic xmos_avb_brd_V4.sch, sheet 4, Audio Clocking]

Parts:
C29, C31: 100n; RCL_C0402
FL4: BLM21AG471SN1D_BLM21AG471SN1D; BLM21AG471SN1D_BEADC2012X105N
R38: 10k; RCL_R0402
R41, R42, R43, R44, R45: 33; RCL_R0402
U6: CS2100-CP_CS2100-CP-CZZ; CS2100-CP_CIRRUS-LOGIC_MSOP10
Y1: ECS-3225Q-33-240-DP-TR_ECS-3225Q-33-240-DP-TR; ECS-3225Q-33-240-DP-TR_ECS3225Q33240DPTR

Connections:
3V3: FL4.1; also elsewhere on the board
3V3A: C29.1, C31.1, FL4.2, R38.1, U6.1 (VD), Y1.4 (VDD)
24M_CLK: R42.2; also elsewhere on the board
GND: C29.2, C31.2, U6.2 (GND), U6.8 (AD0/N_CS), Y1.2 (GND); also elsewhere on the board
MCLK_AUDIO: R43.2; also elsewhere on the board
MCLK_OUT: R43.1, R44.1, R45.2, U6.3 (CLK_OUT)
MCLK_XCORE0: R45.1; also elsewhere on the board
MCLK_XCORE1: R44.2; also elsewhere on the board
unnamed: R41.1, R42.1, Y1.3 (OUTPUT)
unnamed: R41.2, U6.7 (XTI/REF_CLK)
unnamed: R38.2, Y1.1 (TRI-STATE)
PLL_SYNC: U6.5 (CLK_IN); also elsewhere on the board
SCL: U6.9 (SCL/CCLK); also elsewhere on the board
SDA: U6.10 (SDA/CDIN); also elsewhere on the board

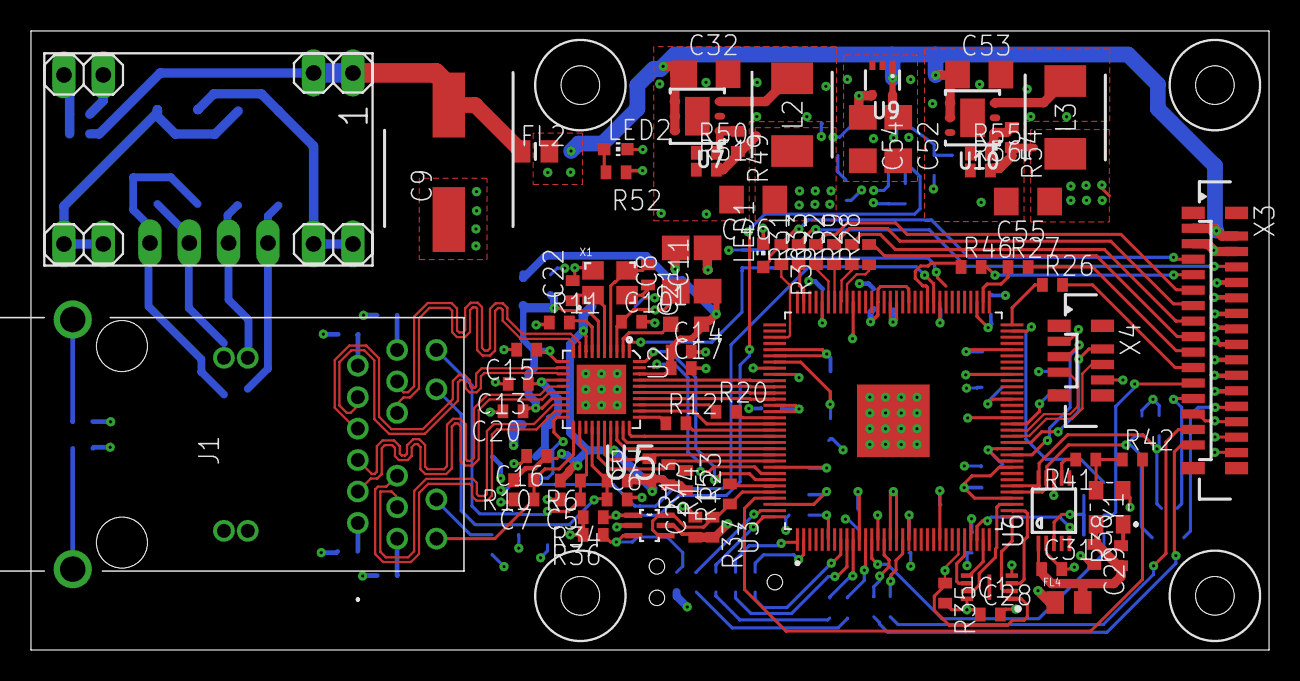
[picture p85: board xmos_avb_brd_V4.brd from above]

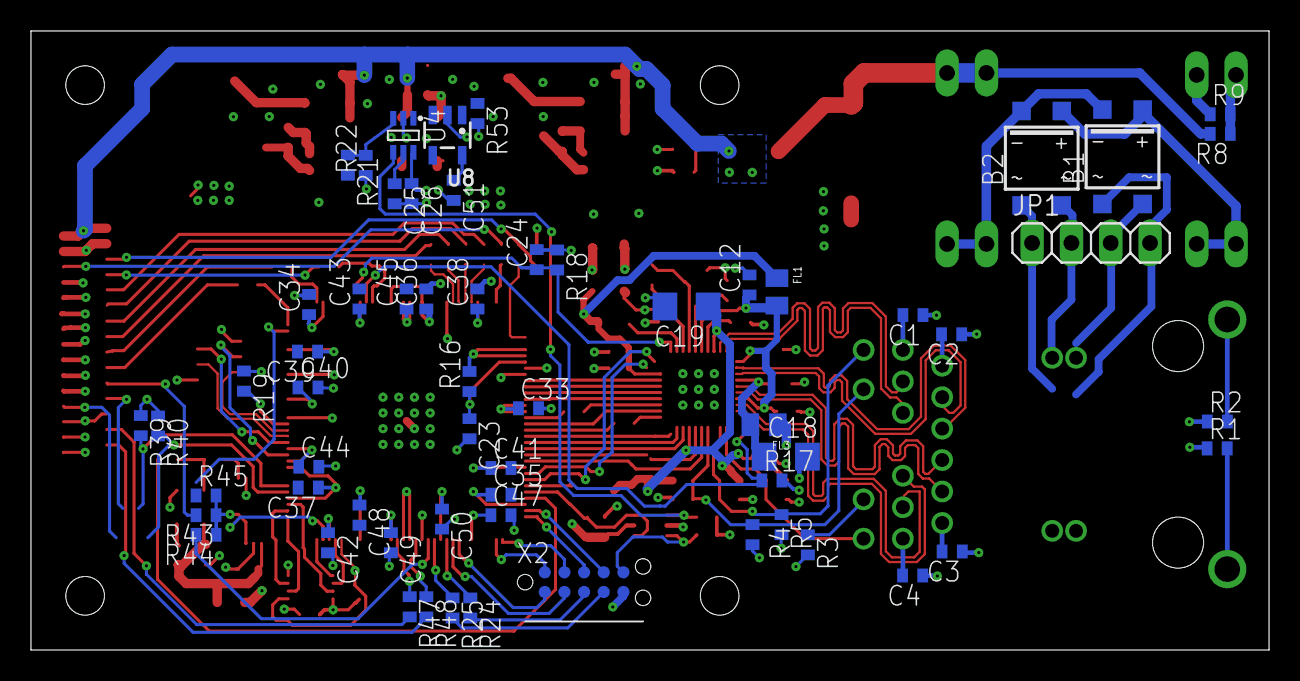
[picture p86: board xmos_avb_brd_V4.brd from below]

Board: 4 copper layers, 80.0 x 40.0 mm, 143 parts (60 on the bottom side), 126 nets.

Other parts of the board:
U$4, U$5, U$6, U$7: DRIL-2,5
