Violabitch5/Nathophone_elec/USBtoI2S_board/XK-AUDIO-316-MC-AB-Design-Files/XMS0004/ADC.kicad_sch

## KiCad design USBtoI2S_board/XK-AUDIO-316-MC-AB-Design-Files/XMS0004/ADC.kicad_sch (2026-05-14)

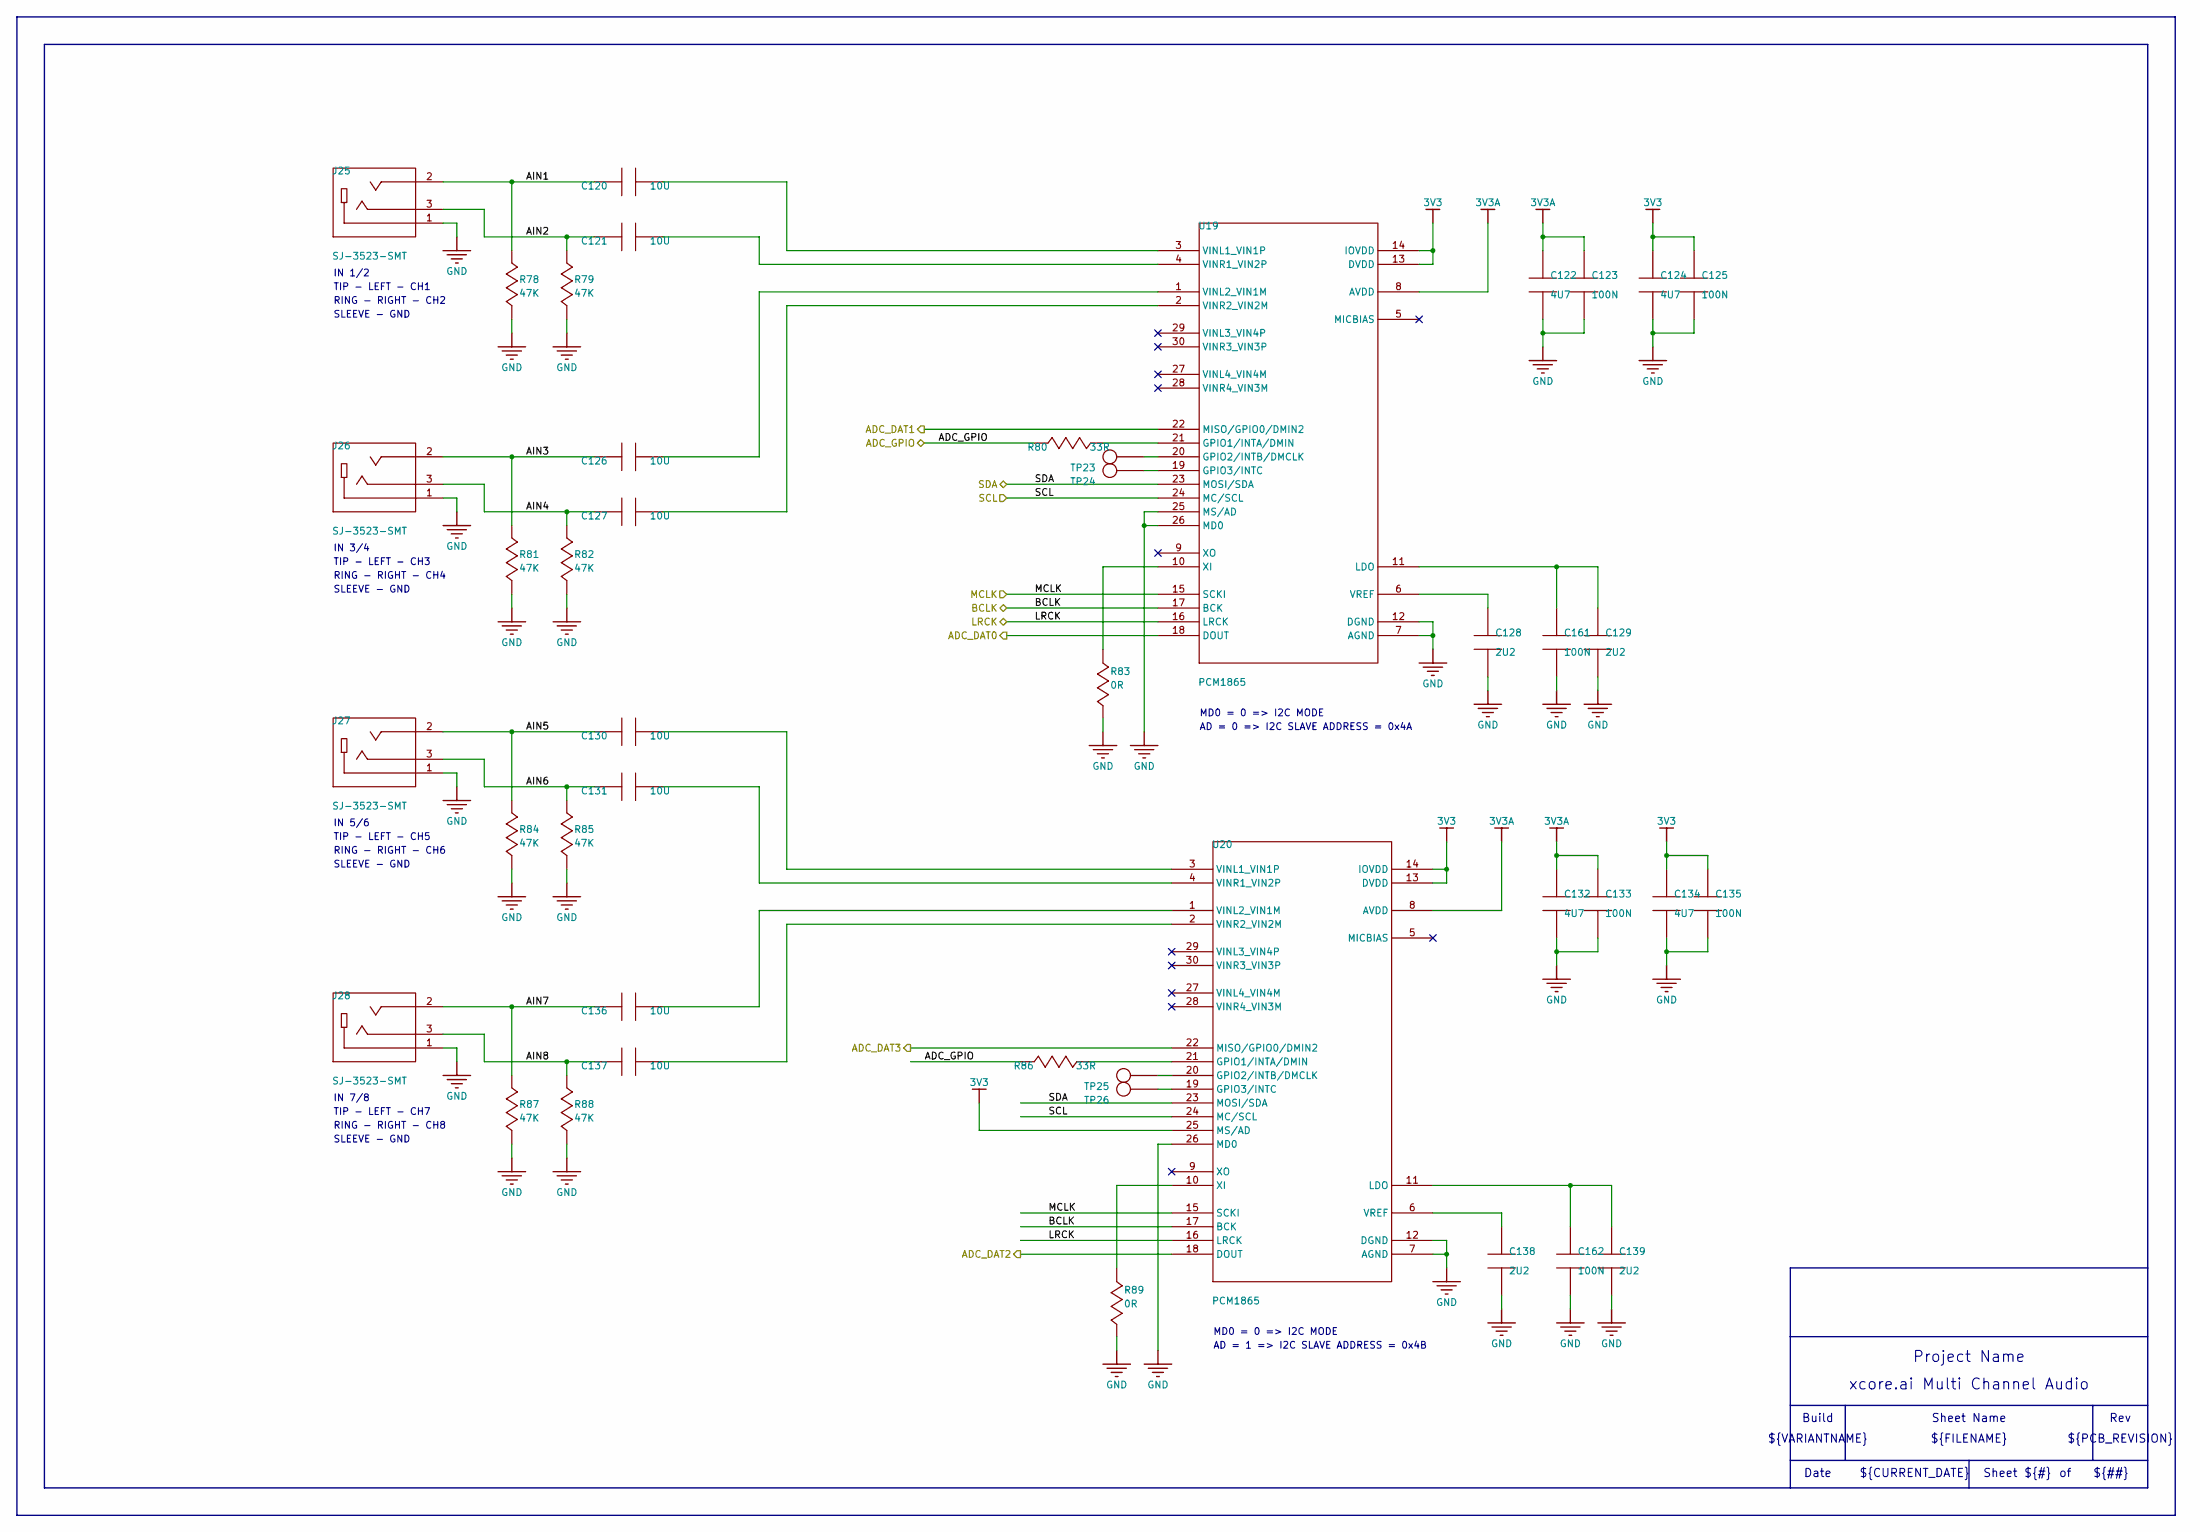
[picture p87: schematic ADC.kicad_sch]

Parts:
C120, C121, C126, C127, C130, C131, C136, C137: 10U; CAPC2012X145N; RATED VOLTAGE 10V; TOLERANCE 20%; PART NUMBER GEN-03-0048
C122, C124, C132, C134: 4U7; CAPC1608X90N; RATED VOLTAGE 16V; TOLERANCE 10%; PART NUMBER STD-06-0151
C123, C125, C133, C135, C161, C162: 100N; CAPC1005X55N; RATED VOLTAGE 16V; TOLERANCE 10%; PART NUMBER STD-06-0048
C128, C129, C138, C139: 2U2; CAPC1608X90N; RATED VOLTAGE 16V; TOLERANCE 10%; PART NUMBER STD-06-0152
J25, J26, J27, J28: SJ-3523-SMT; CON_CUI_SJ3523; PART NUMBER GEN-01-0021
R78, R79, R81, R82, R84, R85, R87, R88: 47K; RESC1608X55N; TOLERANCE 1%; MAX VOLTAGE 50V; PART NUMBER STD-02-0102
R80, R86: 33R; RESC1608X55N; TOLERANCE 1%; MAX VOLTAGE 50V; PART NUMBER STD-02-0026
R83, R89: 0R; RESC1608X55N; TOLERANCE NA; MAX VOLTAGE 50V; PART NUMBER STD-02-0001
TP23, TP24, TP25, TP26: TESTPOINT; TESTPOINT_SMD_1MM; PART NUMBER GEN-24-0003
U19, U20: PCM1865; SOP30P50_780X640X120L62X20N; PART NUMBER GEN-06-0022

Connections:
ADC_DAT0: U19.18 (DOUT)
ADC_DAT1: U19.22 (MISO/GPIO0/DMIN2)
ADC_DAT2: U20.18 (DOUT)
ADC_DAT3: U20.22 (MISO/GPIO0/DMIN2)
ADC_GPIO: R80.1, R86.1
AIN1: C120.1, J25.2, R78.2
AIN2: C121.1, J25.3, R79.2
AIN3: C126.1, J26.2, R81.2
AIN4: C127.1, J26.3, R82.2
AIN5: C130.1, J27.2, R84.2
AIN6: C131.1, J27.3, R85.2
AIN7: C136.1, J28.2, R87.2
AIN8: C137.1, J28.3, R88.2
BCLK: U19.17 (BCK), U20.17 (BCK)
LRCK: U19.16 (LRCK), U20.16 (LRCK)
MCLK: U19.15 (SCKI), U20.15 (SCKI)
unnamed: C120.2, U19.3 (VINL1_VIN1P)
unnamed: C121.2, U19.4 (VINR1_VIN2P)
unnamed: C122.1, C123.1
unnamed: C122.2, C123.2
unnamed: C124.1, C125.1
unnamed: C124.2, C125.2
unnamed: C126.2, U19.1 (VINL2_VIN1M)
unnamed: C127.2, U19.2 (VINR2_VIN2M)
unnamed: C128.1, U19.6 (VREF)
unnamed: C129.1, C161.1, U19.11 (LDO)
unnamed: C130.2, U20.3 (VINL1_VIN1P)
unnamed: C131.2, U20.4 (VINR1_VIN2P)
unnamed: C132.1, C133.1
unnamed: C132.2, C133.2
unnamed: C134.1, C135.1
unnamed: C134.2, C135.2
unnamed: C136.2, U20.1 (VINL2_VIN1M)
unnamed: C137.2, U20.2 (VINR2_VIN2M)
unnamed: C138.1, U20.6 (VREF)
unnamed: C139.1, C162.1, U20.11 (LDO)
unnamed: R80.2, U19.21 (GPIO1/INTA/DMIN)
unnamed: R83.1, U19.10 (XI)
unnamed: R86.2, U20.21 (GPIO1/INTA/DMIN)
unnamed: R89.1, U20.10 (XI)
unnamed: TP23.1, U19.20 (GPIO2/INTB/DMCLK)
unnamed: TP24.1, U19.19 (GPIO3/INTC)
unnamed: TP25.1, U20.20 (GPIO2/INTB/DMCLK)
unnamed: TP26.1, U20.19 (GPIO3/INTC)
unnamed: U19.7 (AGND), U19.12 (DGND)
unnamed: U19.13 (DVDD), U19.14 (IOVDD)
unnamed: U19.25 (MS/AD), U19.26 (MD0)
unnamed: U20.7 (AGND), U20.12 (DGND)
unnamed: U20.13 (DVDD), U20.14 (IOVDD)
SCL: U19.24 (MC/SCL), U20.24 (MC/SCL)
SDA: U19.23 (MOSI/SDA), U20.23 (MOSI/SDA)

Notes on the sheet:
Rev
Sheet Name
${##}
SLEEVE - GND
RING - RIGHT - CH6
${PCB_REVISION}
IN 5/6
RING - RIGHT - CH4
TIP - LEFT - CH3
${CURRENT_DATE}
${TITLE}
TIP - LEFT - CH5
${#}
Build
Date
MD0 = 0 => I2C MODE
AD = 1 => I2C SLAVE ADDRESS = 0x4B
IN 1/2
${VARIANTNAME}
${FILENAME}
Sheet
RING - RIGHT - CH2
Project Name
TIP - LEFT - CH1
IN 7/8
AD = 0 => I2C SLAVE ADDRESS = 0x4A
TIP - LEFT - CH7
RING - RIGHT - CH8
IN 3/4
