Violabitch5/Nathophone_elec/USBtoI2S_board/XK-AUDIO-316-MC-AB-Design-Files/XMS0004/Clocks.kicad_sch

## KiCad design USBtoI2S_board/XK-AUDIO-316-MC-AB-Design-Files/XMS0004/Clocks.kicad_sch (2026-05-14)

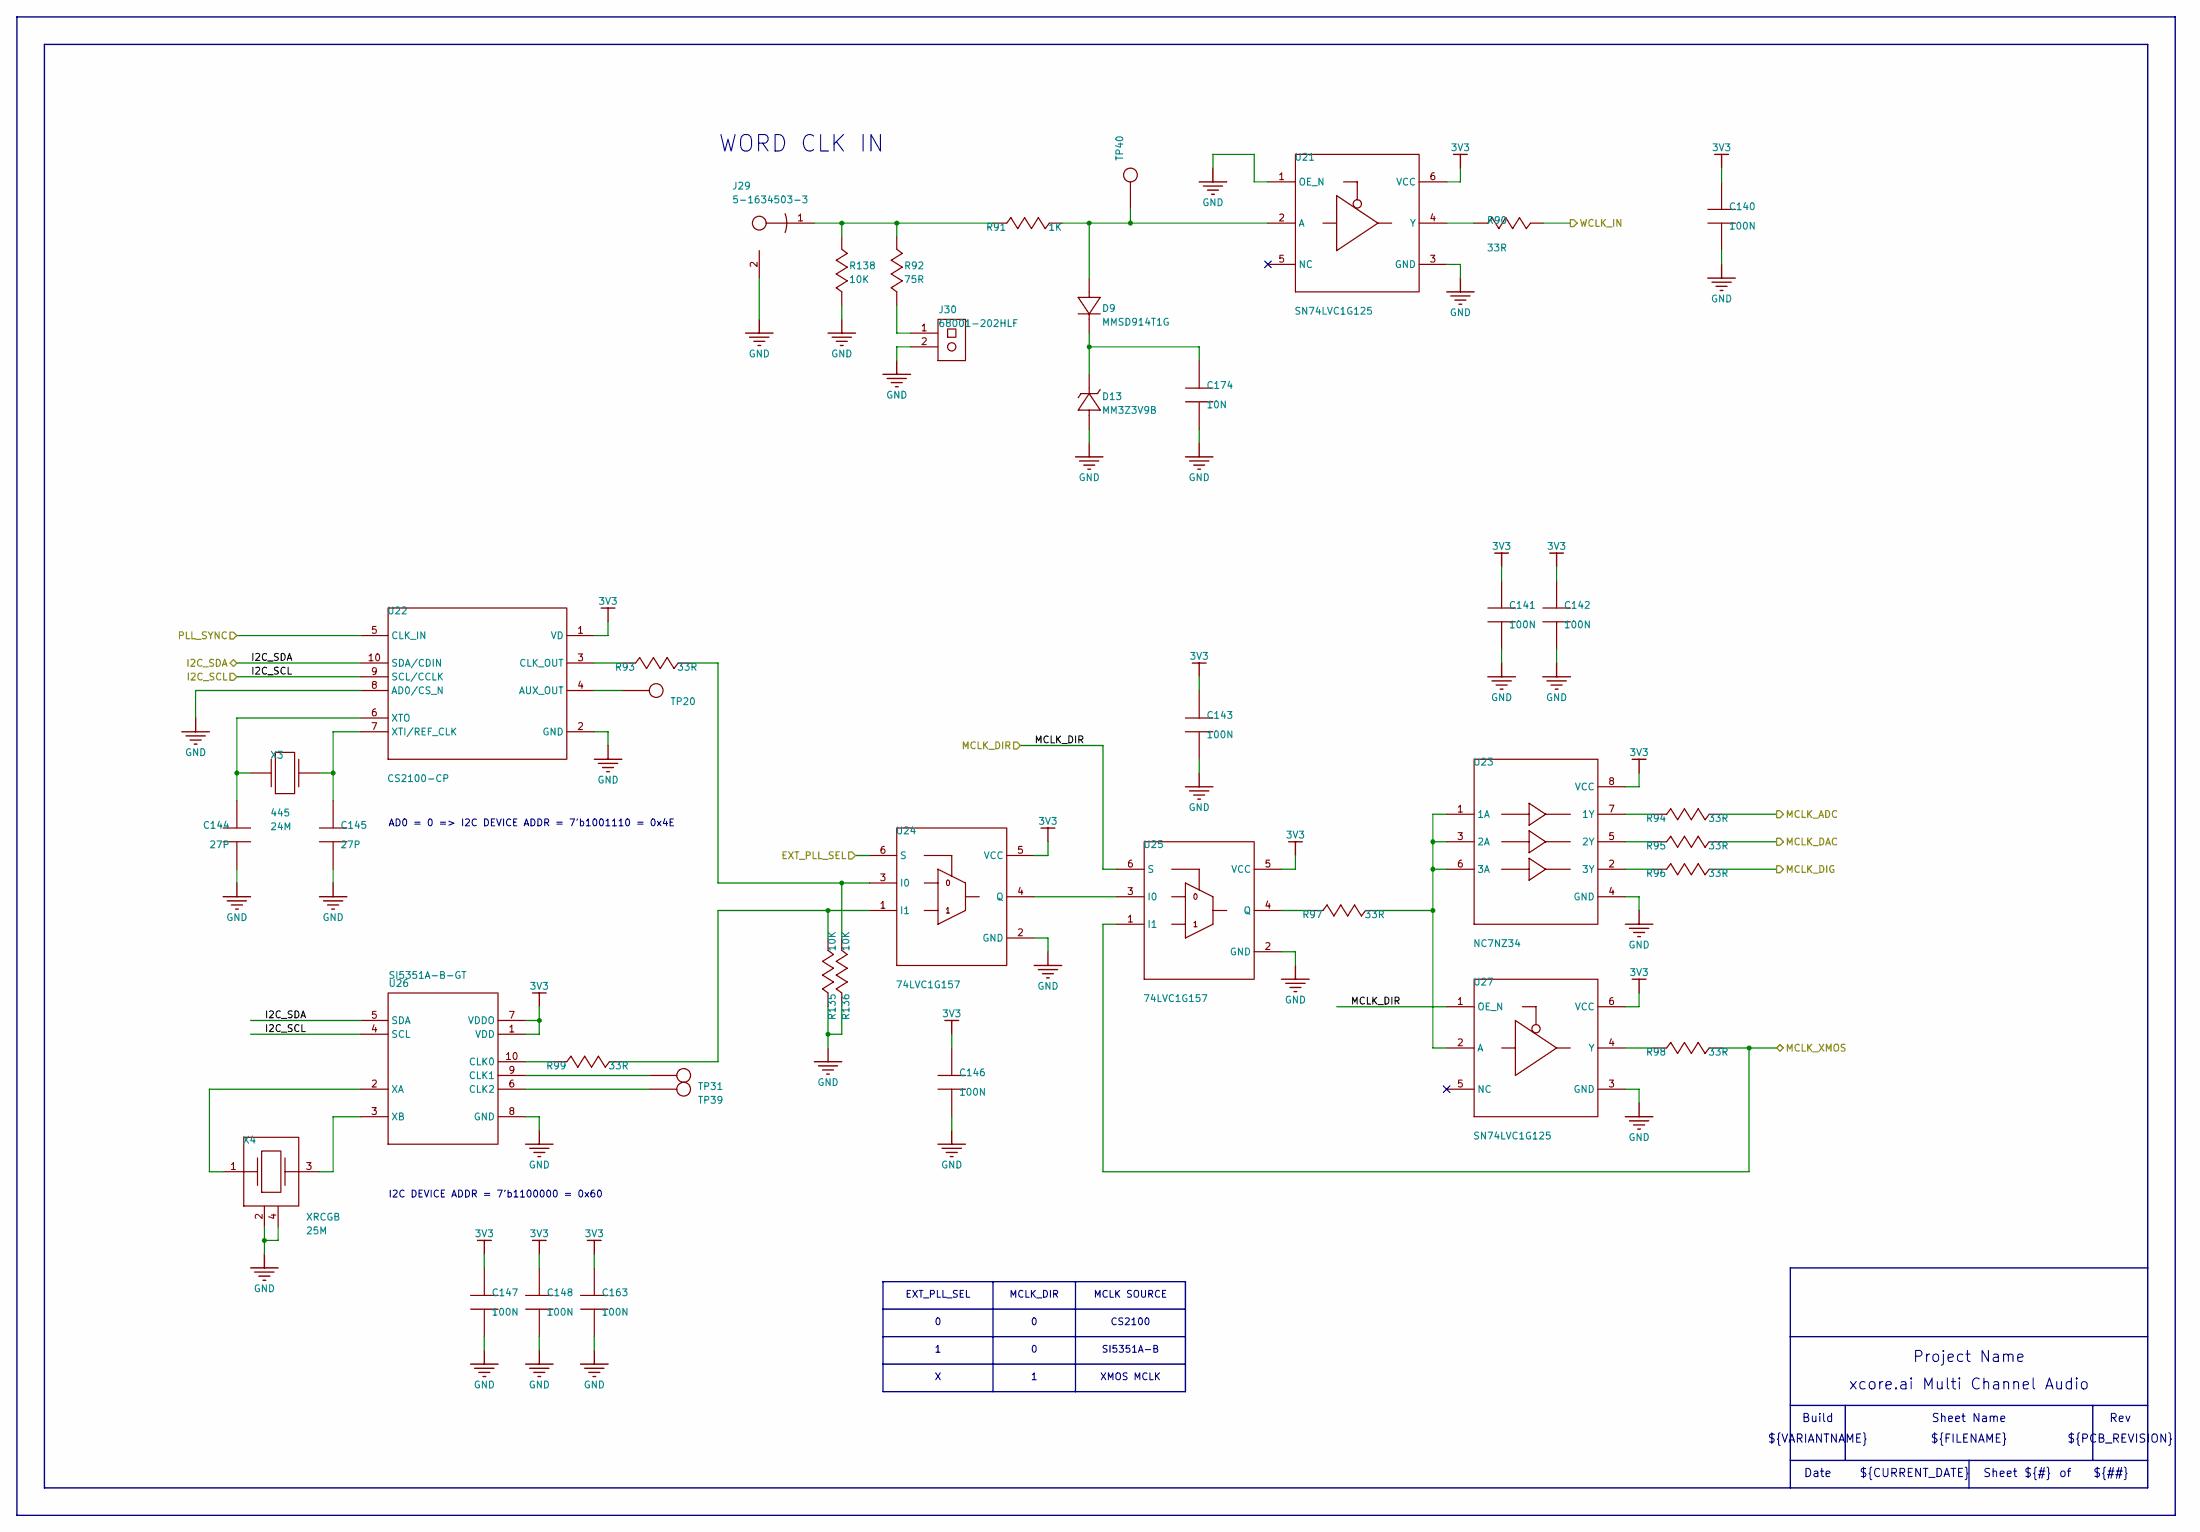
[picture p88: schematic Clocks.kicad_sch]

Parts:
C140, C141, C142, C143, C146, C147, C148, C163: 100N; CAPC1005X55N; RATED VOLTAGE 16V; TOLERANCE 10%; PART NUMBER STD-06-0048
C144, C145: 27P; CAPC1005X55N; RATED VOLTAGE 50V; TOLERANCE 5%; PART NUMBER STD-06-0018
C174: 10N; CAPC1005X55N; RATED VOLTAGE 50V; TOLERANCE 10%; PART NUMBER STD-06-0042
D9: MMSD914T1G; SOD3716X135N; PART NUMBER GEN-16-0055
D13: MM3Z3V9B; SODFL2513X100N; PART NUMBER GEN-16-0053
J29: 5-1634503-3; CON_TE_5_1634503; PART NUMBER GEN-01-0127
J30: 68001-202HLF; HDR_FCI_68001_202; PART NUMBER GEN-01-0011
R90, R93, R94, R95, R96, R97, R98, R99: 33R; RESC1608X55N; TOLERANCE 1%; MAX VOLTAGE 50V; PART NUMBER STD-02-0026
R91: 1K; RESC1608X55N; TOLERANCE 1%; MAX VOLTAGE 50V; PART NUMBER STD-02-0062
R92: 75R; RESC3116X65N; TOLERANCE 1%; MAX VOLTAGE 200V; PART NUMBER STD-05-0035
R135, R136, R138: 10K; RESC1608X55N; TOLERANCE 1%; MAX VOLTAGE 50V; PART NUMBER STD-02-0086
TP20, TP31, TP39: TESTPOINT; TESTPOINT_THRU; PART NUMBER GEN-24-0002
TP40: TESTPOINT; TESTPOINT_SMD_1MM; PART NUMBER GEN-24-0003
U21, U27: SN74LVC1G125; TI_R_PUSON_N6; PART NUMBER GEN-11-0049
U22: CS2100-CP; SOP50P490X110-10N; PART NUMBER GEN-07-0007
U23: NC7NZ34; SOP50P310X100-8N; PART NUMBER GEN-11-0025
U24, U25: 74LVC1G157; SOT95P280X145-6N; PART NUMBER GEN-11-0050
U26: SI5351A-B-GT; SOP50P490X110-10N; PART NUMBER GEN-07-0005
X3: 445; XTAL_CTS_445; PART NUMBER GEN-15-0041
X4: XRCGB; OSCCC200X160X70N; PART NUMBER GEN-15-0039

Connections:
EXT_PLL_SEL: U24.6 (S)
I2C_SCL: U22.9 (SCL/CCLK), U26.4 (SCL)
I2C_SDA: U22.10 (SDA/CDIN), U26.5 (SDA)
MCLK_ADC: R94.2
MCLK_DAC: R95.2
MCLK_DIG: R96.2
MCLK_DIR: U25.6 (S), U27.1 (OE_N)
MCLK_XMOS: R98.2, U25.1 (I1)
unnamed: C144.1, U22.6 (XTO), X3.1 (A)
unnamed: C145.1, U22.7 (XTI/REF_CLK), X3.2 (B)
unnamed: C174.1, D9.1 (K), D13.1 (K)
unnamed: D9.2 (A), R91.2, TP40.1, U21.2 (A)
unnamed: J29.1, R91.1, R92.2, R138.2
unnamed: J30.1, R92.1
unnamed: R90.1, U21.4 (Y)
unnamed: R93.1, U22.3 (CLK_OUT)
unnamed: R94.1, U23.7 (1Y)
unnamed: R95.1, U23.5 (2Y)
unnamed: R96.1, U23.2 (3Y)
unnamed: R97.1, U25.4 (Q)
unnamed: R97.2, U23.1 (1A), U23.3 (2A), U23.6 (3A), U27.2 (A)
unnamed: R98.1, U27.4 (Y)
unnamed: R99.1, U26.10 (CLK0)
unnamed: R135.1, R136.1
unnamed: R99.2, R135.2, U24.1 (I1)
unnamed: R93.2, R136.2, U24.3 (I0)
unnamed: TP20.1, U22.4 (AUX_OUT)
unnamed: TP31.1, U26.9 (CLK1)
unnamed: TP39.1, U26.6 (CLK2)
unnamed: U24.4 (Q), U25.3 (I0)
unnamed: U26.1 (VDD), U26.7 (VDDO)
unnamed: U26.2 (XA), X4.1 (A)
unnamed: U26.3 (XB), X4.3 (B)
unnamed: X4.2 (CASE_2), X4.4 (CASE_4)
PLL_SYNC: U22.5 (CLK_IN)
WCLK_IN: R90.2

Notes on the sheet:
MCLK_DIR
${##}
${TITLE}
${#}
Sheet
Rev
CS2100
MCLK SOURCE
${PCB_REVISION}
XMOS MCLK
EXT_PLL_SEL
Sheet Name
Project Name
${VARIANTNAME}
SI5351A-B
WORD CLK IN
Build
Date
AD0 = 0 => I2C DEVICE ADDR = 7'b1001110 = 0x4E
${FILENAME}
I2C DEVICE ADDR = 7'b1100000 = 0x60
${CURRENT_DATE}
