Violabitch5/Nathophone_elec/USBtoI2S_board/XK-AUDIO-316-MC-AB-Design-Files/XMS0004/DAC.kicad_sch

## KiCad design USBtoI2S_board/XK-AUDIO-316-MC-AB-Design-Files/XMS0004/DAC.kicad_sch (2026-05-14)

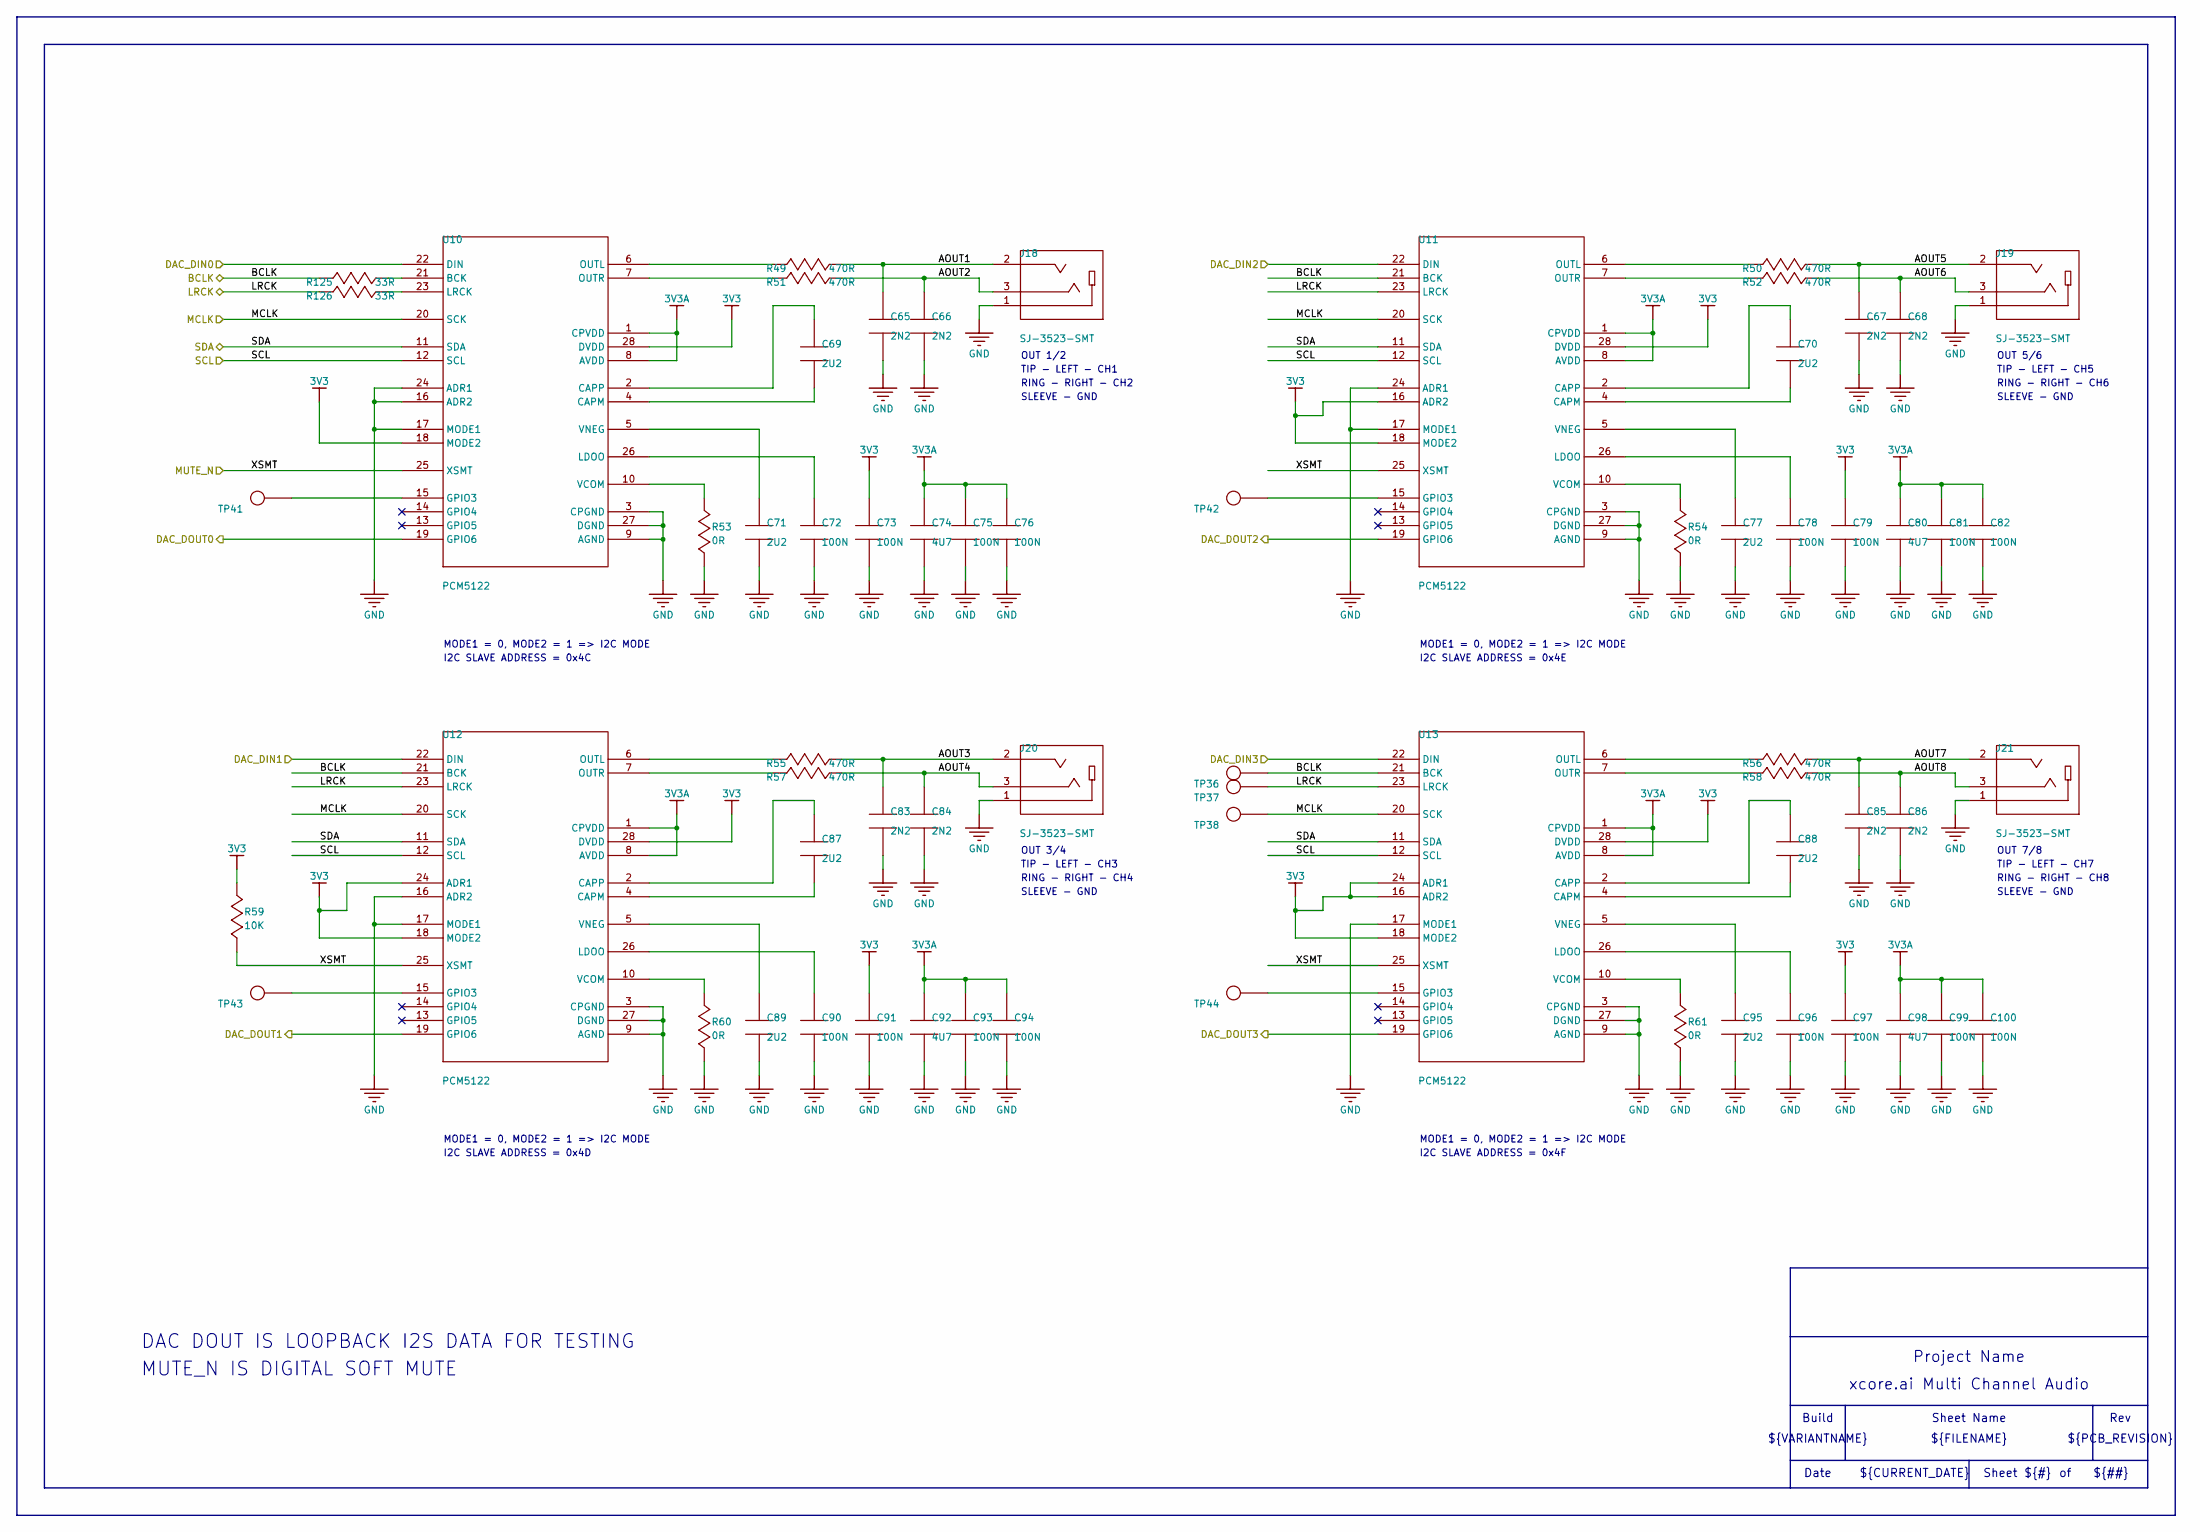
[picture p89: schematic DAC.kicad_sch]

Parts:
C65, C66, C67, C68, C83, C84, C85, C86: 2N2; CAPC1608X90N; RATED VOLTAGE 50V; TOLERANCE 5%; PART NUMBER STD-06-0063
C69, C70, C71, C77, C87, C88, C89, C95: 2U2; CAPC1608X90N; RATED VOLTAGE 16V; TOLERANCE 10%; PART NUMBER STD-06-0152
C72, C73, C75, C76, C78, C79, C81, C82, C90, C91, C93, C94, C96, C97, C99, C100: 100N; CAPC1005X55N; RATED VOLTAGE 16V; TOLERANCE 10%; PART NUMBER STD-06-0048
C74, C80, C92, C98: 4U7; CAPC1608X90N; RATED VOLTAGE 16V; TOLERANCE 10%; PART NUMBER STD-06-0151
J18, J19, J20, J21: SJ-3523-SMT; CON_CUI_SJ3523; PART NUMBER GEN-01-0021
R49, R50, R51, R52, R55, R56, R57, R58: 470R; RESC1608X55N; TOLERANCE 1%; MAX VOLTAGE 50V; PART NUMBER STD-02-0054
R53, R54, R60, R61: 0R; RESC1608X55N; TOLERANCE NA; MAX VOLTAGE 50V; PART NUMBER STD-02-0001
R59: 10K; RESC1608X55N; TOLERANCE 1%; MAX VOLTAGE 50V; PART NUMBER STD-02-0086
R125, R126: 33R; RESC1608X55N; TOLERANCE 1%; MAX VOLTAGE 50V; PART NUMBER STD-02-0026
TP36, TP37, TP38, TP41, TP42, TP43, TP44: TESTPOINT; TESTPOINT_SMD_0.9MM_L; PART NUMBER GEN-24-0019
U10, U11, U12, U13: PCM5122; SOP65P640X120-28N; PART NUMBER GEN-06-0001

Connections:
AOUT1: C65.1, J18.2, R49.2
AOUT2: C66.1, J18.3, R51.2
AOUT3: C83.1, J20.2, R55.2
AOUT4: C84.1, J20.3, R57.2
AOUT5: C67.1, J19.2, R50.2
AOUT6: C68.1, J19.3, R52.2
AOUT7: C85.1, J21.2, R56.2
AOUT8: C86.1, J21.3, R58.2
BCLK: R125.1, TP36.1, U11.21 (BCK), U12.21 (BCK), U13.21 (BCK)
DAC_DIN0: U10.22 (DIN)
DAC_DIN1: U12.22 (DIN)
DAC_DIN2: U11.22 (DIN)
DAC_DIN3: U13.22 (DIN)
DAC_DOUT0: U10.19 (GPIO6)
DAC_DOUT1: U12.19 (GPIO6)
DAC_DOUT2: U11.19 (GPIO6)
DAC_DOUT3: U13.19 (GPIO6)
LRCK: R126.1, TP37.1, U11.23 (LRCK), U12.23 (LRCK), U13.23 (LRCK)
MCLK: TP38.1, U10.20 (SCK), U11.20 (SCK), U12.20 (SCK), U13.20 (SCK)
MUTE_N: R59.1, U10.25 (XSMT), U11.25 (XSMT), U12.25 (XSMT), U13.25 (XSMT)
unnamed: C69.1, U10.2 (CAPP)
unnamed: C69.2, U10.4 (CAPM)
unnamed: C70.1, U11.2 (CAPP)
unnamed: C70.2, U11.4 (CAPM)
unnamed: C71.1, U10.5 (VNEG)
unnamed: C72.1, U10.26 (LDOO)
unnamed: C74.1, C75.1, C76.1
unnamed: C77.1, U11.5 (VNEG)
unnamed: C78.1, U11.26 (LDOO)
unnamed: C80.1, C81.1, C82.1
unnamed: C87.1, U12.2 (CAPP)
unnamed: C87.2, U12.4 (CAPM)
unnamed: C88.1, U13.2 (CAPP)
unnamed: C88.2, U13.4 (CAPM)
unnamed: C89.1, U12.5 (VNEG)
unnamed: C90.1, U12.26 (LDOO)
unnamed: C92.1, C93.1, C94.1
unnamed: C95.1, U13.5 (VNEG)
unnamed: C96.1, U13.26 (LDOO)
unnamed: C98.1, C99.1, C100.1
unnamed: R49.1, U10.6 (OUTL)
unnamed: R50.1, U11.6 (OUTL)
unnamed: R51.1, U10.7 (OUTR)
unnamed: R52.1, U11.7 (OUTR)
unnamed: R53.2, U10.10 (VCOM)
unnamed: R54.2, U11.10 (VCOM)
unnamed: R55.1, U12.6 (OUTL)
unnamed: R56.1, U13.6 (OUTL)
unnamed: R57.1, U12.7 (OUTR)
unnamed: R58.1, U13.7 (OUTR)
unnamed: R60.2, U12.10 (VCOM)
unnamed: R61.2, U13.10 (VCOM)
unnamed: R125.2, U10.21 (BCK)
unnamed: R126.2, U10.23 (LRCK)
unnamed: TP41.1, U10.15 (GPIO3)
unnamed: TP42.1, U11.15 (GPIO3)
unnamed: TP43.1, U12.15 (GPIO3)
unnamed: TP44.1, U13.15 (GPIO3)
unnamed: U10.1 (CPVDD), U10.8 (AVDD)
unnamed: U10.16 (ADR2), U10.17 (MODE1), U10.24 (ADR1)
unnamed: U10.3 (CPGND), U10.9 (AGND), U10.27 (DGND)
unnamed: U11.1 (CPVDD), U11.8 (AVDD)
unnamed: U11.16 (ADR2), U11.18 (MODE2)
unnamed: U11.17 (MODE1), U11.24 (ADR1)
unnamed: U11.3 (CPGND), U11.9 (AGND), U11.27 (DGND)
unnamed: U12.1 (CPVDD), U12.8 (AVDD)
unnamed: U12.16 (ADR2), U12.17 (MODE1)
unnamed: U12.18 (MODE2), U12.24 (ADR1)
unnamed: U12.3 (CPGND), U12.9 (AGND), U12.27 (DGND)
unnamed: U13.1 (CPVDD), U13.8 (AVDD)
unnamed: U13.16 (ADR2), U13.18 (MODE2), U13.24 (ADR1)
unnamed: U13.3 (CPGND), U13.9 (AGND), U13.27 (DGND)
SCL: U10.12 (SCL), U11.12 (SCL), U12.12 (SCL), U13.12 (SCL)
SDA: U10.11 (SDA), U11.11 (SDA), U12.11 (SDA), U13.11 (SDA)

Notes on the sheet:
RING - RIGHT - CH8
SLEEVE - GND
MODE1 = 0, MODE2 = 1 => I2C MODE
OUT 7/8
Project Name
TIP - LEFT - CH5
I2C SLAVE ADDRESS = 0x4F
TIP - LEFT - CH7
RING - RIGHT - CH2
OUT 3/4
I2C SLAVE ADDRESS = 0x4C
TIP - LEFT - CH3
Build
MUTE_N IS DIGITAL SOFT MUTE
Rev
Date
${CURRENT_DATE}
${VARIANTNAME}
OUT 1/2
Sheet
RING - RIGHT - CH6
OUT 5/6
${FILENAME}
RING - RIGHT - CH4
${#}
Sheet Name
${TITLE}
I2C SLAVE ADDRESS = 0x4E
${##}
TIP - LEFT - CH1
DAC DOUT IS LOOPBACK I2S DATA FOR TESTING
${PCB_REVISION}
I2C SLAVE ADDRESS = 0x4D
