Violabitch5/Nathophone_elec/USBtoI2S_board/XK-AUDIO-316-MC-AB-Design-Files/XMS0004/DigitalIO.kicad_sch

## KiCad design USBtoI2S_board/XK-AUDIO-316-MC-AB-Design-Files/XMS0004/DigitalIO.kicad_sch (2026-05-14)

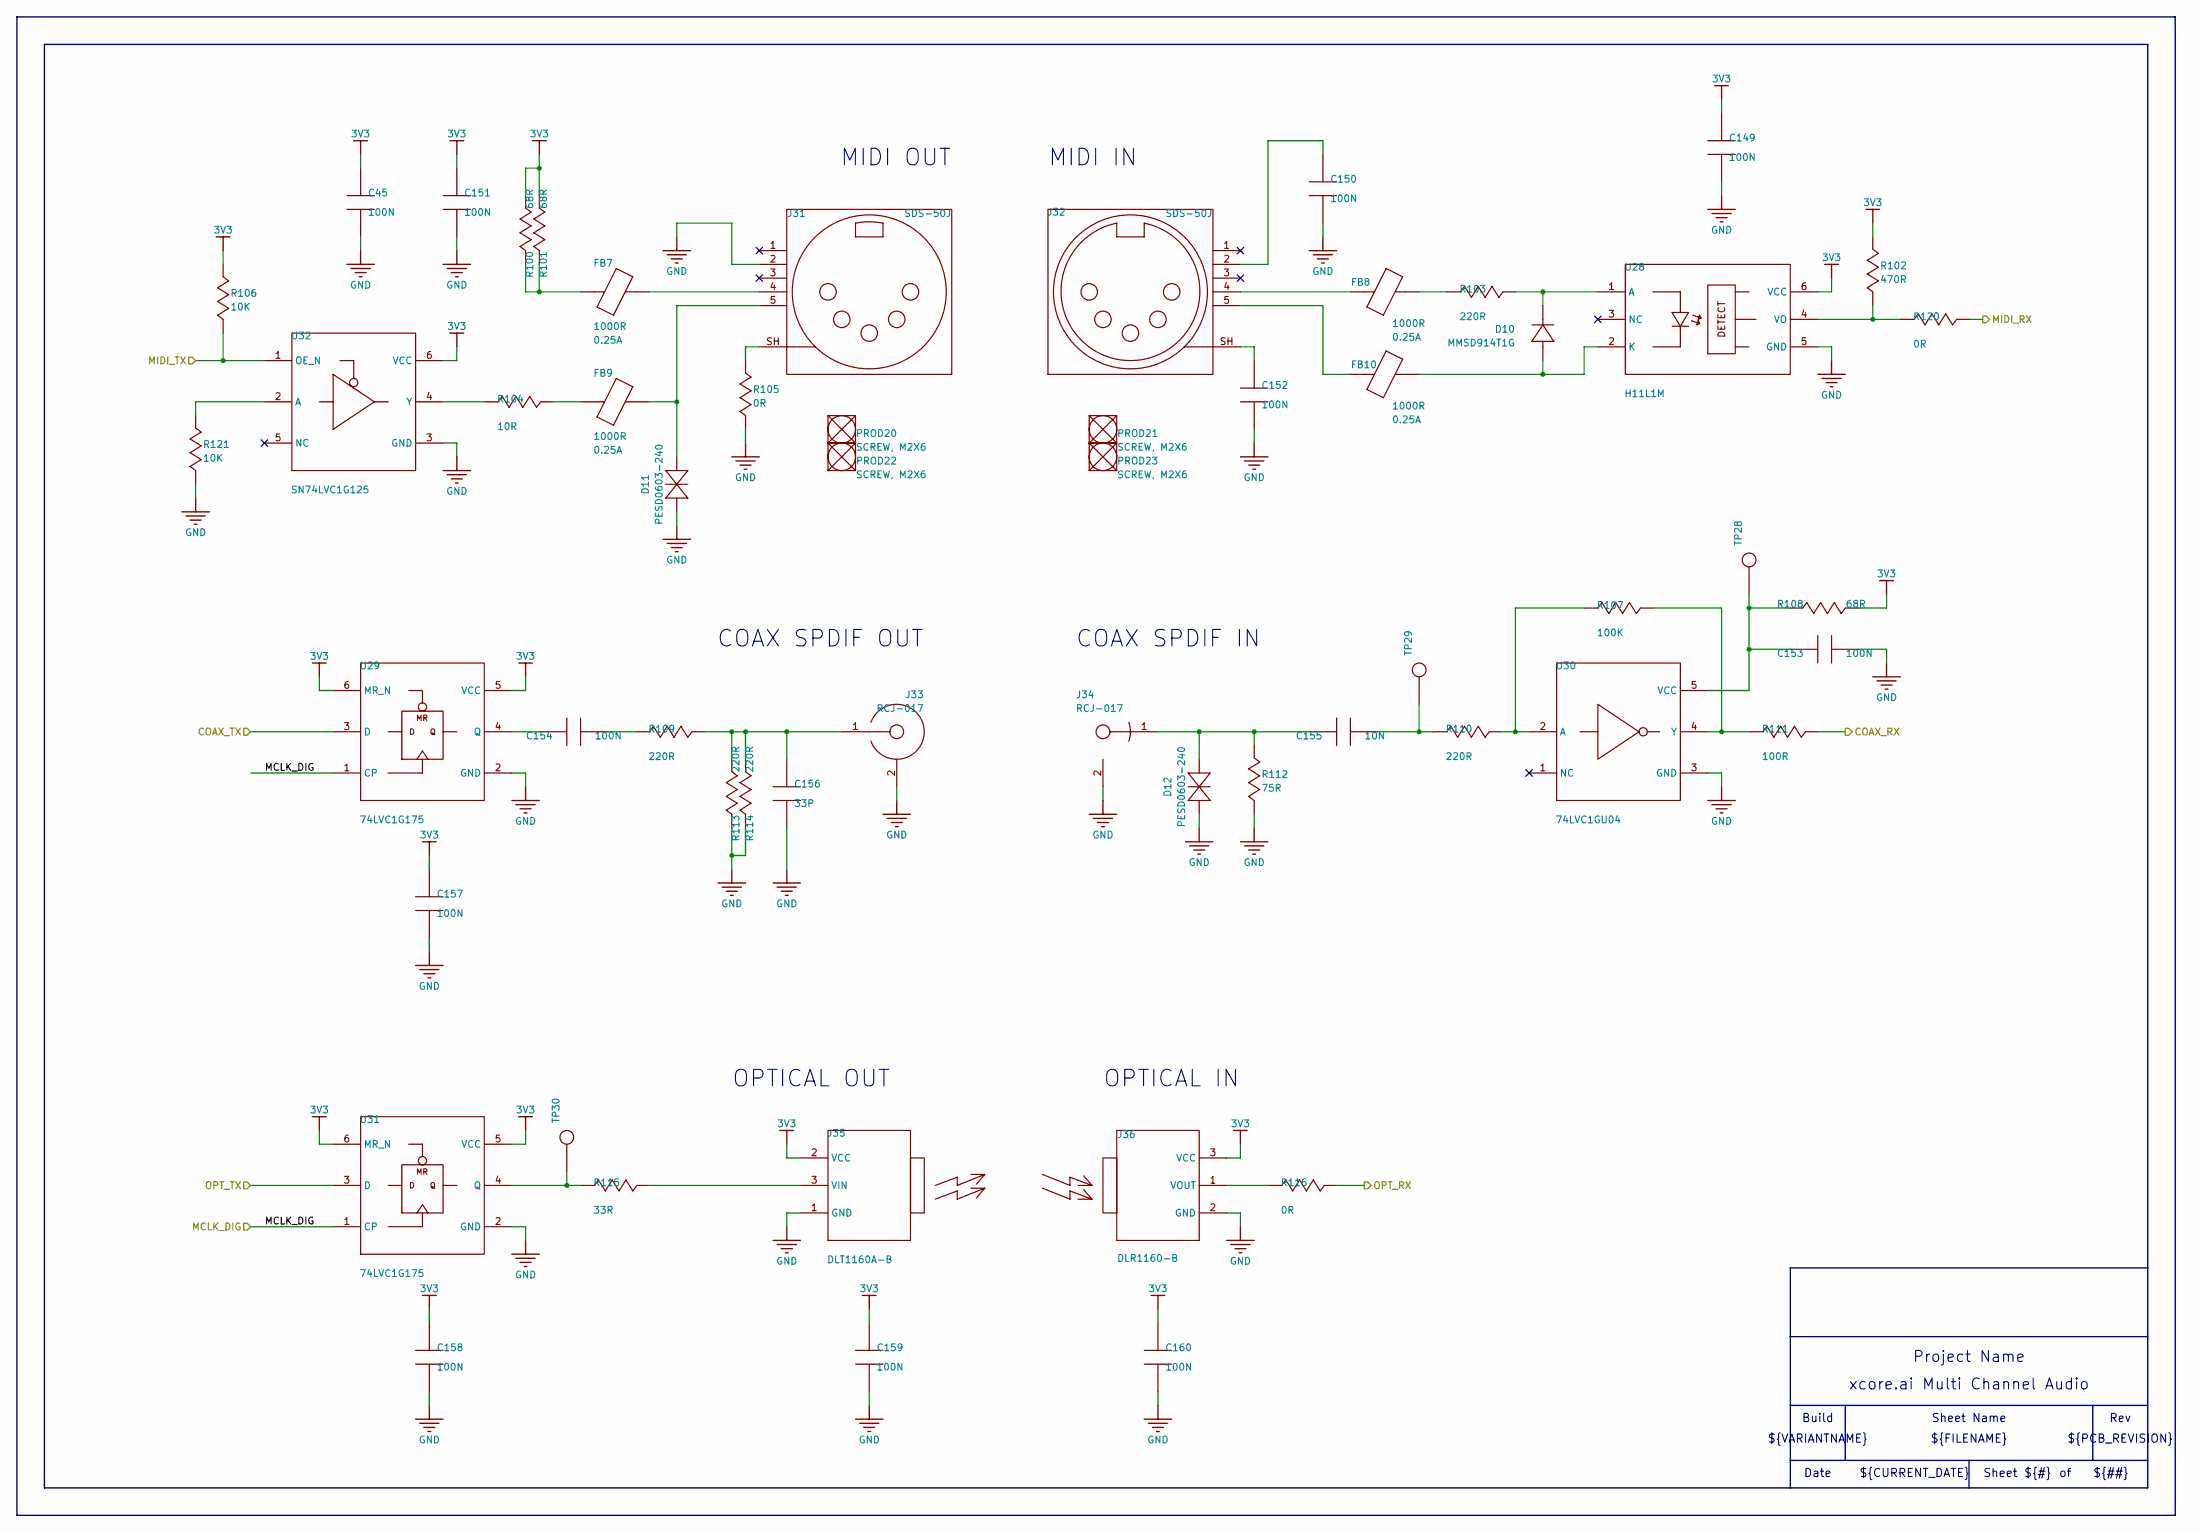
[picture p90: schematic DigitalIO.kicad_sch]

Parts:
C45, C149, C151, C153, C154, C157, C158, C159, C160: 100N; CAPC1005X55N; RATED VOLTAGE 16V; TOLERANCE 10%; PART NUMBER STD-06-0048
C150, C152: 100N; CAPC1608X90N; RATED VOLTAGE 50V; TOLERANCE 10%; PART NUMBER STD-06-0073
C155: 10N; CAPC1005X55N; RATED VOLTAGE 50V; TOLERANCE 10%; PART NUMBER STD-06-0042
C156: 33P; CAPC1005X55N; RATED VOLTAGE 50V; TOLERANCE 5%; PART NUMBER STD-06-0019
D10: MMSD914T1G; SOD3716X135N; PART NUMBER GEN-16-0055
D11, D12: PESD0603-240; RESC1608X55N; PART NUMBER GEN-16-0011
FB7, FB8, FB9, FB10: 1000R; INDC1005X55N; PART NUMBER GEN-04-0019
J31, J32: SDS-50J; DIN_5PIN_180_RA; PART NUMBER GEN-01-0123
J33, J34: RCJ-017; CON_CUI_RCJ_017; PART NUMBER GEN-01-0124
J35: DLT1160A-B; CON_OPT_AIXIN_DLX1160; PART NUMBER GEN-01-0119
J36: DLR1160-B; CON_OPT_AIXIN_DLX1160; PART NUMBER GEN-01-0120
PROD20, PROD21, PROD22, PROD23: SCREW, M2X6; PART NUMBER GEN-23-0012
R100, R101: 68R; RESC3116X65N; TOLERANCE 1%; MAX VOLTAGE 200V; PART NUMBER STD-05-0034
R102: 470R; RESC1608X55N; TOLERANCE 1%; MAX VOLTAGE 50V; PART NUMBER STD-02-0054
R103: 220R; RESC3116X65N; TOLERANCE 1%; MAX VOLTAGE 200V; PART NUMBER STD-05-0046
R104: 10R; RESC3116X65N; TOLERANCE 1%; MAX VOLTAGE 200V; PART NUMBER STD-05-0014
R105, R116, R120: 0R; RESC1608X55N; TOLERANCE NA; MAX VOLTAGE 50V; PART NUMBER STD-02-0001
R106, R121: 10K; RESC1608X55N; TOLERANCE 1%; MAX VOLTAGE 50V; PART NUMBER STD-02-0086
R107: 100K; RESC1608X55N; TOLERANCE 1%; MAX VOLTAGE 50V; PART NUMBER STD-02-0110
R108: 68R; RESC1608X55N; TOLERANCE 1%; MAX VOLTAGE 50V; PART NUMBER STD-02-0034
R109, R110, R113, R114: 220R; RESC1608X55N; TOLERANCE 1%; MAX VOLTAGE 50V; PART NUMBER STD-02-0046
R111: 100R; RESC1608X55N; TOLERANCE 1%; MAX VOLTAGE 50V; PART NUMBER STD-02-0038
R112: 75R; RESC3116X65N; TOLERANCE 1%; MAX VOLTAGE 200V; PART NUMBER STD-05-0035
R115: 33R; RESC1608X55N; TOLERANCE 1%; MAX VOLTAGE 50V; PART NUMBER STD-02-0026
TP28, TP29, TP30: TESTPOINT; TESTPOINT_SMD_1MM; PART NUMBER GEN-24-0003
U28: H11L1M; IC_ONSEMI_PDIP6_646BY; PART NUMBER GEN-13-0028
U29, U31: 74LVC1G175; SOT95P280X145-6N; PART NUMBER GEN-11-0051
U30: 74LVC1GU04; SOT23-5P95_275X110L40X37N; PART NUMBER GEN-11-0047
U32: SN74LVC1G125; TI_R_PUSON_N6; PART NUMBER GEN-11-0049

Connections:
COAX_RX: R111.2
COAX_TX: U29.3 (D)
MCLK_DIG: U29.1 (CP), U31.1 (CP)
MIDI_RX: R120.2
MIDI_TX: R106.1, U32.1 (OE_N)
unnamed: C150.1, J32.2
unnamed: C152.1, J32.SH (SHIELD)
unnamed: C153.1, R108.2, TP28.1, U30.5 (VCC)
unnamed: C154.1, U29.4 (Q)
unnamed: C154.2, R109.1
unnamed: C155.1, D12.2, J34.1, R112.2
unnamed: C155.2, R110.1, TP29.1
unnamed: C156.1, J33.1, R109.2, R113.2, R114.2
unnamed: D10.1 (K), R103.2, U28.1 (A)
unnamed: D10.2 (A), FB10.2, U28.2 (K)
unnamed: D11.2, FB9.1, J31.5
unnamed: FB7.1, J31.4
unnamed: FB7.2, R100.1, R101.1
unnamed: FB8.1, J32.4
unnamed: FB8.2, R103.1
unnamed: FB9.2, R104.2
unnamed: FB10.1, J32.5
unnamed: J31.SH (SHIELD), R105.2
unnamed: J35.3 (VIN), R115.2
unnamed: J36.1 (VOUT), R116.1
unnamed: R100.2, R101.2
unnamed: R102.1, R120.1, U28.4 (VO)
unnamed: R104.1, U32.4 (Y)
unnamed: R107.1, R110.2, U30.2 (A)
unnamed: R107.2, R111.1, U30.4 (Y)
unnamed: R113.1, R114.1
unnamed: R115.1, TP30.1, U31.4 (Q)
unnamed: R121.2, U32.2 (A)
OPT_RX: R116.2
OPT_TX: U31.3 (D)

Notes on the sheet:
Rev
${#}
COAX SPDIF IN
${CURRENT_DATE}
MIDI OUT
Build
Date
${PCB_REVISION}
${##}
${FILENAME}
MIDI IN
COAX SPDIF OUT
Sheet
${TITLE}
Project Name
OPTICAL OUT
Sheet Name
OPTICAL IN
${VARIANTNAME}
