Violabitch5/Nathophone_elec/USBtoI2S_board/XK-AUDIO-316-MC-AB-Design-Files/XMS0004/Power.kicad_sch

## KiCad design USBtoI2S_board/XK-AUDIO-316-MC-AB-Design-Files/XMS0004/Power.kicad_sch (2026-05-14)

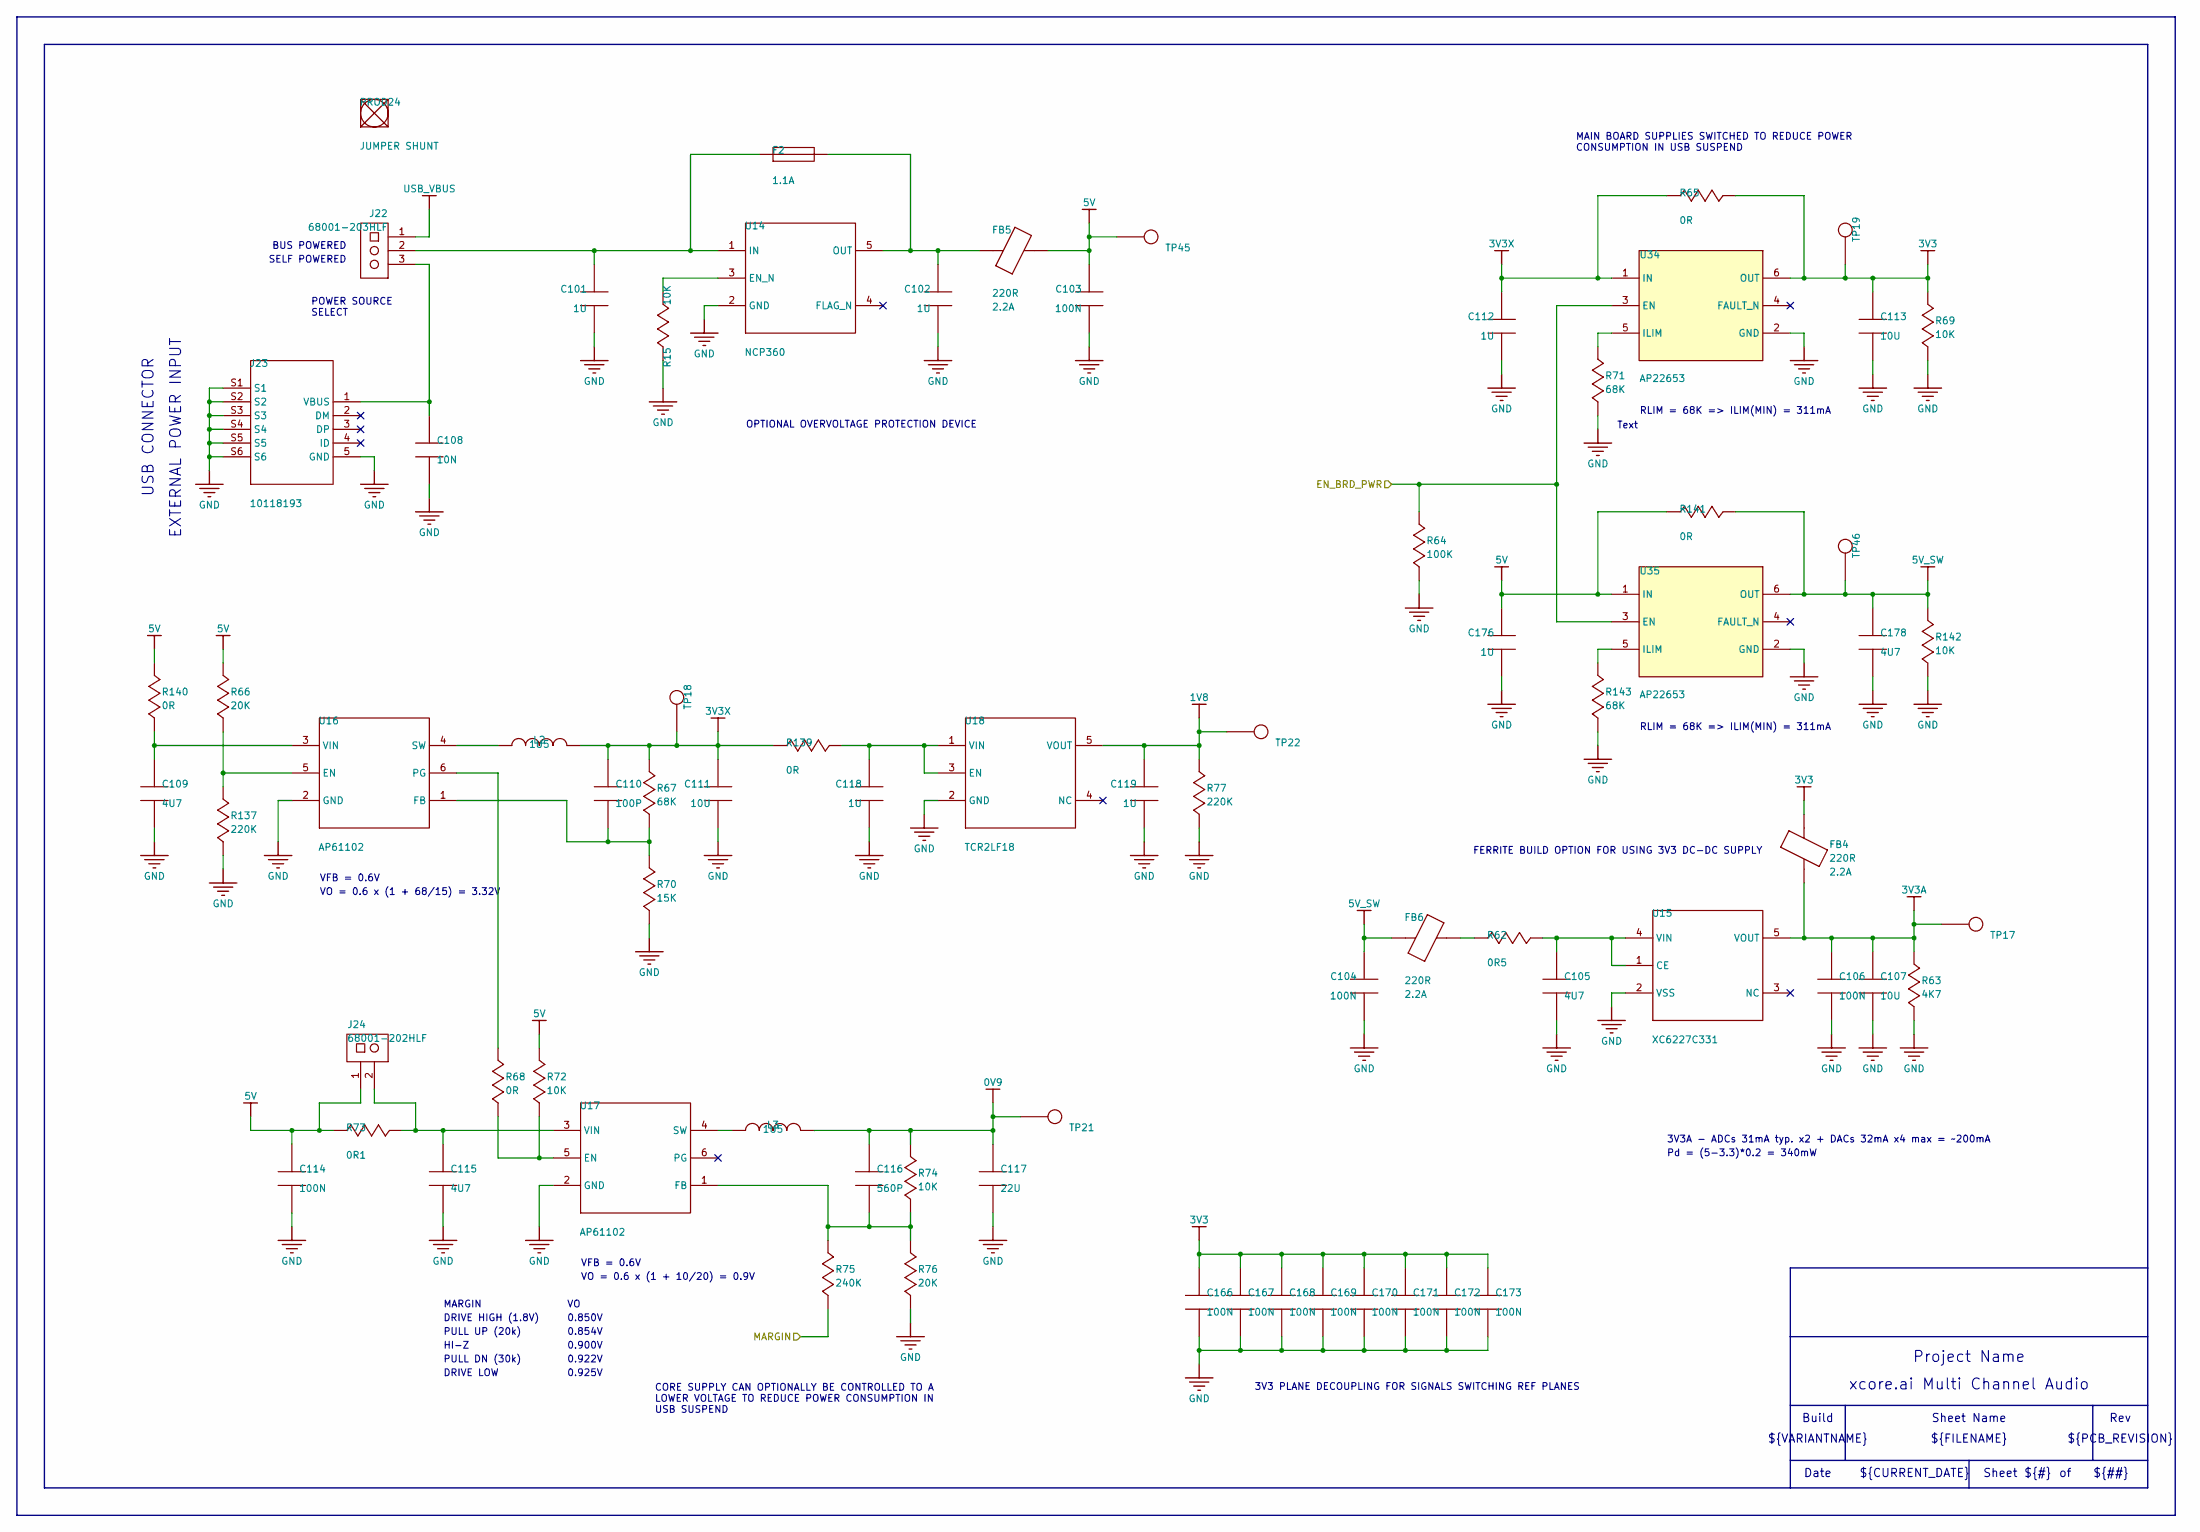
[picture p91: schematic Power.kicad_sch]

Parts:
C101, C102, C112, C118, C119, C176: 1U; CAPC1005X55N; RATED VOLTAGE 16V; TOLERANCE 20%; PART NUMBER STD-06-0140
C103, C104, C106, C114, C166, C167, C168, C169, C170, C171, C172, C173: 100N; CAPC1005X55N; RATED VOLTAGE 16V; TOLERANCE 10%; PART NUMBER STD-06-0048
C105, C109, C115, C178: 4U7; CAPC1608X90N; RATED VOLTAGE 16V; TOLERANCE 10%; PART NUMBER STD-06-0151
C107, C111, C113: 10U; CAPC1608X90N; RATED VOLTAGE 10V; TOLERANCE 20%; PART NUMBER GEN-03-0043
C108: 10N; CAPC1005X55N; RATED VOLTAGE 50V; TOLERANCE 10%; PART NUMBER STD-06-0042
C110: 100P; CAPC1005X55N; RATED VOLTAGE 50V; TOLERANCE 10%; PART NUMBER STD-06-0030
C116: 560P; CAPC1005X55N; RATED VOLTAGE 50V; TOLERANCE 5%; PART NUMBER STD-06-0147
C117: 22U; CAPC1608X90N; RATED VOLTAGE 6.3V; TOLERANCE 20%; PART NUMBER GEN-03-0046
F2: 1.1A; FUSC4632X150N; MAX VOLTAGE 24V; PART NUMBER GEN-21-0008
FB4, FB5, FB6: 220R; INDC1608X95N; PART NUMBER GEN-04-0018
J22: 68001-203HLF; HDR_FCI_68001_203; PART NUMBER GEN-01-0023
J23: 10118193; CON_FCI_10118193; PART NUMBER GEN-01-0020
J24: 68001-202HLF; HDR_FCI_68001_202; PART NUMBER GEN-01-0011
L2, L3: 1U5; INDC2520X120N; TOLERANCE 20%; PART NUMBER GEN-05-0025
PROD24: JUMPER SHUNT; PART NUMBER GEN-23-0011
R15, R69, R72, R74, R142: 10K; RESC1608X55N; TOLERANCE 1%; MAX VOLTAGE 50V; PART NUMBER STD-02-0086
R62: 0R5; RESC1608X55N; TOLERANCE 1%; MAX VOLTAGE 50V; PART NUMBER GEN-02-0023
R63: 4K7; RESC1608X55N; TOLERANCE 1%; MAX VOLTAGE 50V; PART NUMBER STD-02-0078
R64: 100K; RESC1608X55N; TOLERANCE 1%; MAX VOLTAGE 50V; PART NUMBER STD-02-0110
R65, R68, R139, R140, R141: 0R; RESC1608X55N; TOLERANCE NA; MAX VOLTAGE 50V; PART NUMBER STD-02-0001
R66, R76: 20K; RESC1608X55N; TOLERANCE 1%; MAX VOLTAGE 50V; PART NUMBER STD-02-0093
R67, R71, R143: 68K; RESC1608X55N; TOLERANCE 1%; MAX VOLTAGE 50V; PART NUMBER STD-02-0106
R70: 15K; RESC1608X55N; TOLERANCE 1%; MAX VOLTAGE 50V; PART NUMBER STD-02-0090
R73: 0R1; RESC1608X55N; TOLERANCE 1%; MAX VOLTAGE 50V; PART NUMBER GEN-02-0024
R75: 240K; RESC1608X55N; TOLERANCE 1%; MAX VOLTAGE 50V; PART NUMBER STD-02-0119
R77, R137: 220K; RESC1608X55N; TOLERANCE 1%; MAX VOLTAGE 50V; PART NUMBER STD-02-0118
TP17, TP18, TP19, TP21, TP22, TP45, TP46: TESTPOINT; TESTPOINT_THRU; PART NUMBER GEN-24-0002
U14: NCP360; SOT23-5P95_275X110L40X37N; PART NUMBER GEN-14-0068
U15: XC6227C331; TOREX_SOT_89_5; PART NUMBER GEN-14-0070
U16, U17: AP61102; ICSOFL6P50_160X160X60L30X21N; PART NUMBER GEN-14-0064
U18: TCR2LF18; SOT23-5P95_275X110L40X37N; PART NUMBER GEN-14-0066
U34, U35: AP22653; SOT95P280X145-6N; PART NUMBER GEN-14-0072

Connections:
EN_BRD_PWR: R64.2, U34.3 (EN), U35.3 (EN)
MARGIN: R75.1
unnamed: C101.1, F2.1 (T1), J22.2, U14.1 (IN)
unnamed: C102.1, F2.2 (T2), FB5.1, U14.5 (OUT)
unnamed: C103.1, FB5.2, TP45.1
unnamed: C104.1, FB6.1
unnamed: C105.1, R62.2, U15.1 (CE), U15.4 (VIN)
unnamed: C106.1, C107.1, FB4.1, R63.2, TP17.1, U15.5 (VOUT)
unnamed: C108.1, J22.3, J23.1 (VBUS)
unnamed: C109.1, R140.1, U16.3 (VIN)
unnamed: C110.1, C111.1, L2.2, R67.2, R139.1, TP18.1
unnamed: C110.2, R67.1, R70.2, U16.1 (FB)
unnamed: C112.1, R65.1, U34.1 (IN)
unnamed: C113.1, R65.2, R69.2, TP19.1, U34.6 (OUT)
unnamed: C114.1, J24.1, R73.1
unnamed: C115.1, J24.2, R73.2, U17.3 (VIN)
unnamed: C116.1, C117.1, L3.2, R74.2, TP21.1
unnamed: C116.2, R74.1, R75.2, R76.2, U17.1 (FB)
unnamed: C118.1, R139.2, U18.1 (VIN), U18.3 (EN)
unnamed: C119.1, R77.2, TP22.1, U18.5 (VOUT)
unnamed: C166.1, C167.1, C168.1, C169.1, C170.1, C171.1, C172.1, C173.1
unnamed: C166.2, C167.2, C168.2, C169.2, C170.2, C171.2, C172.2, C173.2
unnamed: C176.1, R141.1, U35.1 (IN)
unnamed: C178.1, R141.2, R142.2, TP46.1, U35.6 (OUT)
unnamed: FB6.2, R62.1
unnamed: J23.S1, J23.S2, J23.S3, J23.S4, J23.S5, J23.S6
unnamed: L2.1, U16.4 (SW)
unnamed: L3.1, U17.4 (SW)
unnamed: R15.2, U14.3 (EN_N)
unnamed: R68.1, R72.1, U17.5 (EN)
unnamed: R68.2, U16.6 (PG)
unnamed: R71.2, U34.5 (ILIM)
unnamed: R66.1, R137.2, U16.5 (EN)
unnamed: R143.2, U35.5 (ILIM)

Notes on the sheet:
VO = 0.6 x (1 + 10/20) = 0.9V
FERRITE BUILD OPTION FOR USING 3V3 DC-DC SUPPLY
MARGIN
DRIVE HIGH (1.8V)
Build
${FILENAME}
3V3 PLANE DECOUPLING FOR SIGNALS SWITCHING REF PLANES
USB CONNECTOR
VO = 0.6 x (1 + 68/15) = 3.32V
SELF POWERED
RLIM = 68K => ILIM(MIN) = 311mA
${##}
OPTIONAL OVERVOLTAGE PROTECTION DEVICE
HI-Z
${TITLE}
DRIVE LOW
PULL DN (30k)
Date
0.854V
Pd = (5-3.3)*0.2 = 340mW
PULL UP (20k)
3V3A - ADCs 31mA typ. x2 + DACs 32mA x4 max = ~200mA
${PCB_REVISION}
0.925V
0.900V
${VARIANTNAME}
0.850V
${#}
0.922V
VFB = 0.6V
${CURRENT_DATE}
Sheet Name
Sheet
Project Name
Rev
BUS POWERED
EXTERNAL POWER INPUT
CORE SUPPLY CAN OPTIONALLY BE CONTROLLED TO A LOWER VOLTAGE TO REDUCE POWER CONSUMPTION IN USB SUSPEND
Text
POWER SOURCE SELECT
MAIN BOARD SUPPLIES SWITCHED TO REDUCE POWER CONSUMPTION IN USB SUSPEND
