Violabitch5/Nathophone_elec/USBtoI2S_board/XK-AUDIO-316-MC-AB-Design-Files/XMS0004/XMOS.kicad_sch

## KiCad design USBtoI2S_board/XK-AUDIO-316-MC-AB-Design-Files/XMS0004/XMOS.kicad_sch (2026-05-14)

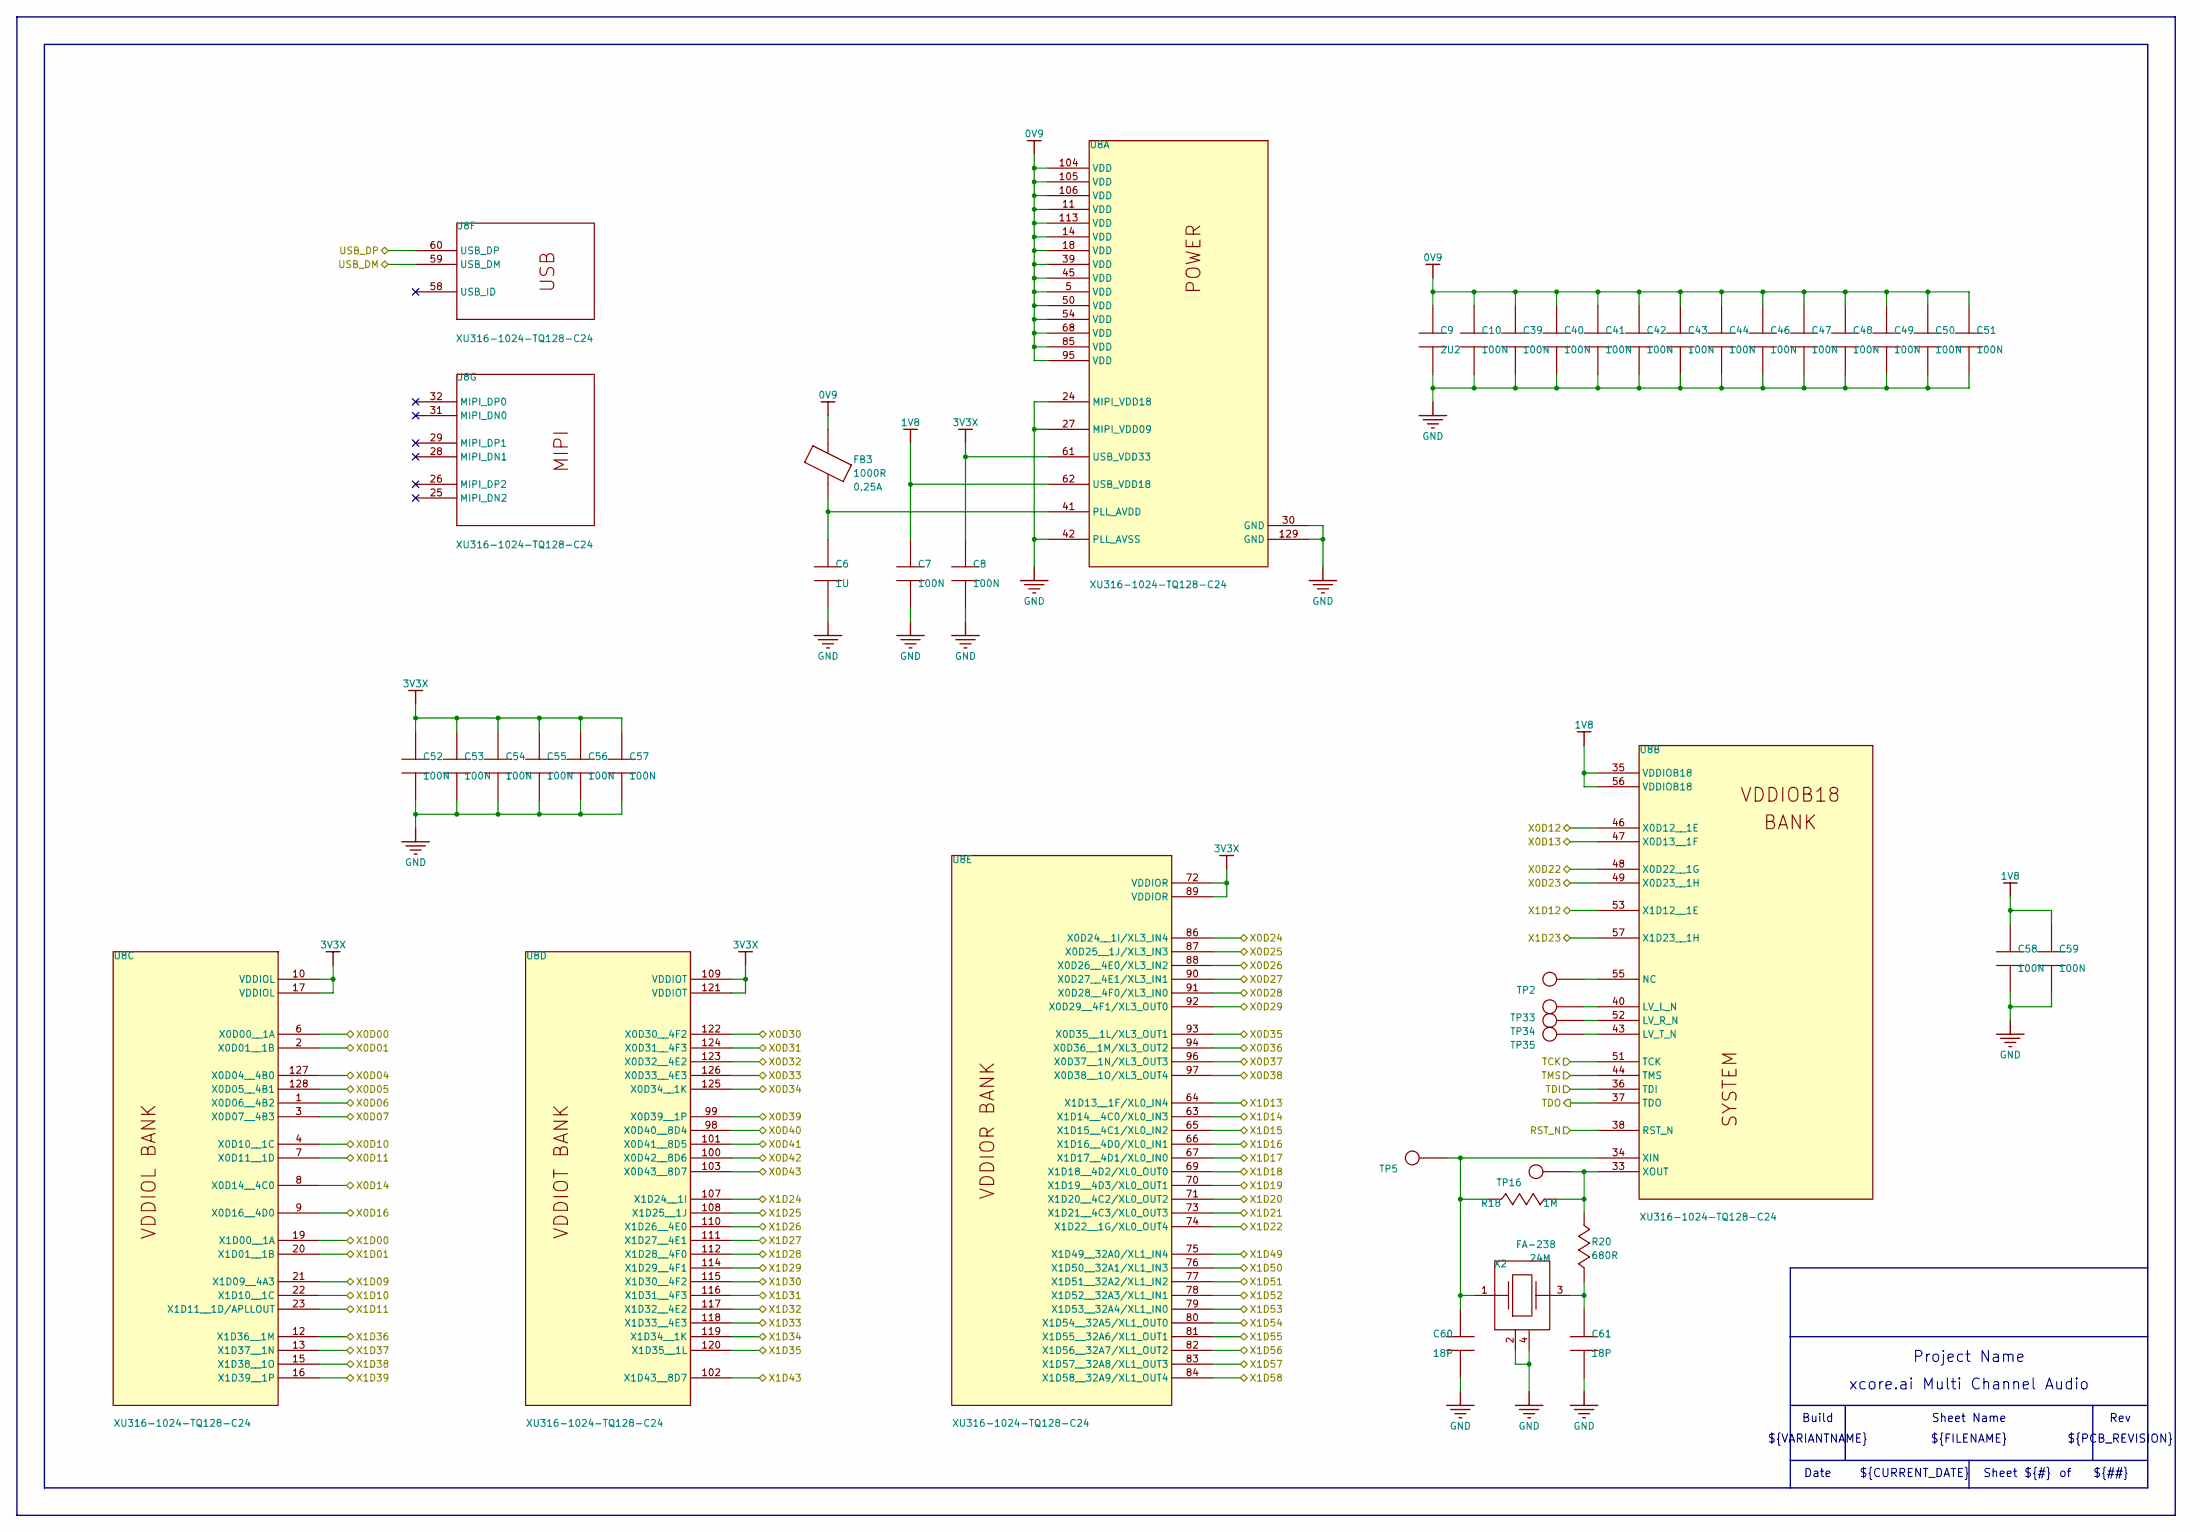
[picture p92: schematic XMOS.kicad_sch]

Parts:
C6: 1U; CAPC1005X55N; RATED VOLTAGE 16V; TOLERANCE 20%; PART NUMBER STD-06-0140
C7, C8, C10, C39, C40, C41, C42, C43, C44, C46, C47, C48, C49, C50, C51, C52, C53, C54, C55, C56, C57, C58, C59: 100N; CAPC1005X55N; RATED VOLTAGE 16V; TOLERANCE 10%; PART NUMBER STD-06-0048
C9: 2U2; CAPC1005X55N; RATED VOLTAGE 6.3V; TOLERANCE 10%; PART NUMBER GEN-03-0029
C60, C61: 18P; CAPC1005X55N; RATED VOLTAGE 50V; TOLERANCE 5%; PART NUMBER STD-06-0016
FB3: 1000R; INDC1005X55N; PART NUMBER GEN-04-0019
R18: 1M; RESC1608X55N; TOLERANCE 5%; MAX VOLTAGE 50V; PART NUMBER STD-02-0134
R20: 680R; RESC1608X55N; TOLERANCE 1%; MAX VOLTAGE 50V; PART NUMBER STD-02-0058
TP2, TP5, TP16, TP33, TP34, TP35: TESTPOINT; TESTPOINT_SMD_0.9MM_L; PART NUMBER GEN-24-0019
U8: XU316-1024-TQ128-C24; QFP40P1600X1600X120-129_T480N; PART NUMBER GEN-08-0039
X2: FA-238; OSCCC320X250X120N; PART NUMBER GEN-15-0032

Connections:
unnamed: C6.1, FB3.1, U8.41 (PLL_AVDD)
unnamed: C7.1, U8.62 (USB_VDD18)
unnamed: C8.1, U8.61 (USB_VDD33)
unnamed: C9.1, C10.1, C39.1, C40.1, C41.1, C42.1, C43.1, C44.1, C46.1, C47.1, C48.1, C49.1, C50.1, C51.1
unnamed: C9.2, C10.2, C39.2, C40.2, C41.2, C42.2, C43.2, C44.2, C46.2, C47.2, C48.2, C49.2, C50.2, C51.2
unnamed: C52.1, C53.1, C54.1, C55.1, C56.1, C57.1
unnamed: C52.2, C53.2, C54.2, C55.2, C56.2, C57.2
unnamed: C58.1, C59.1
unnamed: C58.2, C59.2
unnamed: C60.1, R18.1, TP5.1, U8.34 (XIN), X2.1 (A)
unnamed: C61.1, R20.1, X2.3 (B)
unnamed: R18.2, R20.2, TP16.1, U8.33 (XOUT)
unnamed: TP2.1, U8.55 (NC)
unnamed: TP33.1, U8.40 (LV_L_N)
unnamed: TP34.1, U8.52 (LV_R_N)
unnamed: TP35.1, U8.43 (LV_T_N)
unnamed: U8.10 (VDDIOL), U8.17 (VDDIOL)
unnamed: U8.24 (MIPI_VDD18), U8.27 (MIPI_VDD09), U8.42 (PLL_AVSS)
unnamed: U8.35 (VDDIOB18), U8.56 (VDDIOB18)
unnamed: U8.72 (VDDIOR), U8.89 (VDDIOR)
unnamed: U8.5 (VDD), U8.11 (VDD), U8.14 (VDD), U8.18 (VDD), U8.39 (VDD), U8.45 (VDD), U8.50 (VDD), U8.54 (VDD), U8.68 (VDD), U8.85 (VDD), U8.95 (VDD), U8.104 (VDD), U8.105 (VDD), U8.106 (VDD), U8.113 (VDD)
unnamed: U8.109 (VDDIOT), U8.121 (VDDIOT)
unnamed: U8.30 (GND), U8.129 (GND)
unnamed: X2.2 (CASE_2), X2.4 (CASE_4)
RST_N: U8.38 (RST_N)
TCK: U8.51 (TCK)
TDI: U8.36 (TDI)
TDO: U8.37 (TDO)
TMS: U8.44 (TMS)
USB_DM: U8.59 (USB_DM)
USB_DP: U8.60 (USB_DP)
X0D00: U8.6 (X0D00__1A)
X0D01: U8.2 (X0D01__1B)
X0D04: U8.127 (X0D04__4B0)
X0D05: U8.128 (X0D05__4B1)
X0D06: U8.1 (X0D06__4B2)
X0D07: U8.3 (X0D07__4B3)
X0D10: U8.4 (X0D10__1C)
X0D11: U8.7 (X0D11__1D)
X0D12: U8.46 (X0D12__1E)
X0D13: U8.47 (X0D13__1F)
X0D14: U8.8 (X0D14__4C0)
X0D16: U8.9 (X0D16__4D0)
X0D22: U8.48 (X0D22__1G)
X0D23: U8.49 (X0D23__1H)
X0D24: U8.86 (X0D24__1I/XL3_IN4)
X0D25: U8.87 (X0D25__1J/XL3_IN3)
X0D26: U8.88 (X0D26__4E0/XL3_IN2)
X0D27: U8.90 (X0D27__4E1/XL3_IN1)
X0D28: U8.91 (X0D28__4F0/XL3_IN0)
X0D29: U8.92 (X0D29__4F1/XL3_OUT0)
X0D30: U8.122 (X0D30__4F2)
X0D31: U8.124 (X0D31__4F3)
X0D32: U8.123 (X0D32__4E2)
X0D33: U8.126 (X0D33__4E3)
X0D34: U8.125 (X0D34__1K)
X0D35: U8.93 (X0D35__1L/XL3_OUT1)
X0D36: U8.94 (X0D36__1M/XL3_OUT2)
X0D37: U8.96 (X0D37__1N/XL3_OUT3)
X0D38: U8.97 (X0D38__1O/XL3_OUT4)
X0D39: U8.99 (X0D39__1P)
X0D40: U8.98 (X0D40__8D4)
X0D41: U8.101 (X0D41__8D5)
X0D42: U8.100 (X0D42__8D6)
X0D43: U8.103 (X0D43__8D7)
X1D00: U8.19 (X1D00__1A)
X1D01: U8.20 (X1D01__1B)
X1D09: U8.21 (X1D09__4A3)
X1D10: U8.22 (X1D10__1C)
X1D11: U8.23 (X1D11__1D/APLLOUT)
X1D12: U8.53 (X1D12__1E)
X1D13: U8.64 (X1D13__1F/XL0_IN4)
X1D14: U8.63 (X1D14__4C0/XL0_IN3)
X1D15: U8.65 (X1D15__4C1/XL0_IN2)
X1D16: U8.66 (X1D16__4D0/XL0_IN1)
X1D17: U8.67 (X1D17__4D1/XL0_IN0)
X1D18: U8.69 (X1D18__4D2/XL0_OUT0)
X1D19: U8.70 (X1D19__4D3/XL0_OUT1)
X1D20: U8.71 (X1D20__4C2/XL0_OUT2)
X1D21: U8.73 (X1D21__4C3/XL0_OUT3)
X1D22: U8.74 (X1D22__1G/XL0_OUT4)
X1D23: U8.57 (X1D23__1H)
X1D24: U8.107 (X1D24__1I)
X1D25: U8.108 (X1D25__1J)
X1D26: U8.110 (X1D26__4E0)
X1D27: U8.111 (X1D27__4E1)
X1D28: U8.112 (X1D28__4F0)
X1D29: U8.114 (X1D29__4F1)
X1D30: U8.115 (X1D30__4F2)
X1D31: U8.116 (X1D31__4F3)
X1D32: U8.117 (X1D32__4E2)
X1D33: U8.118 (X1D33__4E3)
X1D34: U8.119 (X1D34__1K)
X1D35: U8.120 (X1D35__1L)
X1D36: U8.12 (X1D36__1M)
X1D37: U8.13 (X1D37__1N)
X1D38: U8.15 (X1D38__1O)
X1D39: U8.16 (X1D39__1P)
X1D43: U8.102 (X1D43__8D7)
X1D49: U8.75 (X1D49__32A0/XL1_IN4)
X1D50: U8.76 (X1D50__32A1/XL1_IN3)
X1D51: U8.77 (X1D51__32A2/XL1_IN2)
X1D52: U8.78 (X1D52__32A3/XL1_IN1)
X1D53: U8.79 (X1D53__32A4/XL1_IN0)
X1D54: U8.80 (X1D54__32A5/XL1_OUT0)
X1D55: U8.81 (X1D55__32A6/XL1_OUT1)
X1D56: U8.82 (X1D56__32A7/XL1_OUT2)
X1D57: U8.83 (X1D57__32A8/XL1_OUT3)
X1D58: U8.84 (X1D58__32A9/XL1_OUT4)

Notes on the sheet:
${CURRENT_DATE}
Rev
${FILENAME}
Sheet Name
${##}
Date
${PCB_REVISION}
Build
${VARIANTNAME}
${TITLE}
Sheet
${#}
Project Name
