Violabitch5/Nathophone_elec/USBtoI2S_board/XK-AUDIO-316-MC-AB-Design-Files/XMS0004/XMS0004.kicad_sch

## KiCad design USBtoI2S_board/XK-AUDIO-316-MC-AB-Design-Files/XMS0004/XMS0004.kicad_sch (2026-05-14)

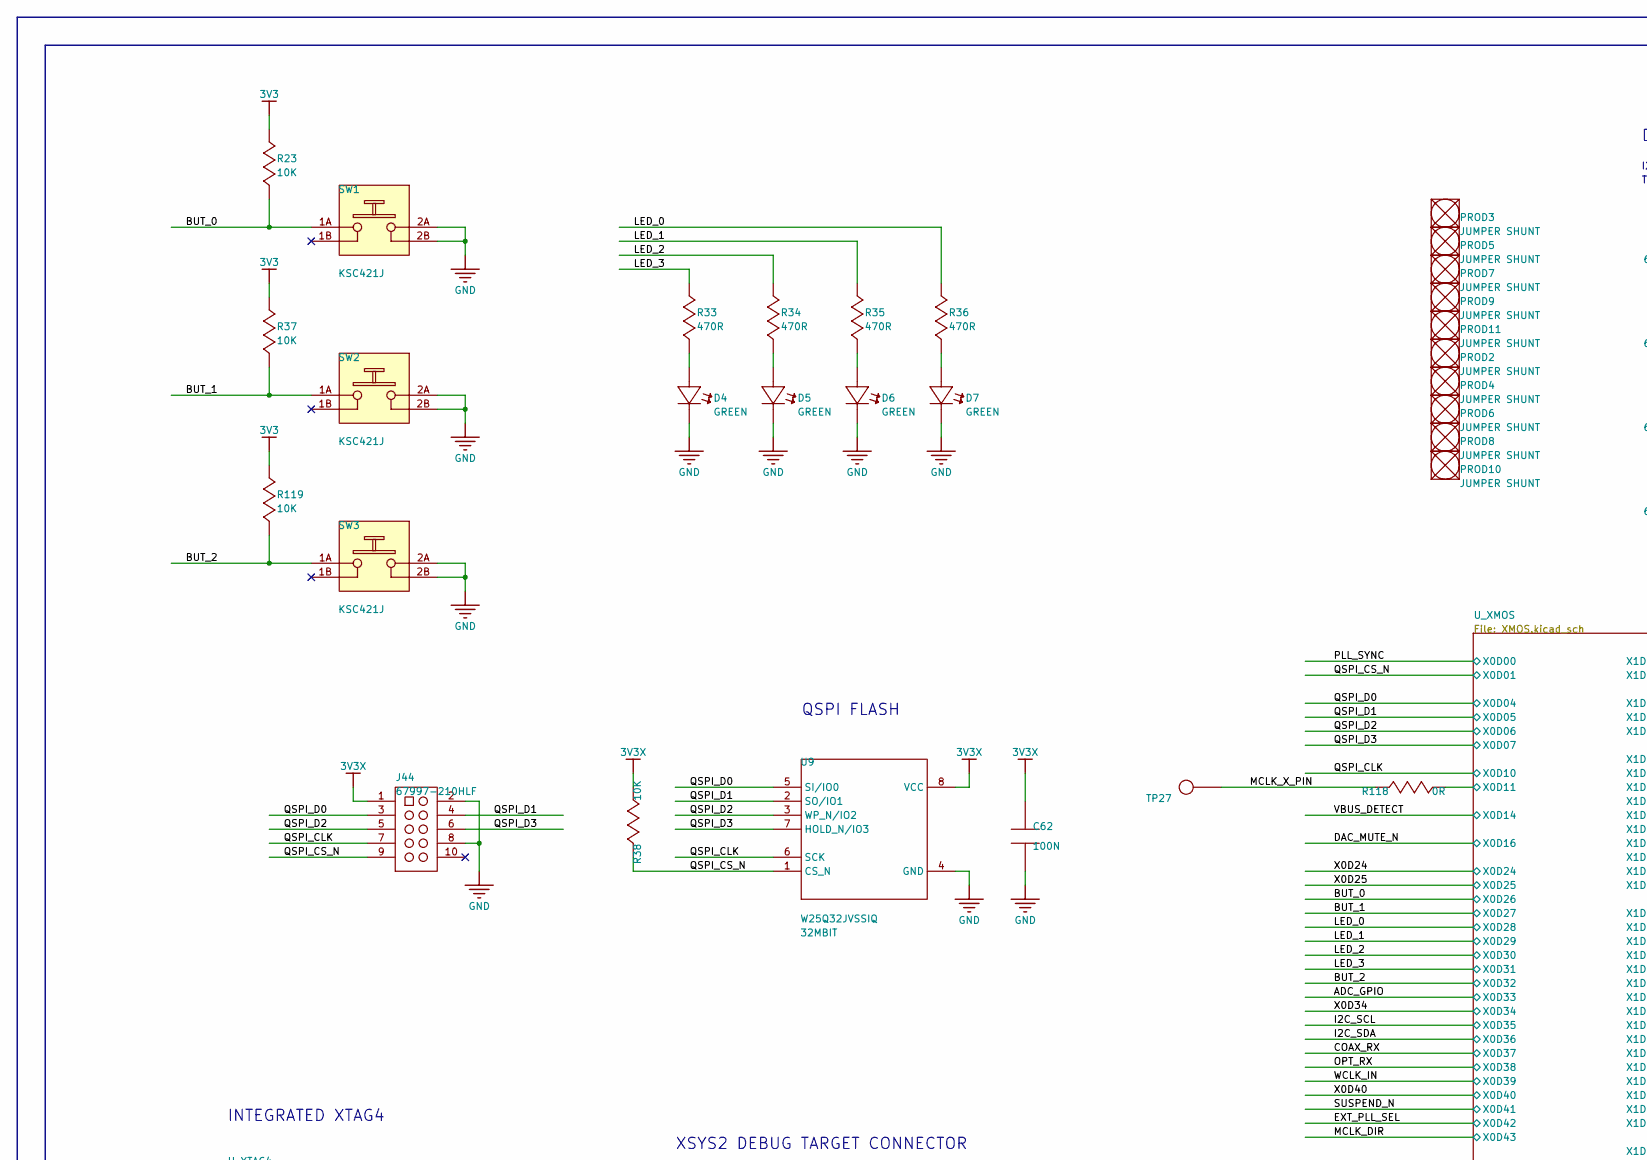
[picture p93: schematic XMS0004.kicad_sch, part in row 1, column 1]

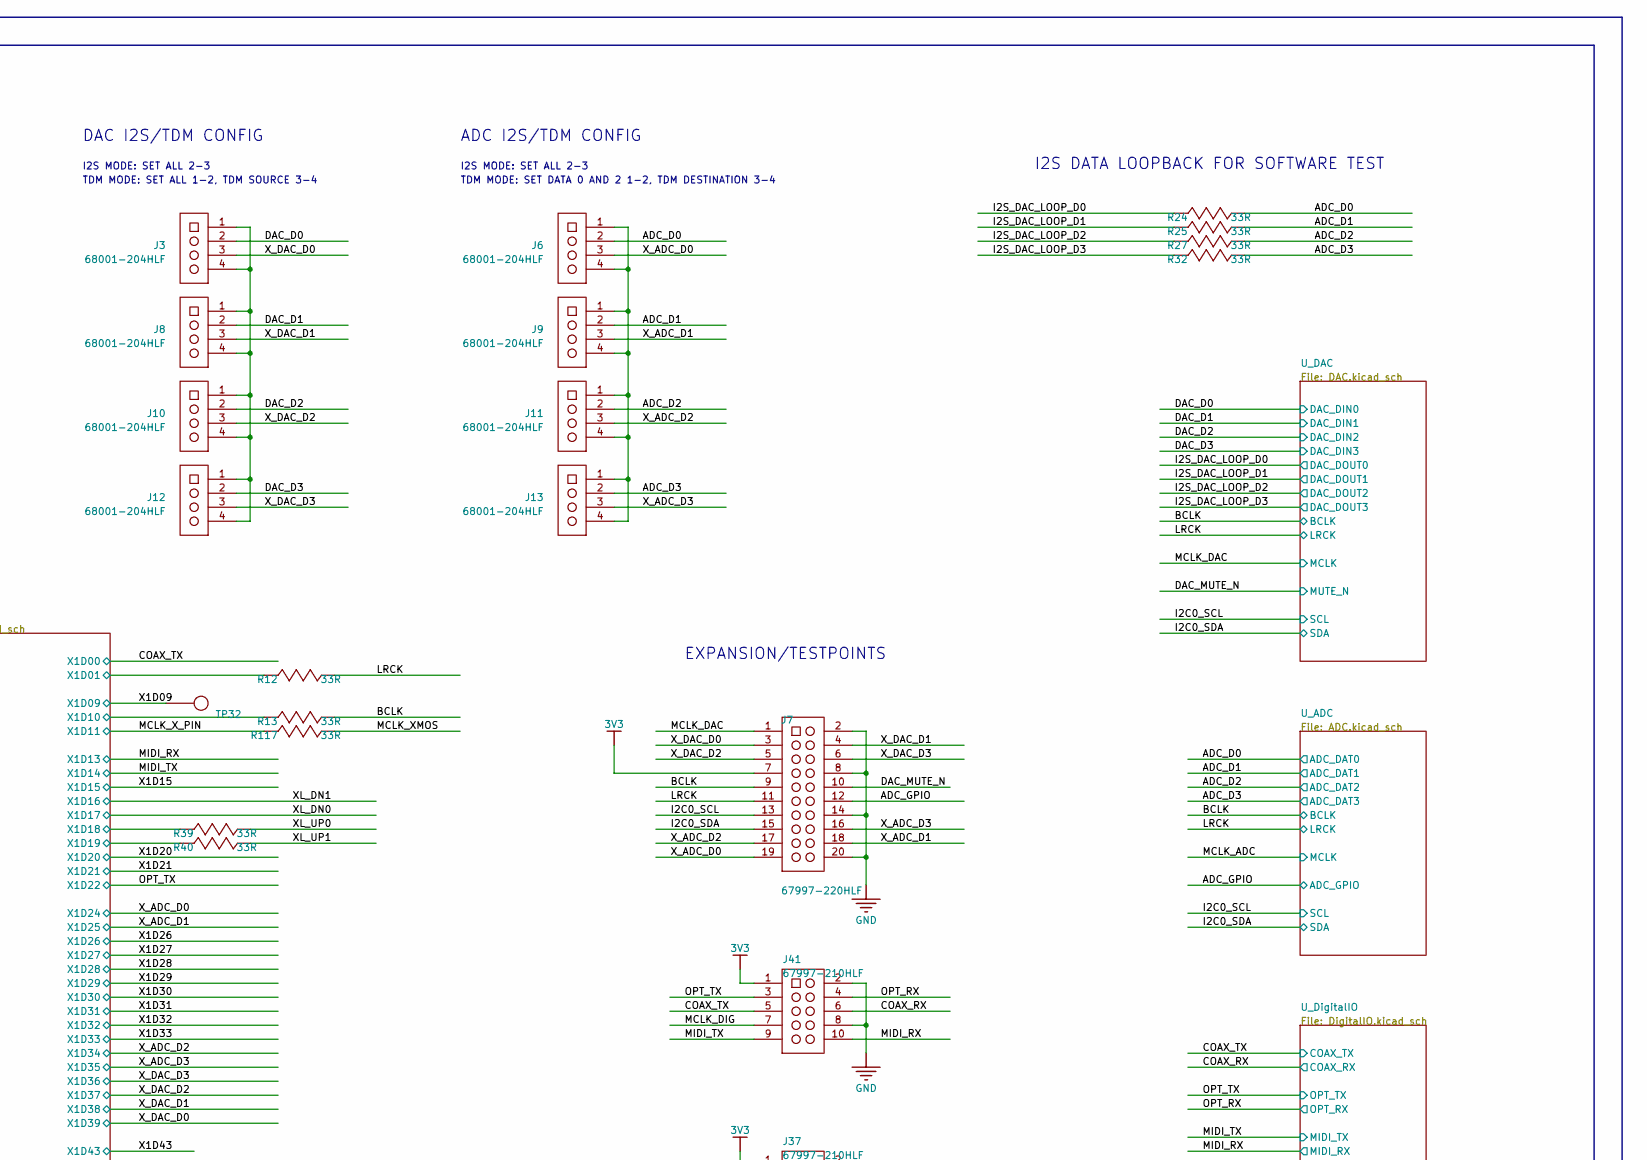
[picture p94: schematic XMS0004.kicad_sch, part in row 1, column 2]

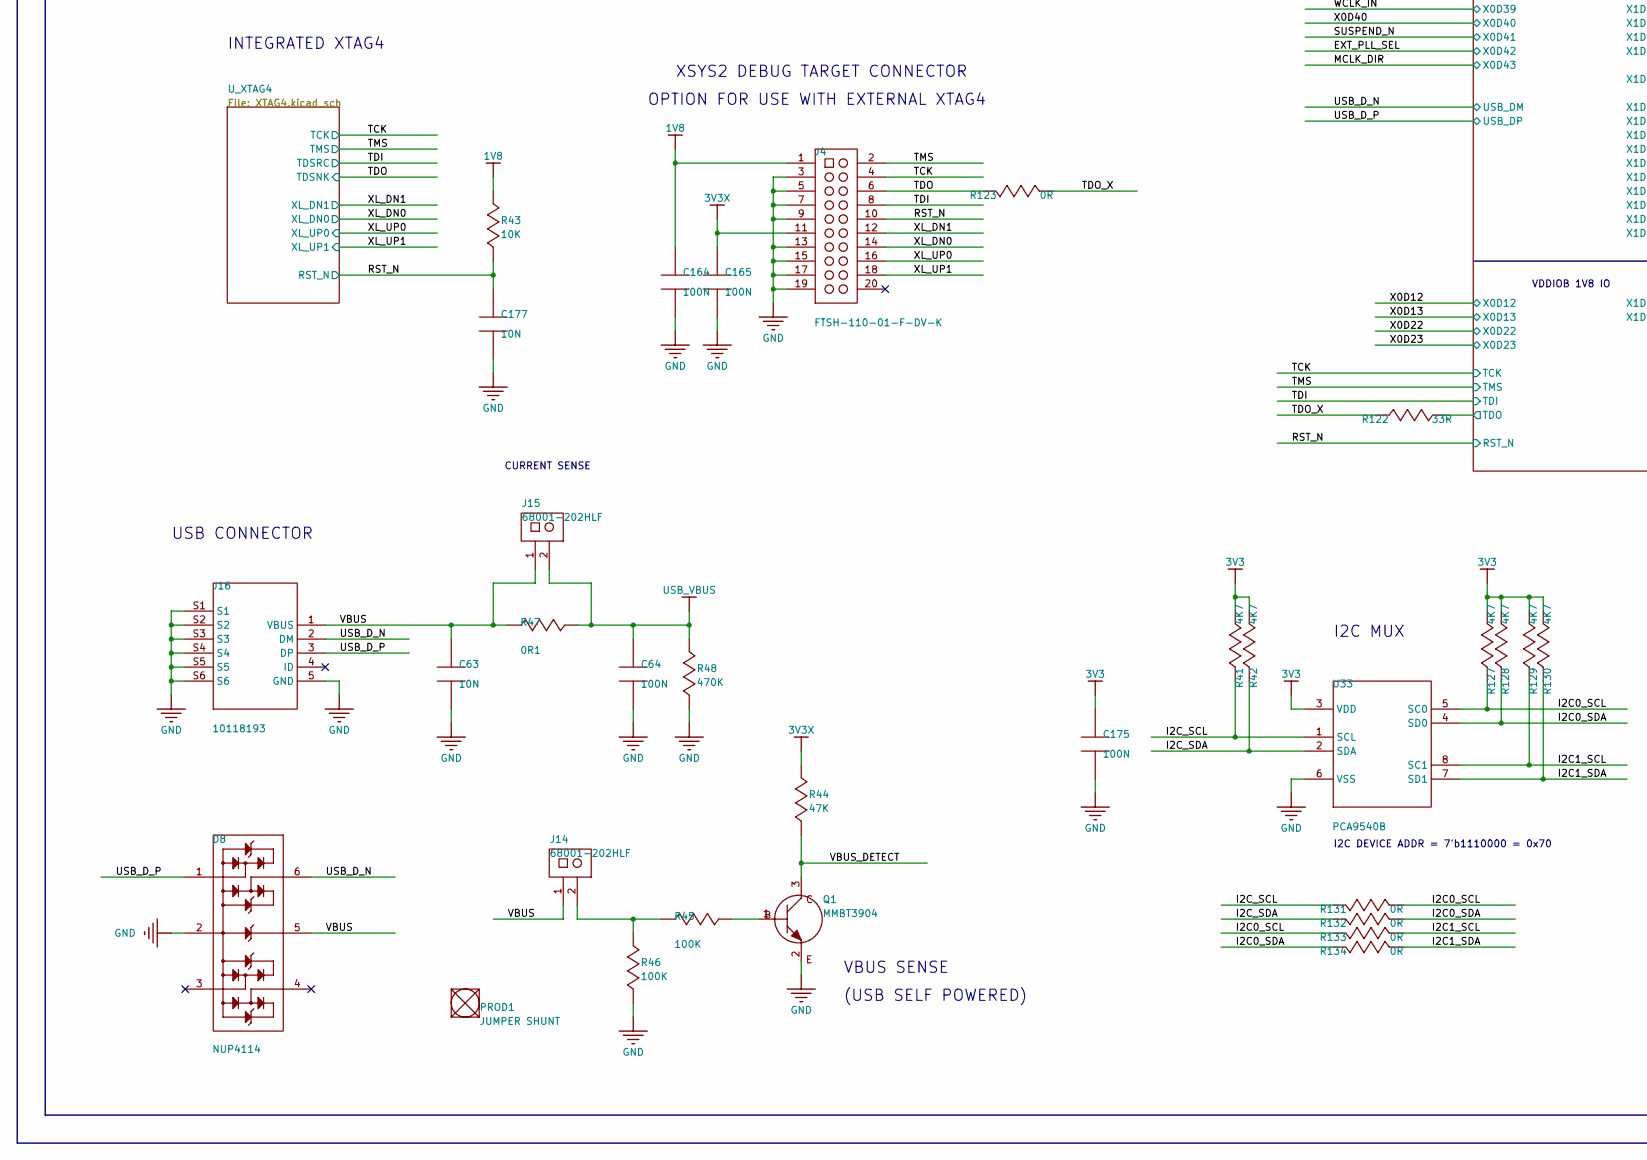
[picture p95: schematic XMS0004.kicad_sch, part in row 2, column 1]

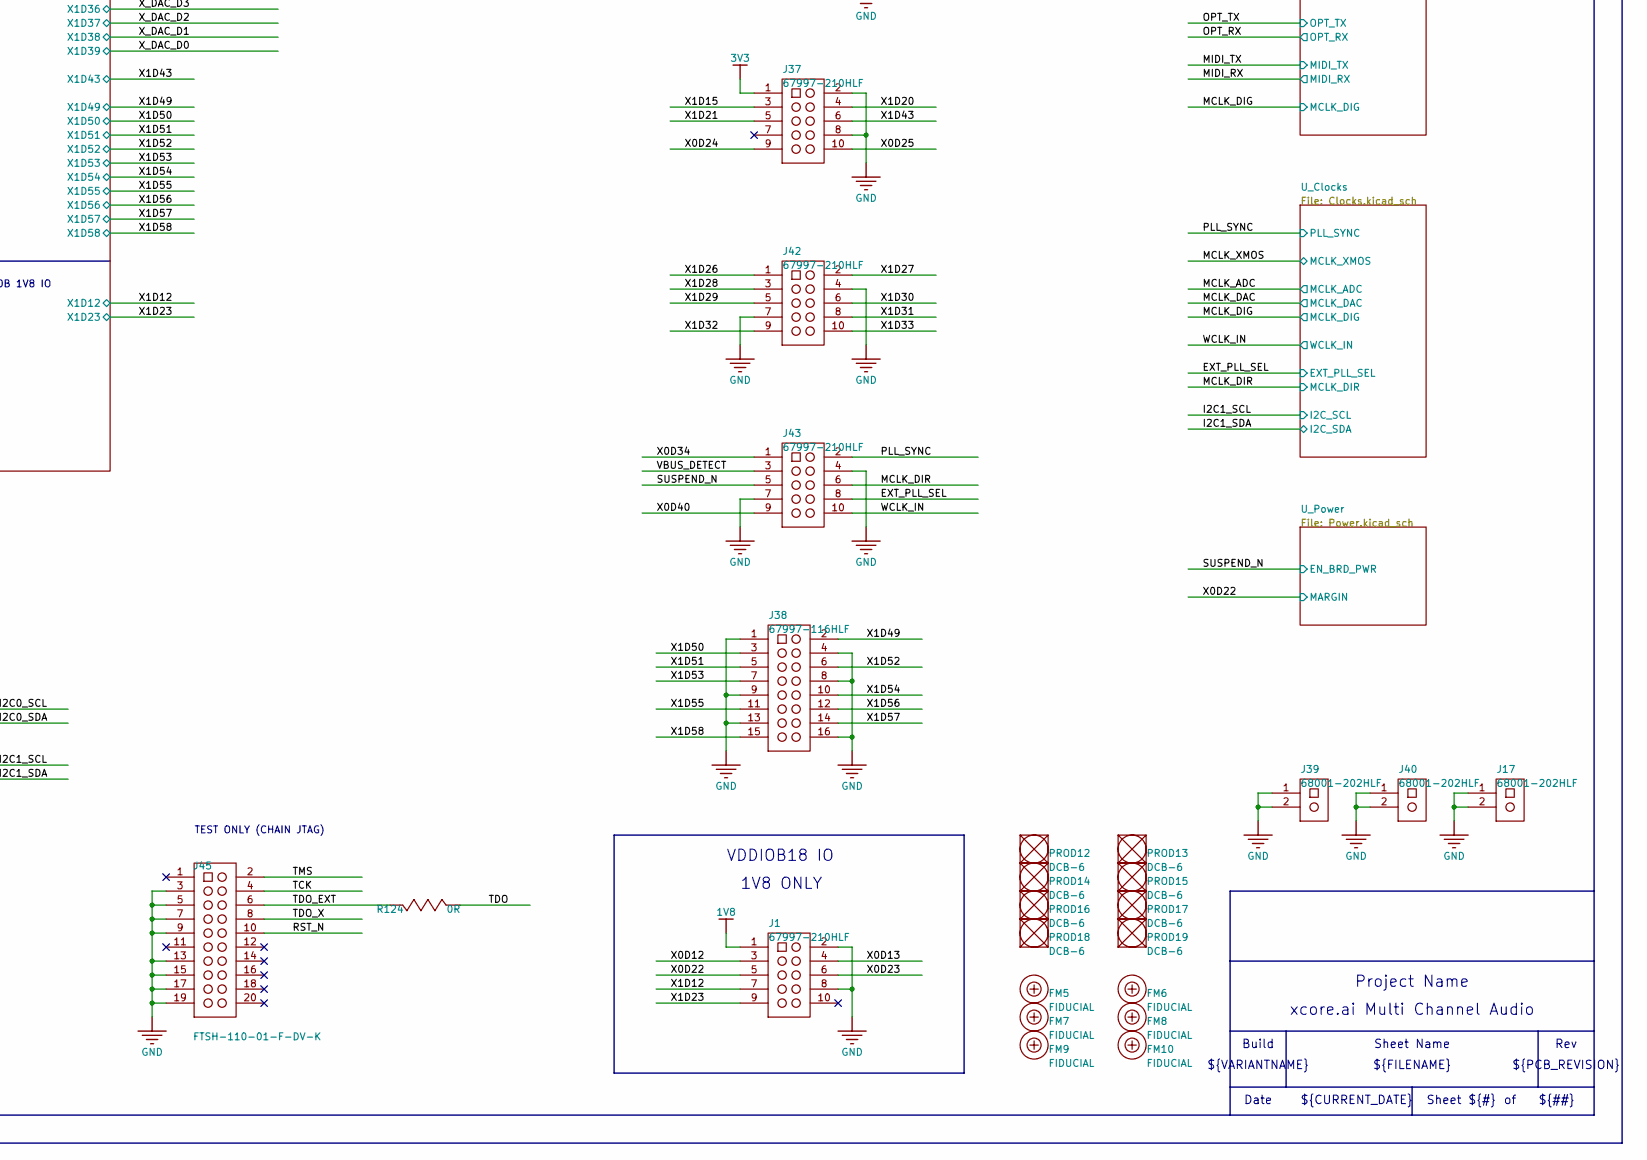
[picture p96: schematic XMS0004.kicad_sch, part in row 2, column 2]

Parts:
C62, C64, C164, C165, C175: 100N; CAPC1005X55N; RATED VOLTAGE 16V; TOLERANCE 10%; PART NUMBER STD-06-0048
C63, C177: 10N; CAPC1005X55N; RATED VOLTAGE 50V; TOLERANCE 10%; PART NUMBER STD-06-0042
D4, D5, D6, D7: APT1608; LEDC1608X85N; PART NUMBER GEN-17-0001
D8: NUP4114; SOT65P210X110-6N; PART NUMBER GEN-16-0048
FM5, FM6, FM7, FM8, FM9, FM10: FIDUCIAL; FIDUCIAL_10_20; PART NUMBER GEN-24-0001
J1, J37, J41, J42, J43, J44: 67997-210HLF; HDR_FCI_67997_X10; PART NUMBER GEN-01-0029
J3, J6, J8, J9, J10, J11, J12, J13: 68001-204HLF; HDR_FCI_68001_204; PART NUMBER GEN-01-0125
J4, J45: FTSH-110-01-F-DV-K; CON_SAMTEC_FTSH_110_01_X_DV_K; PART NUMBER GEN-01-0126
J7: 67997-220HLF; HDR_FCI_67997_220; PART NUMBER GEN-01-0070
J14, J15, J17, J39, J40: 68001-202HLF; HDR_FCI_68001_202; PART NUMBER GEN-01-0011
J16: 10118193; CON_FCI_10118193; PART NUMBER GEN-01-0020
J38: 67997-116HLF; HDR_FCI_67997_116; PART NUMBER GEN-01-0019
PROD1, PROD2, PROD3, PROD4, PROD5, PROD6, PROD7, PROD8, PROD9, PROD10, PROD11: JUMPER SHUNT; PART NUMBER GEN-23-0011
PROD12, PROD13, PROD14, PROD15, PROD16, PROD17, PROD18, PROD19: DCB-6; PART NUMBER GEN-23-0002
Q1: MMBT3904; SOT95P235X115-3N; PART NUMBER GEN-16-0051
R12, R13, R24, R25, R27, R32, R39, R40, R117, R122: 33R; RESC1608X55N; TOLERANCE 1%; MAX VOLTAGE 50V; PART NUMBER STD-02-0026
R23, R37, R38, R43, R119: 10K; RESC1608X55N; TOLERANCE 1%; MAX VOLTAGE 50V; PART NUMBER STD-02-0086
R33, R34, R35, R36: 470R; RESC1608X55N; TOLERANCE 1%; MAX VOLTAGE 50V; PART NUMBER STD-02-0054
R41, R42, R127, R128, R129, R130: 4K7; RESC1608X55N; TOLERANCE 1%; MAX VOLTAGE 50V; PART NUMBER STD-02-0078
R44: 47K; RESC1608X55N; TOLERANCE 1%; MAX VOLTAGE 50V; PART NUMBER STD-02-0102
R45, R46: 100K; RESC1608X55N; TOLERANCE 1%; MAX VOLTAGE 50V; PART NUMBER STD-02-0110
R47: 0R1; RESC2012X60N; TOLERANCE 1%; MAX VOLTAGE 50V; PART NUMBER GEN-02-0029
R48: 470K; RESC1608X55N; TOLERANCE 1%; MAX VOLTAGE 50V; PART NUMBER STD-02-0126
R118, R123, R124, R131, R132, R133, R134: 0R; RESC1608X55N; TOLERANCE NA; MAX VOLTAGE 50V; PART NUMBER STD-02-0001
SW1, SW2, SW3: KSC421J; SW_CK_KSC4_JBEND; PART NUMBER GEN-20-0004
TP27: TESTPOINT; TESTPOINT_SMD_1MM; PART NUMBER GEN-24-0003
TP32: TESTPOINT; TESTPOINT_SMD_0.9MM_L; PART NUMBER GEN-24-0019
U9: W25Q32JVSSIQ; SOIC127P790X220-8N; PART NUMBER GEN-12-0035
U33: PCA9540B; SOP65P490X110-8N; PART NUMBER GEN-09-0030

Connections:
ADC_D0: J6.2, R24.2
ADC_D1: J9.2, R25.2
ADC_D2: J11.2, R27.2
ADC_D3: J13.2, R32.2
ADC_GPIO: J7.12
BCLK: J7.9, R13.2
BUT_0: R23.1, SW1.1A
BUT_1: R37.1, SW2.1A
BUT_2: R119.1, SW3.1A
COAX_RX: J41.6
COAX_TX: J41.5
DAC_D0: J3.2
DAC_D1: J8.2
DAC_D2: J10.2
DAC_D3: J12.2
DAC_MUTE_N: J7.10
EXT_PLL_SEL: J43.8
I2C0_SCL: J7.13, R127.1, R131.1, R133.2, U33.5 (SC0)
I2C0_SDA: J7.15, R128.1, R132.1, R134.2, U33.4 (SD0)
I2C1_SCL: R129.1, R133.1, U33.8 (SC1)
I2C1_SDA: R130.1, R134.1, U33.7 (SD1)
I2C_SCL: R41.1, R131.2, U33.1 (SCL)
I2C_SDA: R42.1, R132.2, U33.2 (SDA)
I2S_DAC_LOOP_D0: R24.1
I2S_DAC_LOOP_D1: R25.1
I2S_DAC_LOOP_D2: R27.1
I2S_DAC_LOOP_D3: R32.1
LED_0: R36.2
LED_1: R35.2
LED_2: R34.2
LED_3: R33.2
LRCK: J7.11, R12.2
MCLK_DAC: J7.1
MCLK_DIG: J41.7
MCLK_DIR: J43.6
MCLK_XMOS: R117.2
MCLK_X_PIN: R117.1, R118.1, TP27.1
MIDI_RX: J41.10
MIDI_TX: J41.9
unnamed: C64.1, J15.2, R47.2, R48.2
unnamed: C164.1, J4.1
unnamed: C165.1, J4.11
unnamed: D4.2 (A), R33.1
unnamed: D5.2 (A), R34.1
unnamed: D6.2 (A), R35.1
unnamed: D7.2 (A), R36.1
unnamed: J1.2, J1.8
unnamed: J4.3, J4.5, J4.7, J4.9, J4.13, J4.15, J4.17, J4.19
unnamed: J7.2, J7.8, J7.14, J7.20
unnamed: J3.1, J3.4, J8.1, J8.4, J10.1, J10.4, J12.1, J12.4
unnamed: J6.1, J6.4, J9.1, J9.4, J11.1, J11.4, J13.1, J13.4
unnamed: J14.2, R45.1, R46.2
unnamed: J16.S1, J16.S2, J16.S3, J16.S4, J16.S5, J16.S6
unnamed: J17.1, J17.2
unnamed: J37.2, J37.8
unnamed: J38.1, J38.9, J38.13
unnamed: J38.4, J38.8, J38.16
unnamed: J39.1, J39.2
unnamed: J40.1, J40.2
unnamed: J41.2, J41.8
unnamed: J44.2, J44.8
unnamed: J45.3, J45.5, J45.7, J45.9, J45.13, J45.15, J45.17, J45.19
unnamed: Q1.1 (B1), R45.2
unnamed: R41.2, R42.2
unnamed: R127.2, R128.2, R129.2, R130.2
unnamed: SW1.2A, SW1.2B
unnamed: SW2.2A, SW2.2B
unnamed: SW3.2A, SW3.2B
OPT_RX: J41.4
OPT_TX: J41.3
PLL_SYNC: J43.2
QSPI_CLK: J44.7, U9.6 (SCK)
QSPI_CS_N: J44.9, R38.1, U9.1 (CS_N)
QSPI_D0: J44.3, U9.5 (SI/IO0)
QSPI_D1: J44.4, U9.2 (SO/IO1)
QSPI_D2: J44.5, U9.3 (WP_N/IO2)
QSPI_D3: J44.6, U9.7 (HOLD_N/IO3)
RST_N: C177.1, J4.10, J45.10, R43.1
SUSPEND_N: J43.5
TCK: J4.4, J45.4
TDI: J4.8
TDO: J4.6, R122.2, R123.2, R124.1
TDO_EXT: J45.6, R124.2
TDO_X: J45.8, R122.1, R123.1
TMS: J4.2, J45.2
USB_D_N: D8.6, J16.2 (DM)
USB_D_P: D8.1, J16.3 (DP)
VBUS: C63.1, D8.5, J14.1, J15.1, J16.1 (VBUS), R47.1
VBUS_DETECT: J43.3, Q1.3 (C1), R44.1
WCLK_IN: J43.10
X0D11: R118.2
X0D12: J1.3
X0D13: J1.4
X0D22: J1.5
X0D23: J1.6
X0D24: J37.9
X0D25: J37.10
X0D34: J43.1
X0D40: J43.9
X1D01: R12.1
X1D09: TP32.1
X1D10: R13.1
X1D12: J1.7
X1D15: J37.3
X1D18: R39.1
X1D19: R40.1
X1D20: J37.4
X1D21: J37.5
X1D23: J1.9
X1D26: J42.1
X1D27: J42.2
X1D28: J42.3
X1D29: J42.5
X1D30: J42.6
X1D31: J42.8
X1D32: J42.9
X1D33: J42.10
X1D43: J37.6
X1D49: J38.2
X1D50: J38.3
X1D51: J38.5
X1D52: J38.6
X1D53: J38.7
X1D54: J38.10
X1D55: J38.11
X1D56: J38.12
X1D57: J38.14
X1D58: J38.15
XL_DN0: J4.14
XL_DN1: J4.12
XL_UP0: J4.16, R39.2
XL_UP1: J4.18, R40.2
X_ADC_D0: J6.3, J7.19
X_ADC_D1: J7.18, J9.3
X_ADC_D2: J7.17, J11.3
X_ADC_D3: J7.16, J13.3
X_DAC_D0: J3.3, J7.3
X_DAC_D1: J7.4, J8.3
X_DAC_D2: J7.5, J10.3
X_DAC_D3: J7.6, J12.3

Notes on the sheet:
${FILENAME}
TEST ONLY (CHAIN JTAG)
${VARIANTNAME}
Sheet Name
VDDIOB18 IO
1V8 ONLY
EXPANSION/TESTPOINTS
DAC I2S/TDM CONFIG
Date
XSYS2 DEBUG TARGET CONNECTOR
(USB SELF POWERED)
USB CONNECTOR
TDM MODE: SET ALL 1-2, TDM SOURCE 3-4
I2C MUX
I2C DEVICE ADDR = 7'b1110000 = 0x70
I2S DATA LOOPBACK FOR SOFTWARE TEST
QSPI FLASH
INTEGRATED XTAG4
OPTION FOR USE WITH EXTERNAL XTAG4
${TITLE}
${#}
I2S MODE: SET ALL 2-3
Project Name
VBUS SENSE
VDDIOB 1V8 IO
Sheet
TDM MODE: SET DATA 0 AND 2 1-2, TDM DESTINATION 3-4
Rev
ADC I2S/TDM CONFIG
${CURRENT_DATE}
${##}
${PCB_REVISION}
CURRENT SENSE
Build
