Violabitch5/Nathophone_elec/USBtoI2S_board/XK-AUDIO-316-MC-AB-Design-Files/XMS0004/XTAG4.kicad_sch

## KiCad design USBtoI2S_board/XK-AUDIO-316-MC-AB-Design-Files/XMS0004/XTAG4.kicad_sch (2026-05-14)

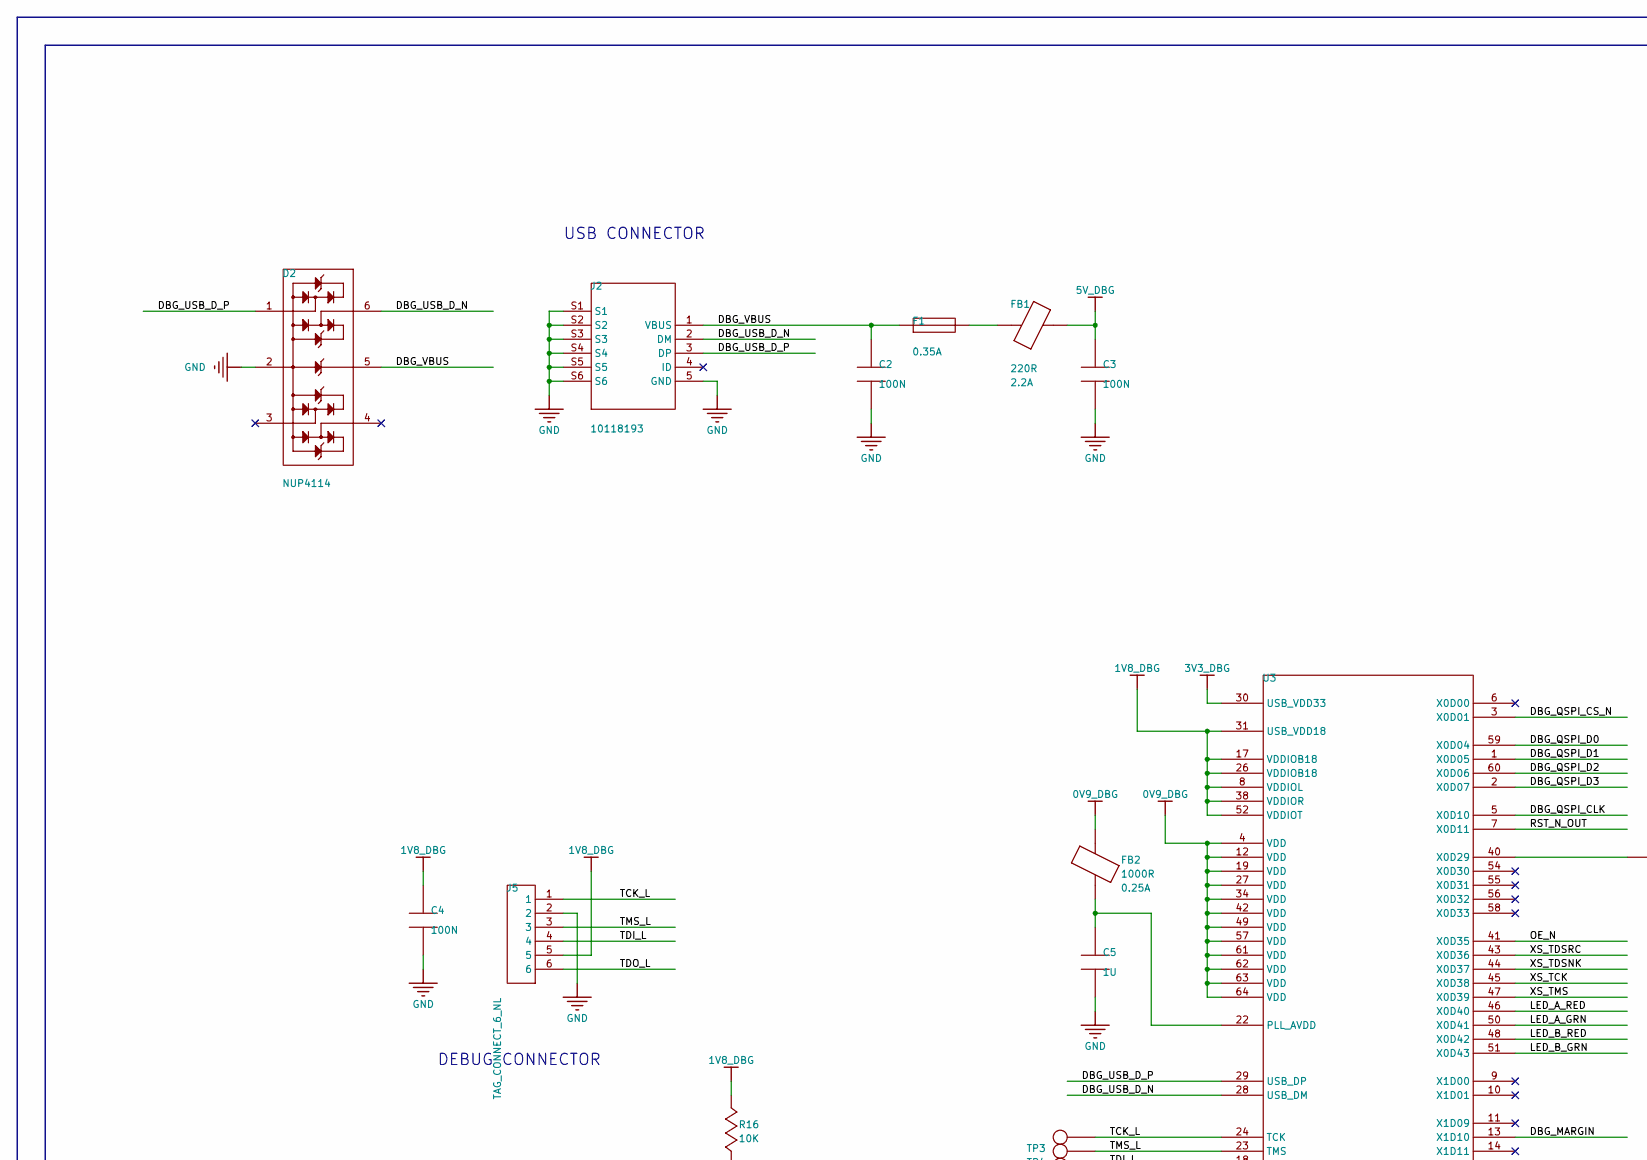
[picture p97: schematic XTAG4.kicad_sch, part in row 1, column 1]

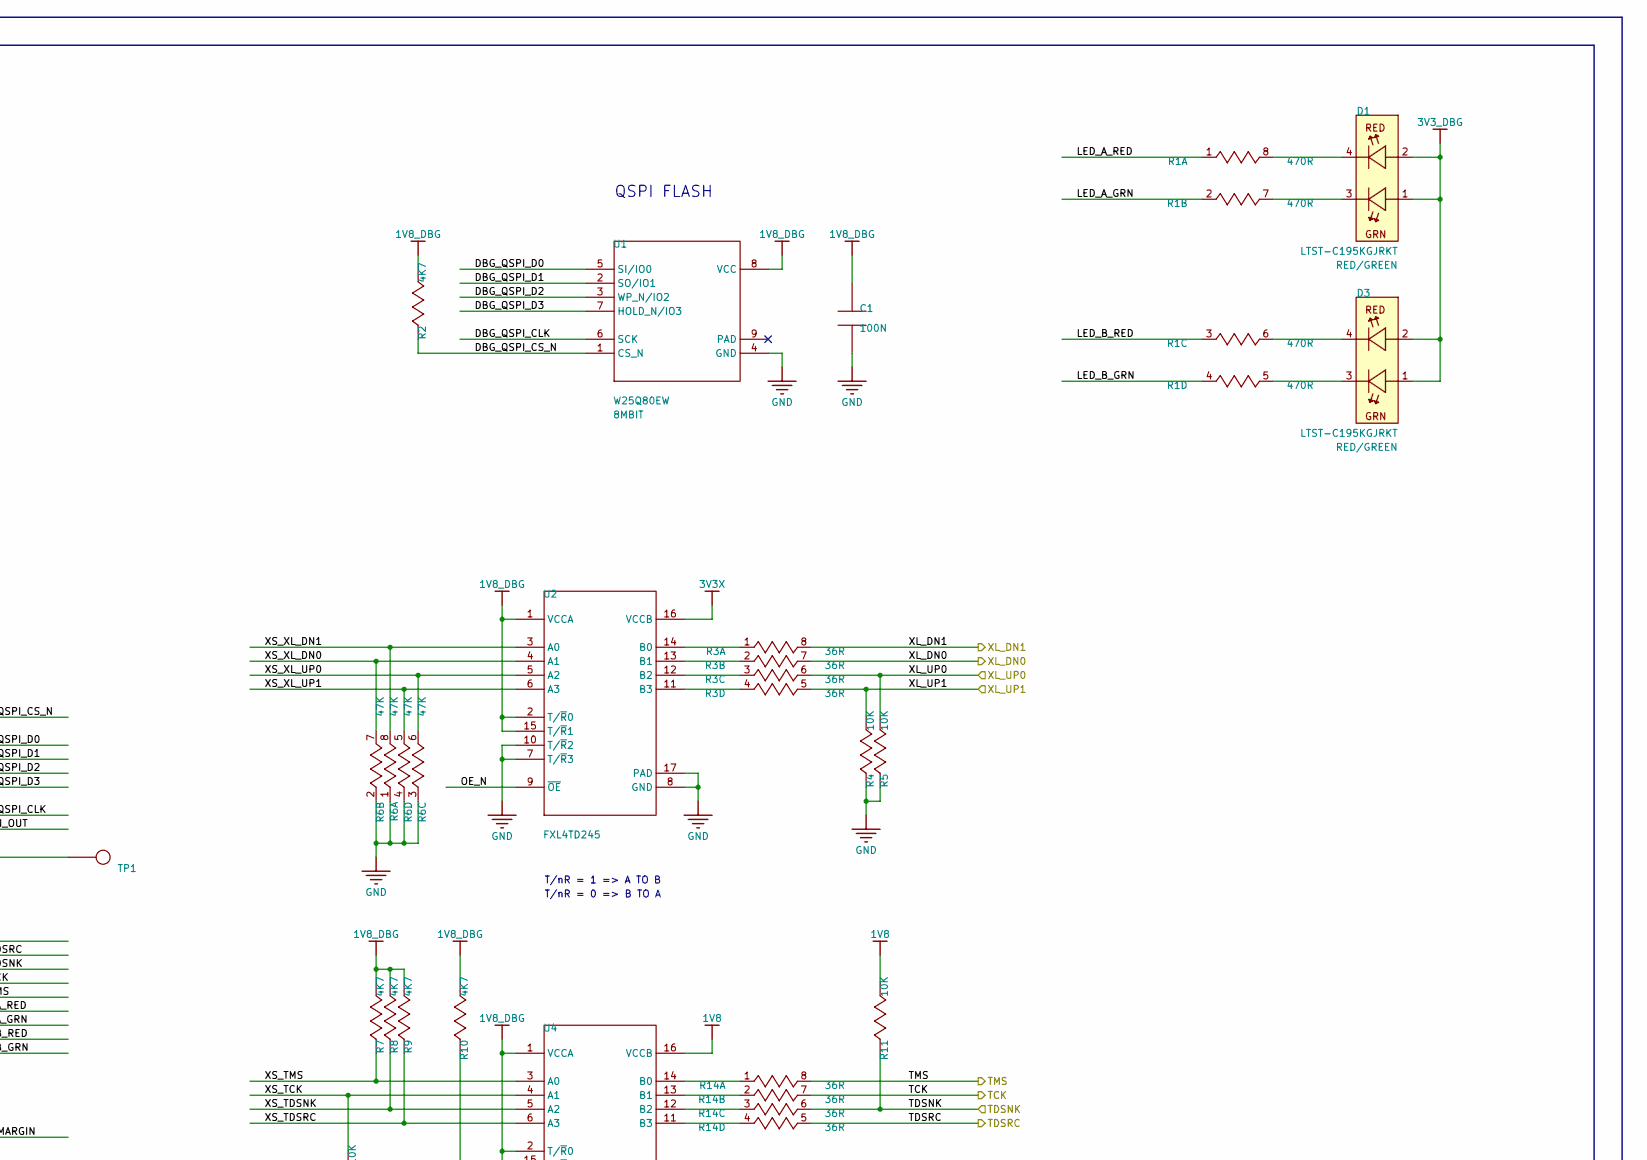
[picture p98: schematic XTAG4.kicad_sch, part in row 1, column 2]

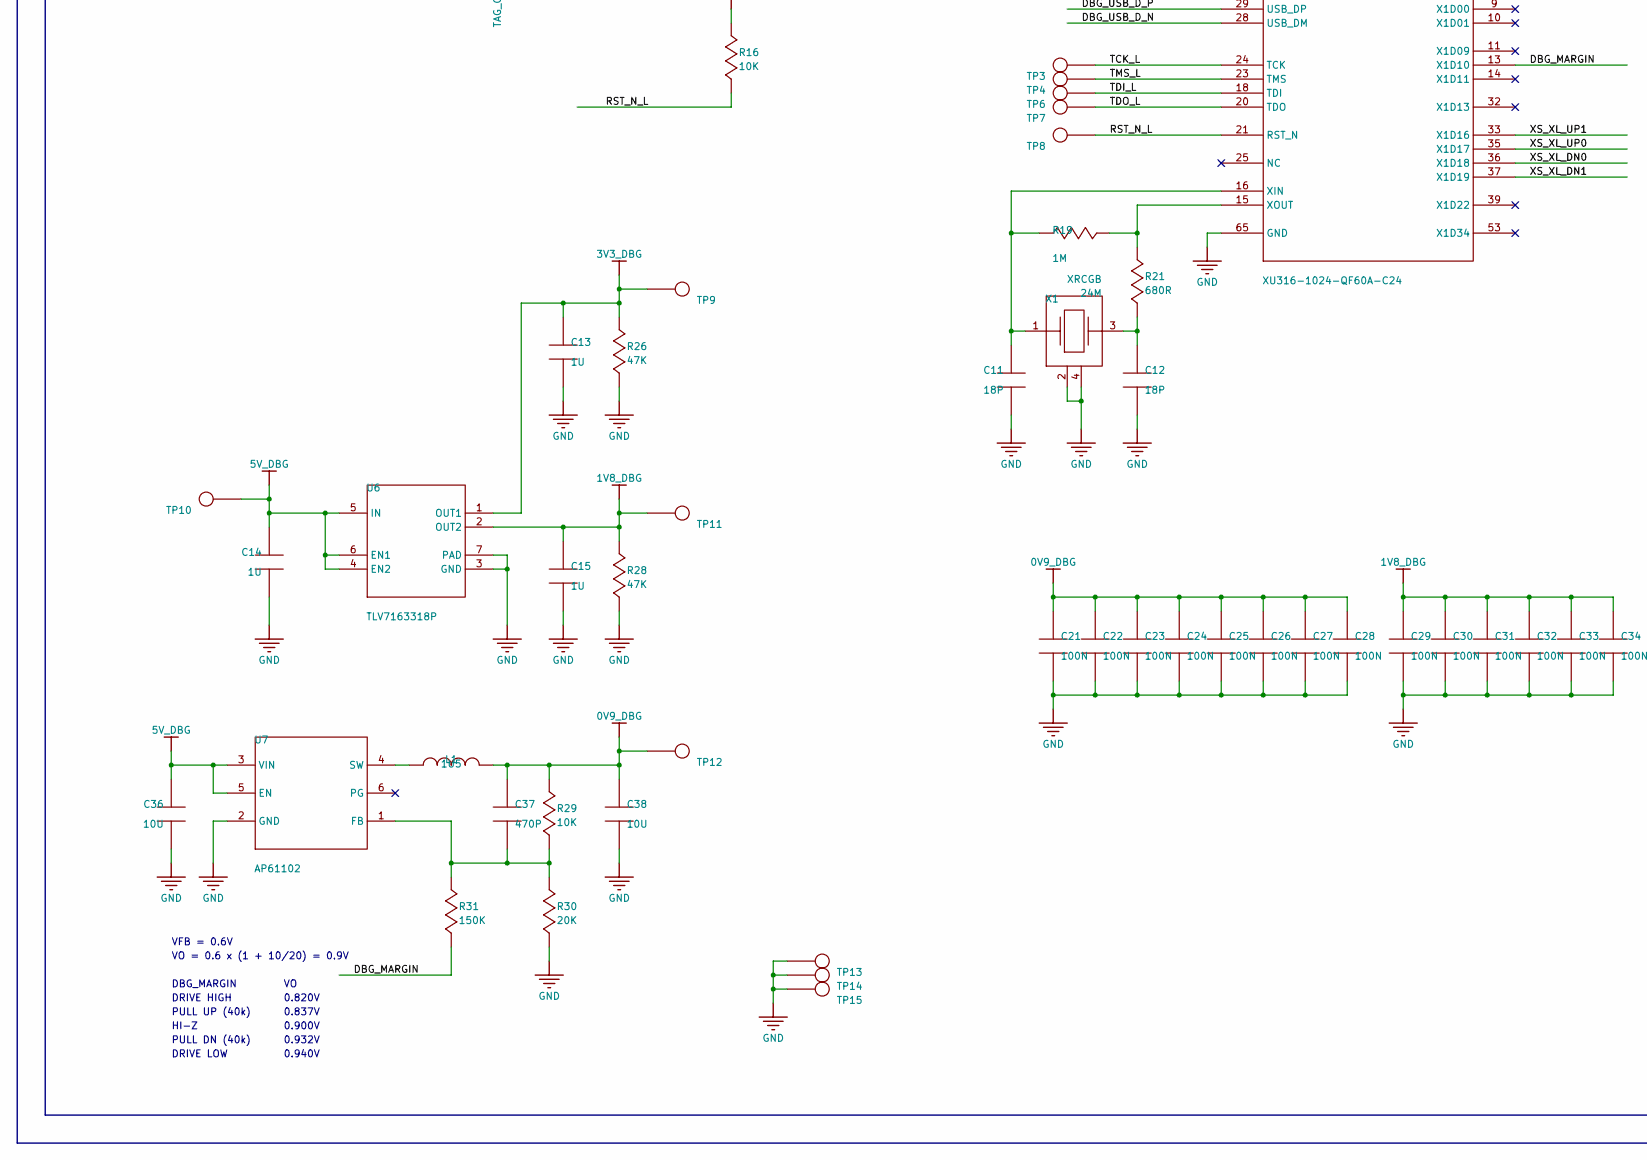
[picture p99: schematic XTAG4.kicad_sch, part in row 2, column 1]

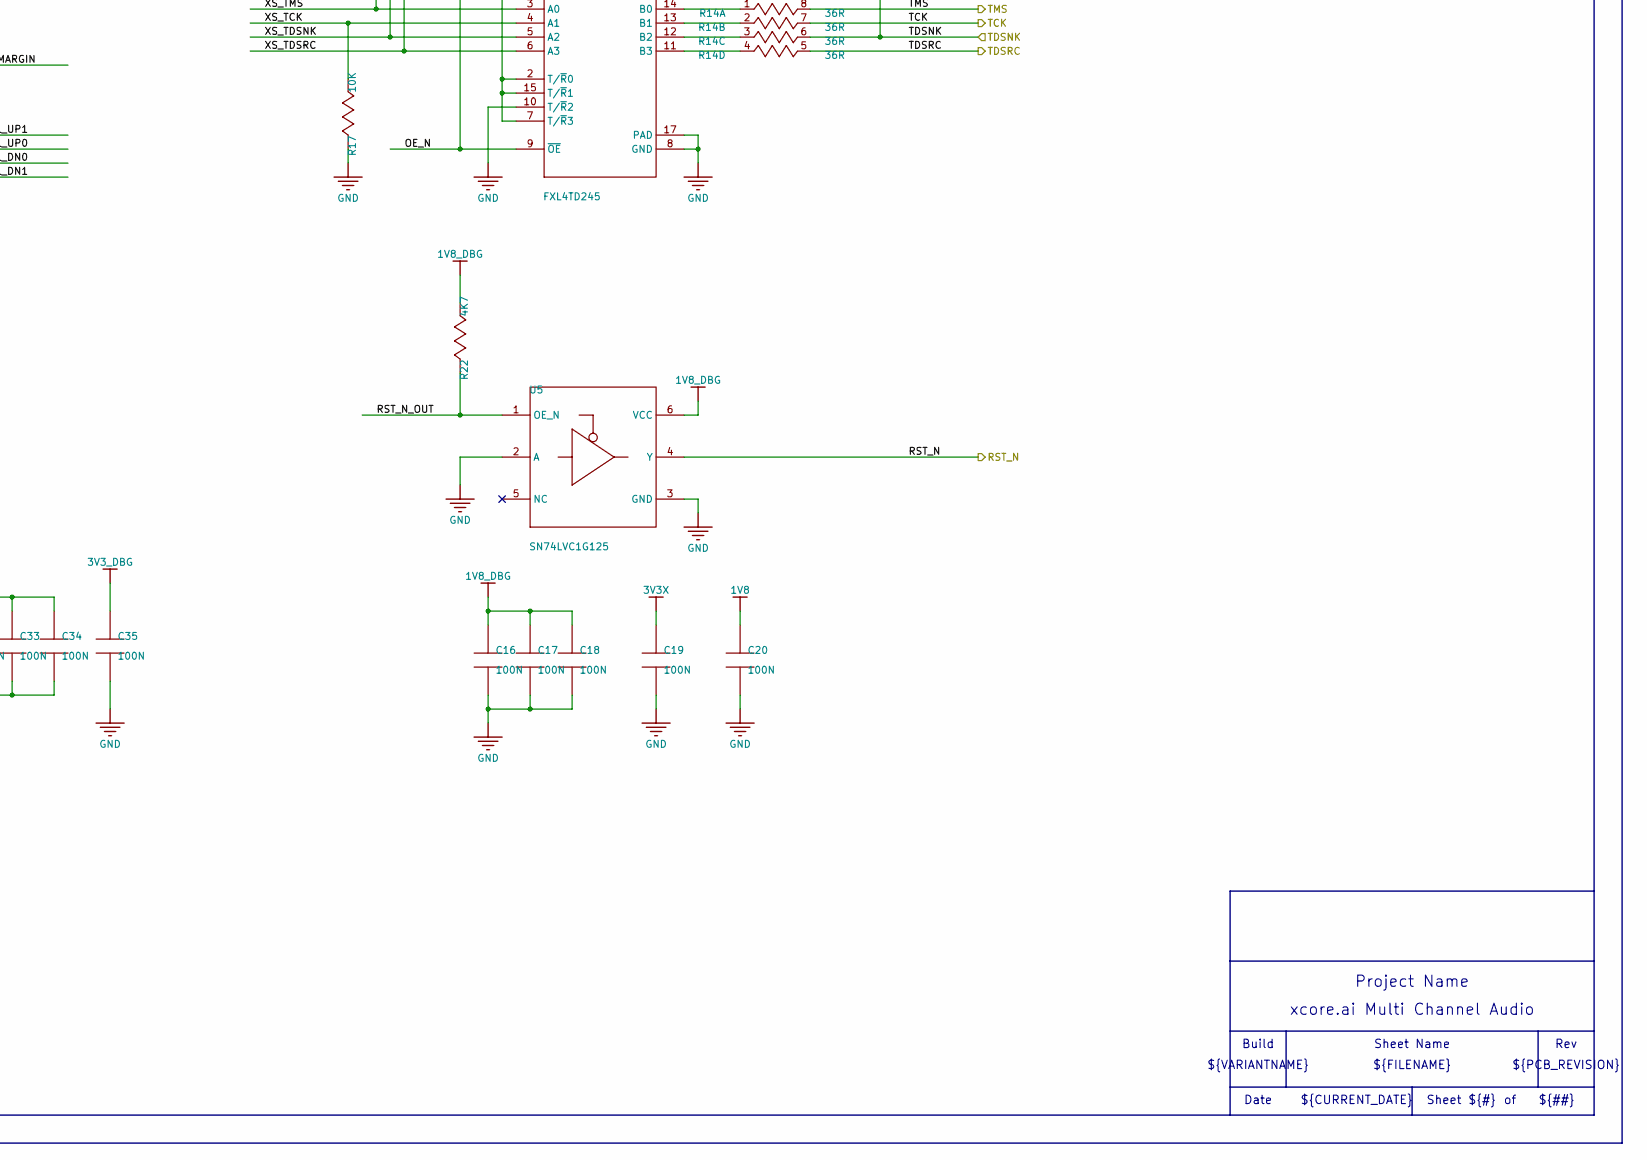
[picture p100: schematic XTAG4.kicad_sch, part in row 2, column 2]

Parts:
C1, C2, C3, C4, C16, C17, C18, C19, C20, C21, C22, C23, C24, C25, C26, C27, C28, C29, C30, C31, C32, C33, C34, C35: 100N; CAPC1005X55N; RATED VOLTAGE 16V; TOLERANCE 10%; PART NUMBER STD-06-0048
C5, C13, C14, C15: 1U; CAPC1005X55N; RATED VOLTAGE 16V; TOLERANCE 20%; PART NUMBER STD-06-0140
C11, C12: 18P; CAPC1005X55N; RATED VOLTAGE 50V; TOLERANCE 5%; PART NUMBER STD-06-0016
C36, C38: 10U; CAPC1608X90N; RATED VOLTAGE 10V; TOLERANCE 20%; PART NUMBER GEN-03-0043
C37: 470P; CAPC1005X55N; RATED VOLTAGE 50V; TOLERANCE 10%; PART NUMBER STD-06-0034
D1, D3: LTST-C195KGJRKT; LED_LITEON_LTST_C195KGJRKT; PART NUMBER GEN-17-0007
D2: NUP4114; SOT65P210X110-6N; PART NUMBER GEN-16-0048
F1: 0.35A; FUSC215X135X75L40N; MAX VOLTAGE 6V; PART NUMBER GEN-21-0009
FB1: 220R; INDC1608X95N; PART NUMBER GEN-04-0018
FB2: 1000R; INDC1005X55N; PART NUMBER GEN-04-0019
J2: 10118193; CON_FCI_10118193; PART NUMBER GEN-01-0020
J5: TAG_CONNECT_6_NL; CON_TAG_CONNECT_6_NOLEG; PART NUMBER GEN-24-0021
L1: 1U5; INDC2520X120N; TOLERANCE 20%; PART NUMBER GEN-05-0025
R1: 470R; RESCAXS50P200X100X55-8N; TOLERANCE 5%; MAX VOLTAGE 25V; PART NUMBER STD-09-0014
R2, R7, R8, R9, R10, R22: 4K7; RESC1005X40N; TOLERANCE 1%; MAX VOLTAGE 50V; PART NUMBER STD-01-0072
R3, R14: 36R; RESCAXS50P200X100X55-8N; TOLERANCE 5%; MAX VOLTAGE 50V; PART NUMBER GEN-02-0026
R4, R5, R11, R16, R17, R29: 10K; RESC1005X40N; TOLERANCE 1%; MAX VOLTAGE 50V; PART NUMBER STD-01-0080
R6: 47K; RESCAXS50P200X100X55-8N; TOLERANCE 5%; MAX VOLTAGE 25V; PART NUMBER STD-09-0026
R19: 1M; RESC1005X40N; TOLERANCE 5%; MAX VOLTAGE 50V; PART NUMBER STD-01-0128
R21: 680R; RESC1005X40N; TOLERANCE 1%; MAX VOLTAGE 50V; PART NUMBER STD-01-0052
R26, R28: 47K; RESC1005X40N; TOLERANCE 1%; MAX VOLTAGE 50V; PART NUMBER STD-01-0096
R30: 20K; RESC1005X40N; TOLERANCE 1%; MAX VOLTAGE 50V; PART NUMBER STD-01-0087
R31: 150K; RESC1005X40N; TOLERANCE 1%; MAX VOLTAGE 50V; PART NUMBER STD-01-0108
TP1: TESTPOINT; TESTPOINT_SMD_1MM; PART NUMBER GEN-24-0003
TP3, TP4, TP6, TP7, TP8, TP9, TP10, TP11, TP12, TP13, TP14, TP15: TESTPOINT; TESTPOINT_SMD_1.2MM; PART NUMBER GEN-24-0014
U1: W25Q80EW; SON9P50_200X300X60L45X25T160X20N; PART NUMBER GEN-12-0023
U2, U4: FXL4TD245; IC_NXP_DHVQFN16; PART NUMBER GEN-11-0017
U3: XU316-1024-QF60A-C24; IC_XMOS_PX_QFN60A_NEWPADDLE; PART NUMBER GEN-08-0033
U5: SN74LVC1G125; TI_R_PUSON_N6; PART NUMBER GEN-11-0049
U6: TLV7163318P; TI_S_PX2SON_N6; PART NUMBER GEN-14-0057
U7: AP61102; ICSOFL6P50_160X160X60L30X21N; PART NUMBER GEN-14-0064
X1: XRCGB; OSCCC200X160X70N; PART NUMBER GEN-15-0038

Connections:
DBG_MARGIN: R31.1, U3.13 (X1D10)
DBG_QSPI_CLK: U1.6 (SCK), U3.5 (X0D10)
DBG_QSPI_CS_N: R2.1, U1.1 (CS_N), U3.3 (X0D01)
DBG_QSPI_D0: U1.5 (SI/IO0), U3.59 (X0D04)
DBG_QSPI_D1: U1.2 (SO/IO1), U3.1 (X0D05)
DBG_QSPI_D2: U1.3 (WP_N/IO2), U3.60 (X0D06)
DBG_QSPI_D3: U1.7 (HOLD_N/IO3), U3.2 (X0D07)
DBG_USB_D_N: D2.6, J2.2 (DM), U3.28 (USB_DM)
DBG_USB_D_P: D2.1, J2.3 (DP), U3.29 (USB_DP)
DBG_VBUS: C2.1, D2.5, F1.1 (T1), J2.1 (VBUS)
LED_A_GRN: R1.2, U3.50 (X0D41)
LED_A_RED: R1.1, U3.46 (X0D40)
LED_B_GRN: R1.4, U3.51 (X0D43)
LED_B_RED: R1.3, U3.48 (X0D42)
unnamed: C3.1, FB1.2
unnamed: C5.1, FB2.1, U3.22 (PLL_AVDD)
unnamed: C11.1, R19.1, U3.16 (XIN), X1.1 (A)
unnamed: C12.1, R21.1, X1.3 (B)
unnamed: C13.1, R26.2, TP9.1, U6.1 (OUT1)
unnamed: C14.1, TP10.1, U6.4 (EN2), U6.5 (IN), U6.6 (EN1)
unnamed: C15.1, R28.2, TP11.1, U6.2 (OUT2)
unnamed: C16.1, C17.1, C18.1
unnamed: C16.2, C17.2, C18.2
unnamed: C21.1, C22.1, C23.1, C24.1, C25.1, C26.1, C27.1, C28.1
unnamed: C21.2, C22.2, C23.2, C24.2, C25.2, C26.2, C27.2, C28.2
unnamed: C29.1, C30.1, C31.1, C32.1, C33.1, C34.1
unnamed: C29.2, C30.2, C31.2, C32.2, C33.2, C34.2
unnamed: C36.1, U7.3 (VIN), U7.5 (EN)
unnamed: C37.1, C38.1, L1.2, R29.2, TP12.1
unnamed: C37.2, R29.1, R30.2, R31.2, U7.1 (FB)
unnamed: D1.1 (GRN_A), D1.2 (RED_A), D3.1 (GRN_A), D3.2 (RED_A)
unnamed: D1.3 (GRN_K), R1.7
unnamed: D1.4 (RED_K), R1.8
unnamed: D3.3 (GRN_K), R1.5
unnamed: D3.4 (RED_K), R1.6
unnamed: F1.2 (T2), FB1.1
unnamed: J2.S1, J2.S2, J2.S3, J2.S4, J2.S5, J2.S6
unnamed: L1.1, U7.4 (SW)
unnamed: R3.1, U2.14 (B0)
unnamed: R3.2, U2.13 (B1)
unnamed: R3.3, U2.12 (B2)
unnamed: R3.4, U2.11 (B3)
unnamed: R4.1, R5.1
unnamed: R6.1, R6.2, R6.3, R6.4
unnamed: R7.2, R8.2, R9.2
unnamed: R14.1, U4.14 (B0)
unnamed: R14.2, U4.13 (B1)
unnamed: R14.3, U4.12 (B2)
unnamed: R14.4, U4.11 (B3)
unnamed: R19.2, R21.2, U3.15 (XOUT)
unnamed: TP1.1, U3.40 (X0D29)
unnamed: TP13.1, TP14.1, TP15.1
unnamed: U2.1 (VCCA), U2.2 (T/~R0), U2.15 (T/~R1)
unnamed: U2.7 (T/~R3), U2.10 (T/~R2)
unnamed: U2.8 (GND), U2.17 (PAD)
unnamed: U3.4 (VDD), U3.12 (VDD), U3.19 (VDD), U3.27 (VDD), U3.34 (VDD), U3.42 (VDD), U3.49 (VDD), U3.57 (VDD), U3.61 (VDD), U3.62 (VDD), U3.63 (VDD), U3.64 (VDD)
unnamed: U3.8 (VDDIOL), U3.17 (VDDIOB18), U3.26 (VDDIOB18), U3.31 (USB_VDD18), U3.38 (VDDIOR), U3.52 (VDDIOT)
unnamed: U4.1 (VCCA), U4.2 (T/~R0), U4.7 (T/~R3), U4.15 (T/~R1)
unnamed: U4.8 (GND), U4.17 (PAD)
unnamed: U6.3 (GND), U6.7 (PAD)
unnamed: X1.2 (CASE_2), X1.4 (CASE_4)
OE_N: R10.1, U2.9 (~OE), U3.41 (X0D35), U4.9 (~OE)
RST_N: U5.4 (Y)
RST_N_L: R16.1, TP8.1, U3.21 (RST_N)
RST_N_OUT: R22.1, U3.7 (X0D11), U5.1 (OE_N)
TCK: R14.7
TCK_L: J5.1, TP3.1, U3.24 (TCK)
TDI_L: J5.4, TP6.1, U3.18 (TDI)
TDO_L: J5.6, TP7.1, U3.20 (TDO)
TDSNK: R11.1, R14.6
TDSRC: R14.5
TMS: R14.8
TMS_L: J5.3, TP4.1, U3.23 (TMS)
XL_DN0: R3.7
XL_DN1: R3.8
XL_UP0: R3.6, R5.2
XL_UP1: R3.5, R4.2
XS_TCK: R17.2, U3.45 (X0D38), U4.4 (A1)
XS_TDSNK: R8.1, U3.44 (X0D37), U4.5 (A2)
XS_TDSRC: R9.1, U3.43 (X0D36), U4.6 (A3)
XS_TMS: R7.1, U3.47 (X0D39), U4.3 (A0)
XS_XL_DN0: R6.7, U2.4 (A1), U3.36 (X1D18)
XS_XL_DN1: R6.8, U2.3 (A0), U3.37 (X1D19)
XS_XL_UP0: R6.6, U2.5 (A2), U3.35 (X1D17)
XS_XL_UP1: R6.5, U2.6 (A3), U3.33 (X1D16)

Notes on the sheet:
${##}
USB CONNECTOR
T/nR = 0 => B TO A
${TITLE}
DBG_MARGIN
Date
0.820V
DRIVE HIGH
0.940V
${VARIANTNAME}
DEBUG CONNECTOR
${#}
VO = 0.6 x (1 + 10/20) = 0.9V
PULL UP (40k)
${PCB_REVISION}
VFB = 0.6V
T/nR = 1 => A TO B
Sheet
0.837V
QSPI FLASH
PULL DN (40k)
Build
0.900V
Sheet Name
HI-Z
${FILENAME}
Rev
Project Name
0.932V
DRIVE LOW
${CURRENT_DATE}
