Violabitch5/Nathophone_elec/(commit log)

2025-07-29 Initial Commit, First part evaluations added
    [xmos_avb_brd_V4.brd, xmos_avb_brd_V4.sch]
2025-10-12 ADDED Symbols,footprints, simulations ,datasheet, sample schematic
    [1862042.stp, 525593072.stp, LoadVoltage_CapSweep_0H.csv, LoadVoltage_CapSweep_100uH.csv, LoadVoltage_CapSweep_150uH.csv, LoadVoltage_CapSweep_50uH.csv, Load_Transient_nofilter.csv, Load_simulation.csv]
2025-10-16 BEGUN Layout
    [DS04-254-2-01BK-SMT.STEP, DriversA.kicad_sch, DriversB.kicad_sch, DriversC.kicad_sch, Nathophone_PCB_Data.kicad_sch, Nathophone_driver_board.csv, Nathophone_driver_board.kicad_pcb, Nathophone_driver_board.kicad_sch]
2025-10-17 ADDED Grounding Structure
    [DriversA.kicad_sch, DriversB.kicad_sch, DriversC.kicad_sch, Nathophone_driver_board.kicad_pcb, Nathophone_pcb_Power.kicad_sch]
2025-10-17 DONE Routing first two drivers
    [DriversA.kicad_sch, DriversB.kicad_sch, DriversC.kicad_sch, Nathophone_driver_board.kicad_pcb]
2025-10-17 DONE Digital Routing
    [DriversA.kicad_sch, DriversB.kicad_sch, DriversC.kicad_sch, Nathophone_driver_board.kicad_pcb]
2025-10-17 COMPLETED Routing, DRC checked
    [Nathophone_driver_board.kicad_pcb]
2025-10-18 CHANGED Output and Power Track widths to 1mm
    [Nathophone_driver_board.kicad_pcb]
2025-10-18 FINISHED Version 1, Checked heights
    [DriversA.kicad_sch, DriversB.kicad_sch, DriversC.kicad_sch, Nathophone_PCB_Data.kicad_sch, Nathophone_driver_board.kicad_pcb, Nathophone_driver_board.kicad_sch, Nathophone_pcb_Power.kicad_sch]
2025-10-18 CHANGED small things, removed tiny 0201 cap
    [DriversA.kicad_sch, DriversB.kicad_sch, DriversC.kicad_sch, Nathophone_PCB_Data.kicad_sch, Nathophone_driver_board.kicad_pcb, Nathophone_driver_board.kicad_sch, Nathophone_pcb_Power.kicad_sch]
2025-10-19 CHANGED little tweaks in the Ground path, removed unnecessary Diode
    [Nathophone_driver_board.kicad_pcb]
2025-10-24 SIMULATED Transmission line, LAST checks, ORDERED pcb
    [DriversA.kicad_sch, DriversB.kicad_sch, DriversC.kicad_sch, Nathophone_PCB_Data.kicad_sch, Nathophone_pcb_Power.kicad_sch]
2025-11-09 ADDED Efficiency Report
    [Nathophone_driver_board.kicad_pcb]
2025-12-14 CORRECTED TVS Diode polarisation
    [Nathophone_driver_board.csv, Nathophone_driver_board.kicad_pcb, Nathophone_pcb_Power.kicad_sch]
2026-05-07 ADDED JOYNED Design files, BEGUN USBtoI2S Design
    [ADC.SchDoc, CON20_2X10_DUK_FTSH_SAI.step, Clocks.SchDoc, DAC.SchDoc, DigitalIO.SchDoc, GRMJN65C1H104JE01D.step, Power.SchDoc, Top Level.SchDoc]
2026-05-14 ADDED XMOS eval board design files, BEGUN layout of usbtoi2s board
    [525593072.stp, ADC.kicad_sch, Clocks.kicad_sch, Connectors_Power_Misc.kicad_sch, DAC.kicad_sch, DigitalIO.kicad_sch, IND_EPCOS_B82432T_EPC.step, PEC09-2320F-S0015.stp]
2026-05-14 PLACED all footprints and GND zone
    [Connectors_Power_Misc.kicad_sch, Power.kicad_sch, XZxxxx55W-8.step, nathophone_USBtoI2S.kicad_pcb, xmos.kicad_sch]
2026-10-13 ADDED USBtoI2S board design files
