Violabitch5/Nathophone_elec/(notices)

Notices in the files:
parts and their libraries:
xmos_avb_brd_V4: ©2009 ROFA.cz
nout redefined for use with XMOS' xtag Footprint for TC2050 NL PADDescription 1XL_DN1 2XL_DN0 3XL_UP0 4XL_UP1 5GND 6XSYS_RESET_N 7TMS 8TCK 9TDO 10TDI ©2009 ROFA.cz Modified 3/2020 by Fabian Braun
